ka1e27/dreams/Boat_PCB/report.txt

Info: Processing symbol 'A1:Module:RaspberryPi_Pico_Common_Unspecified'.
Info: Processing symbol 'J2:'.
Info: Processing symbol 'F1:'.
Info: Processing symbol 'J1:'.
Updated A1 symbol association from  to /41a332c8-d671-4dce-a781-75eb2ff0428e.
Updated A1 fields.
Updated A1 sheetname to '/'.
Updated A1 sheetfile to 'Boat_PCB.kicad_sch'.
Updated A1 footprint filters to 'RaspberryPi?Pico?Common* RaspberryPi?Pico?SMD*'.
Add net unconnected-(A1-GPIO22-Pad29).
Connected A1 pin 29 to unconnected-(A1-GPIO22-Pad29).
Add net unconnected-(A1-GPIO3-Pad5).
Connected A1 pin 5 to unconnected-(A1-GPIO3-Pad5).
Add net unconnected-(A1-GPIO19-Pad25).
Connected A1 pin 25 to unconnected-(A1-GPIO19-Pad25).
Add net unconnected-(A1-VBUS-Pad40).
Connected A1 pin 40 to unconnected-(A1-VBUS-Pad40).
Connected A1 pin 5 to unconnected-(A1-GPIO3-Pad5).
Add net unconnected-(A1-RUN-Pad30).
Connected A1 pin 30 to unconnected-(A1-RUN-Pad30).
Add net Net-(J2-Pin_11).
Connected A1 pin 8 to Net-(J2-Pin_11).
Connected A1 pin 3 to Net-(J2-Pin_11).
Connected A1 pin 13 to Net-(J2-Pin_11).
Connected A1 pin 18 to Net-(J2-Pin_11).
Add net unconnected-(A1-GPIO7-Pad10).
Connected A1 pin 10 to unconnected-(A1-GPIO7-Pad10).
Add net unconnected-(A1-GPIO27_ADC1-Pad32).
Connected A1 pin 32 to unconnected-(A1-GPIO27_ADC1-Pad32).
Add net unconnected-(A1-GPIO15-Pad20).
Connected A1 pin 20 to unconnected-(A1-GPIO15-Pad20).
Add net unconnected-(A1-GPIO5-Pad7).
Connected A1 pin 7 to unconnected-(A1-GPIO5-Pad7).
Add net unconnected-(A1-GPIO28_ADC2-Pad34).
Connected A1 pin 34 to unconnected-(A1-GPIO28_ADC2-Pad34).
Add net unconnected-(A1-GPIO13-Pad17).
Connected A1 pin 17 to unconnected-(A1-GPIO13-Pad17).
Add net unconnected-(A1-GPIO9-Pad12).
Connected A1 pin 12 to unconnected-(A1-GPIO9-Pad12).
Connected A1 pin 23 to Net-(J2-Pin_11).
Connected A1 pin 13 to Net-(J2-Pin_11).
Connected A1 pin 18 to Net-(J2-Pin_11).
Connected A1 pin 17 to unconnected-(A1-GPIO13-Pad17).
Add net unconnected-(A1-GPIO6-Pad9).
Connected A1 pin 9 to unconnected-(A1-GPIO6-Pad9).
Add net unconnected-(A1-3V3_EN-Pad37).
Connected A1 pin 37 to unconnected-(A1-3V3_EN-Pad37).
Connected A1 pin 9 to unconnected-(A1-GPIO6-Pad9).
Connected A1 pin 38 to Net-(J2-Pin_11).
Connected A1 pin 10 to unconnected-(A1-GPIO7-Pad10).
Add net unconnected-(A1-GPIO14-Pad19).
Connected A1 pin 19 to unconnected-(A1-GPIO14-Pad19).
Add net unconnected-(A1-GPIO2-Pad4).
Connected A1 pin 4 to unconnected-(A1-GPIO2-Pad4).
Add net unconnected-(A1-GPIO17-Pad22).
Connected A1 pin 22 to unconnected-(A1-GPIO17-Pad22).
Add net unconnected-(A1-3V3-Pad36).
Connected A1 pin 36 to unconnected-(A1-3V3-Pad36).
Add net unconnected-(A1-GPIO4-Pad6).
Connected A1 pin 6 to unconnected-(A1-GPIO4-Pad6).
Connected A1 pin 25 to unconnected-(A1-GPIO19-Pad25).
Add net unconnected-(A1-GPIO0-Pad1).
Connected A1 pin 1 to unconnected-(A1-GPIO0-Pad1).
Add net unconnected-(A1-GPIO8-Pad11).
Connected A1 pin 11 to unconnected-(A1-GPIO8-Pad11).
Add net Net-(A1-VSYS).
Connected A1 pin 39 to Net-(A1-VSYS).
Connected A1 pin 22 to unconnected-(A1-GPIO17-Pad22).
Connected A1 pin 3 to Net-(J2-Pin_11).
Add net unconnected-(A1-GPIO12-Pad16).
Connected A1 pin 16 to unconnected-(A1-GPIO12-Pad16).
Add net unconnected-(A1-AGND-Pad33).
Connected A1 pin 33 to unconnected-(A1-AGND-Pad33).
Add net unconnected-(A1-GPIO20-Pad26).
Connected A1 pin 26 to unconnected-(A1-GPIO20-Pad26).
Add net unconnected-(A1-GPIO21-Pad27).
Connected A1 pin 27 to unconnected-(A1-GPIO21-Pad27).
Add net unconnected-(A1-ADC_VREF-Pad35).
Connected A1 pin 35 to unconnected-(A1-ADC_VREF-Pad35).
Connected A1 pin 6 to unconnected-(A1-GPIO4-Pad6).
Add net unconnected-(A1-GPIO11-Pad15).
Connected A1 pin 15 to unconnected-(A1-GPIO11-Pad15).
Add net unconnected-(A1-GPIO1-Pad2).
Connected A1 pin 2 to unconnected-(A1-GPIO1-Pad2).
Add net unconnected-(A1-GPIO16-Pad21).
Connected A1 pin 21 to unconnected-(A1-GPIO16-Pad21).
Connected A1 pin 30 to unconnected-(A1-RUN-Pad30).
Connected A1 pin 33 to unconnected-(A1-AGND-Pad33).
Connected A1 pin 39 to Net-(A1-VSYS).
Connected A1 pin 4 to unconnected-(A1-GPIO2-Pad4).
Connected A1 pin 40 to unconnected-(A1-VBUS-Pad40).
Connected A1 pin 7 to unconnected-(A1-GPIO5-Pad7).
Connected A1 pin 12 to unconnected-(A1-GPIO9-Pad12).
Connected A1 pin 2 to unconnected-(A1-GPIO1-Pad2).
Add net unconnected-(A1-GPIO10-Pad14).
Connected A1 pin 14 to unconnected-(A1-GPIO10-Pad14).
Added A1 (footprint 'Module:RaspberryPi_Pico_Common_Unspecified').
Connected A1 pin 16 to unconnected-(A1-GPIO12-Pad16).
Connected A1 pin 29 to unconnected-(A1-GPIO22-Pad29).
Connected A1 pin 21 to unconnected-(A1-GPIO16-Pad21).
Connected A1 pin 15 to unconnected-(A1-GPIO11-Pad15).
Connected A1 pin 23 to Net-(J2-Pin_11).
Connected A1 pin 36 to unconnected-(A1-3V3-Pad36).
Connected A1 pin 11 to unconnected-(A1-GPIO8-Pad11).
Add net unconnected-(A1-GPIO18-Pad24).
Connected A1 pin 24 to unconnected-(A1-GPIO18-Pad24).
Connected A1 pin 20 to unconnected-(A1-GPIO15-Pad20).
Connected A1 pin 1 to unconnected-(A1-GPIO0-Pad1).
Connected A1 pin 38 to Net-(J2-Pin_11).
Connected A1 pin 27 to unconnected-(A1-GPIO21-Pad27).
Connected A1 pin 26 to unconnected-(A1-GPIO20-Pad26).
Connected A1 pin 34 to unconnected-(A1-GPIO28_ADC2-Pad34).
Connected A1 pin 24 to unconnected-(A1-GPIO18-Pad24).
Connected A1 pin 32 to unconnected-(A1-GPIO27_ADC1-Pad32).
Add net unconnected-(A1-GPIO26_ADC0-Pad31).
Connected A1 pin 31 to unconnected-(A1-GPIO26_ADC0-Pad31).
Connected A1 pin 8 to Net-(J2-Pin_11).
Connected A1 pin 28 to Net-(J2-Pin_11).
Connected A1 pin 35 to unconnected-(A1-ADC_VREF-Pad35).
Connected A1 pin 28 to Net-(J2-Pin_11).
Connected A1 pin 31 to unconnected-(A1-GPIO26_ADC0-Pad31).
Connected A1 pin 37 to unconnected-(A1-3V3_EN-Pad37).
Connected A1 pin 19 to unconnected-(A1-GPIO14-Pad19).
Updated A1 unit metadata.
Changed REF** reference designator to A1.
Changed A1 value from RaspberryPi_Pico_Common_Unspecified to RaspberryPi_Pico.
Connected A1 pin 14 to unconnected-(A1-GPIO10-Pad14).

Info: Total warnings: 0, errors: 0.
