ka1e27/dreams/docs/v3/v3_review_2026-08-05.md

# V3 schematic review — 2026-08-05

Full pass over `Boat_PCB_V3.kicad_sch` (49 components) against the V2 schematic (44 components),
`CLAUDE.md`'s as-built V2 facts, `V3_PCB_SESSION_CONTEXT.md` and `DREAMS_V3_parts_footprints.md`.

Method: V2's component list read straight out of `Boat_PCB.kicad_sch`; V3's connectivity read out of
the exported netlist, so every claim below is from the files rather than from memory.

Scope: **Boat Carrier PCB.** The Pod PCB is a separate board; `U12` (XIAO) sits on this sheet for
reference only.

---

## 1. V2 coverage — nothing lost

Every V2 function is accounted for. 44 → 49 components.

| V2 | V3 | Status |
|---|---|---|
| `A1` Pico | `U1` Teensy 4.1 | replaced by design |
| `A2` A4988 | `A1` | ✅ |
| `J1` 2×06 + Pololu step-down | `A2` D36V50F5 | ✅ |
| `J3` Pi 5 connector | `J12` | ✅ (column transposition fixed) |
| `J4` 12s Tap | `J11` | ✅ |
| `J5` IMU 1×10 | `U4` BNO085 on-board | ✅ |
| `J7` GPS + Compass | `J1` | ✅ |
| `J8` Winch ESC | `J10` | ✅ signal only — see §2.4 |
| `J11` Temp+Hum external | `J4` | ✅ |
| `J12` LED | `J6` | ✅ |
| `J13` Temp+Hum internal | `U8` SHT45 on-board | ✅ |
| `J15`/`J16` Hull leak | `J8`/`J9` | ✅ restored |
| `J18` Stepper motor | `J5` | ✅ |
| `J14`/`J17` 1×20 Pico sockets | Teensy footprint | ✅ |
| `J2` 1×03 unlabeled | `J7` SBUS | ✅ inferred |
| `R3`/`R7`/`R9` 1k ×3 | `R11`–`R14` 1k ×4 | ✅ |
| dividers | `R1`–`R8`, as-built values | ✅ |
| `C5`/`C7` electrolytic | `C1`/`C2` 470 µF | ✅ |
| `U1` MCP2515 + `Y1` crystal | dropped | ✅ Teensy has FlexCAN |
| `U2` TJA1051T-3 | `U3` | ✅ |
| `BT1`/`BT4` battery symbols | `J13`/`J14` XT60 | ✅ |

**Two V2 items deliberately not carried, worth a decision:**

- `J6` **"4s output"** (XT60) — a power *output*. Nothing in V3 feeds a downstream pack. If the VESCs
  or winch ESC were fed from the board, that path is gone.
- `J9` **"Winch ESC RC"** (pin header) — V2 had two winch connectors; V3 has one.

---

## 2. Gaps that matter — ranked

### 2.1 🔴 INA228 current sensing is non-functional as drawn

All three INA228s have **`Vin+`, `Vin-` and `Vbus` unconnected**, and there are **no shunt resistors
anywhere in the design**. An INA228 measures current as the differential voltage across an external
shunt; with no shunt and no connections it measures nothing.

Needed: **3 shunt resistors**, one per domain, sized to the domain's current — the drive pair is
~90 A per `CLAUDE.md`, so sub-milliohm with a real power rating; electronics and winch are far lower.
`Vbus` also needs to land on the rail being monitored.

**And all three share one I²C address.** `A0`/`A1` are unconnected on every one, so they must be
strapped to three distinct combinations or only one will ever answer.

### 2.2 🔴 No decoupling capacitors on any IC

The only capacitors on the board are `C1`–`C3` (bulk) and `C4`–`C7` (ADC filters). There is **no
100 nF decoupling** on `U2`, `U3`, `U4`, `U5`, `U7`, `U8`, `U9`–`U11`, `A1` or `A2`. Every one of those
datasheets asks for it.

Worst case in that list: **`U4` BNO085 pin 9 `CAP` is unconnected.** That is not decoupling — it is the
required external capacitor for the part's internal regulator. The BNO085 will not work without it.

### 2.3 🔴 BNO085 strap pins are floating — the exact V2 failure

`PS0/WAKE`, `PS1`, `SA0/H_MOSI` (address), `~H_CS`, `~RST` and `~H_INT` are all unconnected.

`CLAUDE.md` and the journal archive record V2 losing a long debugging arc to precisely this: reads
worked, the address ACKed, and every payload write was refused because the module's interface pins
were floating. PS1=0/PS0=0 selects I²C; ADDR to GND gives 0x4A. **Strap them deliberately.**

### 2.4 🟠 The winch has no power path

`J14` brings in the winch M18 pack and `J10` carries the ESC PWM signal — but nothing connects the
pack to the ESC. `CLAUDE.md` describes the V2 chain as
`1× M18 ─► WINCH ─[20A]─► MOSFET kill → winch ESC`. There is **no MOSFET, no gate drive and no power
output** for the winch ESC in V3.

### 2.5 🟠 Pod tether schottky diode is missing

`V3_PCB_SESSION_CONTEXT.md` is explicit: a schottky in series between the tether 5 V and the XIAO's
5V/VBUS pin, because that pin is shared with the module's USB/charge circuitry. The `D_SOD-123`
footprint is in the library but **no diode is placed**, and `U12`'s 5 V pin sits directly on `+5V` —
exactly the backfeed the diode exists to prevent.

### 2.6 🟠 A4988 is unusable as drawn

- `VMOT` unconnected, and the A4988 needs a **bulk electrolytic right at VMOT** (47–100 µF).
- `1A/1B/2A/2B` unconnected on both the driver *and* `J5` — `J5` is the only part on the sheet with
  **every pin unconnected**.
- `STEP`, `DIR`, `~ENABLE`, `~SLEEP`, `~RESET`, `MS1`–`MS3` unconnected. `~SLEEP` and `~RESET` are
  normally tied together.

### 2.7 🟡 Teensy power input needs confirming

`U1` has both a `VIN` and a `5V` pin in this symbol. `5V` is on the `+5V` net; **`VIN` is
unconnected.** Confirm which pad actually is the Teensy 4.1's supply input and that it is fed.

Related: powering a Teensy 4.1 from an external 5 V rail while USB may also be connected requires
**cutting the VUSB/VIN pad trace on the Teensy**. That is a physical mod, not a schematic item, but it
belongs in the build notes.

### 2.8 🟡 Sensor I²C is not wired to the mux

`U2`'s eight channel pairs (`SD0`–`SD7`, `SC0`–`SC7`) are all unconnected, as is every sensor's
SDA/SCL. This is the bulk of the remaining wiring.

⚠ **Each channel you use needs its own pull-up pair.** Only the upstream pair (`R9`/`R10`) exists — a
mux isolates the channels, so the upstream pull-ups do not serve them.

### 2.9 🟡 Sense chains have no ADC pin

`ELEC_ADC`, `WINCH_ADC`, `DRIVE_ADC`, `S12_ADC` each hold a 1 k and a 100 nF and stop there. Four
Teensy analog pins needed.

### 2.10 🟡 Drive domain has no input

`+VDRIVE` has one member (`R1.1`). Only elec and winch XT60s were requested. If the drive pack is
entirely off-board — plausible, since the VESCs are — then the drive divider on this board has nothing
to measure and should either get an input or be dropped.

---

## 3. Correctly omitted — no action

- **120 Ω CAN termination.** `DREAMS_V3_parts_footprints.md` lists it, but
  `V3_PCB_SESSION_CONTEXT.md` says termination stays at the two VESCs and the Teensy taps in as a short
  stub. The two docs disagree; the session context is right for a stub tap.
- **MCP2515 + crystal.** Teensy 4.1 has native FlexCAN.
- **ESC telemetry pins.** V2's test bench read ESC telemetry over serial; V3's VESCs report over CAN.
- **Pod sensors** (EC probe, NTC, photoresistor, bottom contact, pressure, leak) — Pod PCB.
- **Board fuses.** Per-pack overcurrent is the REDLINK BMS; `CLAUDE.md` records V2 fuses as off-board.

---

## 4. Verified good

- 49 components, every one with a footprint assigned.
- 17 named nets; **zero unnamed nets with more than one node**, so nothing is joined by accident.
- `GND` 58 pins, `+3V3` 23, `+5V` 10 (sourced from `A2` VOUT).
- Supply rails chosen per datasheet; SHT45 explicitly on 3V3 against its 3.6 V limit.
- `U3` corrected to `TJA1051T-3` so the logic side is 3.3 V — the Teensy is not 5 V tolerant.
- Pi header column transposition fixed, with a `PIN1` silkscreen marker.
- Mounting holes non-plated on both the Pi and Pololu footprints.
- Netlist and PDF export clean; 28 symbols and 25 footprints all load.

---

## 5. UPDATE — decoupling added and schematic fully wired

**85 components, 70 named nets, A0 sheet.** Five verification passes all clean.

### Added

- **15 × 100 nF decoupling**, one per supply pin (C8–C22), including **C13 on the BNO085 `CAP` pin**
  (§2.2 — the required internal-LDO capacitor).
- **Rail bulk**: C23 10 µF on +5V, C24 10 µF on +3V3, **C25 100 µF on VMOT** (§2.6).
- **17 × 4.7 k** — a pull-up pair on all eight mux channels (R15–R30) plus the INA228 alert (R31).
  §2.8: a mux isolates channels, so the upstream pair does not serve them.
- **D1 schottky** on the pod tether 5 V (§2.5), so the XIAO's shared USB/charge pin cannot be
  backfed.
- **5 × PWR_FLAG** on GND, +VELEC, +VWINCH, +VDRIVE and POD_5V — all fed from passive parts.

### Wired

`GND` 94 pins · `+3V3` 62 · `+5V` 12. CAN on FlexCAN1, all eight mux channels to their sensors,
GPS UART + compass, SBUS, hull leak ×2, winch PWM, status LED, stepper (STEP/DIR/EN/SLEEP + coils to
J5, half-step strapped MS1 high), pod tether as 2× UART + diode-protected 5 V, the four sense chains
landed on Teensy A0–A3, and **every BNO085 strap pin tied deliberately** (§2.3): PS0/PS1 → GND for
I²C, SA0 → GND for 0x4A, ~H_CS and ~BOOT → 3V3, CLKSEL0 → GND. The three INA228s get distinct
addresses (0x40/0x41/0x44) via A0/A1 straps and share channel 6.

### Three defects found by the verification passes

1. **252 × `endpoint_off_grid`.** Placement was off the 1.27 mm connection grid. Origins are now
   snapped; the count is **0**. Off-grid pins also make manual wiring in the GUI fight you.
2. **The Teensy's `5V` pad was tied to A2's regulator output.** On a Teensy 4.1 that pad is VUSB — an
   *output* when USB is attached, so this paralleled USB 5 V against the Pololu. The Teensy is now fed
   via `VIN` only. ⚠ **This still requires cutting the VUSB/VIN trace on the module.**
3. **The XenGi Teensy symbol had inconsistent pin types** — GND declared variously `power_in`,
   `output` and `input`; 3V3 as both `power_in` and `output`. Five corrected, so GND is a power input
   and the 3V3 pads are outputs that actually drive `+3V3`.

Also: the Pi's `3V3` pins (J12.1/J12.17) are its regulator **output** and are deliberately left
unconnected — `+3V3` is sourced from the Teensy, and paralleling two regulators back-drives one.

### Verification passes

| Pass | Check | Result |
|---|---|---|
| 1 | KiCad loads/exports netlist, PDF, 29 symbols, 26 footprints | clean |
| 2 | ERC: every violation in the expected set; zero off-grid | clean |
| 3 | 154 nets, 70 named, **0 accidental joins** | clean |
| 4 | 85 symbols: **0 overlaps, 0 off-sheet** | clean |
| 5 | All 85 have footprints; **0 unexplained floating supply pins** | clean |

### Remaining ERC violations — all expected

`pin_not_connected` 74 (spare Teensy IO, BNO085 `RESV_NC` ×9, XIN32/XOUT32, ENV_SCL/SDA, Pi GPIOs,
XIAO spare IO, A2 `EN`/`VRP`) · `pin_not_driven` 10 (the 6 shunt inputs, plus PROGRAM, ON_OFF, XIN32,
A2 EN which is internally pulled up) · `pin_to_pin` 8 (paralleled supply pins on one part — U1's three
3V3 outputs, A2's two VOUTs — and SnapEDA/XenGi symbols typing supply/strap pins `Bidirectional`) ·
`isolated_pin_label` 6 (the shunt nets) · `power_pin_not_driven` 1 (VBAT, no coin cell).

### Still open

- **The three shunt resistors are still not placed** (§2.1). Nets `SH_DRIVE_P/N`, `SH_ELEC_P/N`,
  `SH_WINCH_P/N` are named and land on the INA228 inputs, so dropping them in is a two-part edit — but
  the values need per-domain current figures and the drive shunt needs a real high-current footprint,
  not an axial.
- **Winch MOSFET kill path** (§2.4) and the **drive-domain input** (§2.10).
- `+VDRIVE` still has only R1.1 and U9's Vbus.

## 6. UPDATE 2 — software-selectable microstepping, 12S cap moved off-board

**84 components, 73 named nets.** Five passes re-run, all clean.

### Stepper MS1–MS3 now go to GPIO

Previously strapped (MS1 → 3V3, MS2/MS3 → GND) for fixed half-step. Now on Teensy pins so the
resolution is a firmware choice:

| Net | A4988 | Teensy |
|---|---|---|
| `STEP_MS1` | A1.10 | U1.17 — pin 25 |
| `STEP_MS2` | A1.11 | U1.18 — pin 26 |
| `STEP_MS3` | A1.12 | U1.19 — pin 27 |

A4988 truth table for the firmware:

| MS1 | MS2 | MS3 | Resolution |
|---|---|---|---|
| L | L | L | full step |
| H | L | L | half step |
| L | H | L | quarter |
| H | H | L | eighth |
| H | H | H | sixteenth |

The A4988 has internal pull-**downs** on MS1–MS3, so if firmware never drives them the driver comes up
in **full step**, not the half step V2 used. Set them explicitly at init.

### 12S tap capacitor removed

`C3` is gone — the cap is being fitted off-board on the wiring. `12S_RAW` is now just `J11.2 → R7.1`,
and the divider chain behind it is untouched: `S12_SENSE` = R7/R8/R14, `S12_ADC` = R14/C4/U1.

Note the capacitor numbering now skips **C3** (C1, C2, C4…C25). `CP_Radial_D12.5mm_P5.00mm` is left in
the footprint library but is no longer used by anything.

### Delta accounting — the net changes match exactly what was asked for

- `GND` 94 → **91**: C3.2 removed (−1), MS2/MS3 straps moved off GND (−2).
- `+3V3` 62 → **61**: MS1 strap moved off +3V3 (−1).
- named nets 70 → **73**: `STEP_MS1/2/3` added (+3).

Nothing else moved, which is the check that the edit did only what it was supposed to.

### Five passes, second run

| Pass | Result |
|---|---|
| 1 · KiCad loads/exports netlist, PDF, 29 symbols, 26 footprints | clean |
| 2 · ERC 96 violations, every one in the expected set, 0 off-grid | clean |
| 3 · 154 nets, 73 named, **0 accidental joins** | clean |
| 4 · 84 symbols, **0 overlaps, 0 off-sheet** | clean |
| 5 · all 84 have footprints, **0 unexplained floating supply pins** | clean |

## 7. UPDATE 3 — current sensing complete (2026-08-05)

Currents supplied: **each drive motor 100 A max / 45 A rated (two motors)**, electronics ~5 A,
winch ~20 A. **87 components, 71 named nets.** Five passes clean, and `isolated_pin_label` and
`named nets with 1 pin` are both now **zero** — the shunt nets are real connections.

### ⚠ The drive shunt cannot go on this board

The drive pack never reaches the carrier: only the elec and winch XT60s exist, and the VESCs are
off-board on CAN. Putting a 100 A shunt on this PCB would mean routing 100 A of pack current through
it for no reason.

So `U9` senses an **off-board** shunt through **`J15`**, a 4-pin JST-XH: `1 GND` (drive return / star
point) · `2 VDRIVE` · `3 SH+` · `4 SH-`. That connector also finally gives `+VDRIVE` a source, which
closes §2.10 — the drive divider R1/R2 now has something to measure.

### On-board shunts

Four-terminal Kelvin, `Device:R_Shunt` on `R_Shunt_Vishay_WSK2512_6332Metric_T1.19mm`. Pack current
passes through the shunt before it becomes the rail:

| Ref | Domain | Value | Chain | At max | % of FS | Power |
|---|---|---|---|---|---|---|
| R32 | electronics | **10 mΩ** | J13 → R32 → +VELEC | 50 mV @ 5 A | 30.5 % | 0.25 W |
| R33 | winch | **2 mΩ** | J14 → R33 → +VWINCH | 40 mV @ 20 A | 24.4 % | 0.80 W |
| — | drive (external) | **0.25 mΩ** suggested | off-board, sensed via J15 | 25 mV @ 100 A | 15.3 % | 2.50 W |

INA228 full scale is ±163.84 mV, so all three sit comfortably inside it. The 20-bit ADC means a low
shunt value costs almost nothing in resolution — at 0.25 mΩ the LSB is still ~1.25 mA — which is why
the drive shunt is sized for heat rather than sensitivity. Dropping the INA228 to its ±40.96 mV range
gains 4× resolution on all three if wanted.

⚠ **Pad roles on the WSK2512 are 1/4 current, 2/3 sense** — not 1/2 and 3/4. The current pads are
4.65 mm² and the sense pads 1.06 mm². The `R_Shunt` symbol agrees (pins 1/4 are 5.08 mm apart on the
through axis; 2/3 branch off). I had this backwards in the first draft of the symbol description and
corrected it.

⚠ **Kelvin routing is a layout obligation the netlist cannot express.** Pads 1 and 2 sit on the same
net, as do 3 and 4, so nothing stops the router taking the INA228 sense trace off the *current* pad.
At 2 mΩ a couple of milliohms of shared trace is a large error. Route sense to the sense pads.

### Sense-chain verification

| Net | Nodes |
|---|---|
| `SH_ELEC_P` | J13.1 · R32.1 · R32.2 · U10 Vin+ |
| `+VELEC` | R32.3 · R32.4 · U10 Vin- · U10 Vbus · A1 VMOT · A2 VIN ×2 · C1 · C25 · R3 |
| `SH_WINCH_P` | J14.1 · R33.1 · R33.2 · U11 Vin+ |
| `+VWINCH` | R33.3 · R33.4 · U11 Vin- · U11 Vbus · C2 · R5 |
| `SH_DRIVE_P` / `SH_DRIVE_N` | J15.3 / J15.4 + U9 Vin+ / Vin- |
| `+VDRIVE` | J15.2 · R1.1 · U9 Vbus |

Confirmed no shared nodes between each shunt's two sides, so no shunt is shorted out.

### Note on the drive measurement

The VESCs already report per-motor current over CAN. `U9` measures **total pack current**, which is the
number that matters against the ~90 A pack-pair limit `CLAUDE.md` records as the real constraint — the
two are complementary rather than redundant.

## 8. UPDATE 4 — winch kill path + ESC power output (2026-08-05)

**94 components, 76 named nets.** Five passes clean. This closes §2.4, the last structural gap.

### Topology — high-side P-FET, fail-safe OFF

```
+VWINCH ──┬────────[Q1 P-FET  S→D]──── WINCH_SW ──► J16 (XT60 to winch ESC)
          │              │ G
       [R34 10k]─────────┤
                         │
                    [R35 10k]
                         │
                    Q1 gate pulled toward GND by Q2 when killed
                    Q2: D=WINCH_GDRV, S=GND, G=WINCH_KILL
                    R36 10k gate pull-down · R37 1k from Teensy pin 29
```

**J16** is an XT60 power *output* to the winch ESC — the part V2 had as `J6 "4s output"` and V3 was
missing. High-side switching, so the ESC return is common ground.

### Why high-side, and why fail-safe falls out of it

Low-side N-channel would be easier to drive and far more efficient, but it puts the switch in the
return path — which breaks the isolated-domains-with-one-star-point arrangement and leaves the ESC
ground floating when off.

With the high-side P-FET, **R34 pulls the gate to source whenever Q2 isn't driven**, so:

- MCU in reset, high-Z, or unprogrammed → R36 holds Q2 off → R34 holds Q1 off → **winch dead**.
- There is no state where a hung MCU can energise the winch.

That is the whole point. The journal's 2026-07-31 entry records the drive ESCs holding their last PWM
through `SET_THR 0,0` *and* through `ESTOP` — a signal-path stop is not a stop. This is a power-path
cut that does not depend on the ESC behaving.

### Gate drive numbers (M18 winch pack, 21 V max)

| | |
|---|---|
| V<sub>GS</sub> with Q2 on | **−10.5 V** = −21 × R34/(R34+R35) — fully enhanced, inside the ±20 V limit |
| V<sub>GS</sub> with Q2 off | **0 V** → OFF |
| Divider current when on | 1.05 mA |
| Q1 dissipation at 20 A | **2.0 W** at 5 mΩ · **4.0 W** at 10 mΩ |

The R34/R35 divider is what keeps V<sub>GS</sub> in range, so **no Zener is needed**. Q1 needs
≥40 V V<sub>DS</sub> for a 21 V pack and Rds(on) chosen against the heatsink — TO-220 vertical, so a
tab heatsink is available.

### Verified topology

Every assertion checked against the netlist: Q1 source on the rail · drain feeds **only** the ESC
output (so the switch really is in series, not bypassing) · R34 pulls to **source not ground** · Q2
source grounded · R36 pulls Q2's gate to ground · the MCU reaches Q2 through R37 rather than directly ·
ESC return grounded.

### ⚠ The precedence question is still yours

Your README lists "leak detection with auto pod retraction". This kill cuts winch power, so it can
*prevent* that retraction. Nothing in hardware resolves that — the firmware must give retract logic
priority over the kill. Worth writing down before the winch is ever used in anger.

### Output capacitance — added

`C26` **470 µF 35 V** electrolytic and `C27` **100 nF** ceramic, both across `WINCH_SW` → GND, i.e.
downstream of Q1 on the ESC feed. `C2` sits upstream on `+VWINCH` and does nothing for the switched
side. `WINCH_SW` now carries Q1.2 · C26.1 · C27.1 · J16.1.

35 V on an 18 V nominal / 21 V max M18 pack is a comfortable ~1.7× margin. The electrolytic takes the
inductive kick from the ESC leads when Q1 opens under load; the ceramic handles what the electrolytic's
ESR and lead inductance cannot.

⚠ **Inrush is the trade.** Q1 now switches into 470 µF plus whatever the ESC's own input bank holds —
often several hundred µF more. The slow gate drive helps by accident: 10 kΩ into the P-FET's gate
charge gives a turn-on of tens of microseconds, so this is a soft start rather than a hard step. Still
worth checking the chosen FET's SOA against that surge, since it is the one place Q1 sees high current
and high V<sub>DS</sub> simultaneously. If it looks marginal, raise R35 to slow turn-on further.

## 9. UPDATE 5 — decisions closed (2026-08-05)

### 9.1 Leak auto-retract takes priority over the winch kill — DECIDED

The kill line (`WINCH_KILL`, Teensy pin 29) is software-controlled, so this is purely a firmware
precedence rule and needs no hardware change:

> **Leak detection must be able to override the winch kill.** On a pod-leak event the firmware
> asserts the kill only *after* retraction completes, never before. No code path may latch the kill
> in a way that blocks retract.

Two implementation notes for whoever writes the Teensy firmware:

- The kill is **fail-safe OFF**, so an MCU reset mid-retract drops the winch. Retract therefore has to
  be re-commanded on boot if a leak is still asserted, rather than assumed to have finished.
- This is the one place where "safest" is *not* "cut power". Killing the winch with the pod deployed
  and water coming in leaves the pod down. Document it next to the ESTOP semantics so the two
  failsafes are not confused.

### 9.2 Drive shunt part — Vishay WSBS8518, 250 µΩ

Specs below are from the WSBS8518…20 datasheet (Vishay doc 30341, rev 26-May-2026), text extracted
directly rather than recalled:

| | |
|---|---|
| Resistance | **250 µΩ** (ordering code `L2500` = 0.000250 Ω) |
| Power rating | **36 W** |
| Construction | Power Metal Strip, **two sense pins** — true 4-terminal Kelvin |
| Max current | √(P/R) = √(36 / 0.00025) ≈ **379 A** |
| TCR | ±110 ppm/°C at 250 µΩ |
| Tolerance | 5 % or 10 % |
| Thermal EMF | < 3 µV/°C |
| Operating range | −65 to +170 °C |
| Overload | 5× rated power for 5 s |

Against this design:

| Condition | Drop | Dissipation | % of 36 W |
|---|---|---|---|
| 90 A continuous (2 × 45 A rated) | 22.5 mV | 2.03 W | **5.6 %** |
| 100 A | 25.0 mV | 2.50 W | 6.9 % |
| 200 A (both motors at 100 A peak) | 50.0 mV | 10.0 W | 28 % |

So the thermal question is answered: at the real continuous operating point it runs at **under 6 % of
rating**, and even the theoretical 200 A both-motors-peak case is inside it — though the ~90 A pack
limit `CLAUDE.md` records means that case cannot actually occur.

⚠ **Tolerance is the accuracy limit, not the thermals.** 5 % on the shunt is 5 % on every current
reading. The INA228 has a `SHUNT_CAL` register — measure the installed shunt (or calibrate against a
known load) and program the real value rather than trusting the marking. The ±110 ppm/°C TCR is minor
next to that.

Vishay's own datasheet header points at the **WSBE** series as the superior-TCR upgrade if better
accuracy is wanted.

### 9.3 "Drive-domain input" was already closed — stale item in the commit message

This referred to §2.10: `+VDRIVE` having no source, so the R1/R2 divider had nothing to measure.
**`J15` pin 2 fixed it** when the drive-sense connector was added in Update 3, and `+VDRIVE` now
carries `J15.2 · R1.1 · U9 Vbus`. The commit message for `d79477a` repeated the item after it had
already been resolved — an error in the message, not in the schematic.

To be explicit about what is and is not on this board: **no drive pack power reaches the carrier at
all, by design.** The VESCs are off-board on CAN, the shunt is off-board, and `J15` brings in only the
rail voltage for sensing plus the Kelvin sense pair and the star-point return. That is intended, not a
gap.

## 10. UPDATE 6 — 🔴 drive divider was over-ranging the ADC (2026-08-05)

Asking where the drive ADC voltage comes in prompted a re-check of the divider maths, which turned up
a defect that would have destroyed a Teensy input.

### What was wrong

`R1/R2` were **56k/10k** — the as-built value `CLAUDE.md` records for V2. But V2's drive domain is
**2× M18 in parallel, 21 V max**, while V3's is **3× M18 in series, 63 V max** (the same 63 V figure
`V3_PCB_SESSION_CONTEXT.md` cites as the reason INA226 was rejected for INA228).

| | ratio | V at ADC | verdict |
|---|---|---|---|
| 56k/10k on a 21 V rail (V2) | 6.60 | 3.18 V | fits |
| 56k/10k on a **63 V** rail (V3, as drawn) | 6.60 | **9.55 V** | 🔴 **2.9× over a 3.3 V pin** |
| **220k/10k** (fixed) | 23.00 | **2.74 V** | ok, 17 % headroom |

`R1` is now **220k**, `R2` stays 10k. 220k was already in the BOM (R7), so no new value. Thévenin
9.6 kΩ, comfortable behind the 1 k + 100 nF filter. Over-range voltage is now 76 V, well above the
63 V rail.

This is precisely the V2→V3 assumption error `docs/v3/README.md` exists to warn about — a value copied
from the as-built board without re-checking the thing it depends on. It was introduced here, and the
fence document did not stop it.

### ⚠ Elec and winch dividers are tight — not changed, but specify 1 % parts

Both are 56k/10k on a 21 V rail → **3.18 V of a 3.3 V ceiling, 3.6 % headroom.** With 5 % resistors the
ratio can shift ~10 %, putting the worst case at **3.50 V — over the rail.**

Left at the as-built values because V2 has been running them, but **specify 1 % resistors on all four
dividers.** If you would rather have real margin, 68k/10k gives 2.69 V at 21 V (18 % headroom) for one
extra BOM value.

### Where the drive ADC voltage comes from

It already arrives on a JST-XH: **`J15` is `JST_XH_B4B-XH-A_1x04`**, and pin 2 (`VDRIVE`) feeds R1 →
R2 → R13 → `DRIVE_ADC` → Teensy A2. `+VDRIVE` carries `J15.2 · R1.1 · U9 Vbus`, so one connector
serves both the voltage divider and the INA228's bus-voltage input.

If the voltage tap and the shunt are at physically different points on the pack, that 4-pin can be
split into a 2-pin for GND+VDRIVE and a 3-pin for the Kelvin pair — say so and it is a small edit.

Five passes re-run after the change: all clean, 96 components.

## 11. UPDATE 7 — drive is 12S LiPo, not M18 (2026-08-05)

User: **the drive pack is 12S LiPo, two 6S packs in series.** That is 12 × 4.2 = **50.4 V max**,
44.4 V nominal.

### Corrections to the docs of record

| Doc | Says | Actually |
|---|---|---|
| `V3_PCB_SESSION_CONTEXT.md` | "the drive domain runs up to **63 V** max" | **50.4 V** — the 63 V figure assumes 3× M18 in series (15S) |
| `README.md` | "3× Milwaukee M18 (drive, series)" | drive is **LiPo**, not M18 |
| `CLAUDE.md` | bench drive is 2× M18 in parallel, 21 V | that is the V2 bench, not V3 |

The **INA228 choice still stands**: 50.4 V is well over INA226's 36 V common-mode limit, so the
"correctness fix, not a nice-to-have" reasoning holds even though the number was wrong. 50.4 V is also
comfortably inside the INA228's 85 V bus range.

Only **elec and winch are M18** on V3. The "three isolated M18 domains" framing no longer describes the
drive rail.

### Divider settled

`R1/R2` = **220k/13k** → 17.92× → **2.81 V at 50.4 V**, 15 % headroom, Thévenin 12.3 kΩ. That is
*identical* to the 12S divider R7/R8, because it is the same class of rail.

Sequence of values this landed on, for the record: 56k/10k (wrong — V2's 21 V value, 9.55 V at 63 V) →
220k/10k (safe for 63 V) → **220k/13k** (right for 50.4 V, and matches R7/R8).

### 🔴 Open question: are `+VDRIVE` and `12S_RAW` the same rail?

If the drive pack is 12S, then **`J11` "12S HV tap" and `J15` pin 2 "VDRIVE" may be measuring the same
voltage**, in which case the board carries two connectors, two dividers, two filter caps and two ADC
channels for one measurement:

| Chain | Connector | Divider | Filter | ADC |
|---|---|---|---|---|
| `+VDRIVE` → `DRIVE_SENSE` → `DRIVE_ADC` | J15.2 | R1/R2 220k/13k | R13 + C7 | Teensy A2 |
| `12S_RAW` → `S12_SENSE` → `S12_ADC` | J11.2 | R7/R8 220k/13k | R14 + C4 | Teensy A3 |

Not resolved here, because it depends on what the 12S tap is physically for. Two readings:

1. **Same rail** → drop one chain. That frees a connector, 2 resistors, a cap and an ADC pin.
2. **Different points** — e.g. J11 taps the pack terminals directly while J15 taps downstream of the
   shunt / a switch, so the two readings differ under load. Then both are wanted, and the pair actually
   lets you measure sag across the run.

Worth deciding before layout. Nothing is wrong as drawn either way — it is redundancy, not an error.

Five passes clean after the change: 96 components.

## 12. UPDATE 8 — drive shunt dropped, 12S is voltage-only (2026-08-05)

Decision: **no current sensing on the 12S drive rail.** Just the ADC voltage tap.

That removes the whole chain, because an INA228 with nothing across Vin+/Vin− measures nothing:

| Removed | Was |
|---|---|
| **U9** | INA228 "drive" |
| **C19** | U9's decoupling |
| **J15** | 4-pin drive shunt sense connector |
| **R1, R2** | 220k/13k drive divider |
| **R13** | 1k series into the drive ADC |
| **C7** | drive ADC filter cap |
| nets | `+VDRIVE`, `DRIVE_SENSE`, `DRIVE_ADC`, `SH_DRIVE_P`, `SH_DRIVE_N` |
| off-board | the 250 µΩ shunt and its 4-wire harness |

**7 components and a 4-wire harness gone**, and Teensy **A2 (pin 16)** is freed. 96 → **89 components**.

This also settles the J11/J15 redundancy raised in Update 7: with J15 gone, the 12S rail has exactly
one sense path, and it is the one that matches how the pack is actually described —

```
J11 "12S HV tap" ─► 12S_RAW ─[R7 220k]─► S12_SENSE ─[R14 1k]─► S12_ADC ─► Teensy A3
                                  │                                 │
                            [R8 13k]                            [C4 100nF]
                                  │                                 │
                                 GND                               GND
```

2.81 V at 50.4 V, 15 % headroom. Verified: `12S_RAW` = J11+R7, `S12_SENSE` = R7/R8/R14,
`S12_ADC` = R14/C4/U1, and zero stale `U9`/`J15`/`R1`/`R2`/`R13`/`C7`/`C19` strings anywhere.

**Drive current telemetry is not lost** — the VESCs report per-motor current over CAN, which is
arguably better than a pack total since it distinguishes the two motors. What goes away is the
independent board-level cross-check against the pack limit.

Remaining current sensing: `U10` electronics (0x41, 10 mΩ) and `U11` winch (0x44, 2 mΩ), both with
on-board Kelvin shunts, sharing mux channel 6 and the `INA_ALERT` line.

### Reference-designator gaps

Deliberately **not renumbered**: gaps now exist at C3, C7, C19, R1, R2, R13, U9, J15. Renumbering
would mean rewriting every reference in the wiring table, and a slip there is a silent mis-wire —
worse than a cosmetic gap. Gaps after deletion are normal. Happy to do a renumber pass as its own
change if you want the BOM contiguous.

### Note on the verification scripts

`final_verify.py` asserted hardcoded rail pin counts (`+3V3 >= 60`), which went stale the moment U9
and C19 were removed and reported a failure that was not one. Replaced with a structural check — each
rail must exist and still fan out across many parts — so the check stays valid across edits instead of
needing re-tuning. Third time a magic number in my own checks produced a false alarm this session.

Five passes clean: 89 components, 71 named nets, 0 accidental joins, 0 overlaps, 0 off-grid.

## 13. Suggested order

1. **Shunts + INA228 addressing** (§2.1) — the sensing subsystem does nothing without it.
2. **Decoupling, and the BNO085 `CAP` pin** (§2.2).
3. **BNO085 straps** (§2.3) — the known-expensive V2 mistake.
4. **Winch MOSFET path** (§2.4) and **pod schottky** (§2.5).
5. **A4988 + stepper wiring** (§2.6), including the VMOT bulk cap.
6. **Mux channel wiring + per-channel pull-ups** (§2.8), **ADC pins** (§2.9).
7. Decide on **drive-domain input** (§2.10) and the two dropped V2 connectors (§1).

## 14. UPDATE 9 — independent five-pass audit; four blockers found and fixed (2026-08-05)

Re-review driven off `kicad-cli sch erc --severity-all` and an exported netlist, with every strap and
power-on default checked against the actual datasheet rather than against this document. **89 → 99
components.** Four of the findings would each have stopped the board working; one was a safety
defect in the winch kill path.

### 14.1 🔴 BNO085 was strapped for a crystal that was never fitted

`CLKSEL0` → GND does **not** select the internal oscillator. Datasheet Figure 1-8:

| Source | CLKSEL0 | CLKSEL1 |
|---|---|---|
| Crystal | **0 or unconnected** | connected to crystal |
| External | 1 | 1 |
| Internal | **1** | 0 or unconnected |

So `CLKSEL0` = 0 selected **crystal** mode while `XIN32`/`XOUT32` were left floating — the 32 kHz
oscillator could never start and the IMU would not run. §5's "CLKSEL0 → GND" was the wrong strap for
a crystal-less design.

Resolved by fitting the crystal (the user's call over strapping `CLKSEL0` high), which makes the
existing GND strap correct. Per **Figure 1-7**, the reference circuit is the crystal across pins
26/27 **plus 22 pF from each pin to GND**:

- `Y1` 32.768 kHz, **CL = 12.5 pF**, 50 ppm — `Crystal_SMD_3215-2Pin_3.2x1.5mm` (Epson FC-135 /
  Abracon ABS07 land pattern, copied from KiCad's stock library rather than hand-authored)
- `C28`/`C29` **22 pF C0G** on `IMU_XIN`/`IMU_XOUT` to GND

The two 22 pF in series (11 pF) plus stray ≈ the 12.5 pF CL the crystal is specified for — which
reconciles the "22 pF" in older datasheet revisions with the "12.5 pF" in v1.17. They describe
different things; both numbers are needed.

⚠ Layout: `Y1` and its caps must sit hard against U4 pins 26/27 with a ground guard. This is a
high-impedance 32 kHz node and it is the one part of this schematic where placement is not optional.

### 14.2 🔴 The winch kill shared a UART with SBUS — and the shared pin defeats the fail-safe

`WINCH_KILL_MCU` was on Teensy **pin 29 = TX7**; SBUS is on **pin 28 = RX7**. Same `Serial7`.
`Serial7.begin()` claims both pins and **a UART TX idles high**, so initialising SBUS would drive
the kill line high → Q2 on → P-FET on → **the winch energises**. §8's whole "no state where a hung
MCU can energise the winch" argument fails at `Serial7.begin()`.

Moved to **pin 28 = D36**, which was unconnected and has no peripheral overlap.

Every other UART pairing in the design was already correct — D34/D35 (Serial8) for the pod tether,
D0/D1 (Serial1) for GPS. D29 was the single slip, and it landed on the one net where it mattered.

### 14.3 🔴 The pod schottky was fitted backwards

`D1` pin 1 (**K**) was on `+5V` and pin 2 (**A**) on `POD_5V` — the exact reverse of what the
symbol's own Description specifies ("Anode = carrier +5V, cathode = POD_5V"). As drawn it blocked
5 V reaching the pod and permitted the backfeed the diode exists to stop. Fixed by mirroring the
symbol, so the drawn cathode bar now points at `POD_5V` too.

### 14.4 🔴 The XIAO's 3V3 regulator output was tied to the carrier's +3V3

`U12.12` is the module's regulator **output**, so bonding it to `+3V3` back-drives it from the
Teensy's LDO — the same mistake §5 correctly avoided on the Pi's 3V3 pins. It is also physically
impossible: `J2` is a 4-wire tether (GND / 5V / TX / RX) with no 3V3 conductor. Removed, with a
`no_connect` in its place.

### 14.5 🟠 Seven pins had no defined state while the Teensy is high-Z

All undefined at power-on, in reset, and in the bootloader. Added **R38–R44, 10 k to +3V3**:

| Net | Why |
|---|---|
| `MUX_RST` | TCA9548A datasheet: *"The RESET input must be connected to VCC through a pull-up resistor."* |
| `IMU_RST` | BNO085 `NRST` has no internal pull |
| `STEP_EN` | Pololu confirm internal pulldowns on MS1–MS3 **only**; ENABLE has none, so the A4988's outputs came up undefined and the coils could energise before firmware ran. V2's own notes asked for this pull-up; it was not carried into V3 |
| `STEP_SLEEP` | same — no internal pull |
| `PWR_GOOD` | open-drain output with no pull-up; V2 had `R1` for this and V3 dropped it |
| `ENV_SCL`, `ENV_SDA` | BNO085 datasheet: *"This interface should be pulled up via resistors regardless of the presence of the external sensor as the SW polls for sensors at reset."* Not optional — the part polls this bus every reset |

### 14.6 Verification

`kicad-cli` netlist diffed node-by-node against the pre-edit export; **only the intended nets moved.**

| | before | after |
|---|---|---|
| components | 89 | 99 |
| named nets | 71 | 75 |
| `+3V3` nodes | 59 | 65 (−1 XIAO, +7 pull-ups) |
| ERC violations | 84 | 79 |
| ERC violation *classes* | 4 | same 4 — none new |

`pin_not_connected` 71 → 67 (XIN32, XOUT32, ENV_SCL, ENV_SDA, D36 now connected; D29 freed);
`pin_not_driven` 4 → 3. 0 accidental joins, 0 isolated labels, 0 off-grid, 0 overlaps, 0 duplicate
refdes, all 27 footprints and 32 symbols resolve. New refdes: `R38`–`R44`, `Y1`, `C28`, `C29`.

Note this schematic has **zero wires and zero junctions** — all 153 nets form from labels and power
symbols placed exactly on pin endpoints. Worth knowing before editing it by script.

### 14.7 Still open — not fixed, needs decisions

Ranked. None of these stop the board working, but the first three are the ones that would bite on
the water.

1. **+5V budget and protection.** One 5.5 A module feeds Pi 5 + pod tether + SBUS RX + WS2812 +
   Teensy + TJA1051 with only `C23` (10 µF electrolytic) and `C9` (100 nF), **no fuse, no
   soft-start**. Two USB cameras plus a SIM7600G-H (~2 A transmit bursts) can reach the limit. Add
   real bulk at the Pi header and budget it explicitly.
2. **The pod tether's 5 V is unfused and shares the Pi's rail.** A flooded pod — the failure the
   leak sensors exist to detect — shorts the rail that powers the Pi. Wants an eFuse or polyfuse.
3. **Pi USB-C backfeed.** The Pololu buck is not reverse-current tolerant and the Pi's header 5 V
   pins become outputs on USB-C. Same hazard V2 had. Pick one source or add ORing.
4. **`A2` pad map is self-flagged as uncertain** — the symbol says pads 11/12 (EN/PG) may be
   swapped. If they are, `PWR_GOOD` sits on **EN** and driving it low kills the board's own 5 V,
   Teensy included. Verify against the physical module; keep that pin input-only in firmware.
5. **Free reverse-polarity protection is unused.** Pololu: VRP *"provides access to the input
   voltage after reverse-voltage protection."* `+VELEC` taps raw VIN, so A4988 VMOT, C1, C25 and the
   divider are unprotected. Tap them from VRP (pins 9/10, currently unconnected) instead.
6. **No ESD/TVS on any of 10 external connectors** — worst are the hull-leak probes and the
   submerged tether, both straight to MCU pins.
7. **WS2812 driven at 3.3 V from a 5 V part.** V<sub>IH</sub> = 0.7 × V<sub>DD</sub> = 3.5 V, so
   out of spec. No series resistor, no local bulk at the LED.
8. **SBUS receiver powered at 5 V**, output level unspecified. The Teensy 4.1 is not 5 V tolerant.
9. **`J11`'s 2-pin JST-XH bonds the 12S pack negative to board GND.** If the VESCs' main negative
   opens, drive return tries to flow through that connector.
10. **BOM has no MPN, manufacturer or tolerance on any line** — including `Q1`, both shunts, and the
    dividers. §10's "specify 1 % on all four dividers" is still not captured anywhere, and elec/winch
    sit at 3.18 V of a 3.30 V ceiling.
11. **79 ERC errors with no NC flags.** A new real error will hide in that noise. Placing explicit
    no-connects on the genuinely-unused pins would make ERC a working check again.
12. Lower priority: `BOOTN` hard-tied where the datasheet asks for 10 k (blocks DFU); ADXL375 wants
    1 µF + 0.1 µF on Vs; 10 µF electrolytics are poor bulk for digital rails; the XIAO tether uses
    GPIO43/44 = ESP32-S3 UART0, so boot-log text lands on the Teensy; the 12S divider's 12.3 kΩ
    Thévenin is above the ADC's comfortable source impedance.

### 14.8 Firmware consequences of this pass

- **`WINCH_KILL` is now Teensy pin 28 (D36), not 29.** Nothing may configure `Serial7` TX.
- **`STEP_EN` and `STEP_SLEEP` now idle HIGH.** `~ENABLE` high = outputs disabled and `~SLEEP` high =
  awake, so the stepper comes up de-energised and the firmware must actively pull `STEP_EN` low to
  drive. That is the intended fail-safe, but it inverts the boot behaviour §6 assumed.
- **`PWR_GOOD` now reads a real logic high** instead of floating.

## 15. UPDATE 10 — pod off-board, 5 V rail protected (2026-08-05)

Two changes: the pod electronics leave this schematic, and the 5 V rail gets the branch protection
and bulk it was missing. **99 → 103 components.**

### 15.1 The pod is a separate board now

`U12` (XIAO ESP32-S3) is deleted along with its GND, its `no_connect` and its three labels. The pod
connects through **`J2` only** — the existing 4-pin JST-XH (GND / 5V / TX / RX). `TETHER_A` and
`TETHER_B` are now clean two-node nets, J2 ↔ Teensy Serial8.

This also retires §14.4 structurally: the XIAO's 3V3 regulator-output pad can't be mis-bonded to the
carrier's rail if the module isn't on the carrier.

**`D1` is kept**, but moved into series with the J2 feed rather than feeding a part that no longer
exists. Seeed's requirement is a series schottky somewhere in that 5 V line before the XIAO's
shared USB/charge pin — the carrier side satisfies it, and it additionally stops the pod
backfeeding the carrier's rail. Whoever builds the pod board therefore does **not** need a second
diode.

### 15.2 Every 5 V branch that leaves the board is now fused

The failure that mattered: the pod tether shares the rail that powers the Pi 5, so a flooded pod —
the exact event the leak sensors exist to detect — would brown out the whole boat. Fixed by
containment, one PTC per external branch:

```
                    ┌─[F1 0.75A]─── POD_5V_F ──[D1 ▷|]── POD_5V ──► J2  pod tether
+5V ────┬───────────┼─[F2 1.25A]─── LED_5V ─────────────────────► J6  status LED
        │           └─[F3 0.75A]─── SBUS_5V ────────────────────► J7  SBUS receiver
        ├── J12.2 / J12.4  Raspberry Pi 5
        ├── U1.48 Teensy VIN · U3.3 TJA1051 VCC
        └── C23 10µF · C9 100nF · C30 470µF · C31 100nF
```

Bel Fuse 0ZRE radial THT, matching the board's through-hole style. A short on any one harness now
trips its own fuse instead of collapsing the rail.

⚠ The pod sees roughly **4.5 V**, not 5 V — schottky V<sub>f</sub> ≈ 0.35 V plus the PTC's series
resistance, before any tether IR drop. Fine for the XIAO's onboard regulator, but size the tether
conductors with that budget in mind rather than assuming 5 V at the far end.

⚠ F3 is deliberately loose. An SBUS receiver draws well under 100 mA, so 0.75 A hold is ~8× margin —
chosen so the RC link, which is the manual override, can never nuisance-trip.

### 15.3 Bulk at the Pi

`C30` **470 µF 16 V low-ESR** + `C31` **100 nF**, both on +5V. The rail previously had only `C23`
(10 µF electrolytic) and `C9` (100 nF) for a load that includes a Pi 5.

⚠ **Layout obligation:** C30/C31 are drawn on the rail but must be placed physically at `J12`'s 5 V
pins. Bulk at the regulator does nothing for transients at the far end of the trace.

### 15.4 Still open on this rail — needs a decision, not an edit

- **USB-C backfeed is not fixed.** The Pololu buck is not reverse-current tolerant and the Pi's
  header 5 V pins become outputs whenever USB-C is attached. A series schottky is not viable here
  (≈0.45 V and >1 W at Pi currents, and the Pi 5 wants ≥4.75 V). The real fix is an ideal-diode /
  ORing controller. Until then this is a **build rule: power the Pi from the buck, or from USB-C,
  never both.** Same conclusion V2 reached.
- **Total budget still needs confirming against the 5.5 A module.** Pi 5 + two USB cameras +
  SIM7600G-H (~2 A transmit bursts) + Teensy + LED + pod can approach it. Fusing contains faults; it
  does not create headroom.
- **`A2` thermal**: ~3 W dissipation at 5 A out from 18 V in. Needs airflow or a heatsink in layout.

### 15.5 Verification

| | before | after |
|---|---|---|
| components | 99 | 103 |
| nets / named | 153 / 75 | 146 / 78 |
| ERC violations | 79 | 70 |
| ERC violation *classes* | 4 | same 4 — none new |

`pin_not_connected` 67 → 58 (the nine XIAO spare IO pins left with U12). 0 accidental joins,
0 isolated labels, 0 off-grid, 0 overlaps, 0 duplicate refdes; 29 footprints and 32 symbols all
resolve. New: `F1`–`F3`, `C30`, `C31`. New nets: `POD_5V_F`, `LED_5V`, `SBUS_5V`.

The `dreams_v3:XIAO_ESP32_S3` entry is still in the schematic's `lib_symbols` cache; it is orphaned
and KiCad prunes it on the next GUI save. The symbol stays in `dreams_v3.kicad_sym` for the pod
board.

## 16. UPDATE 11 — netlist imported to PCB, components placed (2026-08-05)

`Boat_PCB_V3.kicad_pcb` was an empty stub. It now carries the full design: **107 footprints
(103 components + 4 mounting holes), 146 nets, 190 x 163 mm, 2 layers.**

### 16.1 Pre-import connection audit — clean

103 components, all footprinted · **no dead-end named nets** · **no accidental `Net-()` joins** ·
every part with a `power_in` pin reaches GND. All 68 unconnected pins accounted for: 30 unused Pi
GPIO, 24 spare Teensy IO / VBAT / PROGRAM / ON_OFF / USB / Ethernet, 10 `RESV_NC`, A2's EN and two
VRP, and the BMP390 breakout's 3V0 output.

### 16.2 How it was imported

`kicad-cli` has no schematic-to-PCB update, and KiCad 10's SWIG bindings **do not expose
`NETLIST` or `BOARD_NETLIST_UPDATER`**, so pcbnew's F8 cannot be scripted directly. The board was
therefore built from the exported netlist: load each footprint, create each net, assign every pad.

Verified by cross-checking **every pad against the schematic netlist: 446 pads, zero mismatches**,
no part missing, no extra part. The only unnetted pads are 7 genuinely mechanical ones (A2's three
module holes, J12's four Pi mounting holes).

⚠ Because this bypassed the normal updater, **re-running "Update PCB from Schematic" in the GUI is
still the right move after any future schematic edit** — do not re-run the build script, it would
discard routing.

### 16.3 Three footprint-library defects found by doing this

1. 🔴 **`RaspberryPi_5_GPIO_Socket_2x20`: the `PIN1` marker was on a layer called `Rescue`**, which
   does not exist in a normal board. The board would not even load until it was fixed. Since
   `Rescue` appears on no fab output, the pin-1 marker §4 lists as a verified feature would have
   silently vanished from the silkscreen — on the one footprint whose column transposition already
   caused repeated wiring problems. Now on `F.SilkS`.
2. 🟠 **Same footprint: its pad field sits ~49 mm from the footprint origin**, and the 3D model was
   at the origin, so the socket body rendered 49 mm away from its own pads. Model offset corrected.
   ⚠ The anchor itself is still off-centre — in pcbnew the grab handle for J12 is nowhere near the
   part. Worth re-anchoring in the footprint editor.
3. 🔴 **U10/U11 had the wrong package.** They were assigned
   `HVSSOP-10-1EP_3x3mm_P0.5mm_EP1.83x1.89mm`, which has an exposed thermal pad. The INA228
   datasheet lists **pins 1-10 only** and gives the package as **"VSSOP (10) 3.00 mm x 3.00 mm"** —
   there is no thermal pad. The land pattern would have put a 1.83 x 1.89 mm copper pad and a paste
   aperture under a package that has only plastic there, risking the part sitting on a solder bump.
   Changed to `MSOP-10_3x3mm_P0.5mm` (JEDEC MO-187 variation BA, 10 pads), which is what DGS is.

### 16.4 Design-rule change

Default netclass clearance **0.2 mm -> 0.15 mm**. A 0.5 mm-pitch package has 0.15 mm between
adjacent pads by construction, so the IPC-correct MSOP land pattern cannot satisfy a 0.2 mm rule.
0.15 mm is still comfortably inside JLCPCB standard capability (0.127 mm). The alternative —
narrowing pads to suit the rule — would be the wrong way round.

### 16.5 Placement

Functional blocks, connectors on the board edges:

- **Top edge:** J13, J14 (pack XT60s), J16 (winch ESC out), J11 (12S tap)
- **Bottom edge:** J1-J10 signal harnesses, evenly spread
- **Between:** pack-in/current-sense · winch kill · 5 V buck + fusing · sense dividers · Teensy ·
  Pi socket · I2C mux + the 26 pull-ups · BNO085 + crystal · sensors · CAN · stepper

Each block is labelled on `Cmts.User`, and the **Pi 5's 85 x 56 mm body is outlined as a keep-clear**
so tall parts under it are visible rather than discovered at assembly. Each IC is packed adjacent to
its own decoupling.

⚠ **The decoupling-to-IC pairing is an assumption, not data.** The netlist has every 100 nF on
+3V3/GND, and the schematic draws C8-C22 as one bank row rather than beside their ICs, so nothing
records which cap serves which pin. There are exactly 12 generic +3V3 caps for 12 +3V3 supply pins,
so they were assigned in supply-pin order (the mapping is in the build script). Re-check it before
routing — this is the one placement decision that is guesswork.

190 x 163 mm is large, but per-component it matches V2 almost exactly (300 vs 312 mm2/part); V3
simply has 2.3x the parts. The 39 axial resistors and 28 THT caps dominate. Moving passives to
0805 would shrink it substantially, at the cost of the THT-for-reworkability decision.

### 16.6 DRC

| | after import | now |
|---|---|---|
| shorting_items / clearance | 4 / 4 | **0 / 0** |
| courtyards_overlap | 8 | **0** |
| hole_clearance / hole_to_hole | 10 / 6 | **0 / 0** |
| solder_mask_bridge | 14 | **0** |
| pth_inside_courtyard | 9 | **0** |
| silk / text (cosmetic) | 201 | 19 |
| unconnected_items | 299 | 300 |

The first pass collided the Teensy with the Pi socket because that footprint's anchor is not at its
pads; placement now corrects for anchor skew on all 51 off-centre footprints (every axial resistor
is anchored at pad 1, not centre).

The remaining 19 are cosmetic and all come from the footprint libraries: the BMP390 breakout prints
its own pin names over its pads, and two Teensy texts plus one BMP390 reference are under the
0.8 mm minimum height. **300 unconnected items is the complete unrouted ratsnest.**

### 16.7 Not done

**No routing and no ground pour.** KiCad ships no autorouter, and scripted routing of 146 nets would
be worse than useless. Placement is a sensible starting arrangement to refine interactively, not a
finished layout. Before routing, decide: 2-layer with a B.Cu ground pour as V2 used, or 4-layer with
a solid ground plane — with a 5 A switching buck, an A4988 chopper and a BNO085 on one board, the
4-layer case is strong.

## 17. UPDATE 12 — 4 layers + real floorplan (2026-08-05)

**162 x 123 mm** (was 190 x 163 — **36 % less board area**), 4 copper layers, DRC clean on placement.

### 17.1 Stackup

| | | |
|---|---|---|
| F.Cu | signal | components, short runs |
| In1.Cu | **GND** (plane) | solid ground pour, whole board, priority 0 |
| In2.Cu | **PWR** (plane) | left empty on purpose |
| B.Cu | signal | routing + one back-side part |

In2 is deliberately not poured: the board has four rails (+5V, +3V3, +VELEC, +VWINCH) and one plane
cannot carry four nets. Where the splits fall is a routing decision. ⚠ The GND zone is **added but
not filled** — run *Edit > Fill All Zones* in pcbnew.

⚠ Default clearance is 0.15 mm and min track 0.2 mm. Fine for 2-layer prices, but confirm the
4-layer tier at your fab; JLCPCB's 4-layer standard process wants ≥0.2 mm/0.2 mm on some tiers.

### 17.2 The correction that shaped this pass

**Flipping a through-hole part to the back frees height, not area.** Its holes still occupy the same
X/Y. The first attempt put the divider chain on the back *underneath* the front pull-up bank and
produced 101 shorting violations. Back-side placement is therefore used only where **height** is the
constraint, and front/back regions are given distinct X/Y.

That leaves exactly one part on the back: **C30**, the 470 µF Pi bulk cap, in the dead strip above
the header inside the Pi shadow. A 20 mm can cannot stand there on the front under a Pi; on the back
it has unlimited room and still sits ~10 mm from J12's 5 V pins.

The corollary: **board size is set by total THT pad area regardless of side.** 162 x 123 is near the
floor for 39 axial resistors and 28 THT caps. Moving passives to 0805 is the only large lever left,
and it trades against the THT-for-reworkability decision.

### 17.3 Floorplan

```
 +---------------------------------------------------------------+
 | J13   J14   J16   J11          <- XT60s + 12S tap, tight       |
 | R32   R33   Q1 Q2      U4 Y1   <- shunt+INA228 under each pack |
 | U10   U11   R34-37     C12-14  <- IMU: away from buck AND Pi   |
 | C1    C2    C26 C27            <- bulk AT each disturbance     |
 | C25                                                            |
 |                          U1    | J12 |  R9,R10,R15-R31,R38-R44 |
 | A2 buck  C23 C31         Teensy| Pi  |  (26 pull-ups, upright) |
 | F1 F2 F3 D1              rot90 | hdr |                         |
 | U6 BMP390  C17           || hdr|     |  R3-R14 + C4/C5/C6      |
 | U3 CAN  A1 stepper  C24        |     |  U5 U7 U8 + caps        |
 | J1 J2 J3 J4 J5 J6 J7 J8 J9 J10 <- harness bank, 1.6mm gaps     |
 +---------------------------------------------------------------+
        back side: C30 only, under the Pi above the header
```

- **Teensy rotated 90 deg**, running parallel to and immediately alongside the Pi header.
- **Pi shadow is used, not wasted.** 26 pull-ups + 9 divider resistors + the mux + the three SMD
  sensors sit under it on the front. The axials are **rotated upright** — lying flat they pack
  3 per row into a 49 mm-wide region, upright they pack 9 per row.
- **Bulk caps at the point of disturbance**, not on the rail generally: C1/C25 at J13, C2 at J14,
  C26/C27 at J16 (the switched ESC feed, where the inductive kick lands), C23/C31 at the buck
  output, C30 under J12's 5 V pins, C24 by the Teensy.
- **IMU deliberately outside the Pi shadow and away from the buck.** A Pi 5 is a hot, noisy
  neighbour and gyro bias drifts with temperature. Y1 and its 22 pF caps sit hard against U4.
- Connectors tightened: XT60s on a 19 mm pitch, the ten JSTs on 1.6 mm gaps along the bottom edge.

### 17.4 Verification

446 pads cross-checked against the schematic netlist, **zero mismatches**; 107 footprints; 146 nets.
DRC: **0 shorting, 0 clearance, 0 courtyard overlap, 0 hole clearance, 0 mask bridge.** Remaining
are 300 unconnected (the unrouted ratsnest) and 23 cosmetic silk/text items from the footprint
libraries.

### 17.5 Revision — 160 x 108 mm (173 cm2)

Second placement pass on builder feedback: Teensy USB pointing at the JST bank, too close to
the Pi, BMP390 to the underside, too much dead space.

| | |
|---|---|
| **Teensy rot 270** | USB now faces the **top edge** instead of the harness bank. Gap to the Pi shadow widened from ~1.5 mm to ~5.5 mm. |
| **BMP390 to the back** | U6 + C17 sit on the underside in the Pi shadow's bottom strip. |
| **Dead band removed** | JST bank pulled up, margins 5 -> 3.5, gaps 1.8 -> 1.3. |
| **Mounting holes** | no longer forced to the corners (they clashed with J13/J1) - now dropped into free pockets found by scanning the placement. |
| **Board** | 162 x 123 (199 cm2) -> **160 x 108 (173 cm2)**, utilisation 61 %. |

⚠ **U6 is a through-hole module (8 pads).** Moving it to the back frees the top *surface* and lets a
~10 mm module live under the Pi, but its holes still occupy the same X/Y on both sides — it does not
free routing area. Only SMD parts do that when flipped.

⚠ **C30 lost its spot at the Pi's 5 V pins.** The shadow cannot hold the 35 upright axials AND the
BMP390 AND a 470 µF can. The resistors are the biggest area win (~2900 mm2), so they kept the front;
U6 took the back strip; C30 moved to the buck output with C23/C31. That is a legitimate position for
5 V bulk, just not the ideal one for Pi transients — with a poured PWR plane on In2 it matters much
less. If you want C30 back at the header, the divider block has to leave the shadow.

Remaining dead space is mostly routing channel. The only large lever left is 0805 passives.

### 17.6 Board setup — stackup, netclasses, JLCPCB rules (2026-08-05)

THT resistors and discs kept as-is per the builder.

#### Stackup — JLC04161H-7628 (JLCPCB standard 4-layer, 1.6 mm)

| Layer | | Thickness |
|---|---|---|
| F.Cu | signal, **1 oz** | 0.035 |
| prepreg 7628 | | 0.2104 |
| In1.Cu | **GND plane**, 0.5 oz | 0.0152 |
| core | | 1.065 |
| In2.Cu | **PWR**, 0.5 oz | 0.0152 |
| prepreg 7628 | | 0.2104 |
| B.Cu | signal, **1 oz** | 0.035 |

Total 1.606 mm, ENIG. Note the L1→L2 prepreg is only 0.21 mm, so F.Cu sits tight against the
ground plane — which is why GND is In1 and not In2. ⚠ **Inner layers are 0.5 oz by default at
JLCPCB**, so the planes carry about half what an outer trace of the same width would.

#### Netclasses — widths from IPC-2221, not guessed

`A = (I / (k·ΔT^0.44))^(1/0.725)`, k = 0.048 external, W = A / (1.378 × oz).

| Class | Nets | I | Track | Via | ΔT at I |
|---|---|---|---|---|---|
| Default | logic, I2C, UART, GPIO | 0.1 A | 0.25 | 0.6/0.3 | ~0 °C |
| GND | GND | — | 1.0 | 0.8/0.4 | plane; width is for stubs only |
| 3V3 | +3V3 | 0.25 A | 0.6 | 0.6/0.3 | ~0 °C |
| 5V | +5V | 5.5 A | **2.5** | 0.8/0.4 | 15 °C |
| 5V_FUSED | POD_5V, POD_5V_F, LED_5V, SBUS_5V | 2.5 A trip | 1.0 | 0.8/0.4 | 11 °C |
| ELEC_PWR | +VELEC, SH_ELEC_P | 5 A | **2.0** | 0.8/0.4 | 17 °C |
| WINCH_PWR | +VWINCH, SH_WINCH_P, WINCH_SW | 20 A | 4.0 | 1.0/0.6 | **127 °C — pour it** |
| MOTOR | ST_1A/1B/2A/2B | 2 A | 1.0 | 0.8/0.4 | 7 °C |
| CAN | CANH, CANL | — | 0.3 | 0.6/0.3 | route as a tight pair |
| HV_12S | 12S_RAW, S12_SENSE | µA | 0.3 | 0.6/0.3 | clearance-driven, not current |

All 20 patterns verified against real net names on the board.

#### 🔴 The winch 20 A path cannot be a track

| | ΔT at 20 A |
|---|---|
| 4 mm track, 1 oz | 127 °C |
| 8 mm pour, 1 oz | 41 °C |
| **8 mm pour on F.Cu + B.Cu, via-stitched** | **13 °C** |
| 8 mm pour, 2 oz outer | 13 °C |

Pour `SH_WINCH_P` / `+VWINCH` / `WINCH_SW` on **both outer layers**, stitched with 1.0/0.6 vias
(~1 A each, so budget 20+). J14, Q1 and J16 are adjacent by design, so the run is short. The
alternative is ordering 2 oz outer copper. **Do not push the winch return through the 0.5 oz inner
plane** — take it J14 GND → J16 GND on the outer pours.

#### Clearances

Every netclass is **0.15 mm** because the 0.5 mm-pitch packages (INA228 MSOP-10, TCA9548A TSSOP-24,
BNO085 LGA-28) have 0.15 mm between their own pads by construction — a larger netclass clearance is
unsatisfiable *inside* those footprints and produced 4 false violations when tried.

The wider clearances the power nets actually want live in **`Boat_PCB_V3.kicad_dru`**, scoped to
tracks and zones so they never fight a package's pad pitch:

| Rule | Clearance |
|---|---|
| WINCH_PWR copper vs other | 0.4 mm |
| ELEC_PWR copper vs other | 0.3 mm |
| 5V copper vs other | 0.25 mm |
| HV_12S copper vs other | 0.6 mm (50.4 V, marine humidity margin) |
| WINCH_PWR minimum track width | 3.0 mm |

#### DRC rules vs JLCPCB capability

| Rule | Set to | JLCPCB 4-layer limit |
|---|---|---|
| min clearance | 0.127 | 0.09 |
| min track | 0.127 | 0.09 |
| min via diameter | 0.45 | 0.25 |
| min drill | 0.30 | 0.15 |
| min annular ring | 0.13 | 0.15 recommended / 0.13 abs |
| min hole-to-hole | 0.50 | 0.20 |
| min copper-to-edge | 0.30 | 0.20 |
| min silk text height | 1.00 | 1.00 |
| min silk line width | 0.15 | 0.15 |

Set to 5 mil rather than JLCPCB's 3.5 mil floor: nothing on this board needs finer, and staying at
5/5 keeps it in the cheap process tier.

Track menu: 0.25 / 0.3 / 0.6 / 1.0 / 1.5 / 2.0 / 2.5 / 4.0 mm. Vias: 0.6/0.3, 0.8/0.4, 1.0/0.6.

#### Two footprint fixes this surfaced

Raising min text height to JLCPCB's 1.0 mm exposed three sub-legible silkscreen items:
U6's **reference designator** was 0.787 mm (now 1.0 mm — you need to read that at assembly), and the
Teensy's decorative "MIMXRT1062" / "DVJ6A" chip markings were 0.7 mm (moved to F.Fab, so they stay
as documentation without printing illegibly).

DRC is now clean apart from the unrouted ratsnest and cosmetic silk overlap.

### 17.7 Passive review — applied (2026-08-05)

Four passes over the 76 passives/discretes only (sensors explicitly out of scope). Headline:
**the passive set was already lean — only three parts didn't earn their place.** The real
problems were one wrong value, four *missing* parts, and a fragmented BOM.

**Value defect — R3/R5 56k → 68k.** The elec and winch dividers were 56k/10k = 0.1515, giving
3.18 V at a 21 V pack against a 3.3 V ADC — 3.6 % headroom. At 5 % tolerance the worst case is
53.2k/10.5k → **3.46 V, over the rail**. Now 68k/10k → 2.69 V nominal, **2.74 V at 1 % worst
case, 17 % headroom**. Same part count, same BOM line count; costs 15 % of ADC range, which is
irrelevant for a value read to 0.05 V.

**Deleted (3):**

| | Why |
|---|---|
| C23 10 µF on +5V | The Pololu module has its own output ceramics and C30 gives 470 µF at the Pi. A 10 µF aluminium at ~2 Ω ESR adds nothing either already covers. |
| C27 100 nF on WINCH_SW | Parallel to C26's 470 µF feeding an ESC with its own several-hundred-µF bank. Noise against that. |
| R37 1k into Q2's gate | No DC function; R36's pull-down is the fail-safe. Teensy now drives Q2's gate directly. The one I'd least defend — it was cheap ESD insurance. |

**Added (4) — worth more than anything deleted.** Each was missing protection on a net that
leaves the board:

| | Net | Job |
|---|---|---|
| R45 330 Ω | `LED_DIN` ↔ `LED_DIN_EXT` | WS2812 data damping over a cable run |
| R46 1k | `LEAK_L` ↔ `LEAK_L_EXT` | hull-leak probe — bare wire in bilge water onto a GPIO |
| R47 1k | `LEAK_R` ↔ `LEAK_R_EXT` | same |
| R48 1k | `SBUS` ↔ `SBUS_EXT` | 5 V-logic receiver into a 3.3 V-only pin; limits ESD-clamp current to ~1.1 mA |

Convention: the Teensy keeps the original net name, the connector side gets `_EXT`, so the
exposed conductor is obvious in the netlist. **Series resistor, not a divider** — a divider
sized for a 5 V receiver would drop a 3.3 V receiver below the Teensy's V<sub>IH</sub>.

**Specification.** Every passive now carries its spec in Value: **100nF 50V X7R** (a generic
disc could be Y5V and lose 80 % of its capacitance over temperature and DC bias), **22pF 50V
C0G**, **1 %** on every resistor. Twenty parts gained a `Description` so the intent stripped
out of Value isn't lost.

**BOM de-fragmentation.** Descriptions in the Value field were splitting identical parts across
order lines — 10 k appeared as four separate lines (`10k`, `10k gate pull-up`, `10k gate drive`,
`10k Q2 pull-down`), 470 µF 35 V as three. **28 BOM lines → 20** with no circuit change.

Net effect: 103 → **104 components**, 76 → 77 passives, **28 → 20 BOM lines**.

**Verification.** ERC clean (same four expected classes). Board synced without disturbing
placement or routing — all 59 track/via items preserved, **448 pads cross-checked, zero net
mismatches**, no new DRC violations.

⚠ R47 and R48 landed 52 mm and 38 mm from J9/J7 — the free-space search had nowhere closer.
They limit fault current from anywhere in series, but for ESD they want to sit at the
connector. Drag them when convenient.

⚠ Not adopted from the review: F2/F3 (the LED and SBUS PTCs) were left in place, and the
BNO085 crystal was kept rather than switching to the internal oscillator.

### 17.8 Still not routed

Placement only. Before routing: fill the GND zone, decide the In2 rail splits, and check the height
budget under the Pi — the socket sets the Pi ~8-11 mm above the carrier, which the axials (~2.5 mm)
and ceramic discs (~5 mm) clear comfortably, but confirm against your standoffs.

---

## 18. UPDATE 13 — first review of the *layout*; power copper fixed (2026-08-30)

§17.8 above ends at "still not routed." The board is now routed — **998 tracks, 213 vias, 11 zones,
108 footprints on 132 x 108.4 mm** — which happened between 2026-08-06 and 08-09 and was never
logged. This is the first pass over the layout itself.

**Method.** `kicad-cli pcb drc` for ground truth, plus `pcbnew` imported into the Python that ships
in KiCad's `bin/` for everything DRC cannot see. The important one: **netclass track widths are
defaults for newly drawn tracks, not DRC constraints.** Only `winch track width floor` in the
`.kicad_dru` actually enforces a width, so `+5V`, `+VELEC` and `+3V3` could be routed at any width
and nothing would complain. Power nets were therefore judged by tracing the **widest path from
source to each real load**, not by eyeballing widths.

Currents used: winch **20 A** (20 A blade / 14 AWG, `docs/battery_architecture.md`; agrees with the
§17.6 netclass table), `+5V` **5.5 A** (the Pololu module's ceiling), and the PTC **hold** currents
from §15.2 — F1 0.75 A, F2 1.25 A, F3 0.75 A. Note those are *hold*, not trip; the 0.6 mm
`POD_5V` / `LED_5V` / `SBUS_5V` branches are comfortable either way. `+VELEC` was also checked and
is fine — the path from the shunt to the buck, the stepper and the bulk caps is a genuine 2.0 mm,
and its 0.3 mm segments are only the R3 divider and INA228 sense taps.

### 18.1 What the routing pass did not carry over from §17.6

§17.6 said the 20 A path "cannot be a track" and specified 8 mm pours on **both outer layers**,
via-stitched, with the winch return kept off the 0.5 oz inner plane. The routing did the opposite:

| | as routed | why it mattered |
|---|---|---|
| `SH_WINCH_P` | **no pour at all** — 2.5 mm F.Cu track | IPC-2221 ≈ **276 °C rise** at 20 A |
| `+VWINCH` | 234 mm² F.Cu pour only | no bottom-side path |
| `WINCH_SW` | **no tracks** — poured only on In2, 0.5 oz | the exact layer §17.6 fenced off |
| stitching | **1** via of 1.0/0.6 on the whole board | §17.6 budgeted 20+ |

The parallel 2.5 mm B.Cu run on `SH_WINCH_P` was joined to the F.Cu run by that single 0.6 mm-drill
via (~1–3 A), so it contributed essentially nothing.

### 18.2 🔴 Every zone thermal-relieved its pads, including the 20 A ones — fixed

All seven zones sat at KiCad's defaults: `THERMAL`, 0.5 mm spokes, 0.5 mm gap. Verified by geometry
that `Q1.2`, `Q1.3` and `J16.1` were **not** solidly in their pours — 20 A crossing 4 × 0.5 mm of
spoke, and for `Q1.2`/`J16.1` on 0.5 oz copper. The widest-path trace confirmed the thermal relief,
not the copper, was the binding constraint on `+VWINCH`, `WINCH_SW` **and** `+5V` (the Pi's 5 V pins).

Fixed: 19 winch pads (J14, J16, Q1, R33, C2, C26, including their GND returns) set to **solid**;
all zone spokes 0.5 → **1.0 mm**; `J12.25`/`J12.30` set solid, which cleared both `starved_thermal`
errors (one had a single spoke into an isolated island).

⚠ Only the genuinely high-current pads were made solid. The other ~100 THT pads keep thermal
relief — this board is hand-soldered and a solid bond to an 11,575 mm² plane is not solderable.

### 18.3 🔴 Winch pours — fixed

| net | before | after |
|---|---|---|
| `SH_WINCH_P` | none | **137.6 mm² F.Cu + 139.1 mm² B.Cu** |
| `+VWINCH` | 234.0 mm² F.Cu | **255.2 mm² F.Cu + 226.2 mm² B.Cu** |
| `WINCH_SW` | 682.1 mm² In2 | 709.8 mm² In2 + **47.5 mm² F.Cu** |
| stitching vias | 1 | **79** (30 + 47 + 2) |

`WINCH_SW` deliberately got **no B.Cu pour** — B.Cu in that band is the 20 A winch GND return
(J14.2 → J16.2), and taking it would have left a 3.5 mm bridge at ~159 °C.

### 18.4 🔴 Three connectivity defects — fixed

- **`J1.4` (+3V3)** — the GPS connector's supply pin had no copper to the plane. It sits inside the
  zone outline but its 2.5 mm-pitch neighbours left the fill nowhere to attach.
- **`U2.12` (GND)** — a TCA9548A ground pin floating relative to its other three.
- **🔴 The `+3V3` In2 plane was fragmented into three islands**, and the bottom-left island — the one
  feeding **J1 (GPS) and J4 (SHT45)** — was orphaned from the main plane. Cause: the `+5V` run
  routed *on the In2 plane* from (49.8, 107.5) diagonally down to (23.0, 85.0) slices the corner off.
  This is what chasing `J1.4` actually uncovered, and it is worse than the pin it started from.

All three fixed with short escape tracks + vias; the plane split bridged with 0.6 mm on B.Cu and
2 vias. **Unconnected items: 2 → 0.**

### 18.5 Cleanup

Removed the two inert stub vias (`+3V3` @ 61.5,15.65 and `+5V` @ 23.0,85.0 — the latter was the dead
end of that In2 `+5V` run). Added `D.R.E.A.M.S Boat_PCB V3` / `rev A 2026-08-30` to F.SilkS; the
board previously carried **no name, revision or date at all**. Placed at (35.5, 66.5) after a search
for space clear of both silk and pads. Scope note appended to `Boat_PCB_V3.kicad_dru` (see 18.7.7).

### 18.6 Attempted and reverted

- **Handing the Q1→J16 F.Cu corridor to `WINCH_SW`.** Trimming `+VWINCH`'s F.Cu arm back to x=43
  tripled the `WINCH_SW` pour (47.5 → 100.8 mm²) and took its vias 2 → 11 — but orphaned the B.Cu
  island feeding `Q1.3`, so Q1's source lost its supply. DRC caught it as a zone-to-zone break.
  Reverted.
- **Moving the eight signal chains off the In1 GND plane.** Grouped them into chains, verified their
  terminals sit on vias/PTH pads, and tested each whole chain against F.Cu and B.Cu with clearance.
  **All eight failed** — the outer layers are too dense. Board left unchanged.

### 18.7 Still open — needs a human

1. **🟠 `WINCH_SW` outer copper is a placement problem, not a pour problem.** Q1 is a TO-220 with pin
   order G-D-S, so `+VWINCH` arrives from the left and must cross the Q1→J16 corridor to reach the
   source on the right; B.Cu is unavailable because it is the winch GND return. **Rotate Q1 180°**
   (S-D-G, source facing the incoming pour) or move J16 right of `Q1.3`. As it stands `WINCH_SW`
   leans on the In2 plane — survivable through the PTH barrels, but not what §17.6 asked for.
2. **🟠 Eight signal nets still slot the In1 GND plane**, 234.8 mm total: `CH7_SCL` (109.5 mm),
   `STEP_MS3`, `CH5_SCL`, `STEP_DIR`, `GPS_TX`, `STEP`, `CH4_SDA`, `CH3_SCL`. In1 was made the
   ground plane precisely because F.Cu sits 0.21 mm above it. Needs interactive rerouting.
3. **🟠 The CAN pair is not a pair.** CANH 140 mm B.Cu + 32 mm F.Cu; CANL 90 mm F.Cu + 19.5 mm B.Cu
   + **27.6 mm on the In2 power plane**. Different layers for most of the run, 35 mm mismatch.
4. **🟠 Decoupling is placed too far to work.** Distance to the nearest same-net IC pin: C11→U3 6.3,
   C16→U7 8.4, C12→U4 8.4, C17→U1 8.8, C9→U3 8.8, C14→U6 9.5, C18→U8 9.6, C24→A1 10.6, C8 15.6,
   C31→A2 20.6 mm. Only C10/C20/C21/C22/C15 (2.8–5.2 mm) are useful. §5 added these caps to fix
   "no decoupling on any IC"; the placement gives most of it back.
5. **🟠 ADC anti-alias caps are at the wrong end.** C4/C5/C6 sit with their 1 k series resistors at
   the top edge, **44–53 mm** from the Teensy ADC pins. Noise coupled onto that run is unfiltered
   and the sampler has no local reservoir.
6. **🟠 §15.3's layout obligation was not met** — C30/C31 are 52 mm and 80 mm from `J12`'s 5 V pins.
   ⚠ C30 **cannot** simply be dragged there: it is a D10 radial (10.8 × 14.2 mm footprint, ~12–16 mm
   tall) and the Pi sits 8–11 mm above on its socket. This needs a part decision — a low-profile or
   SMD bulk cap — not a nudge.
7. **🟡 21 of the 29 `track_width` errors are false.** `WINCH_PWR` carries the 20 A path, the INA228
   Kelvin taps at R33 and the R5 divider tap as one node, and the rule cannot tell them apart. The
   permanent fix is in the **schematic**: give the taps their own nets (`WINCH_SH_SENSE_P/N`,
   `WINCH_DIV_TAP`) tied at the shunt's sense pads, so the rule can stay strict and stay actionable.
8. **🟡 BNO085 crystal loop** — C28/C29 are 6.4 and 7.9 mm from U4's XIN/XOUT.
9. **🟡 78 silkscreen violations** (60 overlap, 18 over copper); 23 are C1-vs-C25 alone, 13 on U6.

### 18.8 Verification

| | before | after |
|---|---|---|
| unconnected items | 2 | **0** |
| `starved_thermal` | 2 | **0** |
| `via_dangling` | 2 | **0** |
| `track_width` | 29 | 29 *(≈21 are sense taps, see 18.7.7)* |
| silk overlap / over copper | 60 / 18 | 60 / 18 |
| **total** | **113** | **107** |

No clearance, courtyard, annular-ring, hole-to-hole or edge-clearance violations at any point.
Schematic↔PCB parity clean throughout; **no schematic change was made**, so ERC is unchanged (70
violations, all in the four classes §14.6 accepted as expected).

⚠ An earlier stitching attempt placed vias inside the XT60 / TO-220 / cap through-holes — copper
clearance passed, `hole_to_hole` did not. If you script via placement, check drilled-hole spacing
separately; it is not implied by copper clearance.

Pre-fix board preserved as `Boat_PCB/Boat_PCB_V3/Boat_PCB_V3.kicad_pcb.prefix_20260830_205829`.
