ka1e27/dreams/mechanical/props/toroidal_3loop_p75_RH_shaft/toroidal_3loop_p75_RH_shaft_three.png

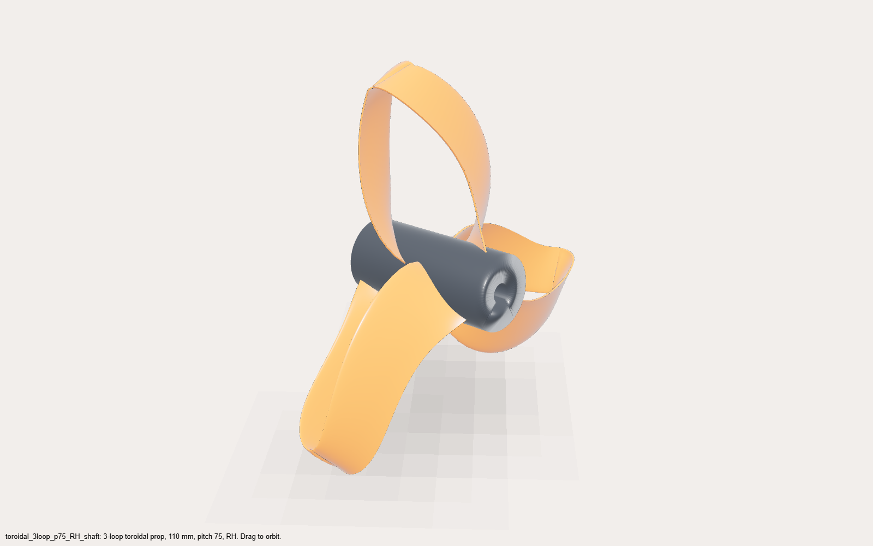
mechanical/props/toroidal_3loop_p75_RH_shaft/toroidal_3loop_p75_RH_shaft_three.png
