ka1e27/dreams/mechanical/render/DREAMS_V2_hero.png

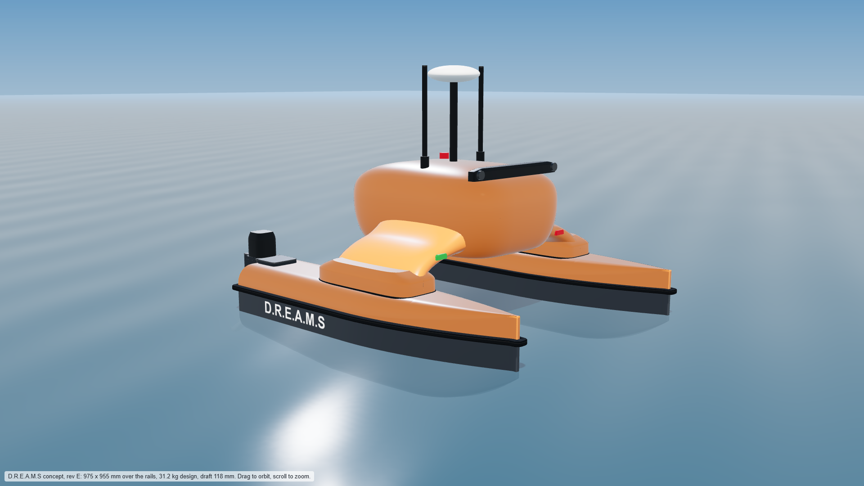
mechanical/render/DREAMS_V2_hero.png
