ka1e27/dreams/mechanical/render/DREAMS_V2_side.png

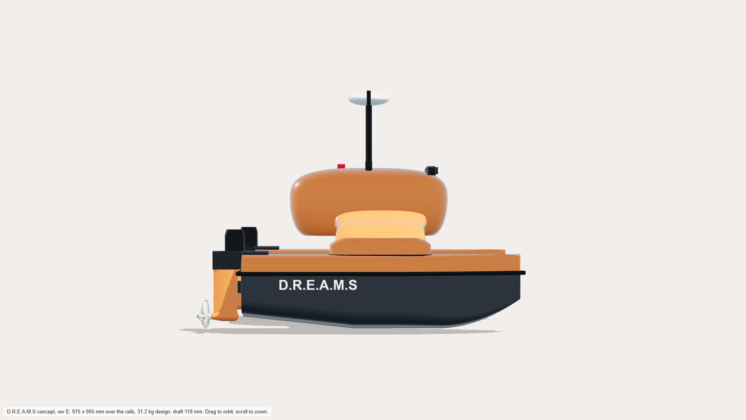
mechanical/render/DREAMS_V2_side.png
