ka1e27/dreams/mechanical/render/DREAMS_V2_top.png

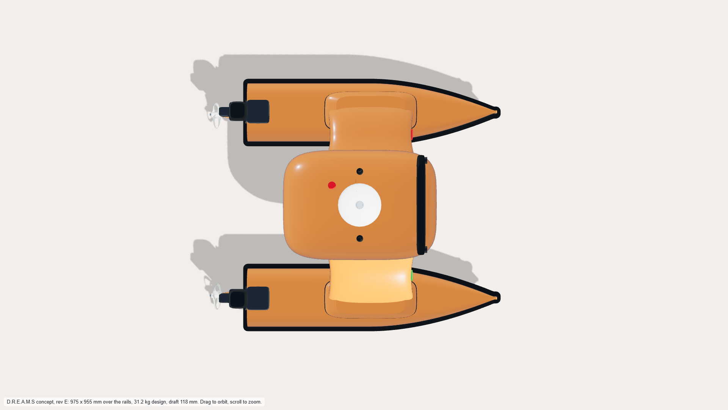
mechanical/render/DREAMS_V2_top.png
