ka1e27/dreams/website/img/arm-gearbox-700.webp

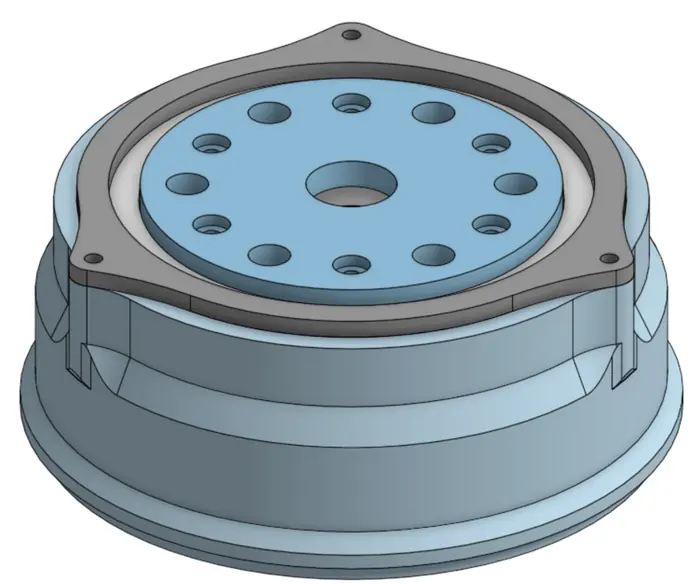
website/img/arm-gearbox-700.webp
