ka1e27/dreams/website/img/caleb-kong-320.jpg

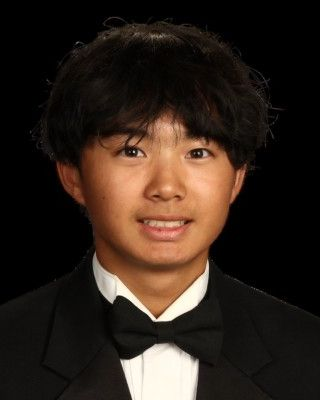
website/img/caleb-kong-320.jpg
