ka1e27/dreams/website/img/docks-portrait-800.webp

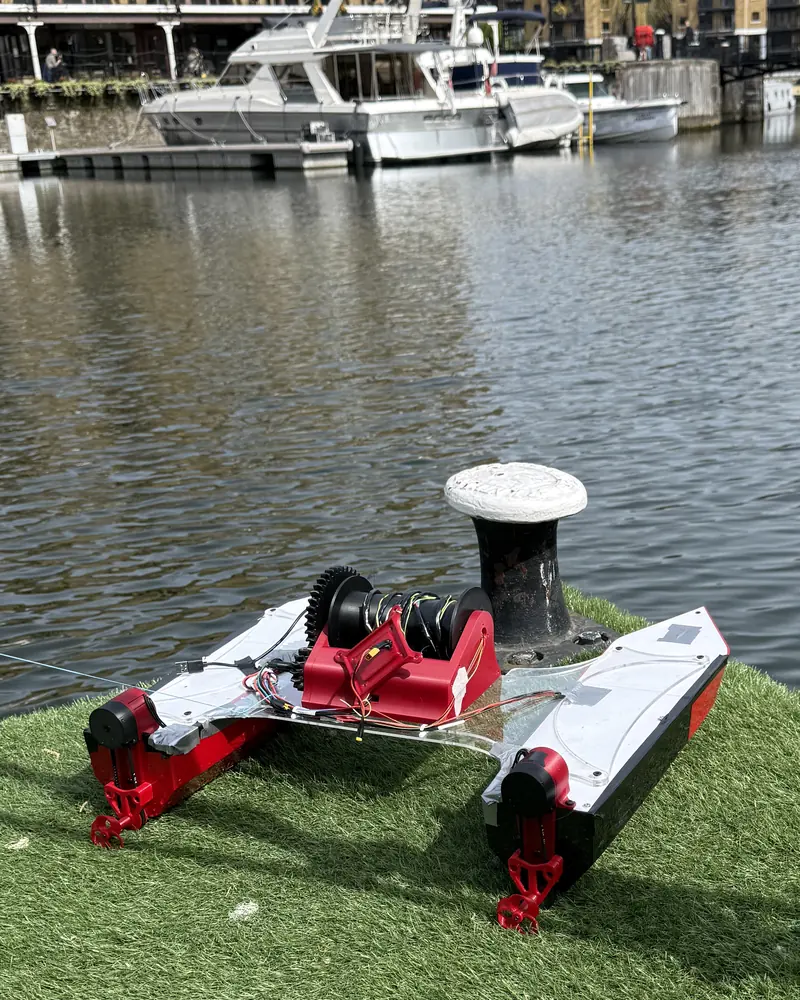
website/img/docks-portrait-800.webp
