ka1e27/dreams/website/img/hero-blob-800.webp

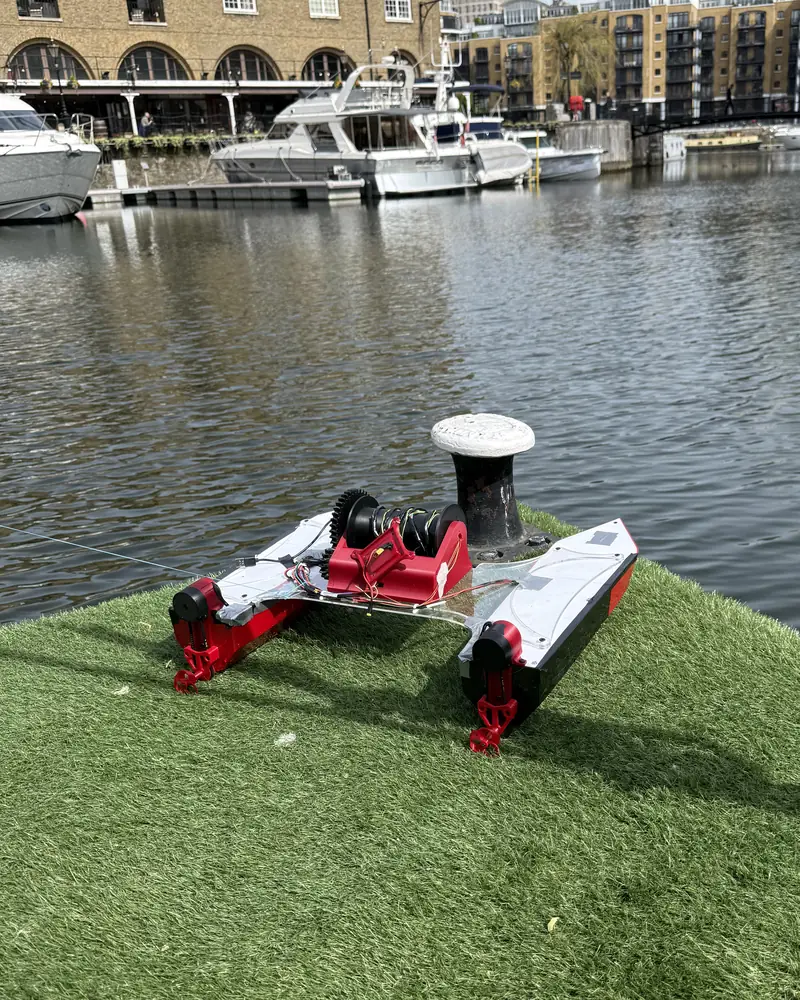
website/img/hero-blob-800.webp
