ka1e27/dreams/website/img/hero-docks-1000.jpg

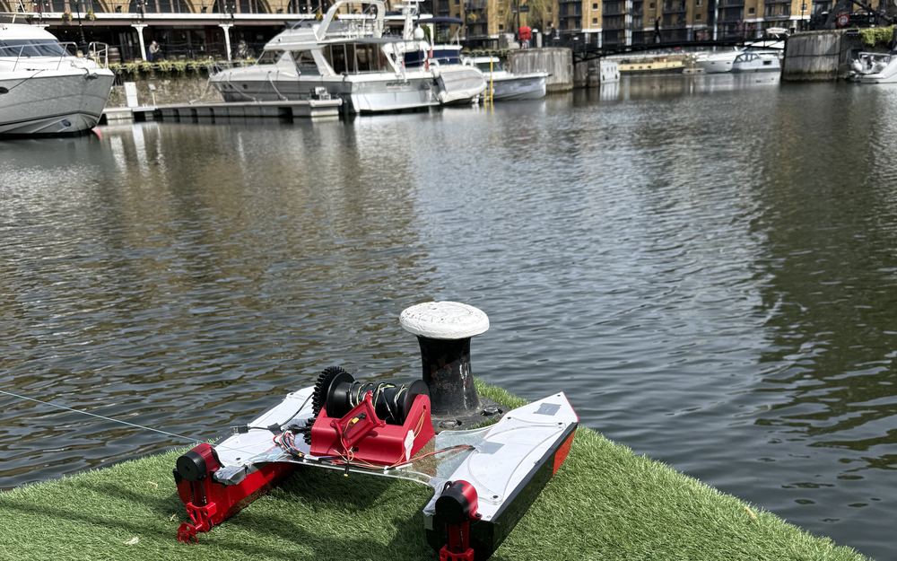
website/img/hero-docks-1000.jpg
