ka1e27/dreams/website/img/husky-boat-900.webp

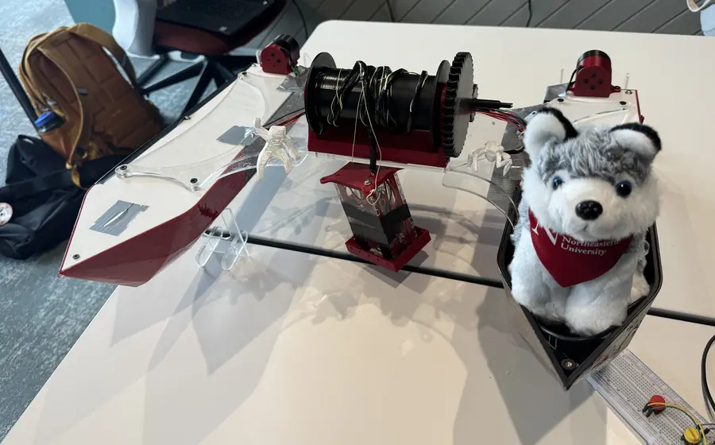
website/img/husky-boat-900.webp
