ka1e27/dreams/website/img/kyle-tran-600.jpg

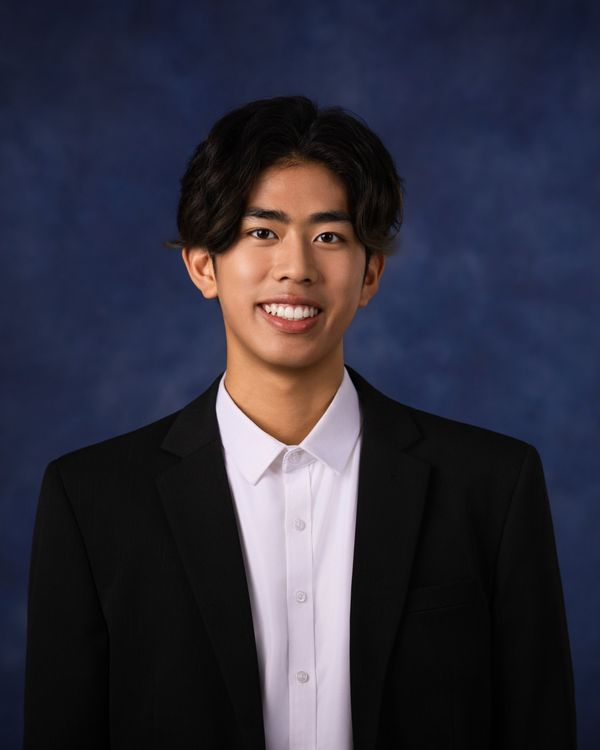
website/img/kyle-tran-600.jpg
