ka1e27/dreams/website/img/log-arm-480.jpg

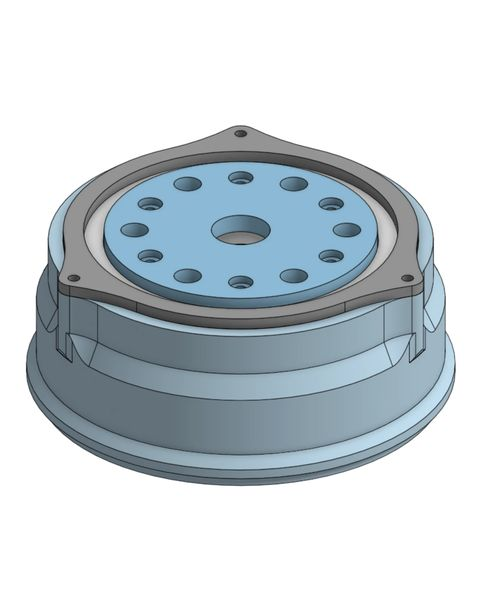
website/img/log-arm-480.jpg
