ka1e27/dreams/website/img/log-cad-bridge-720.jpg

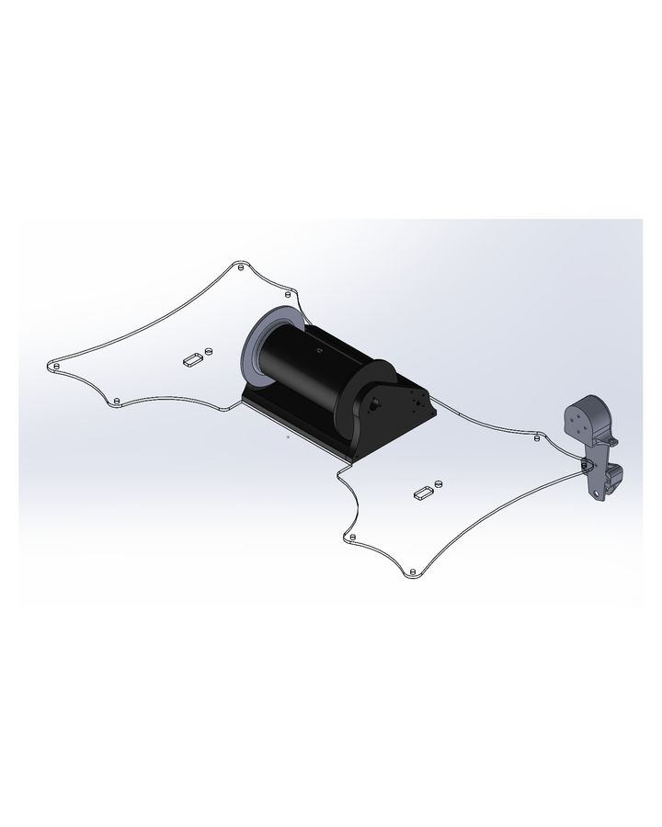
website/img/log-cad-bridge-720.jpg
