ka1e27/dreams/website/img/log-cad-pod-480.jpg

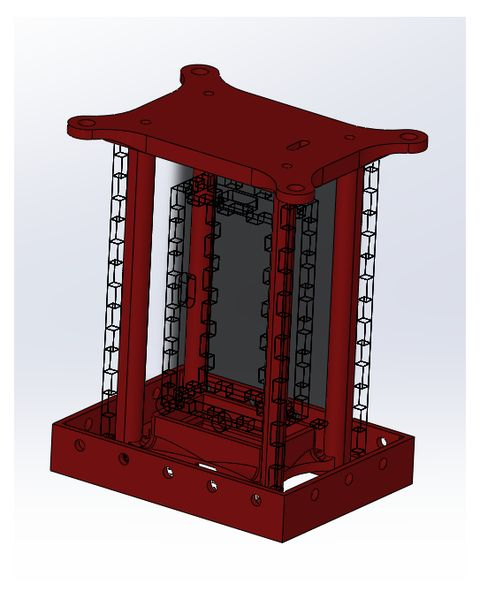
website/img/log-cad-pod-480.jpg
