ka1e27/dreams/website/img/log-dashboard-480.jpg

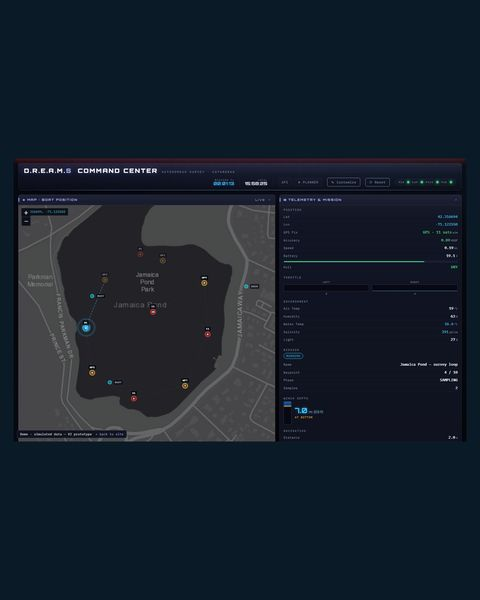
website/img/log-dashboard-480.jpg
