ka1e27/dreams/website/img/log-demo-480.jpg

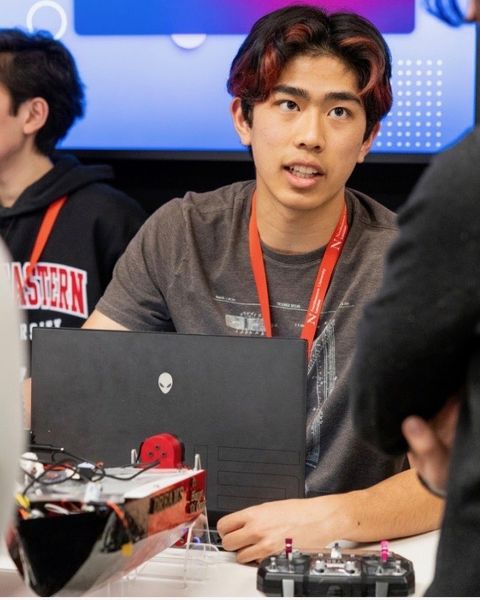
website/img/log-demo-480.jpg
