ka1e27/dreams/website/img/log-fiberglass-480.webp

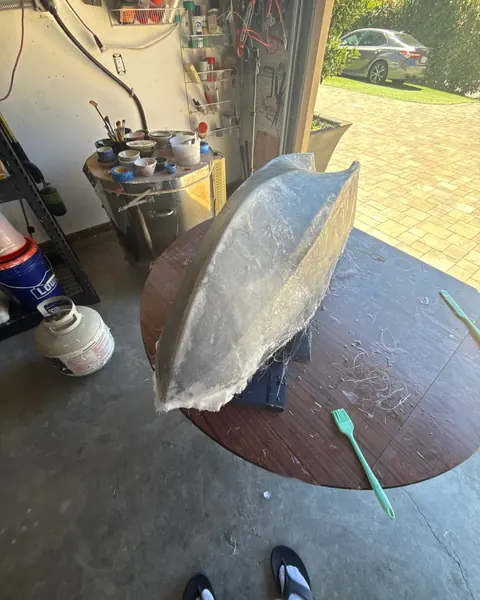
website/img/log-fiberglass-480.webp
