ka1e27/dreams/website/img/log-hull-coat-480.jpg

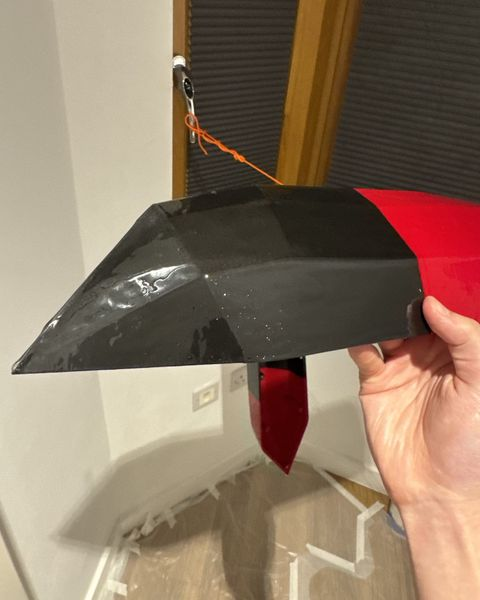
website/img/log-hull-coat-480.jpg
