ka1e27/dreams/website/img/log-pcb-r1-480.webp

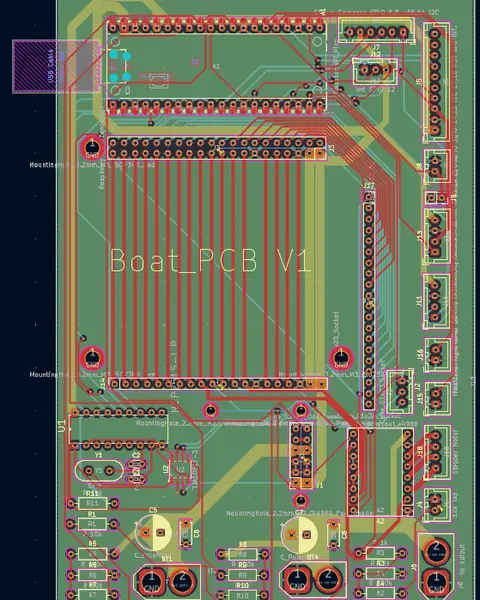
website/img/log-pcb-r1-480.webp
