ka1e27/dreams/website/img/log-pcb-r2-480.webp

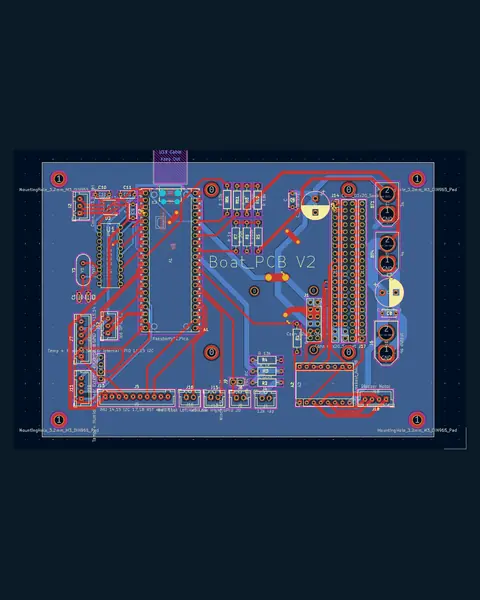
website/img/log-pcb-r2-480.webp
