ka1e27/dreams/website/img/log-showcase-682.jpg

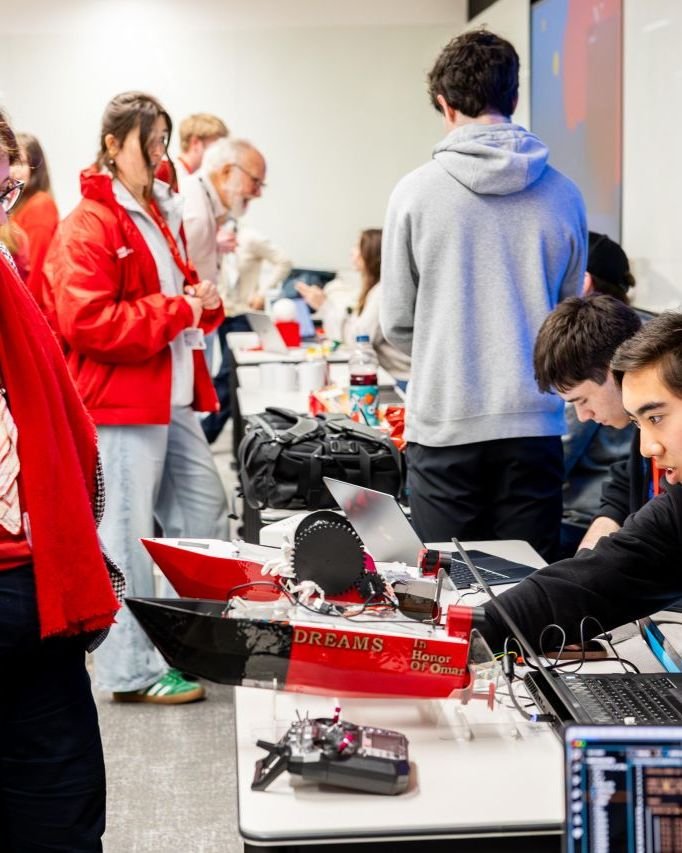
website/img/log-showcase-682.jpg
