ka1e27/dreams/website/img/log-sketch-720.webp

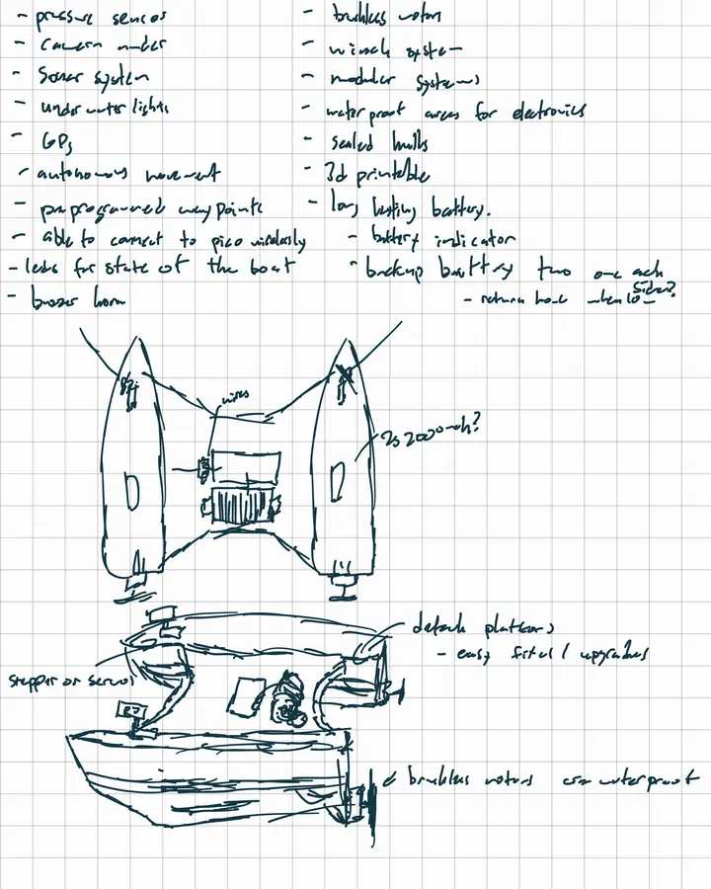
website/img/log-sketch-720.webp
