ka1e27/dreams/website/img/log-stereo-480.jpg

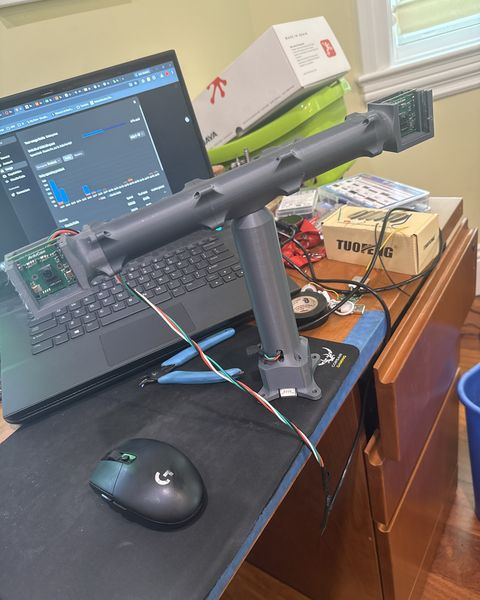
website/img/log-stereo-480.jpg
