ka1e27/dreams/website/img/log-v3-carrier-480.webp

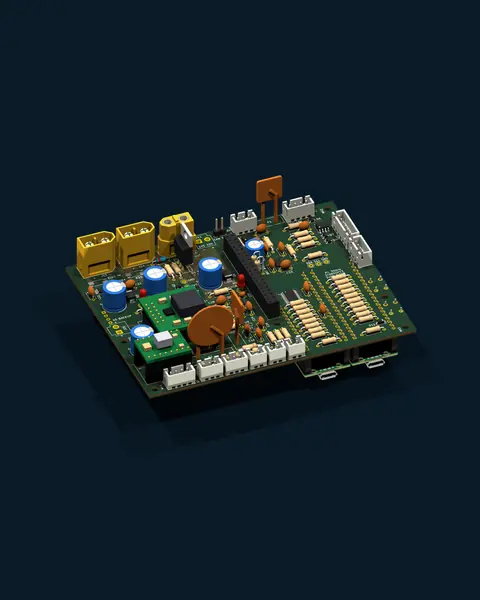
website/img/log-v3-carrier-480.webp
