ka1e27/dreams/website/img/matthew-hong-900.webp

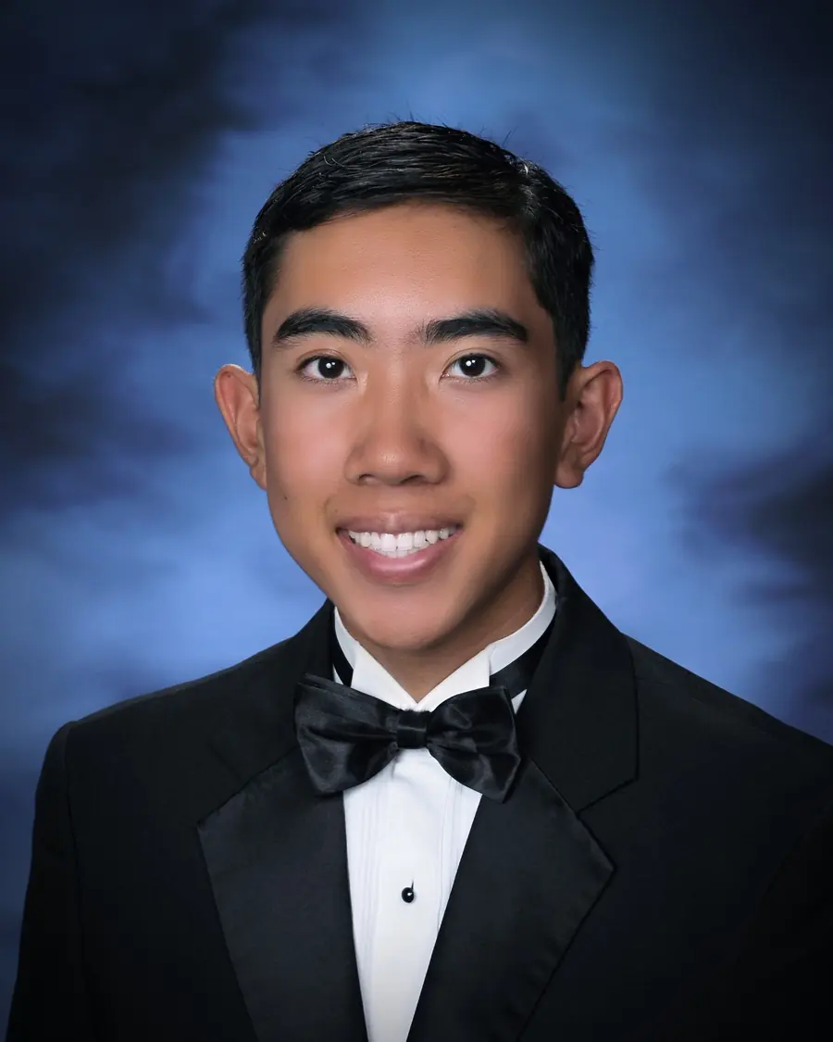
website/img/matthew-hong-900.webp
