ka1e27/dreams/website/img/omar-800.webp

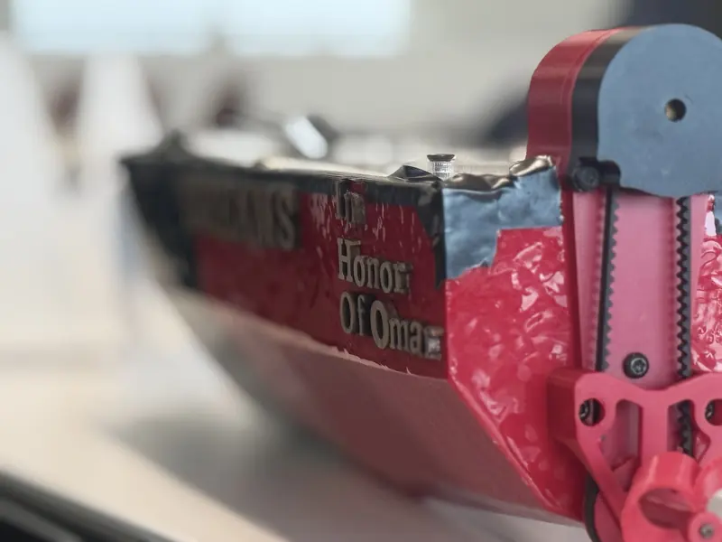
website/img/omar-800.webp
