ka1e27/dreams/website/img/omar-team-800.webp

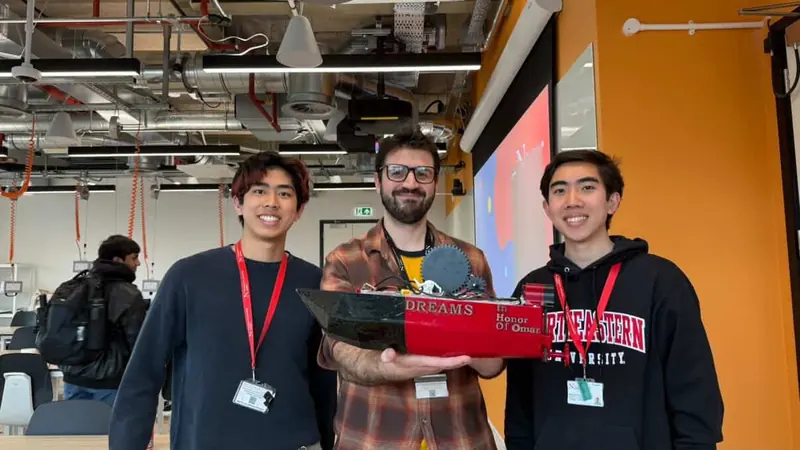
website/img/omar-team-800.webp
