ka1e27/dreams/website/img/partners/pcbway.png

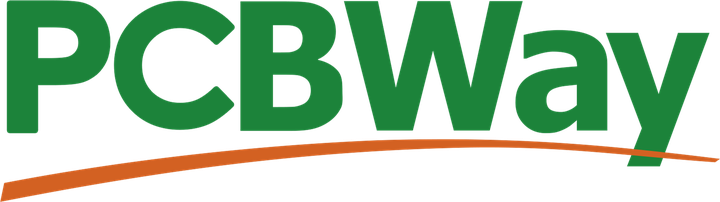
website/img/partners/pcbway.png
