ka1e27/dreams/website/img/room-workshop-1600.webp

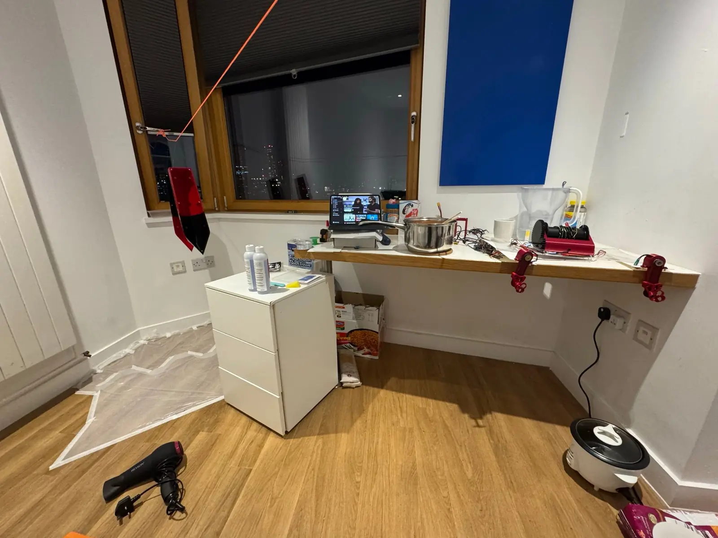
website/img/room-workshop-1600.webp
