ka1e27/dreams/website/img/showcase-1280.webp

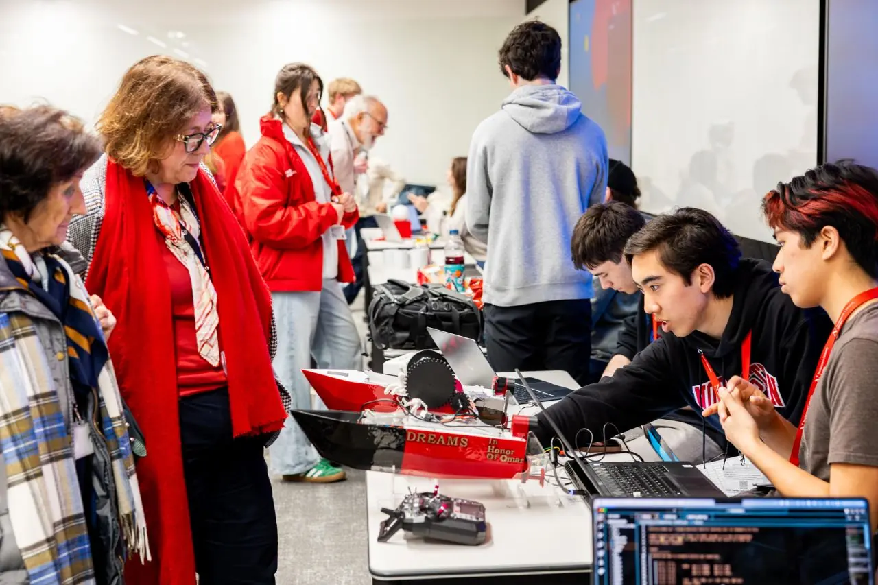
website/img/showcase-1280.webp
