ka1e27/dreams/website/img/upd-2026-10-05-site-900.jpg

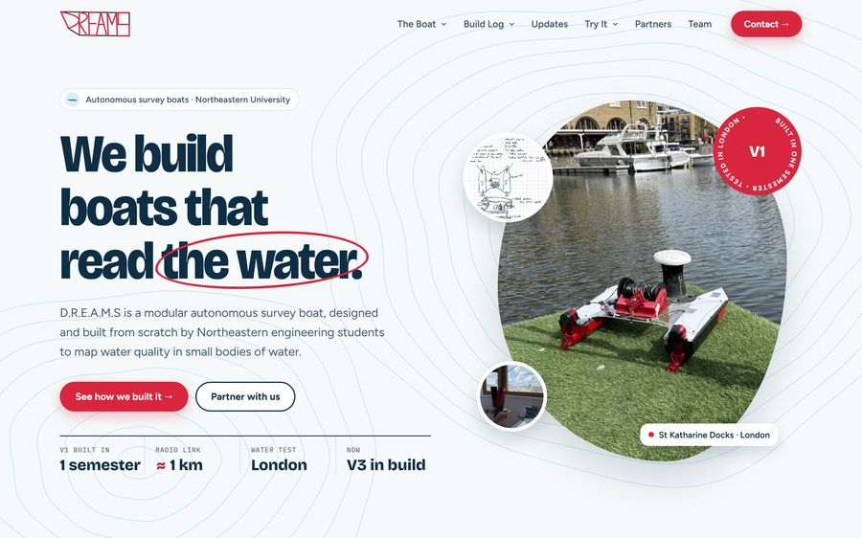
website/img/upd-2026-10-05-site-900.jpg
