ka1e27/dreams/website/img/upd-2026-10-12-bottom-900.webp

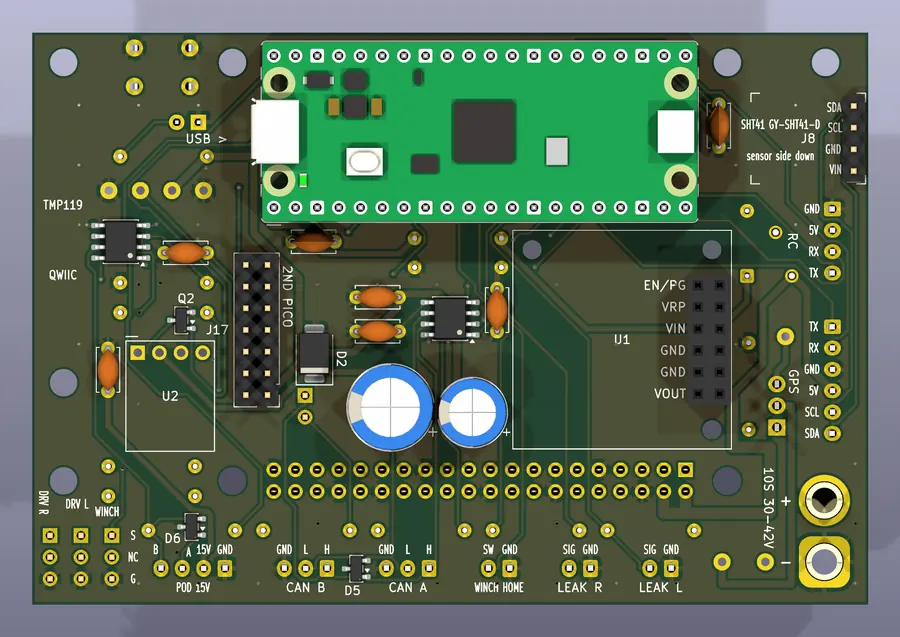
website/img/upd-2026-10-12-bottom-900.webp
