ka1e27/dreams/website/img/upd-2026-10-12-side-900.jpg

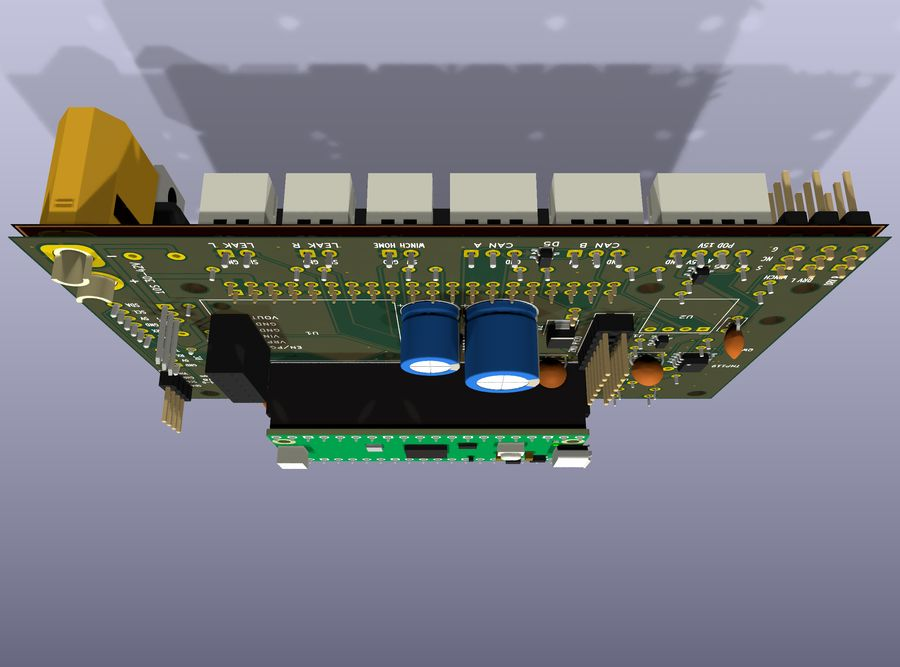
website/img/upd-2026-10-12-side-900.jpg
