ka1e27/dreams/website/img/v2-dashboard-1600.jpg

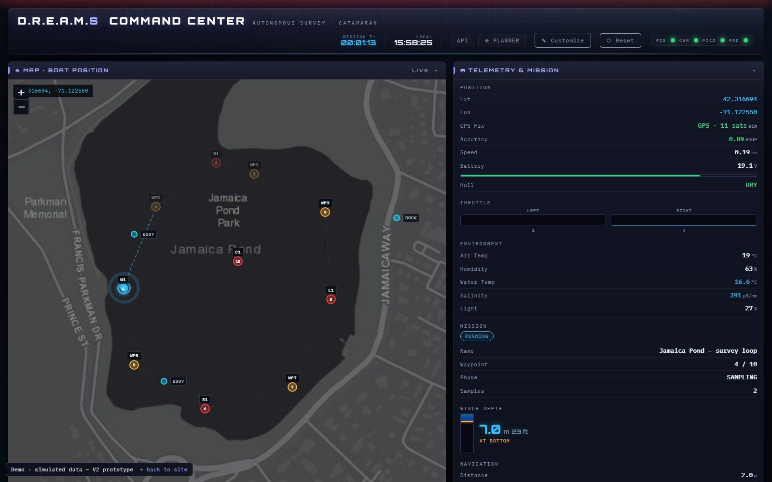
website/img/v2-dashboard-1600.jpg
