ka1e27/dreams/website/img/v3-pod-iso-600.png

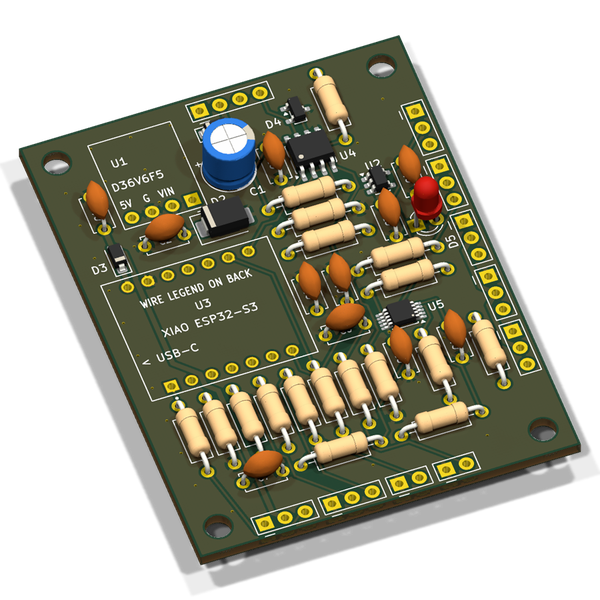
website/img/v3-pod-iso-600.png
