ka1e27/dreams/website/media/v3-carrier-3d-poster.webp

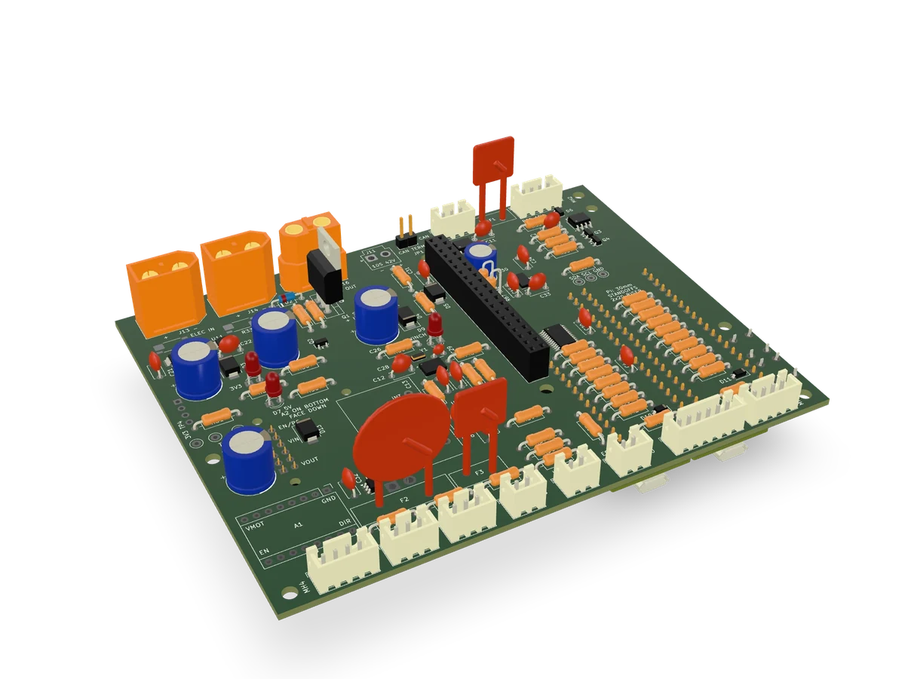
website/media/v3-carrier-3d-poster.webp
