ka1e27/dreams/website/media/v3-carrier-top.png

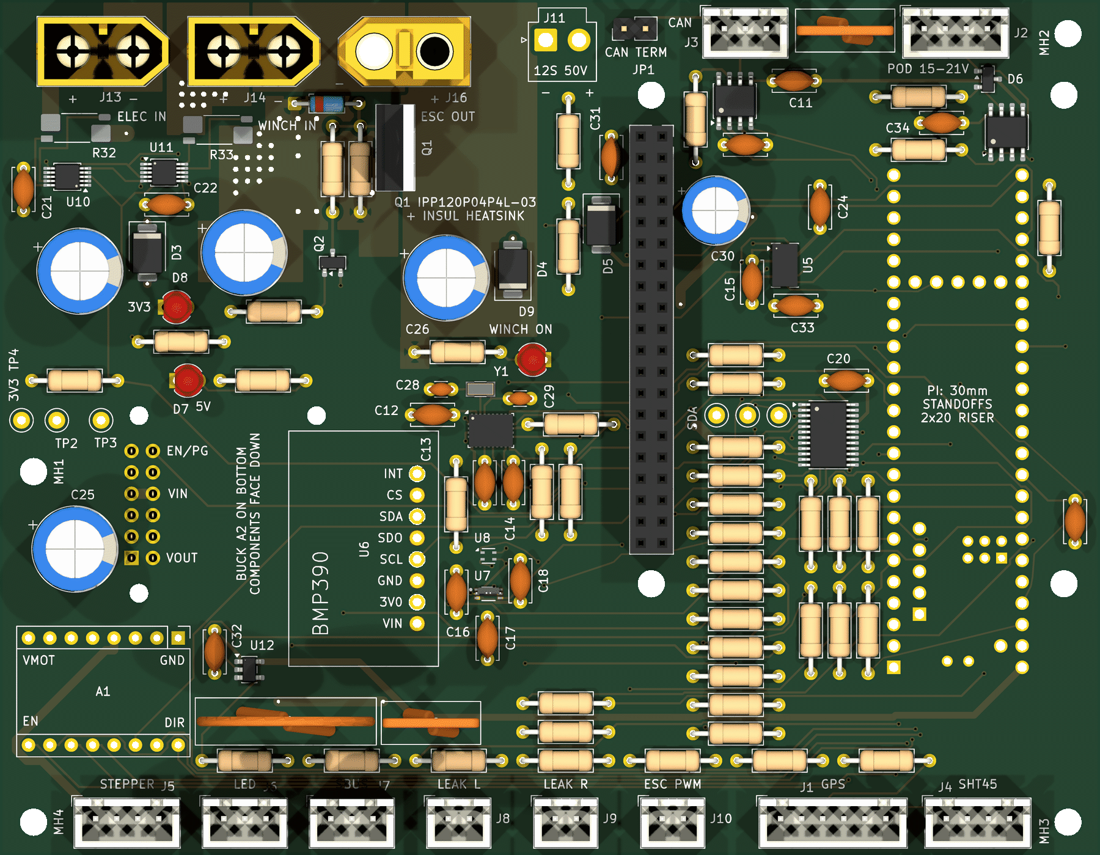
website/media/v3-carrier-top.png
