ka1e27/dreams/mechanical/cad/arch_frame_plate.dxf

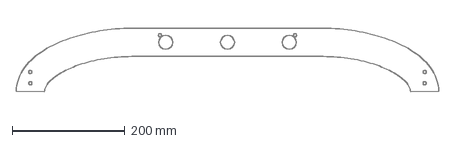
[picture p56: CAD file, 2026-10-14]
mechanical/cad/arch_frame_plate.dxf
750.0 x 112.5 mm
