ka1e27/dreams/mechanical/props/toroidal_3loop_p75_RH_shaft/toroidal_3loop_p75_RH_shaft.stl

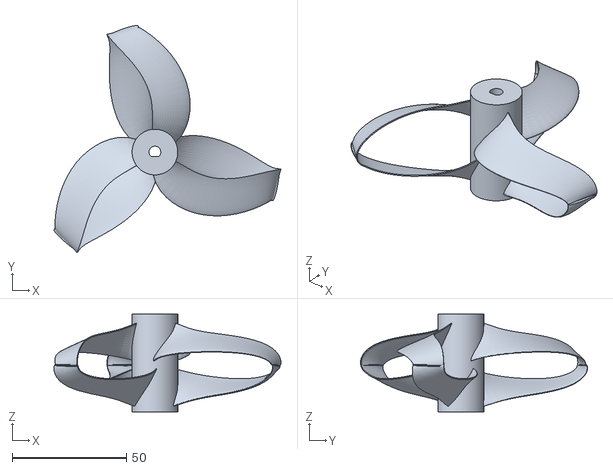
[picture p57: CAD file, 2026-10-14]
mechanical/props/toroidal_3loop_p75_RH_shaft/toroidal_3loop_p75_RH_shaft.stl
99.5 x 99.5 x 42.8
