ka1e27/dreams/docs/wiring_diagram.html

# D.R.E.A.M.S. Wiring

Autonomous Catamaran · Survey + Fishing Configuration

Sheet1 of 1
WIR · 100

Rev 2.2Manhattan re-route
2026-05-09

## Color Legend

12S LiPo · 50.4 V propulsion

6S midpoint tap · 25.2 V winch

3S Li-ion logic · 12.6 V → 5/3.3 V

Signal · UART · I²C · PWM · USB

Sealed bay outline · future component

Bay feedthrough · IP66 (FT-#)

Feedthroughs: FT-T1..T4 mast cables (USB · NMEA · SBUS), FT-L1 5 V in to Pi 5, FT-L2 3.3 V in to Pico, FT-L3 6S tap in to winch ESC, FT-B1 UART0 to VESC master, FT-B2 3-phase to winch motor, FT-B3 UART tether to slip ring. The dashed red trace is the 12S − return path, run separately from logic GND back to a single star point at the buck array.

## Revisions

Rev | Date | Change
1.0 | 2025-09-12 | Initial · single camera · 4S LiPo · QMC5883P · PWM ESCs
1.1 | 2025-12-04 | Pressure transducer added on Pod Pico GP22
2.0 | 2026-05-09 | VESC + 12S/3S split + BNO085 + M10Q + SBUS + stereo CV + WiFi mode
2.2 | 2026-05-09 | Re-routed entire schematic onto strict Manhattan grid · pin-labeled chip-style Pico · pod column moved to waterline

## Build Notes

- Run all logic-domain ground returns to a single star point at the buck array; do not bond logic GND to propulsion GND.
- VESC master/slave CAN bus terminated 120 Ω at each VESC; stub length on Pico's UART branch under 30 cm.
- BNO085 mounted to the hull keel, axes aligned to vehicle frame; magnetometer cal in clear of speakers and DC-DC.
- SBUS receiver runs on its own 5 V buck — sharing with servos couples brownouts straight into the failsafe input.
- Hull leak switches normally open; the pull-up is internal to the Pico (GP17/18). 1 kΩ in series limits fault current.
- The 6S midpoint tap pulls current — never use this rail for high-cycle loads; the winch is intermittent and acceptable.
- Pod-side power and UART share the same 4-conductor slip ring; the cable-side connector is JST-GH 4-pin with O-ring strain relief.

D.R.E.A.M.S · WIR-100 · sheet 1 / 1 · plotted 2026-05-09
