ka1e27/dreams/website/img/log-assembly-340.jpg

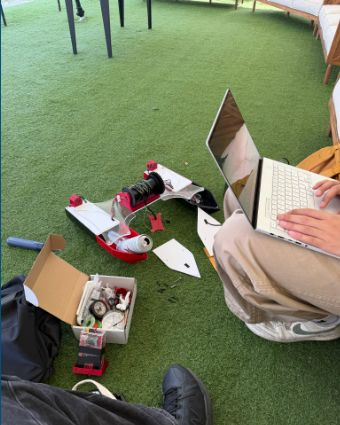
website/img/log-assembly-340.jpg
