ka1e27/dreams/website/img/log-hull-print-480.webp

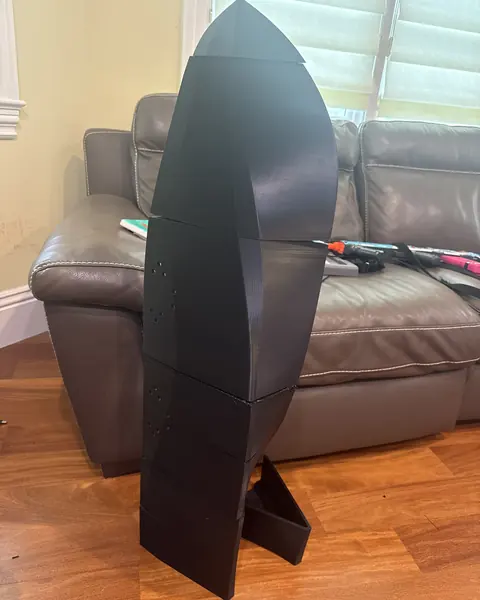
website/img/log-hull-print-480.webp
