ka1e27/dreams/website/img/v1-assembly-700.jpg

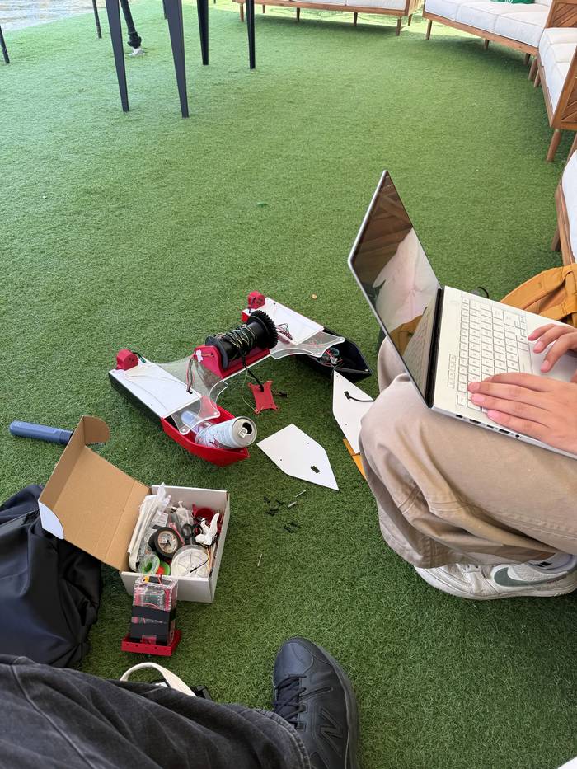
website/img/v1-assembly-700.jpg
