ka1e27/dreams/website/img/log-winch-test-480.webp

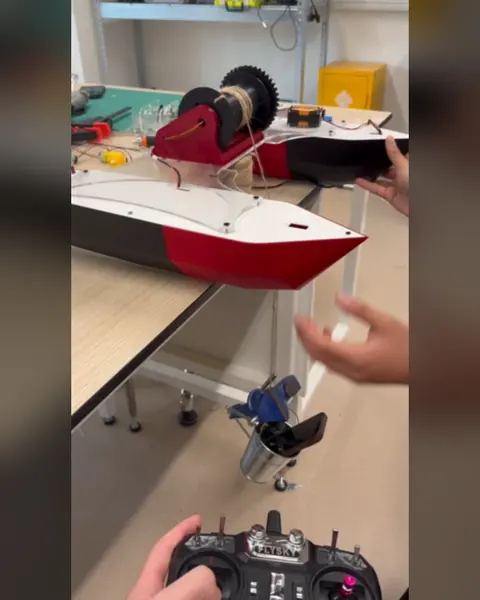
website/img/log-winch-test-480.webp
