ka1e27/dreams/website/tools/build-log.template.html

Skip to content



Build log

# Everything we built. Including what broke.

Every part of D.R.E.A.M.S, from the first sketch to the V3 boards, with an honest status on each entry.

01 · The full log

## entries, three generations.

Filter by version or by status. Every entry is something we designed, built, tested or tried and abandoned.

All versions V1 V2 V3 Later

Any status Designed Built Tested Failed Shown Next

Show all entries

02 · Three generations

## V1 · V2 · V3

Each version fixes what the last one taught us.

V1CompleteSpring 2026

### Proof of concept

Built in one semester in London: three RP2040 microcontrollers on the boat, shore station and pod, a 3D-printed PLA hull, and a 433 MHz radio link that reached about 1 km to shore.

In its water test at St Katharine Docks it navigated to GPS waypoints on its own, and its pod sampled temperature, conductivity and light at the bottom.

Open the V1 planner ↗ (https://dreamsv1.kylegtran2007.workers.dev/)

 V1 on the waterShort

Visitors at the Creators' Showcase looking at V1

 Winch weight testVideo

V2PrototypeSummer 2026

### The prototype that taught us

V2 moved the brain to a Raspberry Pi 5 and prototyped stereo depth with YOLOv8 obstacle detection, a live web dashboard and our first custom PCB.

It was never fully built. Bench testing exposed flaws in its motor control, power and safety design, and those lessons led us to redesign the whole system.

Try the V2 command center ↗

 V2 stereo trackingVideo

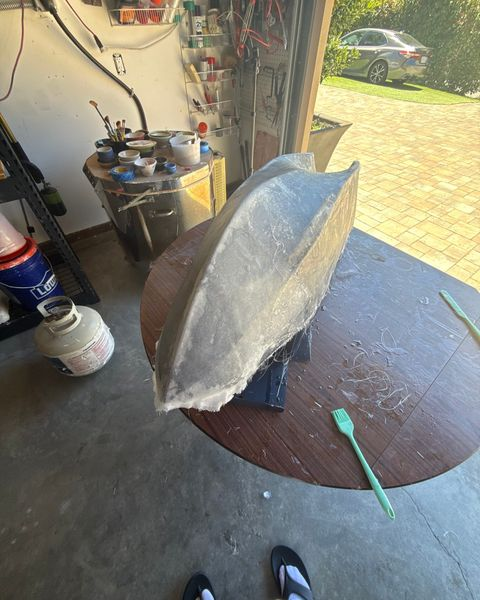
[picture p62: website/img/log-fiberglass-480.jpg]
Fiberglass over a printed V2 hull
 KiCad layout of the V2 PCB, REV 02

V3In buildFall 2026

### Built for the field

A ground-up redesign that fixes what V2 got wrong: two Raspberry Pi Pico 2 real-time controllers, CAN-bus motor control, a fused and monitored 10S power system and a new RS-485 sensor pod, with a fish-finder sonar for depth. The carrier and pod boards are laid out and checked.

The goal: autonomous surface surveys of small bodies of water. The Charles River Watershed Association (CRWA) is helping us develop the monitoring design and follow proper guidelines for data collection.

See the V3 system →

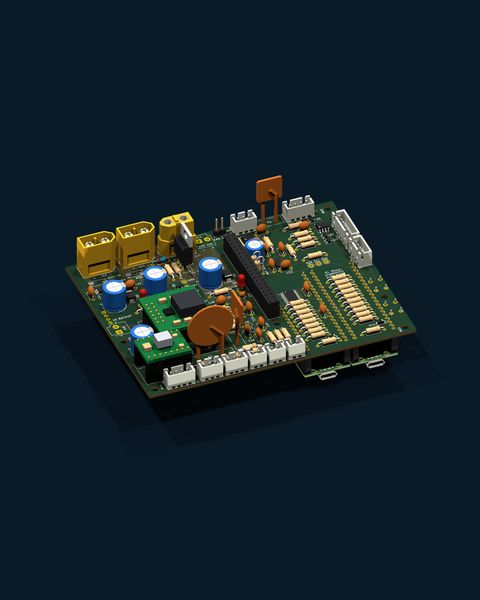
[picture p63: website/img/log-v3-carrier-480.jpg]
V3 carrier board render
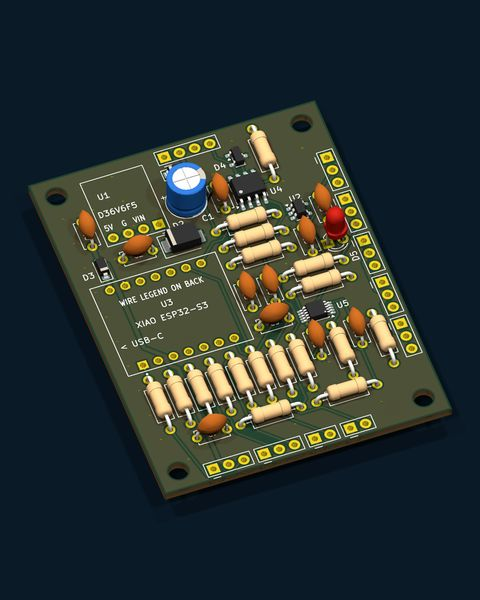
[picture p64: website/img/log-v3-pod-480.jpg]
V3 pod board render
 

V3 hull · in CAD

03 · What broke

## The dead ends that shaped V3.

We'd rather show you what didn't work than pretend everything did.

Failed · V1

### Jet drive

An early jet-propulsion experiment on V1 that didn't work out. A dead end, but a useful one: it taught us early what to keep simple.

Failed · V2 bench

### V2's control, power and safety design

Bench testing showed that V2's motor control, power and safety design weren't reliable enough to put on the water.

Fix in V3Real-time control moved to two Raspberry Pi Pico 2s, each VESC became its own CAN node, every power feed got its own fuse and current monitor, and the winch driver got a fail-safe hardware kill, ready for the later sample-collection stage.

04 · Roadmap

## Where it's going.

V3's goal is deliberately focused: drive itself around small bodies of water and collect data at the surface. Collecting physical samples comes later.

1. V1 · Spring 2026V1

### Proof of concept

  Autonomous waypoint navigation, a 1 km radio link and bottom sampling, on a 3D-printed hull.
  Complete
2. V2 · Summer 2026V2

### The prototype that taught us

  Pi 5, stereo vision and our first PCB. Never fully built; its flaws drove V3.
  Prototype
3. V3 · Fall 2026 · NowV3

### Autonomous surface surveys

  V3 will drive itself around small bodies of water, sample at the surface with the pod and measure depth with a fish-finder sonar.
  In build
4. LaterNext

### Sample collection

  A robotic arm on deck that works with the winch to collect water samples and sediment from the bottom.
  Arm in development

V3 milestones

1. Done

### Electronics designed

  Carrier board (rev F), V3.1 starter board and sensor-pod board (rev B) laid out and checked.
2. In progress

### New hull

  A modular hull in CAD, built around the V3 electronics.
3. Next

### Build

  Fabricate the boards and assemble the electronics, pod and fish finder into the hull.
4. Planned

### Firmware

  Autonomous waypoint navigation, surface sampling and depth logging, streamed to the dashboard.
5. Planned

### Field trials

  Surveys of small bodies of water, following the monitoring design we're developing with CRWA.

Why sediment

In our conversations with the Port of Oakland and the Charles River Watershed Association, we learned that their teams still collect sediment samples by sending divers down. An arm on an autonomous boat could do that job without anyone going in the water.
