ka1e27/dreams/Boat_PCB/Boat_PCB_V3_1/Boat_PCB_V3_1.kicad_pcb

## KiCad design Boat_PCB/Boat_PCB_V3_1/Boat_PCB_V3_1.kicad_pcb (2026-11-04)

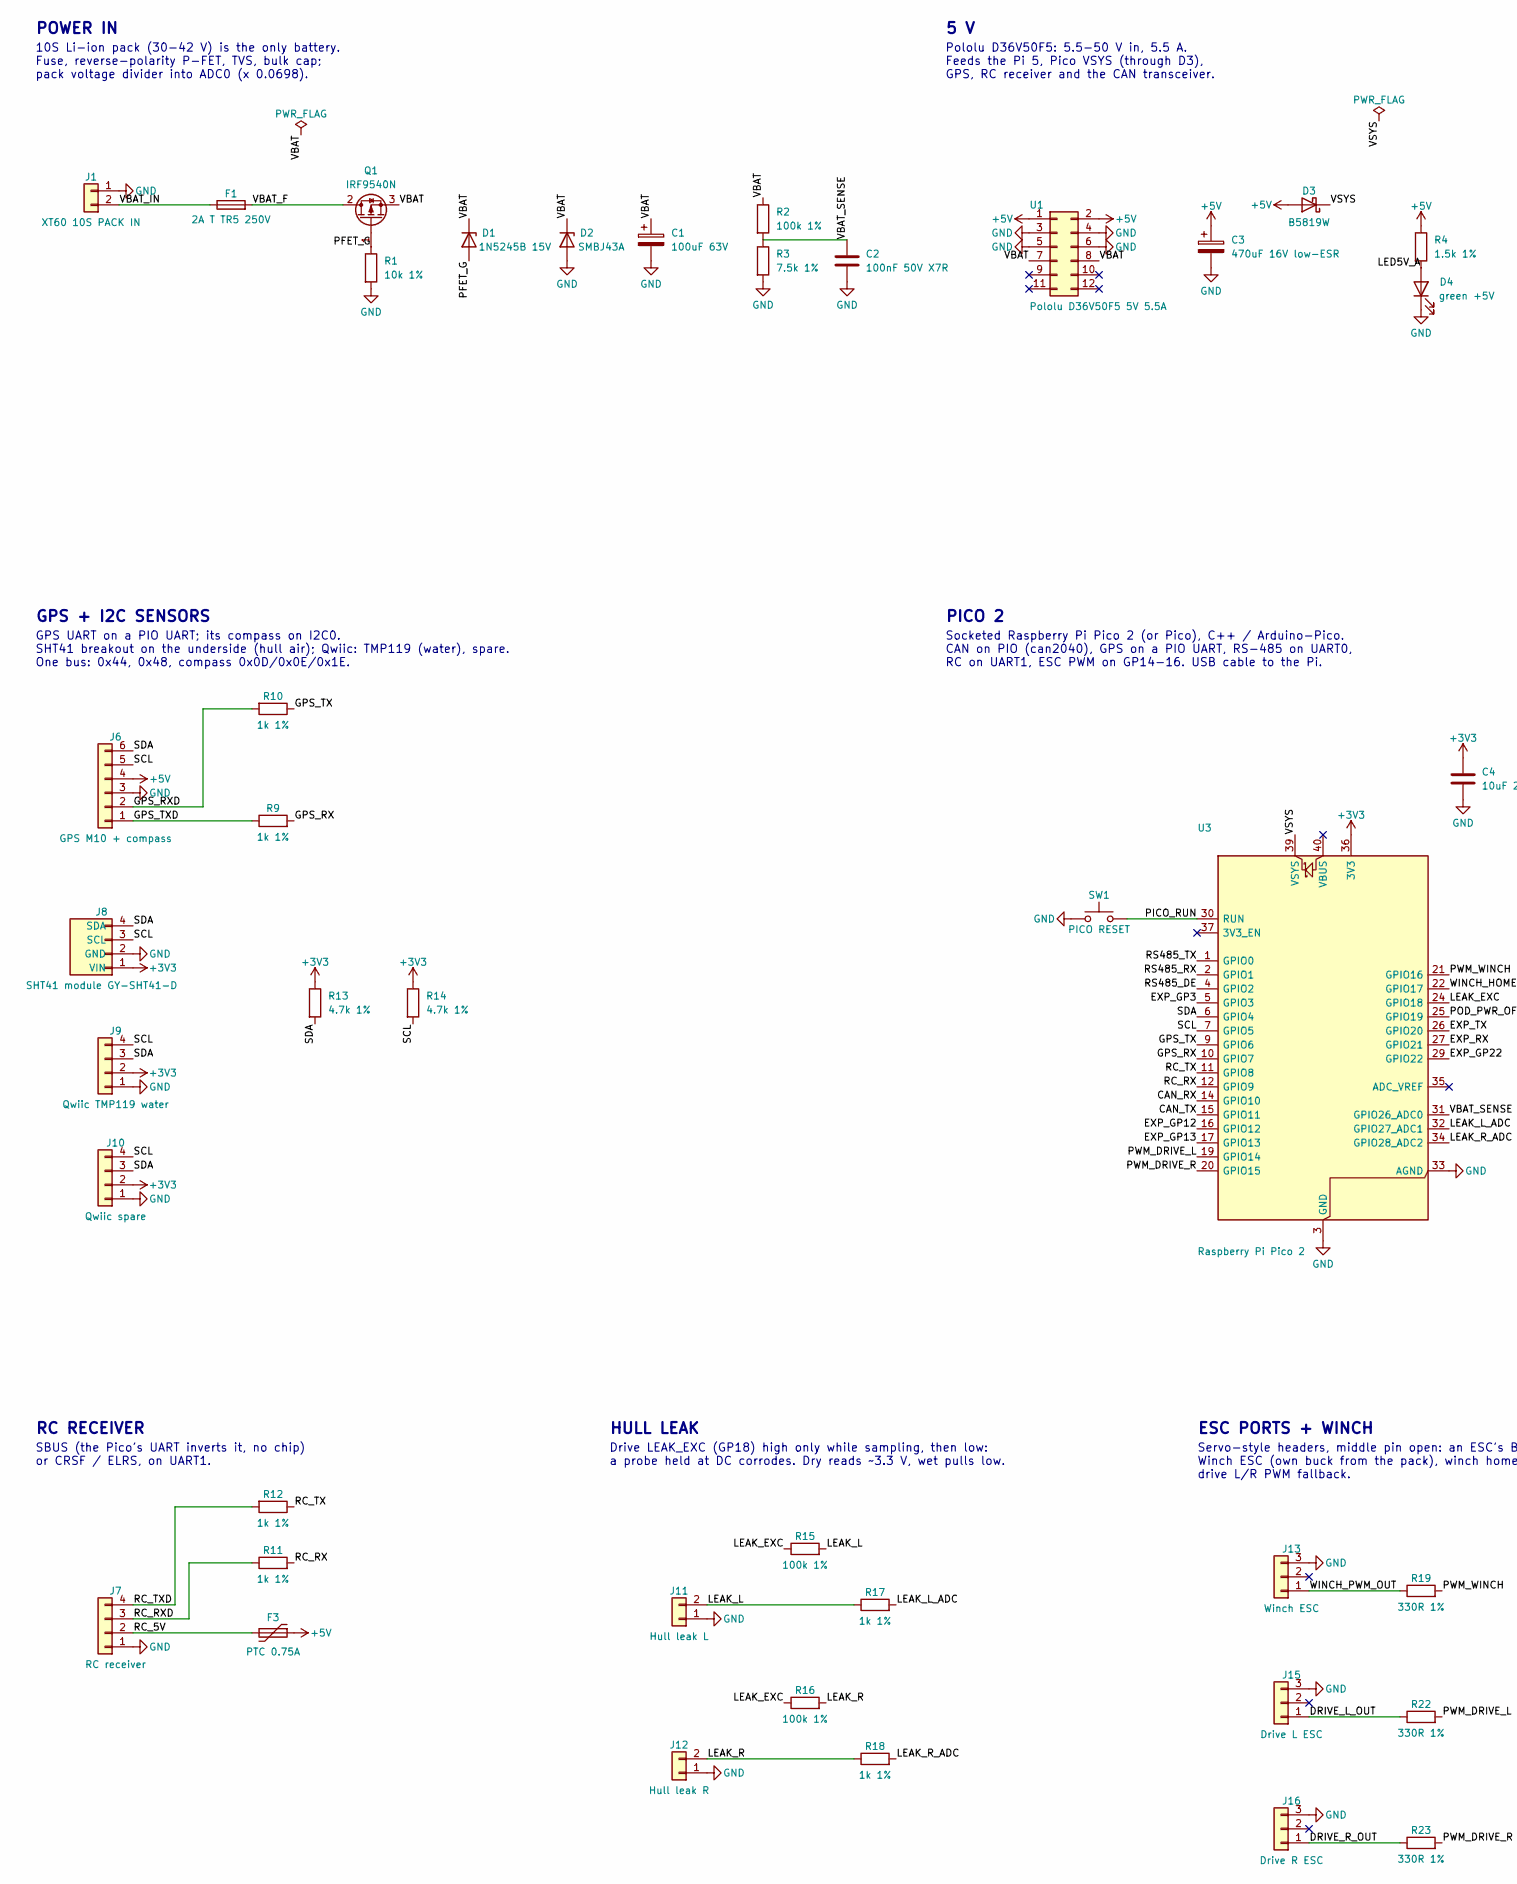
[picture p65: schematic Boat_PCB_V3_1.kicad_sch, D.R.E.A.M.S V3.1 starter carrier, part in row 1, column 1]

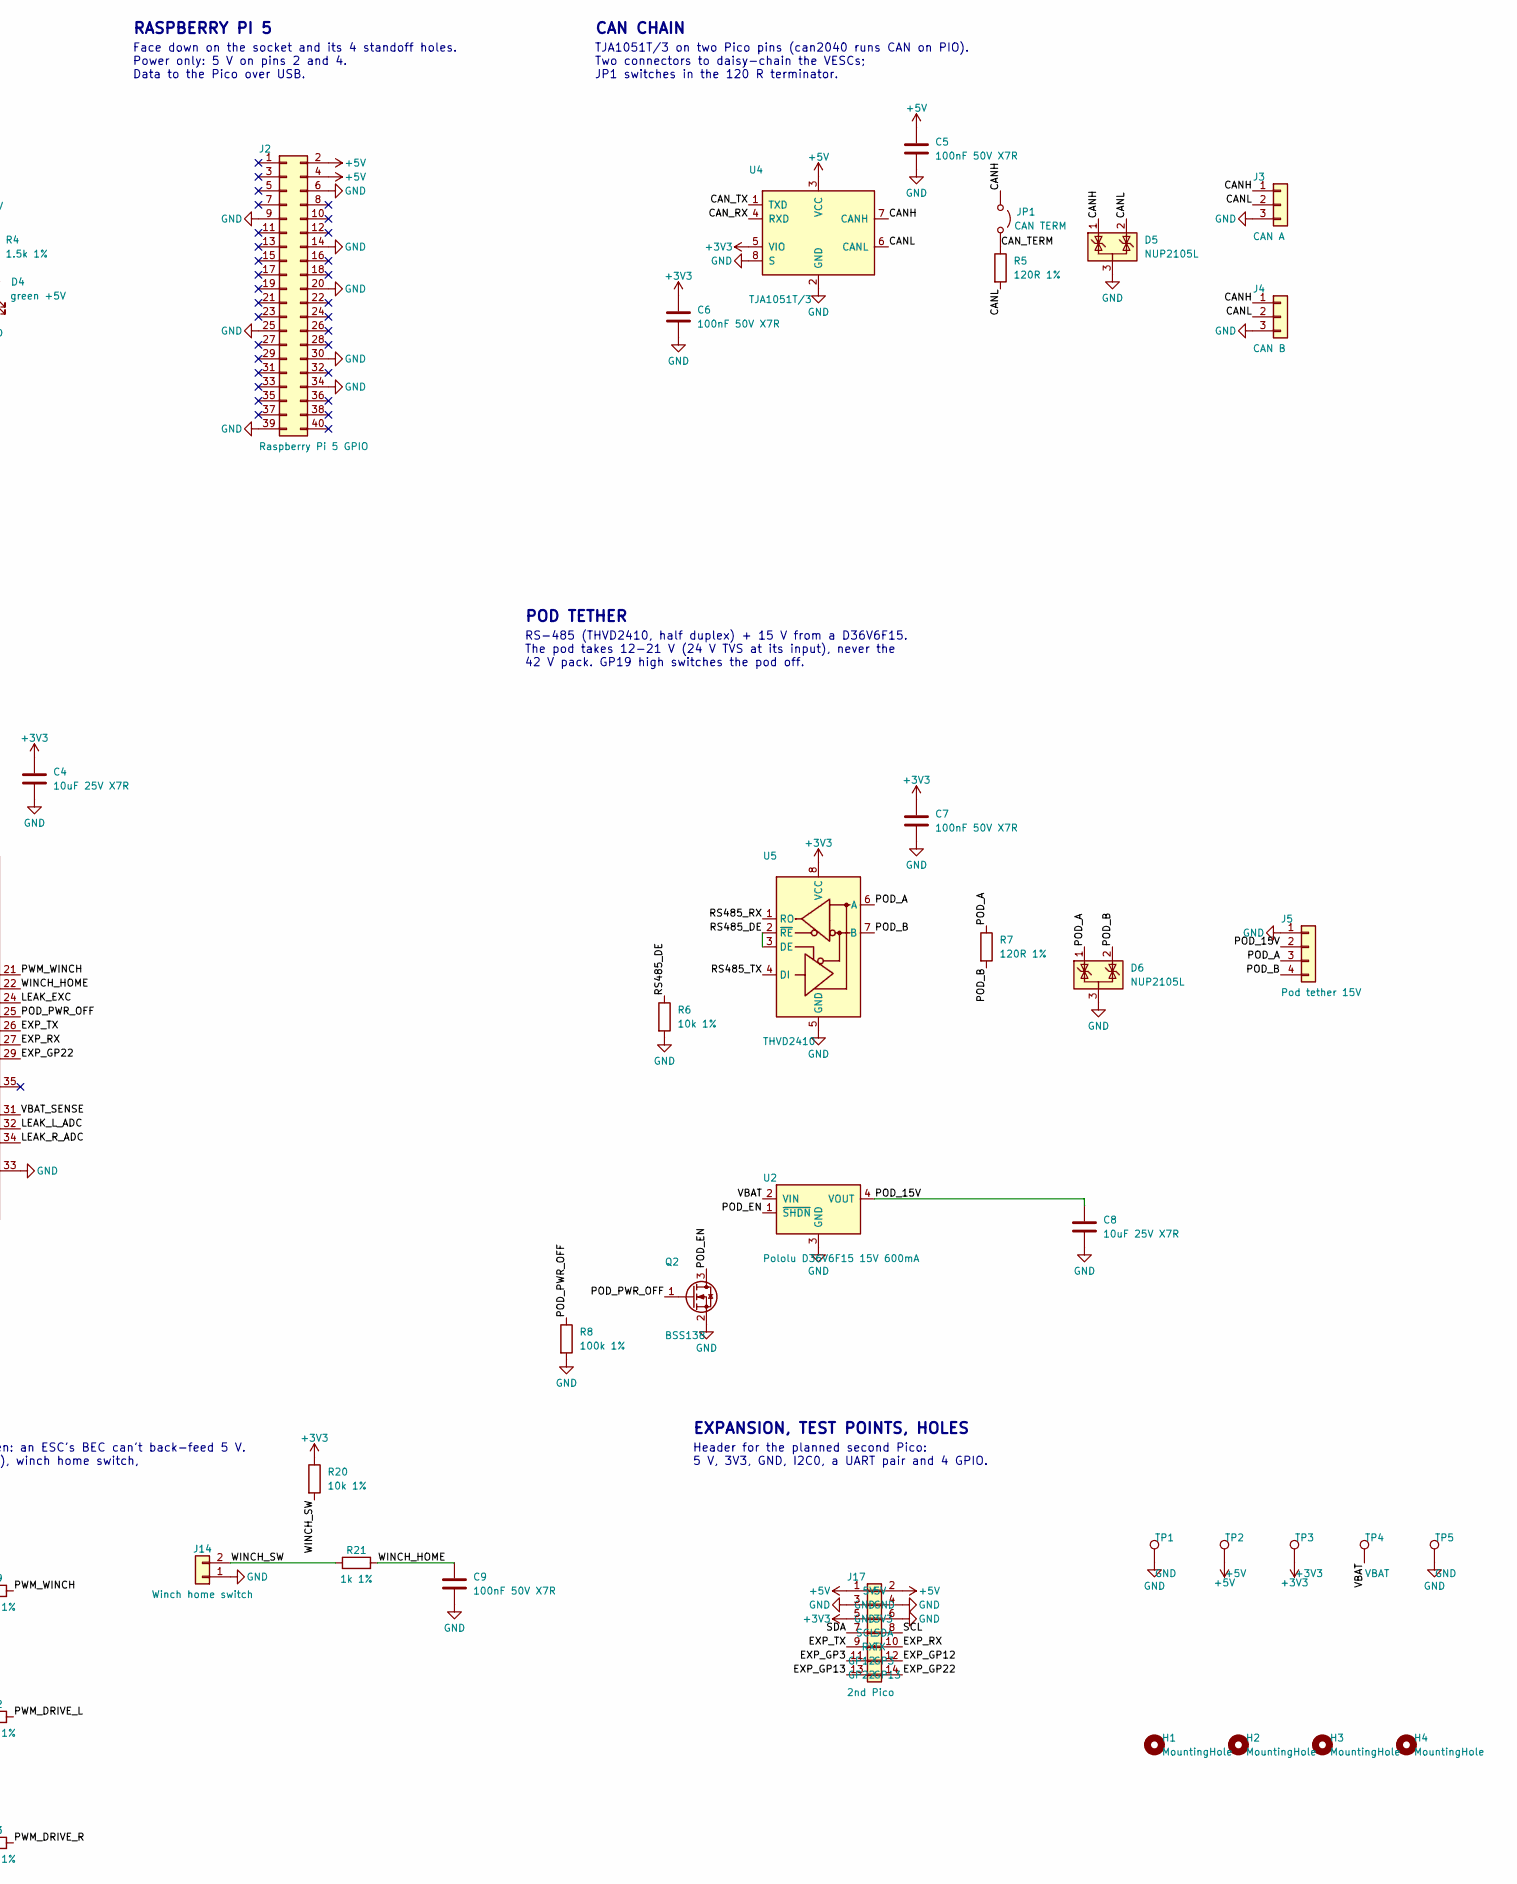
[picture p66: schematic Boat_PCB_V3_1.kicad_sch, D.R.E.A.M.S V3.1 starter carrier, part in row 1, column 2]

Parts:
C1: 100uF 63V; CP_Radial_D10.0mm_P5.00mm
C2, C5, C6, C7, C9: 100nF 50V X7R; C_Disc_D5.0mm_W2.5mm_P5.00mm
C3: 470uF 16V low-ESR; CP_Radial_D8.0mm_P3.50mm
C4, C8: 10uF 25V X7R; C_Disc_D5.0mm_W2.5mm_P5.00mm
D1: 1N5245B 15V; D_DO-35_SOD27_P7.62mm_Horizontal
D2: SMBJ43A; D_SMB
D3: B5819W; D_SOD-123
D4: green +5V; LED_D3.0mm
D5, D6: NUP2105L; SOT-23
F1: 2A T TR5 250V; Fuse_Littelfuse_372_D8.50mm
F3: PTC 0.75A; Fuse_BelFuse_0ZRE0075FF_L11.5mm_W4.8mm
H1, H2, H3, H4: MountingHole; MountingHole_3.2mm_M3
J1: XT60 10S PACK IN; AMASS_XT60-M_1x02_P7.20mm_Vertical
J2: Raspberry Pi 5 GPIO; RaspberryPi_5_GPIO_Socket_2x20
J3: CAN A; JST_XH_B3B-XH-A_1x03_P2.50mm_Vertical
J4: CAN B; JST_XH_B3B-XH-A_1x03_P2.50mm_Vertical
J5: Pod tether 15V; JST_XH_B4B-XH-A_1x04_P2.50mm_Vertical
J6: GPS M10 + compass; JST_XH_B6B-XH-A_1x06_P2.50mm_Vertical
J7: RC receiver; JST_XH_B4B-XH-A_1x04_P2.50mm_Vertical
J8: SHT41 module GY-SHT41-D; SHT41_Module_GY-SHT41-D_1x04_P2.54mm
J9: Qwiic TMP119 water; JST_SH_SM04B-SRSS-TB_1x04-1MP_P1.00mm_Horizontal
J10: Qwiic spare; JST_SH_SM04B-SRSS-TB_1x04-1MP_P1.00mm_Horizontal
J11: Hull leak L; JST_XH_B2B-XH-A_1x02_P2.50mm_Vertical
J12: Hull leak R; JST_XH_B2B-XH-A_1x02_P2.50mm_Vertical
J13: Winch ESC; PinHeader_1x03_P2.54mm_Vertical
J14: Winch home switch; JST_XH_B2B-XH-A_1x02_P2.50mm_Vertical
J15: Drive L ESC; PinHeader_1x03_P2.54mm_Vertical
J16: Drive R ESC; PinHeader_1x03_P2.54mm_Vertical
J17: 2nd Pico; PinHeader_2x07_P2.54mm_Vertical
JP1: CAN TERM; PinHeader_1x02_P2.54mm_Vertical
Q1: IRF9540N; TO-220-3_Vertical
Q2: BSS138; SOT-23
R1, R6, R20: 10k 1%; R_Axial_DIN0207_L6.3mm_D2.5mm_P10.16mm_Horizontal
R2, R8, R15, R16: 100k 1%; R_Axial_DIN0207_L6.3mm_D2.5mm_P10.16mm_Horizontal
R3: 7.5k 1%; R_Axial_DIN0207_L6.3mm_D2.5mm_P10.16mm_Horizontal
R4: 1.5k 1%; R_Axial_DIN0207_L6.3mm_D2.5mm_P10.16mm_Horizontal
R5, R7: 120R 1%; R_Axial_DIN0207_L6.3mm_D2.5mm_P10.16mm_Horizontal
R9, R10, R11, R12, R17, R18, R21: 1k 1%; R_Axial_DIN0207_L6.3mm_D2.5mm_P10.16mm_Horizontal
R13, R14: 4.7k 1%; R_Axial_DIN0207_L6.3mm_D2.5mm_P10.16mm_Horizontal
R19, R22, R23: 330R 1%; R_Axial_DIN0207_L6.3mm_D2.5mm_P10.16mm_Horizontal
SW1: PICO RESET; SW_PUSH_6mm
TP1, TP5: GND; TestPoint_Keystone_5000-5004_Miniature
TP2: +5V; TestPoint_Keystone_5000-5004_Miniature
TP3: +3V3; TestPoint_Keystone_5000-5004_Miniature
TP4: VBAT; TestPoint_Keystone_5000-5004_Miniature
U1: Pololu D36V50F5 5V 5.5A; Pololu_D36V50F5
U2: Pololu D36V6F15 15V 600mA; Pololu_D36V6F5
U3: Raspberry Pi Pico 2; RaspberryPi_Pico_Socketed_THT
U4: TJA1051T/3; SOIC-8_3.9x4.9mm_P1.27mm
U5: THVD2410; SOIC-8_3.9x4.9mm_P1.27mm

Connections:
+3V3: C4.1, C6.1, C7.1, J8.1 (VIN), J9.2 (3V3), J10.2 (3V3), J17.5 (3V3), R13.1, R14.1, R20.1, TP3.1, U3.36 (3V3), U4.5 (VIO), U5.8 (VCC)
+5V: C3.1, C5.1, D3.2 (A), F3.1, J2.2 (5V), J2.4 (5V), J6.4 (V), J17.1 (5V), J17.2 (5V), R4.1, TP2.1, U1.1 (VOUT), U1.2 (VOUT), U4.3 (VCC)
/CANH: D5.1 (K), J3.1 (CANH), J4.1 (CANH), JP1.1 (A), U4.7 (CANH)
/CANL: D5.2 (K), J3.2 (CANL), J4.2 (CANL), R5.2, U4.6 (CANL)
/CAN_RX: U3.14 (GPIO10), U4.4 (RXD)
/CAN_TERM: JP1.2 (B), R5.1
/CAN_TX: U3.15 (GPIO11), U4.1 (TXD)
/DRIVE_L_OUT: J15.1 (SIG), R22.1
/DRIVE_R_OUT: J16.1 (SIG), R23.1
/EXP_GP3: J17.11 (GP3), U3.5 (GPIO3)
/EXP_GP12: J17.12 (GP12), U3.16 (GPIO12)
/EXP_GP13: J17.13 (GP13), U3.17 (GPIO13)
/EXP_GP22: J17.14 (GP22), U3.29 (GPIO22)
/EXP_RX: J17.10 (RX), U3.27 (GPIO21)
/EXP_TX: J17.9 (TX), U3.26 (GPIO20)
/GPS_RX: R9.2, U3.10 (GPIO7)
/GPS_RXD: J6.2 (RX), R10.2
/GPS_TX: R10.1, U3.9 (GPIO6)
/GPS_TXD: J6.1 (TX), R9.1
/LEAK_EXC: R15.1, R16.1, U3.24 (GPIO18)
/LEAK_L: J11.2 (LEAK), R15.2, R17.1
/LEAK_L_ADC: R17.2, U3.32 (GPIO27_ADC1)
/LEAK_R: J12.2 (LEAK), R16.2, R18.1
/LEAK_R_ADC: R18.2, U3.34 (GPIO28_ADC2)
/LED5V_A: D4.2 (A), R4.2
/PFET_G: D1.2 (A), Q1.1 (G), R1.1
/PICO_RUN: SW1.2, U3.30 (RUN)
/POD_15V: C8.1, J5.2 (VPACK), U2.4 (VOUT)
/POD_A: D6.1 (K), J5.3 (A), R7.1, U5.6 (A)
/POD_B: D6.2 (K), J5.4 (B), R7.2, U5.7 (B)
/POD_EN: Q2.3 (D), U2.1 (~SHDN)
/POD_PWR_OFF: Q2.1 (G), R8.1, U3.25 (GPIO19)
/PWM_DRIVE_L: R22.2, U3.19 (GPIO14)
/PWM_DRIVE_R: R23.2, U3.20 (GPIO15)
/PWM_WINCH: R19.2, U3.21 (GPIO16)
/RC_5V: F3.2, J7.2 (5V)
/RC_RX: R11.2, U3.12 (GPIO9)
/RC_RXD: J7.3 (RX), R11.1
/RC_TX: R12.1, U3.11 (GPIO8)
/RC_TXD: J7.4 (TX), R12.2
/RS485_DE: R6.1, U3.4 (GPIO2), U5.2 (~RE), U5.3 (DE)
/RS485_RX: U3.2 (GPIO1), U5.1 (RO)
/RS485_TX: U3.1 (GPIO0), U5.4 (DI)
/SCL: J6.5 (SCL), J8.3 (SCL), J9.4 (SCL), J10.4 (SCL), J17.8 (SCL), R14.2, U3.7 (GPIO5)
/SDA: J6.6 (SDA), J8.4 (SDA), J9.3 (SDA), J10.3 (SDA), J17.7 (SDA), R13.2, U3.6 (GPIO4)
/VBAT: C1.1, D1.1 (K), D2.1 (K), Q1.3 (S), R2.1, TP4.1, U1.7 (VIN), U1.8 (VIN), U2.2 (VIN)
/VBAT_F: F1.2, Q1.2 (D)
/VBAT_IN: F1.1, J1.2 (+)
/VBAT_SENSE: C2.1, R2.2, R3.1, U3.31 (GPIO26_ADC0)
/VSYS: D3.1 (K), U3.39 (VSYS)
/WINCH_HOME: C9.1, R21.2, U3.22 (GPIO17)
/WINCH_PWM_OUT: J13.1 (SIG), R19.1
/WINCH_SW: J14.2 (SW), R20.2, R21.1
GND: C1.2, C2.2, C3.2, C4.2, C5.2, C6.2, C7.2, C8.2, C9.2, D2.2 (A), D4.1 (K), D5.3 (A), D6.3 (A), J1.1 (-), J2.6 (GND), J2.9 (GND), J2.14 (GND), J2.20 (GND), J2.25 (GND), J2.30 (GND), J2.34 (GND), J2.39 (GND), J3.3 (GND), J4.3 (GND), J5.1 (GND), J6.3 (GND), J7.1 (GND), J8.2 (GND), J9.1 (GND), J10.1 (GND), J11.1 (GND), J12.1 (GND), J13.3 (GND), J14.1 (GND), J15.3 (GND), J16.3 (GND), J17.3 (GND), J17.4 (GND), J17.6 (GND), Q2.2 (S), R1.2, R3.2, R6.2, R8.2, SW1.1, TP1.1, TP5.1, U1.3 (GND), U1.4 (GND), U1.5 (GND), U1.6 (GND), U2.3 (GND), U3.3 (GND), U3.8 (GND), U3.13 (GND), U3.18 (GND), U3.23 (GND), U3.28 (GND), U3.33 (AGND), U3.38 (GND), U4.2 (GND), U4.8 (S), U5.5 (GND)

Notes on the sheet:
POWER IN
10S Li-ion pack (30-42 V) is the only battery. Fuse, reverse-polarity P-FET, TVS, bulk cap; pack voltage divider into ADC0 (x 0.0698).
5 V
Pololu D36V50F5: 5.5-50 V in, 5.5 A. Feeds the Pi 5, Pico VSYS (through D3), GPS, RC receiver and the CAN transceiver.
RASPBERRY PI 5
Face down on the socket and its 4 standoff holes. Power only: 5 V on pins 2 and 4. Data to the Pico over USB.
CAN CHAIN
TJA1051T/3 on two Pico pins (can2040 runs CAN on PIO). Two connectors to daisy-chain the VESCs; JP1 switches in the 120 R terminator.
PICO 2
Socketed Raspberry Pi Pico 2 (or Pico), C++ / Arduino-Pico. CAN on PIO (can2040), GPS on a PIO UART, RS-485 on UART0, RC on UART1, ESC PWM on GP14-16. USB cable to the Pi.
GPS + I2C SENSORS
GPS UART on a PIO UART; its compass on I2C0. SHT41 breakout on the underside (hull air); Qwiic: TMP119 (water), spare. One bus: 0x44, 0x48, compass 0x0D/0x0E/0x1E.
POD TETHER
RS-485 (THVD2410, half duplex) + 15 V from a D36V6F15. The pod takes 12-21 V (24 V TVS at its input), never the 42 V pack. GP19 high switches the pod off.
RC RECEIVER
SBUS (the Pico's UART inverts it, no chip) or CRSF / ELRS, on UART1.
HULL LEAK
Drive LEAK_EXC (GP18) high only while sampling, then low: a probe held at DC corrodes. Dry reads ~3.3 V, wet pulls low.
ESC PORTS + WINCH
Servo-style headers, middle pin open: an ESC's BEC can't back-feed 5 V. Winch ESC (own buck from the pack), winch home switch, drive L/R PWM fallback.
EXPANSION, TEST POINTS, HOLES
Header for the planned second Pico: 5 V, 3V3, GND, I2C0, a UART pair and 4 GPIO.

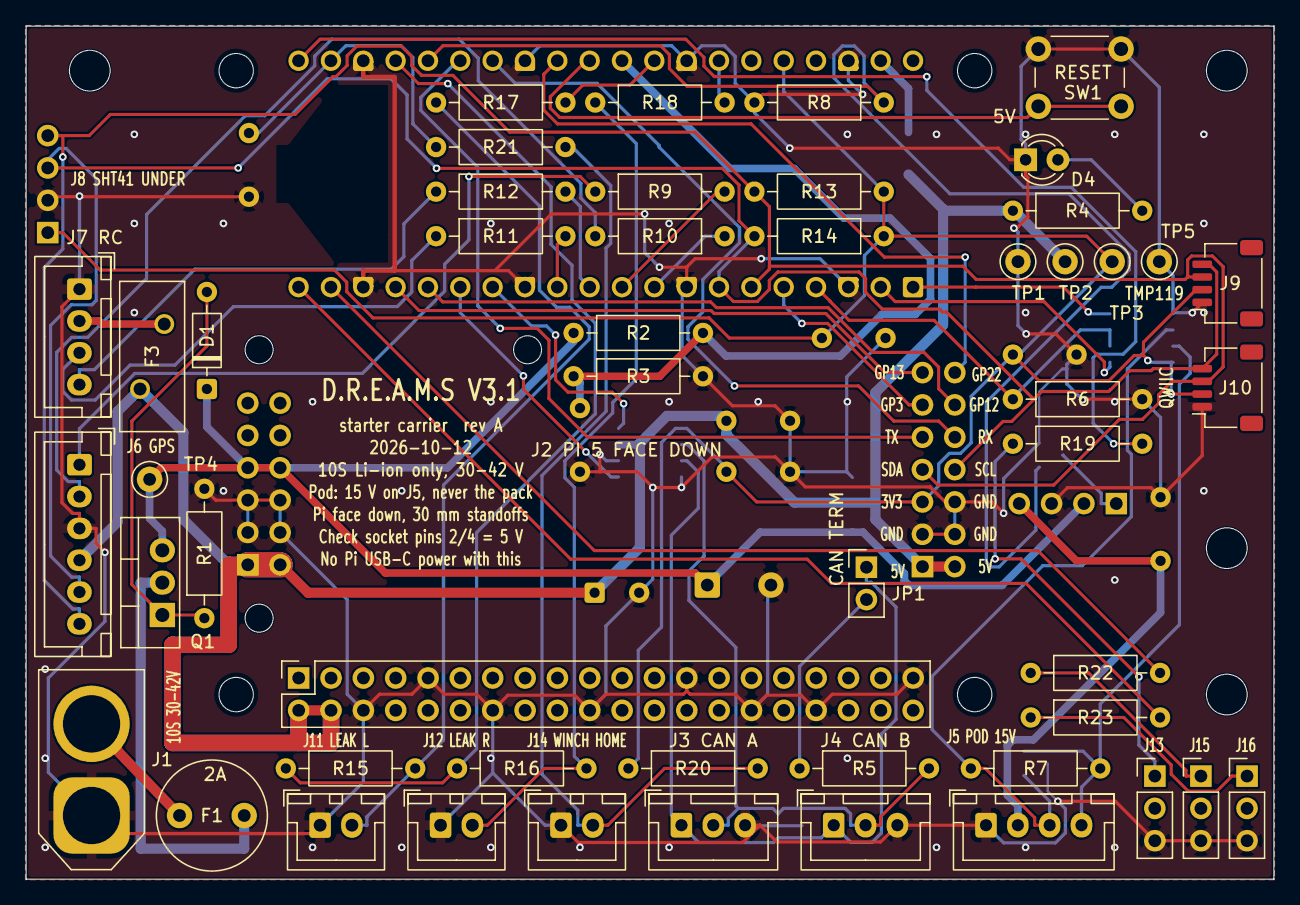
[picture p67: board Boat_PCB_V3_1.kicad_pcb from above]

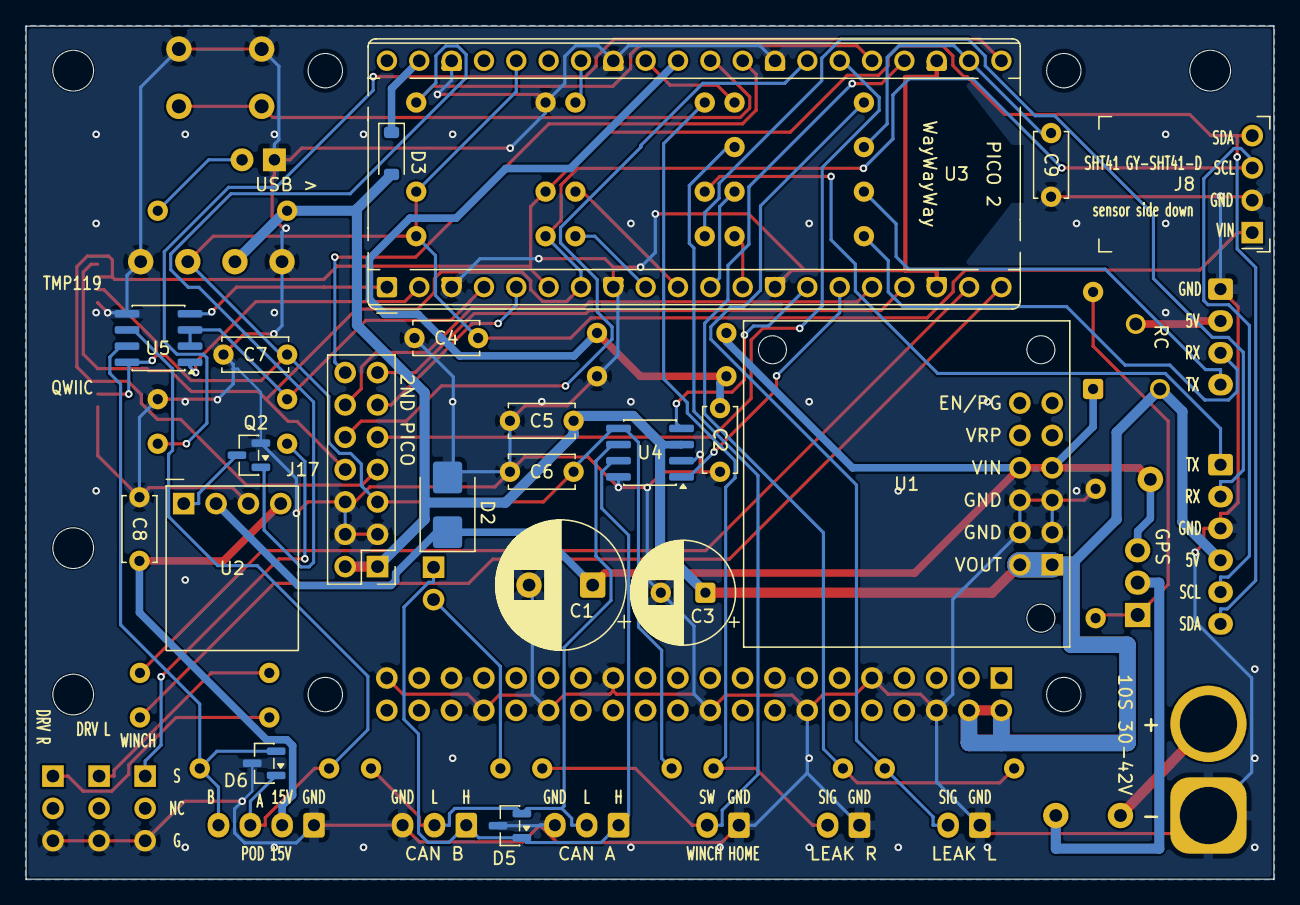
[picture p68: board Boat_PCB_V3_1.kicad_pcb from below]

Board: 2 copper layers, 98.0 x 67.0 mm, 75 parts (21 on the bottom side), 54 nets.
