ka1e27/dreams/Boat_PCB/Boat_PCB_V3/Boat_PCB_V3.kicad_pcb

## KiCad design Boat_PCB/Boat_PCB_V3/Boat_PCB_V3.kicad_pcb (2026-10-15, an earlier design)

Schematic: Boat_PCB_V3.kicad_sch

Parts:
A1: A4988 radar stepper; Pololu_Breakout-16_15.2x20.3mm
A2: Pololu D36V50F5 5V 5.5A; Pololu_D36V50F5
C1, C2, C25, C26: 470uF 35V; CP_Radial_D10.0mm_P5.00mm
C4, C9, C11, C12, C13, C14, C15, C16, C17, C18, C20, C21, C22, C31, C32, C34: 100nF 50V X7R; C_Disc_D5.0mm_W2.5mm_P5.00mm
C24: 10uF 25V X7R; C_Disc_D5.0mm_W2.5mm_P5.00mm
C28, C29: 22pF 50V C0G; C_Disc_D3.0mm_W1.6mm_P2.50mm
C30: 470uF 16V low-ESR 105C; CP_Radial_D8.0mm_P3.50mm
C33: 1uF 50V X7R; C_Disc_D5.0mm_W2.5mm_P5.00mm
D2: 1N5245B 15V; D_DO-35_SOD27_P7.62mm_Horizontal
D3, D4: SMBJ24A; D_SMB
D5: SMBJ5.0A; D_SMB
D6: NUP2105L; SOT-23
D7: green +5V; LED_D3.0mm
D8: green +3V3; LED_D3.0mm
D9: red WINCH ON; LED_D3.0mm
D10, D11: B5819W; D_SOD-123
F1: PTC 0.40A hold; Fuse_BelFuse_0ZRE0075FF_L11.5mm_W4.8mm
F2: PTC 1.25A hold; Fuse_BelFuse_0ZRE0125FF_L21.2mm_W5.3mm
F3: PTC 0.75A hold; Fuse_BelFuse_0ZRE0075FF_L11.5mm_W4.8mm
J1: GPS M10-25Q; JST_XH_B6B-XH-A_1x06_P2.50mm_Vertical
J2: Pod tether; JST_XH_B4B-XH-A_1x04_P2.50mm_Vertical
J3: CAN stub to VESCs; JST_XH_B3B-XH-A_1x03_P2.50mm_Vertical
J4: SHT45 external; JST_XH_B4B-XH-A_1x04_P2.50mm_Vertical
J5: Radar stepper motor; JST_XH_B4B-XH-A_1x04_P2.50mm_Vertical
J6: Status LED; JST_XH_B3B-XH-A_1x03_P2.50mm_Vertical
J7: SBUS RC receiver; JST_XH_B3B-XH-A_1x03_P2.50mm_Vertical
J8: Hull leak left; JST_XH_B2B-XH-A_1x02_P2.50mm_Vertical
J9: Hull leak right; JST_XH_B2B-XH-A_1x02_P2.50mm_Vertical
J10: Winch ESC; JST_XH_B2B-XH-A_1x02_P2.50mm_Vertical
J11: 12S HV tap (JST-VH); JST_VH_B2P-VH_1x02_P3.96mm_Vertical
J12: Raspberry Pi 5 GPIO; RaspberryPi_5_GPIO_Socket_2x20
J13: XT60 M18 ELECTRONICS; AMASS_XT60-M_1x02_P7.20mm_Vertical
J14: XT60 M18 WINCH; AMASS_XT60-M_1x02_P7.20mm_Vertical
J16: XT60-F WINCH ESC OUT (female); AMASS_XT60-F_1x02_P7.20mm_Vertical
JP1: CAN TERM; PinHeader_1x02_P2.54mm_Vertical
MH1, MH2, MH3, MH4: MountingHole; MountingHole_3.2mm_M3
Q1: IPP120P04P4L-03; TO-220-3_Vertical
Q2, Q3, Q4: BSS138; SOT-23
R7: 220k 1%; R_Axial_DIN0207_L6.3mm_D2.5mm_P10.16mm_Horizontal
R8: 13k 1%; R_Axial_DIN0207_L6.3mm_D2.5mm_P10.16mm_Horizontal
R9, R10, R15, R16, R17, R18, R21, R22, R23, R24, R25, R26, R27, R28, R29, R30, R31, R36, R62: 4.7k 1%; R_Axial_DIN0207_L6.3mm_D2.5mm_P10.16mm_Horizontal
R32: 10mR 1%; R_Shunt_Vishay_WSK2512_6332Metric_T1.19mm
R33: 2mR 1%; R_Shunt_Vishay_WSK2512_6332Metric_T1.19mm
R34, R35, R38, R39, R40, R42, R43, R44, R55, R60: 10k 1%; R_Axial_DIN0207_L6.3mm_D2.5mm_P10.16mm_Horizontal
R45: 330R 1%; R_Axial_DIN0207_L6.3mm_D2.5mm_P10.16mm_Horizontal
R46, R47, R48, R49, R50, R53: 1k 1%; R_Axial_DIN0207_L6.3mm_D2.5mm_P10.16mm_Horizontal
R54, R56, R57, R64, R65: 100k 1%; R_Axial_DIN0207_L6.3mm_D2.5mm_P10.16mm_Horizontal
R58: 1.5k 1%; R_Axial_DIN0207_L6.3mm_D2.5mm_P10.16mm_Horizontal
R59: 680R 1%; R_Axial_DIN0207_L6.3mm_D2.5mm_P10.16mm_Horizontal
R61, R63: 120R 1%; R_Axial_DIN0207_L6.3mm_D2.5mm_P10.16mm_Horizontal
R66, R67: 1k 1%; R_Axial_DIN0207_L6.3mm_D2.5mm_P2.54mm_Vertical
SW1: PICO A RESET; SW_PUSH_6mm
SW2: PICO B RESET; SW_PUSH_6mm
TP1, TP2: GND; TestPoint_Keystone_5000-5004_Miniature
TP3: +5V; TestPoint_Keystone_5000-5004_Miniature
TP4: +3V3; TestPoint_Keystone_5000-5004_Miniature
TP5: SDA; TestPoint_Keystone_5000-5004_Miniature
TP6: SCL; TestPoint_Keystone_5000-5004_Miniature
U1, U14: Raspberry Pi Pico 2; RaspberryPi_Pico_Socketed_THT
U2: TCA9548A I2C mux; TSSOP-24_4.4x7.8mm_P0.65mm
U3: TJA1051T/3 CAN xcvr; SOIC-8_3.9x4.9mm_P1.27mm
U4: BNO085; LGA-28_5.2x3.8mm_P0.5mm
U5: ADXL375; LGA-14_3x5mm_P0.8mm_LayoutBorder1x6y
U6: BMP390 breakout; BMP390
U7: BH1750FVI-TR; XDCR_BH1750FVI-TR
U8: SHT45 internal; Sensirion_DFN-4_1.5x1.5mm_P0.8mm_SHT4x_NoCentralPad
U10: INA228 electronics; MSOP-10_3x3mm_P0.5mm
U11: INA228 winch; MSOP-10_3x3mm_P0.5mm
U12: 74AHCT1G125; SOT-23-5
U13: THVD2410; SOIC-8_3.9x4.9mm_P1.27mm
Y1: 32.768kHz CL=12.5pF 50ppm; Crystal_SMD_3215-2Pin_3.2x1.5mm

Connections:
+3V3: A1.2 (VDD), A1.13 (~RESET), C11.1, C12.1, C14.1, C15.1, C16.1, C17.1, C18.1, C20.1, C21.1, C22.1, C24.1, C33.1, C34.1, J1.4 (V), J4.2 (3V3), R9.1, R10.1, R15.1, R16.1, R17.1, R18.1, R21.1, R22.1, R23.1, R24.1, R25.1, R26.1, R27.1, R28.1, R29.1, R30.1, R31.1, R38.1, R39.1, R40.1, R42.1, R43.1, R44.1, R55.1, R59.1, TP4.1, U1.36 (3V3), U2.24 (VCC), U3.5 (VIO), U4.3 (VDD), U4.18 (~H_CS), U4.28 (VDDIO), U5.1 (Vdd_I/O), U5.3 (RES), U5.6 (Vs), U5.7 (~CS), U6.CS, U6.VIN, U7.1 (VCC), U7.5 (DVI), U8.3 (VDD), U10.2 (A0), U10.6 (VS), U11.1 (A1), U11.6 (VS), U13.8 (VCC)
+5V: A2.1 (VOUT), A2.2 (VOUT), C9.1, C30.1, C31.1, C32.1, D5.1 (K), D10.2 (A), D11.2 (A), F2.1, F3.1, J12.2 (5V), J12.4 (5V), R58.1, TP3.1, U3.3 (VCC), U12.5 (VCC)
/+VWINCH: C2.1, D2.1 (K), Q1.3 (S), R33.4, R34.1
/ADXL_INT1: U5.8 (INT1), U14.25 (GPIO19)
/ADXL_INT2: U5.9 (INT2), U14.26 (GPIO20)
/BH_ADDR: R54.1, U7.2 (ADDR)
/CANH: J3.1 (CANH), R61.1, U3.7 (CANH)
/CANL: J3.2 (CANL), JP1.2 (B), U3.6 (CANL)
/CAN_RX: U1.19 (GPIO14), U3.4 (RXD)
/CAN_TERM: JP1.1 (A), R61.2
/CAN_TX: U1.20 (GPIO15), U3.1 (TXD)
/CH0_SCL: R16.2, U2.5 (SC0), U4.19 (H_SCL/SCK/RX)
/CH0_SDA: R15.2, U2.4 (SD0), U4.20 (H_SDA/H_MISO/TX)
/CH1_SCL: R18.2, U2.7 (SC1), U5.14 (SCL/SCLK)
/CH1_SDA: R17.2, U2.6 (SD1), U5.13 (SDA/SDI/SDIO)
/CH3_SCL: R22.2, U2.11 (SC3), U7.6 (SCL)
/CH3_SDA: R21.2, U2.10 (SD3), U7.4 (SDA)
/CH4_SCL: R24.2, U2.14 (SC4), U8.2 (SCL)
/CH4_SDA: R23.2, U2.13 (SD4), U8.1 (SDA)
/CH5_SCL: J4.4 (SCL), R26.2, U2.16 (SC5)
/CH5_SDA: J4.3 (SDA), R25.2, U2.15 (SD5)
/CH6_SCL: R28.2, U2.18 (SC6), U10.5 (SCL), U11.5 (SCL)
/CH6_SDA: R27.2, U2.17 (SD6), U10.4 (SDA), U11.4 (SDA)
/CH7_SCL: J1.5 (SCL), R30.2, U2.20 (SC7)
/CH7_SDA: J1.6 (SDA), R29.2, U2.19 (SD7)
/ELEC_SHUNT_N: R32.3, U10.8 (Vbus), U10.9 (Vin-)
/ELEC_SHUNT_P: R32.2, U10.10 (Vin+)
/ENV_SCL: R43.2, U4.15 (ENV_SCL)
/ENV_SDA: R44.2, U4.16 (ENV_SDA)
/GPS_RX: R50.1, U14.6 (GPIO4)
/GPS_RX_EXT: J1.2 (RX), R50.2
/GPS_TX: R49.2, U14.7 (GPIO5)
/GPS_TX_EXT: J1.1 (TX), R49.1
/I2C_SCL: R10.2, TP6.1, U2.22 (SCL), U14.17 (GPIO13)
/I2C_SDA: R9.2, TP5.1, U2.23 (SDA), U14.16 (GPIO12)
/IMU_BOOTN: R55.2, U4.4 (~BOOT)
/IMU_CAP: C13.1, U4.9 (CAP)
/IMU_INT: U4.14 (~H_INT), U14.11 (GPIO8)
/IMU_RST: R39.2, U4.11 (~RST), U14.12 (GPIO9)
/IMU_XIN: C28.1, U4.27 (XIN32), Y1.1
/IMU_XOUT: C29.1, U4.26 (XOUT32/CLKSEL1), Y1.2
/INA_ALERT: R31.2, U10.3 (~Alert), U11.3 (~Alert), U14.10 (GPIO7)
/LEAK_EXC: R56.1, R57.1, U1.29 (GPIO22)
/LEAK_L: R46.1, R56.2, U1.32 (GPIO27_ADC1)
/LEAK_L_EXT: J8.2 (LEAK), R46.2
/LEAK_R: R47.1, R57.2, U1.34 (GPIO28_ADC2)
/LEAK_R_EXT: J9.2 (LEAK), R47.2
/LED_5V: F2.2, J6.2 (5V)
/LED_DIN: U1.14 (GPIO10), U12.2
/LED_DIN_5V: R45.1, U12.4
/LED_DIN_EXT: J6.3 (DIN), R45.2
/LED_P3V3: D8.2 (A), R59.2
/LED_P5V: D7.2 (A), R58.2
/LED_WINCH: D9.2 (A), R60.2
/LINK_A2B: U1.26 (GPIO20), U14.15 (GPIO11)
/LINK_B2A: U1.27 (GPIO21), U14.14 (GPIO10)
/MUX_RST: R38.2, U2.3 (~RESET), U14.19 (GPIO14)
/PACK_ADC: C4.1, R7.2, R8.1, U1.31 (GPIO26_ADC0)
/PACK_RAW: J11.2 (VIN), R7.1
/PICO_A_RUN: Q3.3 (D), SW1.2, U1.30 (RUN)
/PICO_A_RX: R66.2, U1.22 (GPIO17)
/PICO_A_TX: R67.2, U1.21 (GPIO16)
/PICO_A_VSYS: D10.1 (K), U1.39 (VSYS)
/PICO_B_RUN: Q4.3 (D), SW2.2, U14.30 (RUN)
/PICO_B_VSYS: D11.1 (K), U14.39 (VSYS)
/PI_RST_A: J12.16 (GPIO23), Q3.1 (G), R64.1
/PI_RST_B: J12.18 (GPIO24), Q4.1 (G), R65.1
/PI_RX: J12.10 (GPIO15_RXD), R67.1
/PI_TX: J12.8 (GPIO14_TXD), R66.1
/POD_15V: F1.2, J2.2 (VPACK)
/PWR_GOOD: A2.12 (PG), R42.2, U1.15 (GPIO11)
/SBUS: R48.1, U1.2 (GPIO1)
/SBUS_5V: F3.2, J7.2 (5V)
/SBUS_EXT: J7.3 (SBUS), R48.2
/SH_ELEC_P: J13.2 (+), R32.1
/SH_WINCH_P: J14.2 (+), R33.1
/STEP: A1.15 (STEP), U1.5 (GPIO3)
/STEP_DIR: A1.16 (DIR), U1.4 (GPIO2)
/STEP_EN: A1.9 (~ENABLE), R40.2, U1.11 (GPIO8)
/STEP_MS1: A1.10 (MS1), U1.10 (GPIO7)
/STEP_MS2: A1.11 (MS2), U1.9 (GPIO6)
/STEP_MS3: A1.12 (MS3), U1.7 (GPIO5)
/STEP_SLEEP: A1.14 (~SLEEP), U1.6 (GPIO4)
/ST_1A: A1.4 (1A), J5.1 (1A)
/ST_1B: A1.3 (1B), J5.2 (1B)
/ST_2A: A1.5 (2A), J5.3 (2A)
/ST_2B: A1.6 (2B), J5.4 (2B)
/TETHER_A: D6.1 (K), J2.3 (A), R63.1, U13.6 (A)
/TETHER_B: D6.2 (K), J2.4 (B), R63.2, U13.7 (B)
/TETHER_DE: R62.1, U13.2 (~RE), U13.3 (DE), U14.24 (GPIO18)
/TETHER_RX: U13.1 (RO), U14.22 (GPIO17)
/TETHER_TX: U13.4 (DI), U14.21 (GPIO16)
/WINCH_GATE: D2.2 (A), Q1.1 (G), R34.2, R35.1
/WINCH_GDRV: Q2.3 (D), R35.2
/WINCH_KILL: Q2.1 (G), R36.1, U1.12 (GPIO9)
/WINCH_PWM: R53.1, U1.1 (GPIO0)
/WINCH_PWM_EXT: J10.2 (PWM), R53.2
/WINCH_SHUNT_N: R33.3, U11.8 (Vbus), U11.9 (Vin-)
/WINCH_SHUNT_P: R33.2, U11.10 (Vin+)
/WINCH_SW: C26.1, D4.1 (K), J16.2 (+), Q1.2 (D), R60.1
GND: A1.1 (GND), A1.7 (GND), A2.3 (GND), A2.4 (GND), A2.5 (GND), A2.6 (GND), C1.2, C2.2, C4.2, C9.2, C11.2, C12.2, C13.2, C14.2, C15.2, C16.2, C17.2, C18.2, C20.2, C21.2, C22.2, C24.2, C25.2, C26.2, C28.2, C29.2, C30.2, C31.2, C32.2, C33.2, C34.2, D3.2 (A), D4.2 (A), D5.2 (A), D6.3 (A), D7.1 (K), D8.1 (K), D9.1 (K), J1.3 (GND), J2.1 (GND), J3.3 (GND), J4.1 (GND), J6.1 (GND), J7.1 (GND), J8.1 (GND), J9.1 (GND), J10.1 (GND), J11.1 (GND), J12.6 (GND), J12.9 (GND), J12.14 (GND), J12.20 (GND), J12.25 (GND), J12.30 (GND), J12.34 (GND), J12.39 (GND), J13.1 (-), J14.1 (-), J16.1 (-), Q2.2 (S), Q3.2 (S), Q4.2 (S), R8.2, R36.2, R54.2, R62.2, R64.2, R65.2, SW1.1, SW2.1, TP1.1, TP2.1, U1.3 (GND), U1.8 (GND), U1.13 (GND), U1.18 (GND), U1.23 (GND), U1.28 (GND), U1.33 (AGND), U1.38 (GND), U2.1 (A0), U2.2 (A1), U2.12 (GND), U2.21 (A2), U3.2 (GND), U3.8 (S), U4.2 (GND), U4.5 (PS1), U4.6 (PS0/WAKE), U4.10 (CLKSEL0), U4.17 (SA0/H_MOSI), U4.25 (GNDIO), U5.2 (GND), U5.4 (GND), U5.5 (GND), U5.11 (RES), U5.12 (SDO/ADDR), U6.GND, U6.SDO, U7.3 (GND), U8.4 (VSS), U10.1 (A1), U10.7 (GND), U11.2 (A0), U11.7 (GND), U12.1, U12.3 (GND), U13.5 (GND), U14.3 (GND), U14.8 (GND), U14.13 (GND), U14.18 (GND), U14.23 (GND), U14.28 (GND), U14.33 (AGND), U14.38 (GND); also elsewhere on the board
unnamed: U6.INT, U14.9 (GPIO6)
unnamed: U2.9 (SC2), U6.SCL
unnamed: U2.8 (SD2), U6.SDA

Notes on the sheet:
CARRIER - COMPUTE & BUS
CARRIER - ON-BOARD SENSORS
CARRIER - CURRENT SENSE (M18 domains only; the 12S drive rail is voltage-only, and the VESCs already report per-motor current over CAN)
BATTERY SENSE - 12S LiPo tap 220k/13k = 17.9x (50.4V), elec + winch 68k/10k = 7.8x (2.69 V at 21 V), plus a 1k series into each ADC pin. R1/R2/R13 removed with the drive shunt: the 12S rail is voltage-only now, on J11.
CAPACITORS - 470uF bulk per M18 pack; 100nF ADC filters (V2 had none). The 12S tap filter cap is C4 at Pico A's ADC0 pin; J11 is JST-VH so no signal plug can mate with it.
CONNECTORS - JST-XH for signals, JST-VH for the 12S tap, XT60 for packs; J16 is female (switched output)
M18 PACK INPUTS - XT60 (pin 1 = notched end = negative, per the XT60 convention) + in-line Kelvin shunts; the sense pins have their own nets (ELEC/WINCH_SHUNT_P/N). Drive is sensed off-board: its pack never reaches this carrier.
WINCH KILL PATH - high-side P-FET, fail-safe OFF, feeding the ESC on J16
DECOUPLING - 100nF per supply pin; C13 is the BNO085 internal-LDO cap (required)
RAIL BULK + STEPPER MOTOR BULK
I2C PULL-UPS - 4.7k pair on every used TCA9548A channel except CH2, where the BMP390 breakout (U6) has its own (a mux isolates the channels, so the upstream pair does not serve them)
POD PCB - separate board, here for reference only. Tether pin 2 carries the electronics pack voltage (M18, 15-21 V) through F1; the pod makes its own 5 V.
REV C ADDITIONS (2026-09-24 review) - every part here connects through net labels
PROTECTION - TVS on both pack rails (also a reverse-polarity crowbar that blows the pack fuse), +5V over-voltage clamp, Q1 gate clamp, tether TVS (24 V NUP2105L, D6)
SERIES RESISTORS ON EVERY OFF-BOARD SIGNAL (brief rule) - GPS UART and winch ESC PWM. The pod tether is RS-485 now (U13, see TETHER RS-485), which needs none
WS2812 LEVEL SHIFT (3.3 V Pico A -> 5 V LED data) + SENSOR STRAPS
HULL LEAK - probes on Pico A's ADC1/ADC2 (GP27/GP28), excited from GP22 only while sampling (reads fresh water, limits probe electrolysis)
BRING-UP - test points, power LEDs, WINCH ON LED, optional CAN termination (fit JP1 only if this node ends the bus)
TETHER RS-485 (2026-09-25, Pico B since 2026-10-13) - half duplex on Pico B's UART0 (TX GP16, RX GP17); GP18 drives DE and ~RE together (high = transmit); R62 holds receive mode through reset; 120R termination at this end of the tether.
TWO PICO 2s (replaced the Teensy 4.1, 2026-10-13)
Pico A (U1, next to the Pi header): control. CAN on the PIO (can2040), SBUS, winch PWM + kill, stepper, WS2812, leak probes, 12S ADC. Pico B (U14, here): sensors. TCA9548A I2C mux, GPS, pod RS-485. A UART link joins them: LINK_A2B / LINK_B2A. Both sit socketed under the carrier, each with a USB cab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
PI LINK (rev E, 2026-10-13)
Pi UART0 (GPIO14 TX / GPIO15 RX, header pins 8 / 10) to Pico A GP17 / GP16 (its UART0 RX / TX). R66 / R67 (1k) in those lines stop either end back-powering the other through its pin. Pico A's UART0 can't also take SBUS on GP1: run SBUS or this link on the PIO. Pi GPIO23 / GPIO24 (header pins 16 / 1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
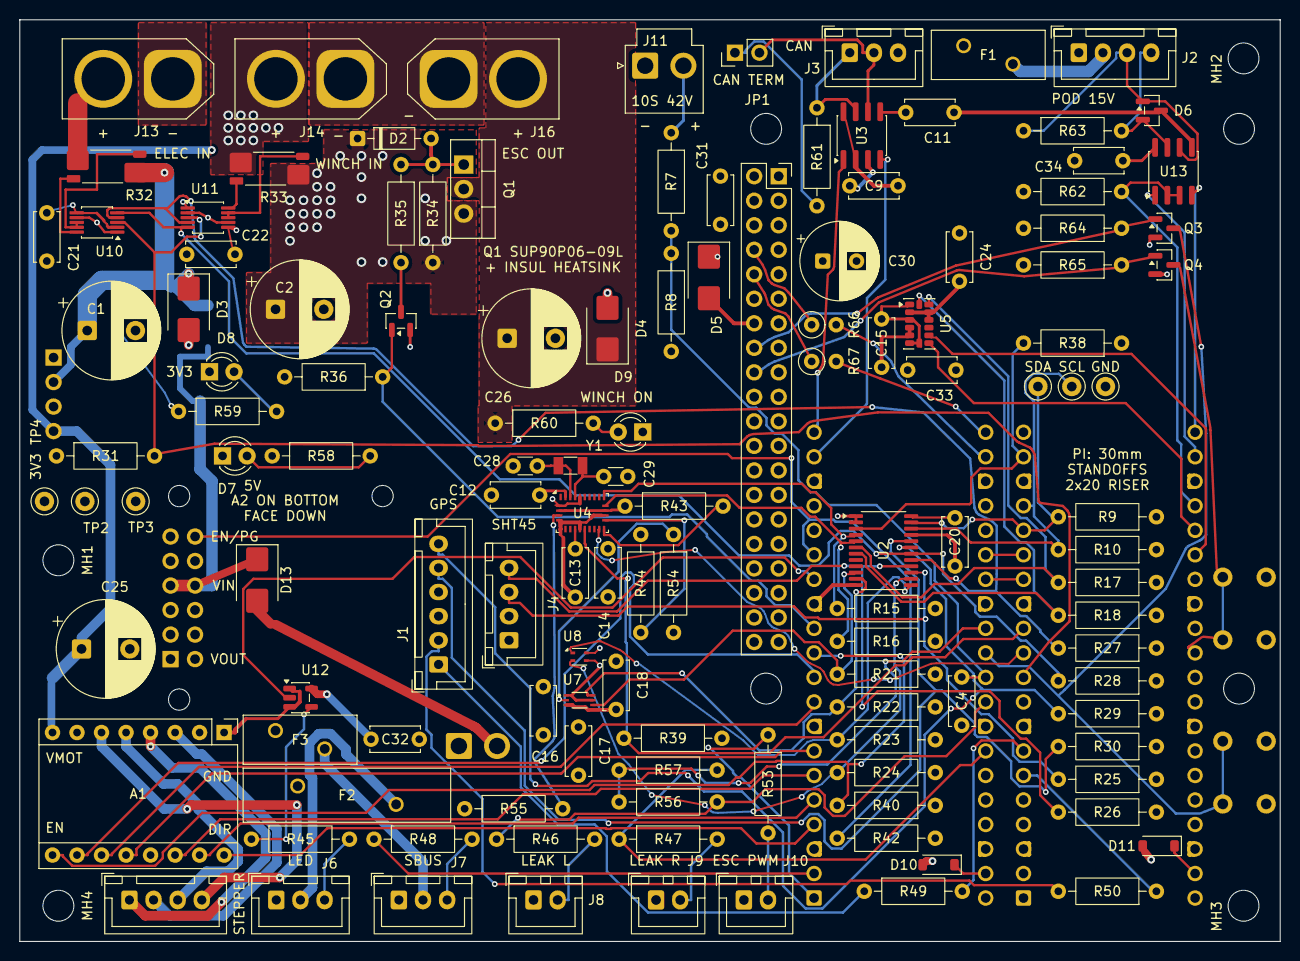
[picture p69: board Boat_PCB_V3.kicad_pcb from above]

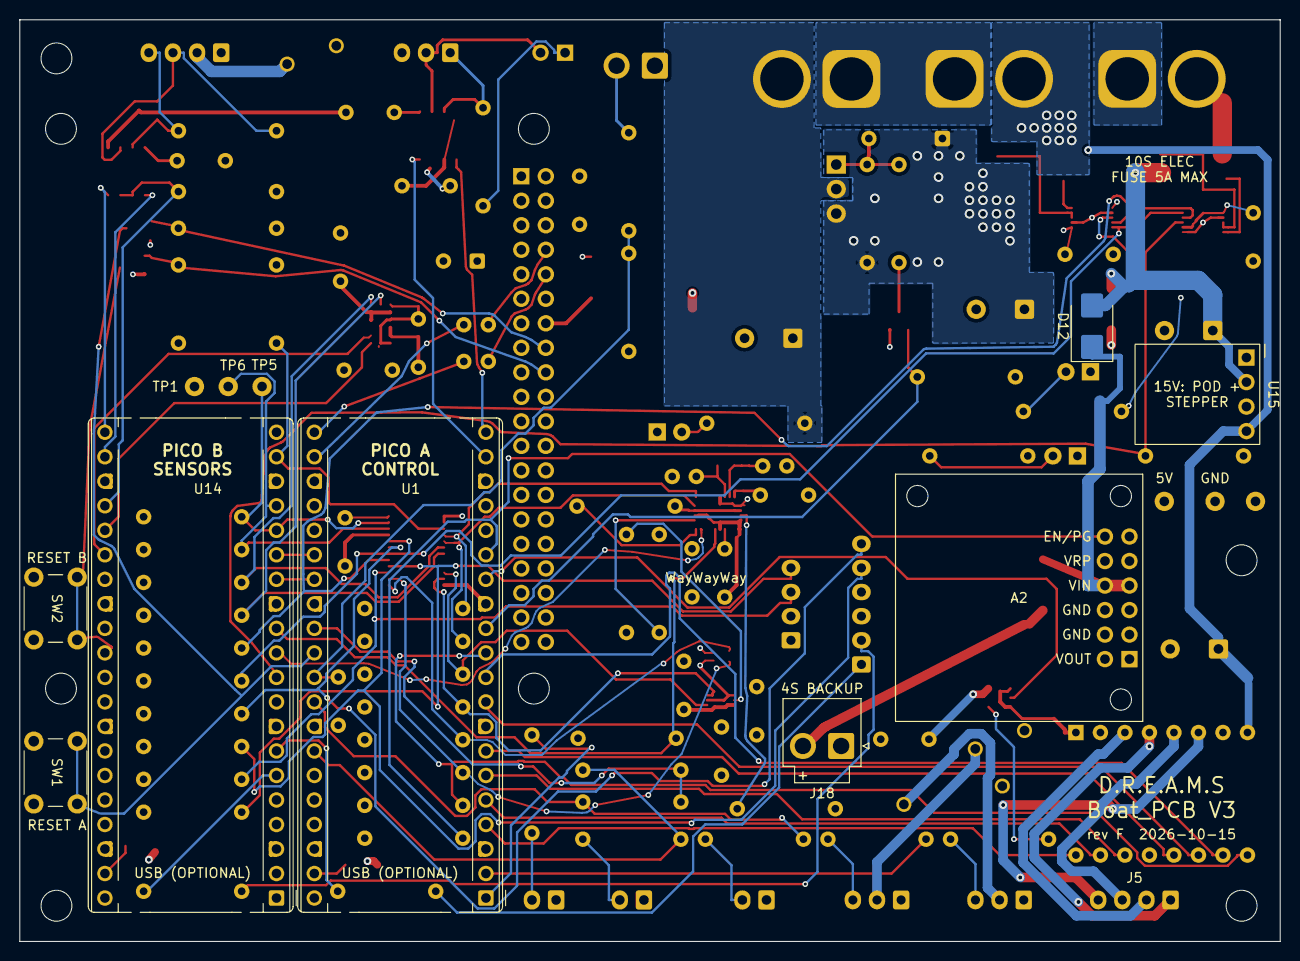
[picture p70: board Boat_PCB_V3.kicad_pcb from below]

Board: 4 copper layers, 130.6 x 95.5 mm, 140 parts (8 on the bottom side), 105 nets.

Other parts of the board:
D12, D13: B360B; D_SMB
J18: 4S backup (JST-VH); JST_VH_B2P-VH_1x02_P3.96mm_Vertical
U15: Pololu D36V6F15 15V 600mA; Pololu_D36V6F5

Their connections:
/+VBACKUP: D13.2, J18.2
GND: J18.1, U15.3; also elsewhere on the board
