ka1e27/dreams/Boat_PCB/Pod_PCB_V3/Pod_PCB_V3.kicad_pcb

## KiCad design Boat_PCB/Pod_PCB_V3/Pod_PCB_V3.kicad_pcb (2026-10-14)

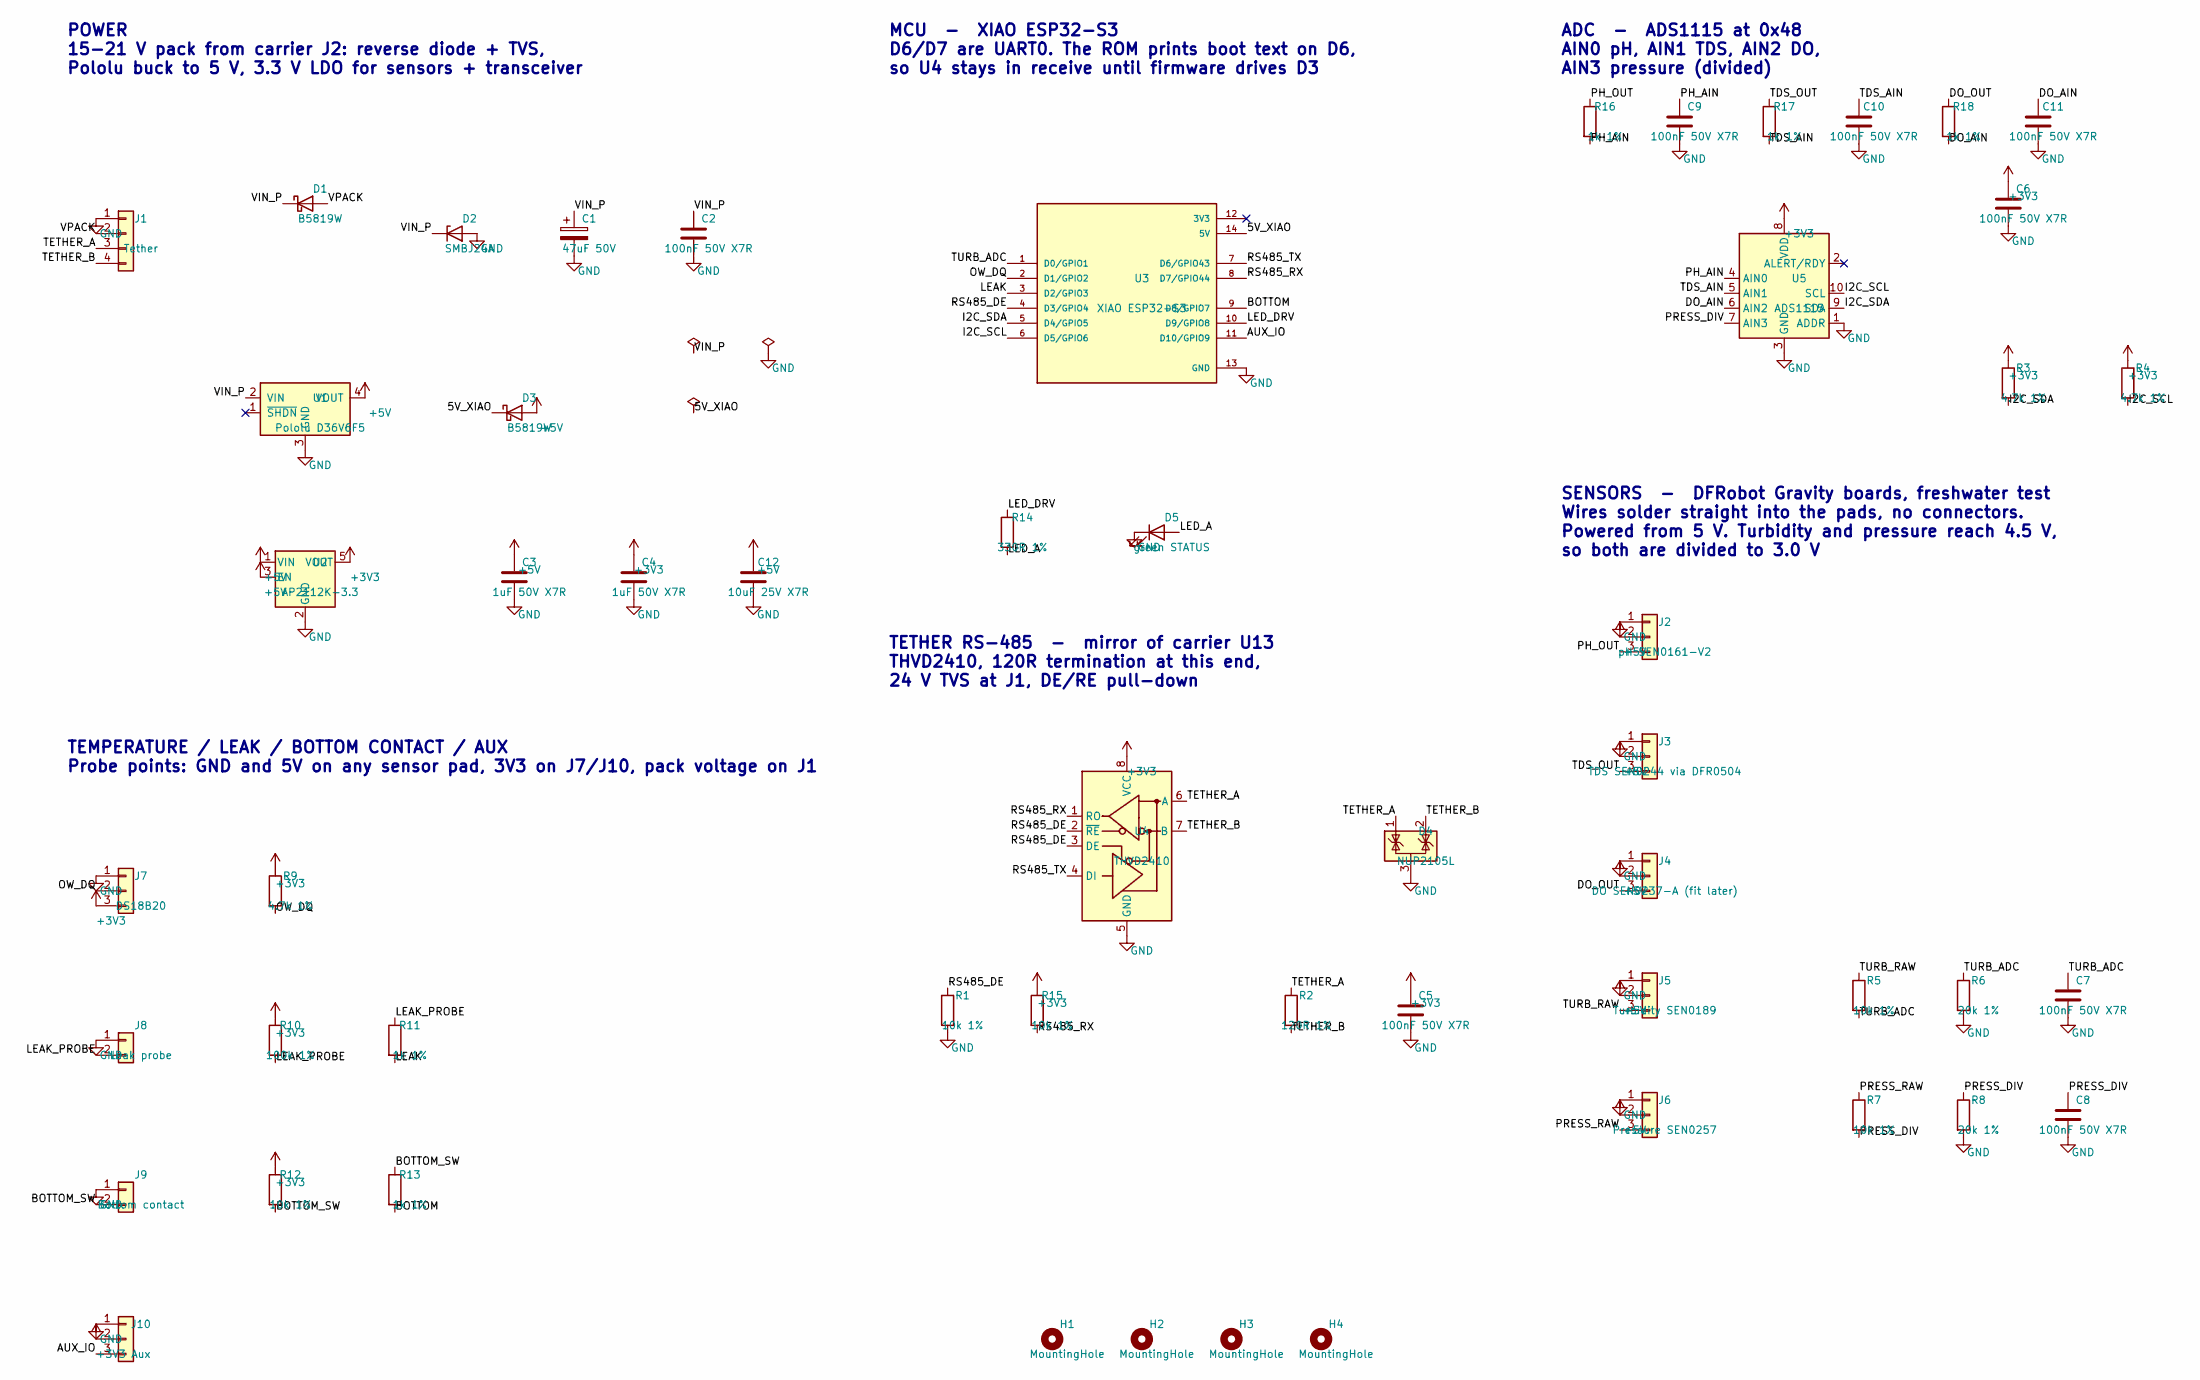
[picture p71: schematic Pod_PCB_V3.kicad_sch, D.R.E.A.M.S V3 pod]

Parts:
C1: 47uF 50V; CP_Radial_D6.3mm_P2.50mm
C2, C5, C6, C7, C8, C9, C10, C11: 100nF 50V X7R; C_Disc_D5.0mm_W2.5mm_P5.00mm
C3, C4: 1uF 50V X7R; C_Disc_D5.0mm_W2.5mm_P5.00mm
C12: 10uF 25V X7R; C_Disc_D5.0mm_W2.5mm_P5.00mm
D1, D3: B5819W; D_SOD-123
D2: SMBJ24A; D_SMB
D4: NUP2105L; SOT-23
D5: green STATUS; LED_D3.0mm
H1, H2, H3, H4: MountingHole; MountingHole_3.2mm_M3
J1: Tether; SolderWire_1x04_P2.54mm_D1.0mm
J2: pH SEN0161-V2; SolderWire_1x03_P2.54mm_D1.0mm
J3: TDS SEN0244 via DFR0504; SolderWire_1x03_P2.54mm_D1.0mm
J4: DO SEN0237-A (fit later); SolderWire_1x03_P2.54mm_D1.0mm
J5: Turbidity SEN0189; SolderWire_1x03_P2.54mm_D1.0mm
J6: Pressure SEN0257; SolderWire_1x03_P2.54mm_D1.0mm
J7: DS18B20; SolderWire_1x03_P2.54mm_D1.0mm
J8: Leak probe; SolderWire_1x02_P2.54mm_D1.0mm
J9: Bottom contact; SolderWire_1x02_P2.54mm_D1.0mm
J10: Aux; SolderWire_1x03_P2.54mm_D1.0mm
R1, R5, R7, R12, R15: 10k 1%; R_Axial_DIN0207_L6.3mm_D2.5mm_P10.16mm_Horizontal
R2: 120R 1%; R_Axial_DIN0207_L6.3mm_D2.5mm_P10.16mm_Horizontal
R3, R4, R9: 4.7k 1%; R_Axial_DIN0207_L6.3mm_D2.5mm_P10.16mm_Horizontal
R6, R8: 20k 1%; R_Axial_DIN0207_L6.3mm_D2.5mm_P10.16mm_Horizontal
R10: 100k 1%; R_Axial_DIN0207_L6.3mm_D2.5mm_P10.16mm_Horizontal
R11, R13, R16, R17, R18: 1k 1%; R_Axial_DIN0207_L6.3mm_D2.5mm_P10.16mm_Horizontal
R14: 330R 1%; R_Axial_DIN0207_L6.3mm_D2.5mm_P10.16mm_Horizontal
U1: Pololu D36V6F5; Pololu_D36V6F5
U2: AP2112K-3.3; SOT-23-5
U3: XIAO ESP32-S3; MODULE_XIAO_ESP32_S3
U4: THVD2410; SOIC-8_3.9x4.9mm_P1.27mm
U5: ADS1115; MSOP-10_3x3mm_P0.5mm

Connections:
+3V3: C4.1, C5.1, C6.1, J7.3 (VDD), J10.2 (3V3), R3.1, R4.1, R9.1, R10.1, R12.1, R15.1, U2.5 (VOUT), U4.8 (VCC), U5.8 (VDD)
+5V: C3.1, C12.1, D3.2 (A), J2.2 (VCC), J3.2 (VCC), J4.2 (VCC), J5.2 (VCC), J6.2 (VCC), U1.4 (VOUT), U2.1 (VIN), U2.3 (EN)
/5V_XIAO: D3.1 (K), U3.14 (5V)
/AUX_IO: J10.3 (IO), U3.11 (D10/GPIO9)
/BOTTOM: R13.2, U3.9 (D8/GPIO7)
/BOTTOM_SW: J9.2 (SW), R12.2, R13.1
/DO_AIN: C11.1, R18.2, U5.6 (AIN2)
/DO_OUT: J4.3 (SIG), R18.1
/I2C_SCL: R4.2, U3.6 (D5/GPIO6), U5.10 (SCL)
/I2C_SDA: R3.2, U3.5 (D4/GPIO5), U5.9 (SDA)
/LEAK: R11.2, U3.3 (D2/GPIO3)
/LEAK_PROBE: J8.2 (LEAK), R10.2, R11.1
/LED_A: D5.2 (A), R14.2
/LED_DRV: R14.1, U3.10 (D9/GPIO8)
/OW_DQ: J7.2 (DQ), R9.2, U3.2 (D1/GPIO2)
/PH_AIN: C9.1, R16.2, U5.4 (AIN0)
/PH_OUT: J2.3 (SIG), R16.1
/PRESS_DIV: C8.1, R7.2, R8.1, U5.7 (AIN3)
/PRESS_RAW: J6.3 (SIG), R7.1
/RS485_DE: R1.1, U3.4 (D3/GPIO4), U4.2 (~RE), U4.3 (DE)
/RS485_RX: R15.2, U3.8 (D7/GPIO44), U4.1 (RO)
/RS485_TX: U3.7 (D6/GPIO43), U4.4 (DI)
/TDS_AIN: C10.1, R17.2, U5.5 (AIN1)
/TDS_OUT: J3.3 (SIG), R17.1
/TETHER_A: D4.1 (K), J1.3 (A), R2.1, U4.6 (A)
/TETHER_B: D4.2 (K), J1.4 (B), R2.2, U4.7 (B)
/TURB_ADC: C7.1, R5.2, R6.1, U3.1 (D0/GPIO1)
/TURB_RAW: J5.3 (SIG), R5.1
/VIN_P: C1.1, C2.1, D1.1 (K), D2.1 (K), U1.2 (VIN)
/VPACK: D1.2 (A), J1.2 (VPACK)
GND: C1.2, C2.2, C3.2, C4.2, C5.2, C6.2, C7.2, C8.2, C9.2, C10.2, C11.2, C12.2, D2.2 (A), D4.3 (A), D5.1 (K), J1.1 (GND), J2.1 (GND), J3.1 (GND), J4.1 (GND), J5.1 (GND), J6.1 (GND), J7.1 (GND), J8.1 (GND), J9.1 (GND), J10.1 (GND), R1.2, R6.2, R8.2, U1.3 (GND), U2.2 (GND), U3.13 (GND), U4.5 (GND), U5.1 (ADDR), U5.3 (GND)

Notes on the sheet:
POWER 15-21 V pack from carrier J2: reverse diode + TVS, Pololu buck to 5 V, 3.3 V LDO for sensors + transceiver
MCU - XIAO ESP32-S3 D6/D7 are UART0. The ROM prints boot text on D6, so U4 stays in receive until firmware drives D3
TETHER RS-485 - mirror of carrier U13 THVD2410, 120R termination at this end, 24 V TVS at J1, DE/RE pull-down
ADC - ADS1115 at 0x48 AIN0 pH, AIN1 TDS, AIN2 DO, AIN3 pressure (divided)
SENSORS - DFRobot Gravity boards, freshwater test Wires solder straight into the pads, no connectors. Powered from 5 V. Turbidity and pressure reach 4.5 V, so both are divided to 3.0 V
TEMPERATURE / LEAK / BOTTOM CONTACT / AUX Probe points: GND and 5V on any sensor pad, 3V3 on J7/J10, pack voltage on J1

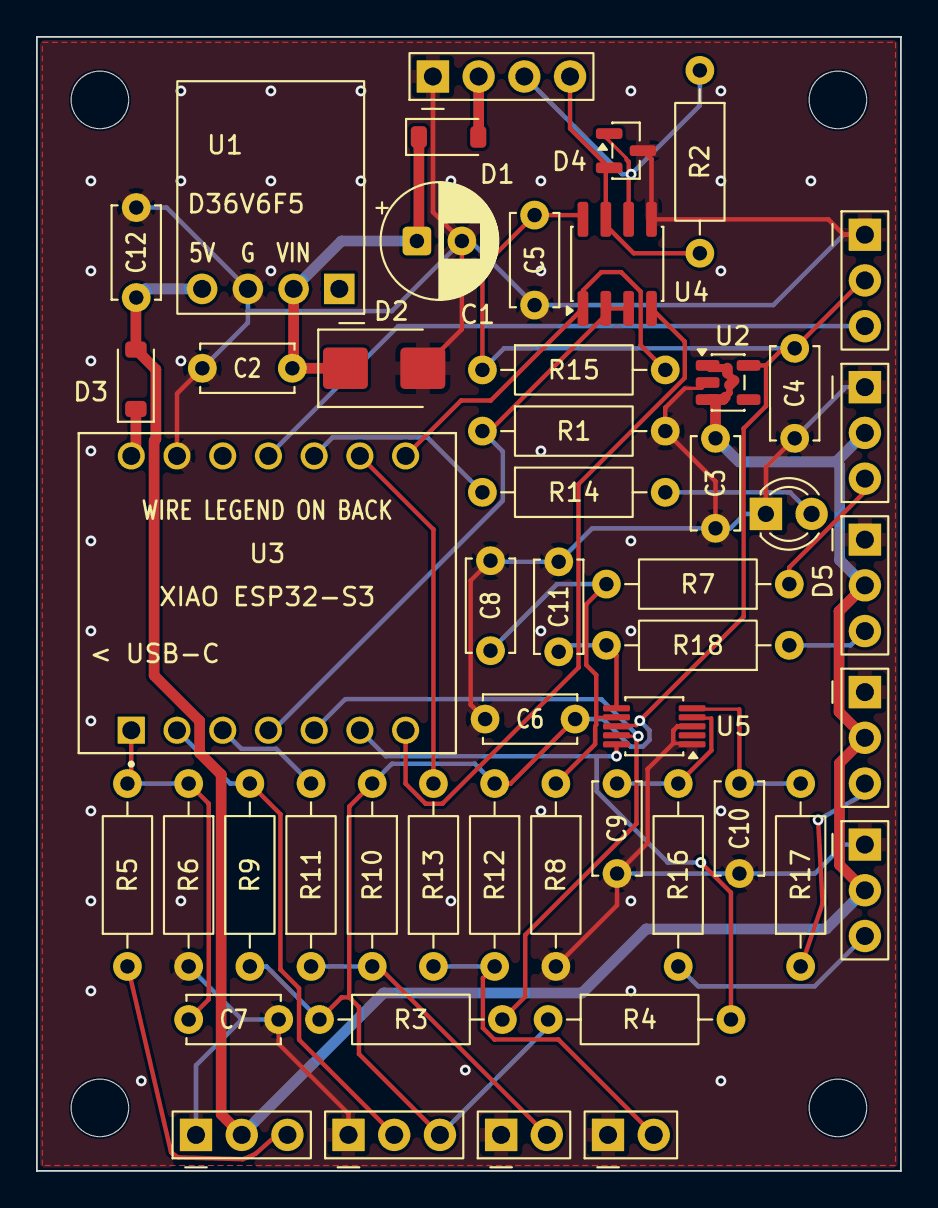
[picture p72: board Pod_PCB_V3.kicad_pcb from above]

Board: 2 copper layers, 48.0 x 63.0 mm, 54 parts (0 on the bottom side), 31 nets.
