ka1e27/dreams/Boat_PCB/Boat_PCB.kicad_pcb

## KiCad design Boat_PCB/Boat_PCB.kicad_pcb (2026-07-22)

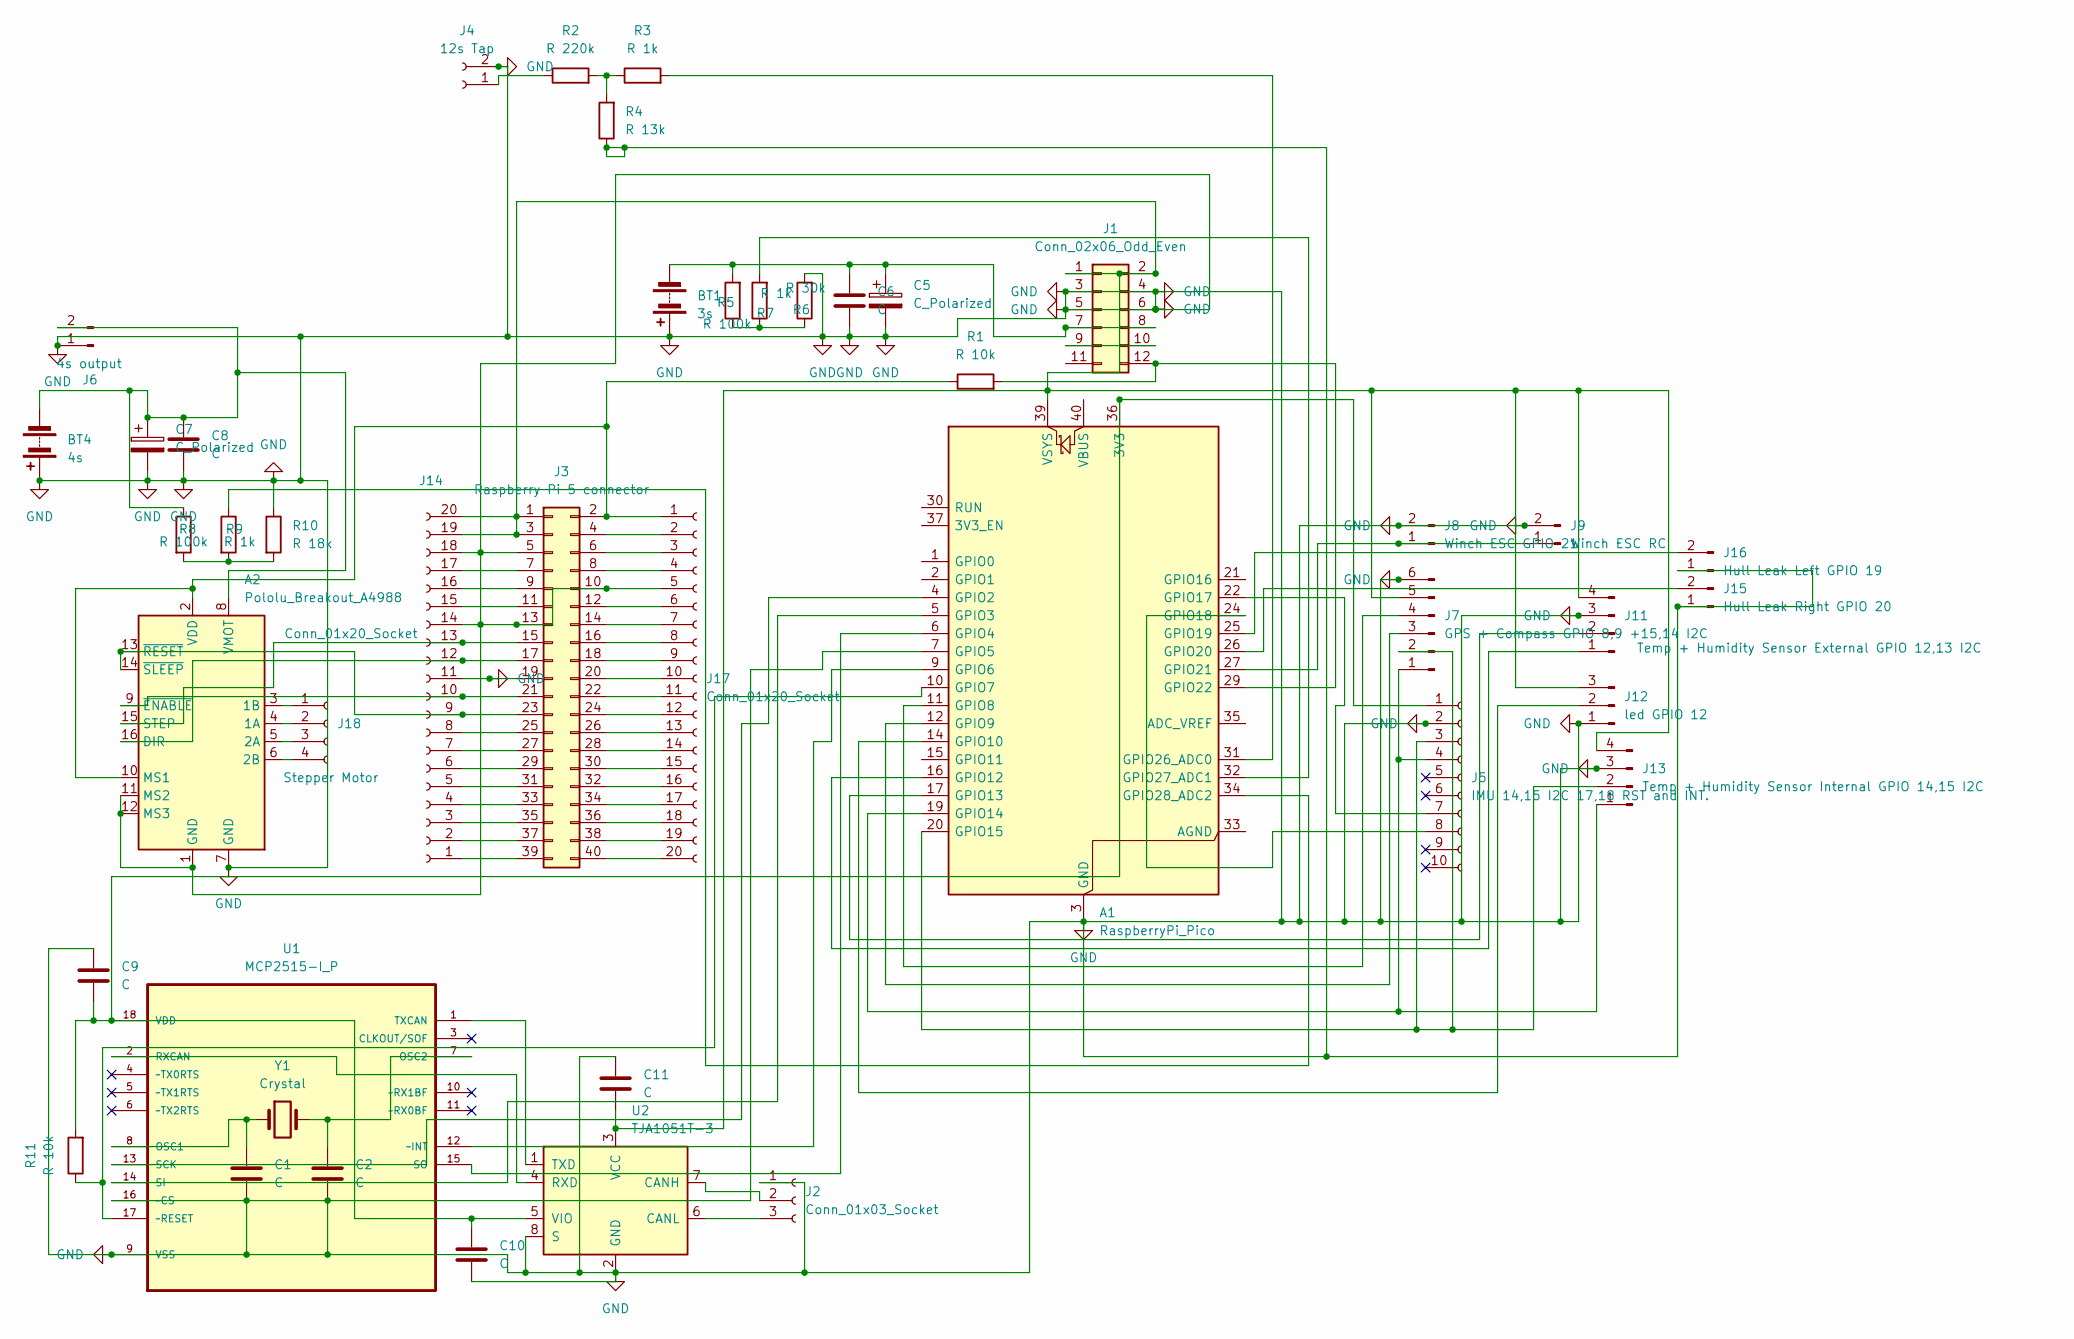
[picture p73: schematic Boat_PCB.kicad_sch]

Parts:
A1: RaspberryPi_Pico; Raspberry pico no antenna
A2: Pololu_Breakout_A4988; Pololu_Breakout-16_15.2x20.3mm
BT1: 3s; AMASS_XT60-M_1x02_P7.20mm_Vertical
BT4: 4s; AMASS_XT60-M_1x02_P7.20mm_Vertical
C1, C2: C; C_Disc_D3.0mm_W1.6mm_P2.50mm
C5, C7: C_Polarized; CP_Radial_D10.0mm_P5.00mm
C6, C8, C9, C10, C11: C; C_Disc_D5.0mm_W2.5mm_P5.00mm
J1: Conn_02x06_Odd_Even; Pololu 36v5vstepdown
J2: Conn_01x03_Socket; JST_XH_B3B-XH-A_1x03_P2.50mm_Vertical
J3: Raspberry Pi 5 connector; Raspberry Pi Mounting
J4: 12s Tap; JST_XH_B2B-XH-A_1x02_P2.50mm_Vertical
J5: IMU 14,15 I2C 17,18 RST and INT.; JST_XH_B10B-XH-A_1x10_P2.50mm_Vertical
J6: 4s output; AMASS_XT60-M_1x02_P7.20mm_Vertical
J7: GPS + Compass GPIO 8,9 +15,14 I2C; JST_XH_B6B-XH-A_1x06_P2.50mm_Vertical
J8: Winch ESC GPIO 21; JST_XH_B2B-XH-A_1x02_P2.50mm_Vertical
J9: Winch ESC RC; PinSocket_1x02_P2.54mm_Vertical
J11: Temp + Humidity Sensor External GPIO 12,13 I2C; JST_XH_B4B-XH-A_1x04_P2.50mm_Vertical
J12: led GPIO 12; JST_XH_B3B-XH-A_1x03_P2.50mm_Vertical
J13: Temp + Humidity Sensor Internal GPIO 14,15 I2C; PinHeader_1x04_P2.54mm_Vertical
J14, J17: Conn_01x20_Socket; PinSocket_1x20_P2.54mm_Vertical
J15: Hull Leak Right GPIO 20; JST_XH_B2B-XH-A_1x02_P2.50mm_Vertical
J16: Hull Leak Left GPIO 19; JST_XH_B2B-XH-A_1x02_P2.50mm_Vertical
J18: Stepper Motor; JST_XH_B4B-XH-A_1x04_P2.50mm_Vertical
R1, R11: R 10k; R_Axial_DIN0207_L6.3mm_D2.5mm_P10.16mm_Horizontal
R2: R 220k; R_Axial_DIN0207_L6.3mm_D2.5mm_P10.16mm_Horizontal
R3, R7, R9: R 1k; R_Axial_DIN0207_L6.3mm_D2.5mm_P10.16mm_Horizontal
R4: R 13k; R_Axial_DIN0207_L6.3mm_D2.5mm_P10.16mm_Horizontal
R5, R8: R 100k; R_Axial_DIN0207_L6.3mm_D2.5mm_P10.16mm_Horizontal
R6: R 30k; R_Axial_DIN0207_L6.3mm_D2.5mm_P10.16mm_Horizontal
R10: R 18k; R_Axial_DIN0207_L6.3mm_D2.5mm_P10.16mm_Horizontal
U1: MCP2515-I_P; DIP254P762X432-18; MPN MCP2515-I/P
U2: TJA1051T-3; SOIC-8_3.9x4.9mm_P1.27mm
Y1: Crystal; Crystal_HC49-4H_Vertical

Connections:
GND: A1.3 (GND), A1.7 (GPIO5), A1.8 (GND), A1.13 (GND), A1.18 (GND), A1.23 (GND), A1.28 (GND), A1.38 (GND), A2.1 (GND), A2.7 (GND), A2.11 (MS2), A2.12 (MS3), BT1.1 (+), BT4.1 (+), C1.1, C2.1, C5.2, C6.2, C7.2, C8.2, C9.1, C10.2, C11.1, J1.3, J1.4, J1.5, J1.6, J2.1, J3.5, J3.10, J3.13, J3.19, J4.2, J5.2, J6.1, J7.6, J8.2, J9.2, J11.3, J12.1, J13.3, J14.11, J14.14, J14.18, J15.1, J16.1, J17.5, R4.1, R6.2, R10.1, U1.9 (VSS), U1.16 (~CS), U2.2 (GND), U2.8 (S)
unnamed: A1.36 (3V3), C9.2, C10.1, J5.1, R11.2, U1.18 (VDD), U2.5 (VIO)
unnamed: A1.4 (GPIO2), U1.13 (SCK)
unnamed: A1.5 (GPIO3), U1.14 (SI)
unnamed: A1.6 (GPIO4), U1.15 (SO)
unnamed: A1.9 (GPIO6), U1.12 (~INT)
unnamed: A1.10 (GPIO7), R11.1, U1.17 (~RESET)
unnamed: A1.11 (GPIO8), J7.4
unnamed: A1.12 (GPIO9), J7.3
unnamed: A1.14 (GPIO10), J12.2
unnamed: A1.16 (GPIO12), J11.1
unnamed: A1.17 (GPIO13), J11.2
unnamed: A1.19 (GPIO14), J5.4, J7.1, J13.1
unnamed: A1.20 (GPIO15), J5.3, J7.2, J13.2
unnamed: A1.22 (GPIO17), J5.7
unnamed: A1.24 (GPIO18), J5.8
unnamed: A1.25 (GPIO19), J16.2
unnamed: A1.26 (GPIO20), J15.2
unnamed: A1.27 (GPIO21), J8.1, J9.1
unnamed: A1.29 (GPIO22), J1.12, R1.2
unnamed: A1.31 (GPIO26_ADC0), R3.2
unnamed: A1.32 (GPIO27_ADC1), R7.2
unnamed: A1.34 (GPIO28_ADC2), R9.1
unnamed: A1.39 (VSYS), C11.2, J1.1, J1.2, J3.1, J3.3, J7.5, J11.4, J12.3, J13.4, J14.19, J14.20, U2.3 (VCC)
unnamed: A2.4 (1A), J18.2
unnamed: A2.3 (1B), J18.1
unnamed: A2.5 (2A), J18.3
unnamed: A2.6 (2B), J18.4
unnamed: A2.16 (DIR), J3.17, J14.12
unnamed: A2.2 (VDD), A2.10 (MS1), J3.2, J17.1, R1.1
unnamed: A2.15 (STEP), J3.15, J14.13
unnamed: A2.8 (VMOT), BT4.2 (-), C7.1, C8.1, J6.2, R8.1
unnamed: A2.9 (~ENABLE), J3.21, J14.10
unnamed: A2.13 (~RESET), A2.14 (~SLEEP), J3.23, J14.9
unnamed: BT1.2 (-), C5.1, C6.1, J1.7, J1.8, R5.2
unnamed: J1.9, J1.10
unnamed: J2.2, U2.7 (CANH)
unnamed: J2.3, U2.6 (CANL)
unnamed: J4.1, R2.1
unnamed: J3.39, J14.1
unnamed: J3.37, J14.2
unnamed: J3.35, J14.3
unnamed: J3.33, J14.4
unnamed: J3.31, J14.5
unnamed: J3.29, J14.6
unnamed: J3.27, J14.7
unnamed: J3.25, J14.8
unnamed: J3.11, J14.15
unnamed: J3.9, J14.16
unnamed: J3.7, J14.17
unnamed: J3.4, J17.2
unnamed: J3.6, J17.3
unnamed: J3.8, J17.4
unnamed: J3.12, J17.6
unnamed: J3.14, J17.7
unnamed: J3.16, J17.8
unnamed: J3.18, J17.9
unnamed: J3.20, J17.10
unnamed: J3.22, J17.11
unnamed: J3.24, J17.12
unnamed: J3.26, J17.13
unnamed: J3.28, J17.14
unnamed: J3.30, J17.15
unnamed: J3.32, J17.16
unnamed: J3.34, J17.17
unnamed: J3.36, J17.18
unnamed: J3.38, J17.19
unnamed: J3.40, J17.20
unnamed: R2.2, R3.1, R4.2
unnamed: R5.1, R6.1, R7.1
unnamed: R8.2, R9.2, R10.2
unnamed: C1.2, U1.8 (OSC1), Y1.1
unnamed: C2.2, U1.7 (OSC2), Y1.2
unnamed: U1.2 (RXCAN), U2.4 (RXD)
unnamed: U1.1 (TXCAN), U2.1 (TXD)

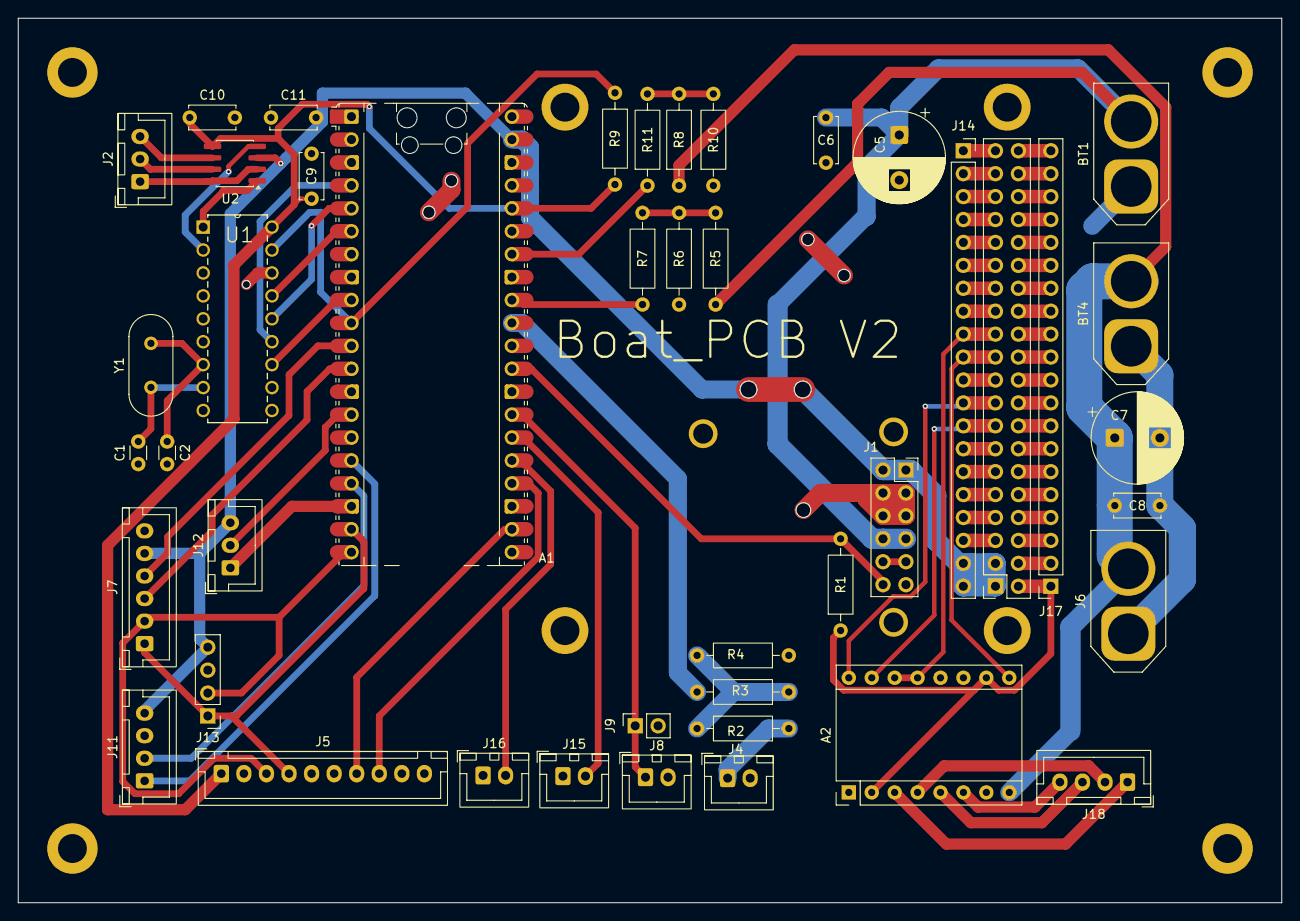
[picture p74: board Boat_PCB.kicad_pcb from above]

Board: 2 copper layers, 140.0 x 98.0 mm, 44 parts (0 on the bottom side), 75 nets.
