ka1e27/dreams/pi5/config.yaml

# Pi 5 Autonomous Boat Configuration
# ------------------------------------

serial:
  # USB serial port to Boat Pico
  port: "/dev/ttyACM0"
  baud: 115200
  # Timeout for waiting for ACK/NAK after sending a command (ms)
  command_timeout_ms: 2000
  # Number of retries before declaring command failure
  max_retries: 3
  # On run_hardware.py startup, upload firmware/boat-pico/*.py to the Pico via
  # mpremote and reset it before connecting. Set false to skip (e.g. during
  # firmware dev when you flash manually).
  deploy_on_start: true

# Pi-side GPS — a u-blox M10 on the Pi 5 header UART (module TX → GPIO15 /
# header pin 10). The Pico can't host it: its GP9 (J7.3, UART1 RX) is
# hard-shorted to GND on the as-built board. See pi5/comms/gps_nmea.py.
#
# ⚠ REQUIRES the uart0 overlay, or /dev/ttyAMA0 won't exist:
#       dtoverlay=uart0        in /boot/firmware/config.txt
# ⚠ These are the same pins pi5/scripts/am32_config.py uses to flash AM32 ESCs —
#   unplug the GPS before configuring an ESC.
gps:
  enabled: true
  port: "/dev/ttyAMA0"
  # 38400 is the u-blox M10 factory default (M8 was 9600 — don't "fix" this).
  baud: 38400
  # How old a fix may get before fix_quality is forced to 0 and gps_source
  # becomes "pi-stale". Position keeps being served either way — the Pico has no
  # receiver to fall back to, so a few-seconds-old fix beats (0, 0).
  stale_after_s: 5.0

heartbeat:
  # Interval between HB messages sent to Boat Pico (seconds)
  interval_s: 1.0
  # Pico-side timeout is 3s — keep interval well under that

navigation:
  # Distance (metres) at which the boat is considered "arrived" at a waypoint
  arrive_radius_m: 5.0
  # Distance before re-acquiring a hold position (metres)
  hold_drift_m: 8.0
  # Default throttle during waypoint transit (0–100)
  cruise_throttle: 40
  # Heading tolerance — below this error, go straight (degrees)
  heading_tolerance_deg: 10.0
  # Max heading error for proportional steering (degrees)
  max_heading_error_deg: 90.0
  # Minimum turn throttle (prevents stalling during sharp turns)
  turn_min_throttle: 15
  # Navigation update rate (Hz)
  update_rate_hz: 5
  # ---- Line-of-sight (LOS) path following ----
  # Steer to a lookahead point on the track line between waypoints instead of
  # pointing straight at the next waypoint, so wind/current can't build up
  # cross-track drift. See pi5/navigation/geo.py:los_course.
  los_enabled: true
  # Lookahead distance Δ (m): smaller = snap back to the track harder; larger =
  # gentler. ~3–8 boat lengths is typical. At cross-track error = Δ the boat
  # aims 45° back toward the line.
  los_lookahead_m: 12.0
  # Integral LOS (ILOS) gain — > 0 cancels steady cross-track bias from a
  # constant current/wind (Lekkas & Fossen). 0 = pure lookahead LOS (no windup
  # risk); enable a small value (e.g. 0.02) after field tuning on a flowing river.
  los_integral_gain: 0.0
  # Anti-windup clamp for the ILOS integrator (metre·seconds).
  los_integral_clamp: 60.0
  # ---- Per-motor thrust trim (mismatched motors) ----
  # The twin 2814 drive motors may have different Kv, so equal command gives
  # unequal thrust and the boat crabs. These gains scale each motor's command
  # before it's sent. 1.0 = no trim. Bench-calibrate: run both at equal command,
  # and lower the gain of whichever motor is faster until it tracks straight.
  motor_gain_left: 1.0
  motor_gain_right: 1.0
  # ---- Manual (WASD) override ----
  # Startup speed cap for the dashboard's manual drive, in percent. The operator
  # moves it live with the speed bar; this is only the value the panel opens at.
  # Kept well below 100 so an armed override can't launch at full throttle on the
  # first keypress.
  manual_speed: 40
  # ---- Water-current estimation + station-keeping (stay mode) ----
  # The boat has no water-speed sensor, so it estimates the current as
  # (GPS ground velocity − modelled through-water velocity). The model is
  # v = thrust_a*|thr| + thrust_b*thr²  (thr = mean forward command, −1..1);
  # calibrate per boat (drive known throttles in still water, fit the curve).
  current_enabled: true
  current_thrust_a: 0.35
  current_thrust_b: 0.15
  # Active station-keeping: in stay/hold mode the boat noses INTO the estimated
  # current and holds position (required through-water velocity = desired ground
  # velocity toward the hold point − current), instead of drifting to the edge of
  # hold_drift_m and lunging back. Tune on the water.
  sk_pos_gain: 0.25          # desired ground speed per metre of position error (1/s)
  sk_max_speed: 0.8          # cap on the station-keeping ground speed (m/s)
  sk_deadband_m: 1.2         # inside this radius + negligible current → idle motors
  sk_min_water_speed: 0.04   # required through-water speed below which → idle
  sk_speed_gain: 90.0        # throttle (0-100) per m/s of required through-water speed

mission:
  # Default max time at a data waypoint if not specified (seconds)
  default_sample_timeout_s: 300
  # Winch descent speed sent to Pico (-100 to 100, positive = down)
  winch_down_speed: 50
  # Winch ascent speed
  winch_up_speed: -50
  # Estimated descent rate (metres/second) for depth estimation
  descent_rate_m_per_s: 0.10
  # Margin multiplier for winch-up time (1.5 = 50% longer than descent)
  winch_up_margin: 1.5
  # Bottom contact confirmations needed before sampling
  bottom_confirm_count: 3
  # Seconds between bottom samples
  sample_interval_s: 5.0
  # Consecutive no-contact reads to confirm lift-off
  bottom_lost_confirm: 3
  # Minimum samples before allowing lift-off exit
  min_bottom_samples: 2
  # Pod poll interval during sampling (seconds)
  pod_poll_interval_s: 2.0

pod:
  # Pod poll interval during transit (seconds)
  poll_interval_s: 5.0
  # Timeout before declaring pod lost (ms)
  timeout_ms: 10000

battery:
  # Three fully isolated Milwaukee M18 domains — see docs/battery_architecture.md.
  # Drive battery — TEST BENCH: 2× M18 in PARALLEL (18 V nom / 21 V full / 15 V
  # cutoff) for the twin 2814 motors. Parallel = one pack's voltage, double the
  # current/runtime — NOT more voltage (so it's ~18 V, below 6S LiPo's 22 V).
  # These thresholds are a SINGLE M18's (same as elec/winch). Firmware mirror:
  # firmware/boat-pico/sensors.py P_* constants (the authoritative copy).
  drive:
    full_v: 21.0
    empty_v: 15.0
    warn_v: 17.0
    critical_v: 16.0
  # Electronics battery — 1× M18 standalone (18 V nominal / 21 V full)
  elec:
    full_v: 21.0
    empty_v: 15.0
    warn_v: 17.0
    critical_v: 16.0
  # Winch battery — 1× M18 standalone (18 V nominal / 21 V full)
  winch:
    full_v: 21.0
    empty_v: 15.0
    warn_v: 17.0
    critical_v: 16.0

network:
  # Connection mode for cloud uploads + remote access:
  #   "wifi"     — use the Pi's built-in WiFi only (best for shore / dev work)
  #   "cellular" — use the SIM7600 4G modem (default for autonomous missions)
  #   "auto"     — prefer WiFi if associated, fall back to cellular
  mode: "auto"

  # WiFi credentials. If both ssid and password are set, the network helper
  # configures NetworkManager (nmcli) on first run; otherwise it assumes the
  # OS already has WiFi configured.
  wifi:
    ssid: ""
    password: ""

  cellular:
    # SIM7600 modem configuration. The OS is expected to bring this up
    # (NetworkManager / mmcli / wvdial) — we just record the parameters.
    device: "/dev/ttyUSB2"
    baud: 115200
    apn: "internet"

  # API endpoint for cloud data upload — used regardless of which transport
  # is currently active.
  cloud_api_url: "https://your-cloud-api.example.com/api/v1"
  cloud_api_key: ""  # Set via environment variable BOAT_CLOUD_API_KEY
  # Upload interval (seconds) — buffer locally if offline
  upload_interval_s: 30
  # Probe URL used to confirm the link is actually usable (HEAD request).
  # Default is the cloud API root.
  online_probe_url: ""

camera:
  # Stereo USB cameras for distance-aware obstacle avoidance.
  # NOTE: each UVC camera exposes TWO /dev/video* nodes — an even one for image
  # capture and the next ODD one for metadata only (opens fine but yields no
  # frames). Use only the EVEN capture nodes. `v4l2-ctl --list-devices` here
  # shows cam A = video2/3 and cam B = video0/1, so the capture indices are 0
  # and 2 (NOT 1 — video1 is cam B's metadata node and never delivers frames).
  # These are the DEFAULTS — the command center's camera DEV L/R controls can
  # reassign left/right live (POST /api/camera/devices); that choice persists
  # to pi5/server/camera_devices.json and overrides these on the next start.
  left_device: 0
  right_device: 2
  baseline_m: 0.32
  calibration_path: "pi5/cv/calibration.npz"
  # StereoSGBM cost scales with resolution × disparity range, so at 1080p it
  # dominates the whole inference budget on a Pi 5 (hundreds of ms/frame) and
  # collapses detection FPS whenever an object is in view. Run the matcher at
  # this fraction of full res — depth stays metrically correct (the reprojection
  # matrix is rescaled, see pi5/cv/stereo.py) and mid-range (3-30 m) accuracy is
  # essentially unchanged. 0.5 ≈ 4× faster; set 1.0 to force full resolution.
  stereo_downscale: 0.5
  # WLS disparity post-filter (needs opencv-contrib-python for cv2.ximgproc).
  # Water is the worst case for block matching — textureless, specular — so raw
  # SGBM leaves big invalid holes on the surface. WLS fills/smooths them via a
  # left↔right consistency check, at the cost of a second matcher pass (~2×
  # matching time). Off by default; enable on a rig that can spare the cycles
  # (or drop stereo_downscale / stereo FPS to compensate). See pi5/cv/stereo.py.
  stereo_wls: false
  # Capture settings (CameraProducer). Changing these needs a restart.
  # ---- Arducam 8MP IMX219 (fixed focus) notes ----
  # The IMX219 is a raw sensor (no onboard JPEG). Its native 8MP mode is
  # 3280x2464, which over USB runs at only ~5 fps. If the feed is stuck at ~5
  # fps the camera ignored the format set below and is reading full 8MP — on
  # Linux we now force the V4L2 backend (pi5/cv/camera.py) so the resolution +
  # format switch actually applies and it drops to the fast binned mode here.
  # IMX219 binned modes that hit a high frame rate: 640x480, 1280x720 @ 30+,
  # 1640x1232 @ 30. Run `v4l2-ctl -d /dev/video0 --list-formats-ext` to see the
  # exact modes/formats your module advertises, and set width/height/fps to one.
  width: 1280
  height: 720
  fps: 30            # capture rate; the camera must support it at this res+format
  # NOTE: uncompressed YUY2 at 1080p30 needs ~1 Gbit/s per camera — USB 3.0
  # port/hub required for both cameras simultaneously. If frames stall or fps
  # drops, switch fourcc to "MJPG" below (compressed, far lighter over USB).
  # Pixel format (FourCC) requested from the camera:
  #   "YUY2"  — uncompressed 4:2:2 (V4L2 calls it YUYV; the code maps YUY2→YUYV
  #             on Linux). No JPEG decode cost and it dodges the camera's MJPG
  #             framerate caps — but ~16 bits/pixel, so it's bandwidth-heavy:
  #             1080p30 ≈ 1 Gbit/s (USB 3.0 only); fine at 720p / 640x480.
  #   "MJPG"  — compressed; light over USB but the module may cap its MJPG modes
  #             (e.g. 1080p only at 15 fps).
  #   ""      — leave the camera in its default format.
  fourcc: "MJPG"
  # If the camera stops delivering frames (USB unplugged, driver hiccup), the
  # producer releases it and retries reopening the same /dev/video* index this
  # often (seconds) until it returns. The feed shows NO-SIGNAL meanwhile and
  # recovers on its own — no restart needed.
  reconnect_interval_s: 2.0
  # ---- Command-center video feed (runtime-adjustable from /command) ----
  # Stream publish-rate cap (JPEG encode/send). Lower = lighter CPU. Capped to
  # the capture rate above; raise/lower live with the STREAM FPS slider.
  stream_fps: 30
  # MJPEG encode quality 0-100.
  jpeg_quality: 60
  # Live YOLO detection overlay drawn on the /video feed.
  detection:
    enabled: true
    # Model weights. Default COCO yolov8n (has 'boat','person',…). Two ways to
    # specialise for the water:
    #   1. The ml/ pipeline trains a maritime model and exports it to
    #      pi5/cv/models/maritime_yolov8n.onnx — if that file exists it is used
    #      automatically (onnxruntime backend, no torch), no config edit needed.
    #   2. Otherwise drop a maritime .pt here, or an NCNN export dir
    #      (yolov8n_ncnn_model, ~2x faster on ARM). Ultralytics infers the format.
    # Active: generic COCO yolov8n exported to NCNN (Tencent's ARM-optimised
    # engine) — measured ~2x faster than ONNX on the Pi 5 CPU (34 vs 18 fps @
    # imgsz 320), detecting person/boat/… with no torch at runtime. The same
    # model as pi5/cv/models/yolov8n.onnx is kept alongside as a fallback: if the
    # `ncnn` package is unavailable, point this at "pi5/cv/models/yolov8n.onnx".
    # A trained maritime model (pi5/cv/models/maritime_*.onnx or _ncnn_model/)
    # can be dropped in and pointed to here. NB the on-Pi maritime fine-tune
    # (docs) underperformed COCO on people, so COCO is the shipped detector.
    model: "pi5/cv/models/yolov8n_ncnn_model"
    # Inference size (mult of 32). 320 is the sweet spot for the Pi 5 CPU: it's
    # what keeps YOLO in the "lower but high" FPS band alongside the 15 fps Tier-1
    # water screen. 416/640 see smaller/farther targets but cost proportionally
    # more per frame (the real lever on detection FPS — detect_max_fps only caps).
    imgsz: 320
    # Baseline min confidence to keep a detection. The CONF slider in the command
    # center overrides this live, and the per-class floors below SHIFT with it
    # (see class_conf), so it is a real master control rather than a setting that
    # only bites the untuned classes.
    conf: 0.40
    # Per-class confidence floors, RELATIVE to `conf`. The model is run at the
    # LOWEST floor in play and each box is then filtered by its own class's
    # threshold — so a swimmer can be kept at 0.25 without flooding every other
    # class with junk boxes.
    # ⚠ These are offsets from the `conf` baseline above, not absolutes: person
    # sits 0.15 BELOW whatever CONF says, so dragging CONF to 0.60 puts person at
    # 0.45 and keeps the ordering intact. Until 2026-07-29 they were absolute,
    # which meant the CONF slider did nothing whatsoever for person / swimmer /
    # surfer / kayak — the classes the boat most cares about — and the operator
    # saw the same 0.40-era boxes no matter where they dragged it. Classes listed
    # in class_conf_absolute below opt out and keep a fixed floor.
    # A person in the water is the hardest and most important target on the
    # water: at any range you only see a head and shoulders, low-contrast
    # against glare, often part-submerged, so COCO scores them far below a
    # standing person. 0.40 silently drops most of them. Case-insensitive.
    class_conf:
      person: 0.25
      swimmer: 0.25
      surfer: 0.30
      kayak: 0.30
      # 'buoy' comes from the classical screen below, not the model. Its score is
      # a saturation/solidity quality proxy in the 0.35-0.80 band, NOT a learned
      # probability, so judging it against the YOLO threshold is a category
      # error: at conf 0.40 the weakest real buoys were dropped, and dragging the
      # CONF slider up would have silently switched buoy detection off entirely.
      # Its own geometric gates (min_sat / min_solidity / area / aspect) are the
      # real filter, so give it a floor 0.10 below the baseline.
      buoy: 0.30
    # Classes whose class_conf floor is ABSOLUTE — it ignores the CONF slider.
    # ⚠ EMPTY ON PURPOSE (2026-07-29). 'buoy' was listed here to stop CONF
    # dragging its floor up and silently switching buoy detection off. On the
    # bench that backfired: the classical screen was firing constantly indoors
    # (a room with no buoys in it) at ~0.40, and the pin made those the ONE thing
    # the operator could not filter out — the exact "the slider does nothing"
    # complaint, reintroduced by the guard against it. A relative floor already
    # keeps buoy 0.10 more sensitive than everything else, which is all the
    # protection it needed. Use `buoy.enabled` below to switch the screen off
    # outright; use this list only for a score that genuinely can't be compared
    # to a probability AND that isn't drowning the operator.
    class_conf_absolute: []
    # Run the detector on the RIGHT frame too, so the radar tracker can median
    # the two cameras' box centres into a less noisy bearing. ⚠ It is a second
    # full forward pass (~30 ms on this Pi 5), so it roughly HALVES detection
    # FPS — leave it off unless the bearing is visibly jittery. Off, the tracker
    # uses the left camera's centre alone, which is what it has always done.
    # Stereo *distance* does not need this (that's a disparity pass).
    detect_right: false
    # ---- Classical buoy screen (pi5/cv/buoy_detector.py) ----
    # The shipped COCO model has NO 'buoy' class, so without this nothing ever
    # emits the label that threat_assessor grades WARNING and object_memory
    # charts as a PERMANENT map marker — the whole "confirm a buoy → drop a GPS
    # marker" feature is dead on real hardware (only the sim's ground-truth
    # mapper exercised it). This finds buoys by colour+shape instead: one HSV
    # threshold pass plus a contour filter, measured 0.6-1.0 ms/frame on this
    # Pi 5 against ~30 ms for the YOLO pass. It runs at the inference rate, not the camera
    # rate. AUTO-DISABLES if the loaded model already emits 'buoy' (i.e. a real
    # maritime model was dropped in), so the two never double-report.
    buoy:
      enabled: true
      proc_width: 320       # downscale width for the mask pass (cost ∝ pixels)
      min_sat: 90           # HSV saturation floor — open water sits well below
      min_val: 60           # HSV value floor — rejects dark reflections
      # Green buoys exist, but so does sunlit foliage on the bank — which is the
      # dominant false positive on a river. Red/orange/yellow is both the
      # standard buoy colouring and the least foliage-like. Turn on only if you
      # actually need green cans and can accept bank false positives.
      include_green: false
      roi_top_frac: 0.35    # ignore the top of the frame (sky + treeline)
      max_area_frac: 0.06   # reject big blobs (own hull, dock, glare band)
      min_solidity: 0.55    # contour area / bbox area — buoys are convex-ish
      max_candidates: 6
      # A candidate is dropped when this fraction of it already lies inside a
      # YOLO box, so a person in an orange life jacket stays a CRITICAL 'person'
      # and no phantom PERMANENT buoy marker is charted on a swimmer. This is
      # containment, NOT IoU, precisely because the life jacket is a small blob
      # inside a much larger person box — IoU would be tiny there and let it
      # through. Do not raise this casually.
      overlap_suppress: 0.50
      dedupe_iou: 0.25      # merge candidates overlapping each other this much
    # Upper cap on inference rate (decoupled from Tier-1 seg and the video stream).
    # Actual FPS = min(this, 1 / inference_time). With the NCNN backend yolov8n@320
    # runs ~34 fps on the Pi 5, so we lift the cap to 15 (matching the Tier-1 water
    # screen / camera rate) for more detection frames while stereo/nav keep headroom.
    detect_max_fps: 15
    # ---- Cores the inference session may use (0 = auto) ----
    # Measured on this Pi 5 (yolov8n @ 320, NCNN, median of 15): 1 thread 27.9 ms
    # / 2 threads 18.4 ms / 3 threads 19.2 ms / 4 threads 17.7 ms. Thread 2 gets
    # essentially all the speed-up; threads 3-4 add ~4% between them. Meanwhile
    # detect_max_fps above is 15 Hz = a 66.7 ms budget, so even ONE thread clears
    # the cap with 2.4x headroom — the extra threads buy latency nobody consumes.
    # They are not free: during that sweep the Pi's sticky throttle flags went
    # 0x0 -> 0x50000 (under-voltage occurred + throttling occurred) on the 4-thread
    # pass, which is the documented cause of this project's power-off incidents
    # (2026-07-27 journal entry), and they starve the concurrent 15 fps water
    # screen / stereo / encode / nav / server. Auto = cores - 2 (so 2 on a Pi 5).
    # Raise only if you know the power budget (real 27 W PSU, stack otherwise idle).
    num_threads: 0
    target_classes: []    # keep only these class names; [] = keep all
    # Highlighted (amber) classes — covers both the COCO fallback ('boat','person')
    # and the maritime model ('vessel','kayak'). Others are drawn muted.
    # Highlighted (amber) classes — attention targets. Superset covering the COCO
    # fallback ('boat','person') and the maritime model ('boats','sail-boat',
    # 'surfer','vessel','kayak'). Matching is case-insensitive (vision_overlay),
    # so lowercase entries match 'Sail-Boat'/'Person' from either backend.
    highlight_classes: ["vessel", "boat", "boats", "sail-boat", "sailboat", "kayak", "surfer", "person"]
    # Default class for the lock reticle / radar bar to follow. "" = AUTO (the
    # highest-confidence highlighted target). Changeable live from the command
    # center's TRACK picker (which also retargets the radar bar).
    track_class: ""

vision:
  # Three-tier survey vision pipeline (pi5/cv/pipeline.py). This LAYERS on the
  # existing detection overlay + radar tracker — it does NOT run a second YOLO.
  #   Tier 1  water segmentation  — cheap, always-on anomaly screen
  #   Tier 2  the existing YOLO overlay — gated ON only when Tier 1 sees an anomaly
  #   Tier 3  threat assessment    — distance + approach vector → drives the radar
  # --- Tier-1 water screen (PRIMARY, always-on, 15 fps target) ---
  # Leave EMPTY for the classical OpenCV HSV/edge screen — the only backend that
  # sustains 15 fps on a Pi 5 CPU, and the recommended primary. Set a path ONLY
  # to replace the fast screen entirely (backend from the extension: .onnx →
  # onnxruntime, .tflite → tflite_runtime/tensorflow).
  seg_model_path: ""
  # --- Tier-1b HYBRID confirmation (optional, slow, higher-accuracy) ---
  # A DNN water model (eWaSR — see docs/water_vision.md) run on a SEPARATE slow
  # loop so it never stalls the 15 fps screen. It becomes the authoritative
  # water_state and can wake YOLO on obstacles the HSV screen misses (fail-safe:
  # it only ever ADDS triggers, never suppresses them). Absent/empty file → hybrid
  # off (pure classical). On a Pi 5 CPU keep the rate low (1-2 Hz); a Hailo
  # accelerator (ONNX-native) would let it run much faster. Drop the eWaSR export
  # at this path (gitignored) to activate — nothing else to change.
  seg_confirm_model_path: "pi5/cv/models/water_seg.onnx"
  seg_confirm_max_fps: 2      # spot-check cadence (Hz) — keep low on a CPU
  seg_confirm_ttl_s: 3        # trust a verdict this long before it goes stale
  # --- Segmentation model knobs (apply to whichever seg model loads; ignored by
  #     the classical screen) ---
  # Which output class index is "water"; non-water pixels drive the anomaly score.
  # Default 1 matches WaSR/eWaSR (0=obstacle, 1=water, 2=sky).
  seg_water_class: 1
  # Class indices excluded from the anomaly ratio (e.g. sky) so they don't inflate
  # it. For 3-class WaSR/eWaSR, [2] drops sky.
  seg_ignore_classes: [2]
  # Input normalisation: "imagenet" (WaSR/torchvision convention) or "01" (/255).
  seg_normalize: "imagenet"
  # Cores the DNN water model may use (0 = auto, same policy as the detector —
  # see pi5/cv/cpu_budget.py). Only affects the ONNX seg backend; the default
  # classical screen is single-threaded OpenCV. Stated explicitly so the Tier-1
  # loop's CPU budget is a visible choice, not inherited by accident.
  seg_num_threads: 0
  # Optional [w, h] input override when the model exports dynamic axes.
  # seg_input_size: [512, 384]
  # Fraction of the frame that must read as non-water to wake Tier 2 (YOLO).
  anomaly_trigger_threshold: 0.15
  # Once triggered, keep YOLO active this many frames before it can idle again
  # (hysteresis so it doesn't flicker on/off as the anomaly crosses threshold).
  yolo_cooldown_frames: 5
  # Gate YOLO on the Tier-1 anomaly trigger (true = real tiering, saves CPU when
  # the water is clear). Set false to keep the detection overlay always-on
  # (classic behaviour) and use the YOLO toggle as a simple on/off.
  gate_yolo_on_anomaly: true
  # Tier-1 water-analysis rate cap (Hz) — the "water detection at 15 fps" target.
  # The classical screen is cheap (downscaled HSV) and easily sustains this; it's
  # fully decoupled from the video stream and the YOLO detect rate, so holding it
  # at 15 (rather than higher) leaves more CPU for YOLO without starving the
  # always-on water screen.
  tier1_max_fps: 15
  # Camera horizontal FOV — for mapping a bbox to a bearing (bbox → radar angle).
  fov_degrees: 75

  # --- Persistent GPS-anchored object memory (pi5/cv/object_memory.py) ---
  # Geolocates confirmed detections (boat fix + heading + bbox bearing + stereo
  # range) and remembers them as markers on the map. A marker only drops once an
  # object has been seen enough times to CONFIRM it; further sightings just refine
  # the stored coordinate (inverse-distance weighted — closer looks count more).
  # Buoys/docks/rocks are PERMANENT (kept); people/boats/debris are TRANSIENT
  # (forgotten transient_ttl_s after they're last seen). Class→category lives in
  # object_memory.py. Needs stereo range, so it's a no-op on a mono rig.
  object_memory:
    enabled: true
    confirm_sightings: 3        # agreeing looks before a marker drops (anti-false-positive)
    match_radius_m: 6.0         # base spatial gate for "same object" (metres)
    match_radius_frac: 0.08     # + this × range (far fixes are noisier → wider gate)
    match_radius_max_m: 25.0    # cap on the gate
    transient_ttl_s: 45.0       # forget a confirmed person/boat this long after last seen
    candidate_ttl_s: 12.0       # drop an unconfirmed candidate this fast (noise)
    permanent_ttl_s: 0.0        # 0 = keep buoys/docks for the whole session
    max_range_m: 60.0           # ignore detections ranged beyond this (stereo unreliable)
    min_confidence: 0.30        # ignore detections below this confidence
    max_objects: 200            # memory cap (drops least-valuable first)
    # Once a landmark is charted, don't lock the radar bar re-observing it — keep
    # scanning for the unknown even with known things nearby (CRITICAL threats
    # like vessels/people are always tracked regardless).
    release_radar_on_known: true

  threat_tracking:
    enabled: true
    # Class → threat level lives in pi5/cv/threat_assessor.py (THREAT_LEVELS).
    # CRITICAL (vessel/boat/person/kayak) always tracks; WARNING (debris/buoy)
    # tracks only if approaching; INFO/SURVEY never track.
    approach_detection_frames: 5
    approach_size_threshold: 1.10   # 10% apparent-size growth = APPROACHING
    track_warning_if_approaching: true
    mission_alert_distance_m: 30.0  # raise a mission alert when a CRITICAL threat is this close
    # After a threat clears, hold then return the radar to SCAN after this long.
    clear_timeout_s: 5.0

  survey_logging:
    # INFO/SURVEY detections are counted and (if a CloudUploader is wired)
    # uploaded; CRITICAL/WARNING go to the threat system instead.
    min_confidence: 0.6
    min_anomaly_score: 0.20
    min_interval_s: 5.0             # per-class rate limit so a static dock doesn't spam

  reactive_avoidance:
    # When the primary threat (CRITICAL/WARNING) enters the envelope, the
    # pipeline pushes a steer-away override into the navigator that overrides
    # waypoint steering until the threat clears (pi5/cv/avoidance.py). This is
    # what actually keeps the boat off obstacles — it reuses the threats the
    # pipeline already tracks (no second YOLO). Range prefers stereo depth and
    # falls back to a coarse monocular bbox-size proxy on a single-camera rig.
    enabled: true
    trigger_distance_m: 8.0    # start bearing away at this range (m)
    critical_distance_m: 3.0   # full-authority hard turn at this range (m)
    # cruise_throttle: defaults to navigation.cruise_throttle if unset.
    max_steer: 65              # peak differential steer at full severity
    head_on_deg: 8.0           # |bearing| under this = head-on → pass to starboard (COLREGS)
    # Forward-throttle floor at full severity. A small floor makes the boat ARC
    # around a hazard instead of stopping (stopping lets path-following pull it
    # straight back at the obstacle — a reactive local minimum). 0 = may stop.
    min_forward_frac: 0.2
    # Bug-style escape (AvoidanceController): commit to a side and PASS the hazard
    # rather than orbiting one sitting on the goal line.
    pass_bearing_deg: 110.0    # |bearing| behind the beam → tracked hazard is passed → release
    pass_hold_s: 6.0           # when sight is lost, hold the maneuver this long to finish the pass

  # --- Incoming-wave / swell detection (capsize avoidance) ---
  # A cheap horizon-tracking + optical-flow-looming watch (pi5/cv/wave_detector.py)
  # on the Tier-1 loop (~3 ms/frame). Raises an early WAVE alert with a bearing +
  # severity; when a big set is imminent the boat bows into it (turn to face,
  # ease throttle) — the seamanship response to avoid a beam-on capsize. Tune the
  # trigger on the water (whitecaps/glare/wake can false-trigger; the persistence
  # state machine and smoothing absorb short transients).
  wave_detection:
    enabled: true
    max_fps: 10                # analysis-rate cap (Hz)
    trigger_severity: 0.55     # fused severity (0-1) above which a wave is "incoming"
    response_enabled: true     # auto bow-into-wave (yields to obstacle avoidance)
    turn_severity: 0.6         # severity above which the boat actively turns to face
    turn_gain: 50              # peak differential steer for the bow-in pivot
    turn_min: 20               # minimum pivot authority once triggered

stepper:
  # Radar-bar pan stepper (A4988 + NEMA-17) driven from the Pi 5 GPIO header
  # directly via gpiozero/lgpio. This is the ONLY Pi 5 GPIO use in the project
  # (everything else is USB) — see docs/pin_map.md. Pins are BCM numbers.
  step_pin: 23
  dir_pin: 24
  enable_pin: 25         # active-LOW
  sleep_pin: 8           # active-LOW
  # RESET (active-LOW) MUST be HIGH or the A4988 ignores every STEP pulse — the
  # most common "driver looks alive but the motor never moves" cause. Leave this
  # null on Boat_PCB V2: the board already ties ~RESET (A2.13) to ~SLEEP (A2.14),
  # so GPIO8 releases both. Set a BCM pin number only on a board that doesn't tie
  # them (the driver then holds it HIGH while energised). See docs/pin_map.md.
  reset_pin: null
  # 200 × 2 — HALF step, which is what the board wires: MS1 high off the Pi's 3V3
  # (J3 pad 2) with MS2/MS3 hard-grounded. 0.9°/step. Was 3200 (1/16), an 8× error
  # that overshot every move and overspun the motor 8×. Verified from the V2
  # netlist 2026-07-28 — don't raise this without cutting the MS2/MS3 traces.
  steps_per_rev: 400
  max_rpm: 10
  auto_sleep_seconds: 5
  # has_slip_ring gates *wrapping* (taking the short way across 0°/360°), which
  # only a slip ring can survive. It does NOT cap manual travel — that's
  # manual_*_degrees below. With no slip ring the bar is a linear axis with hard
  # stops at each end, so it never winds the cable more than one turn.
  has_slip_ring: false
  # ---- Angle convention: 0° = DEAD AHEAD, +starboard, -port ----
  # Changed 2026-07-30 from a 0…360 axis, because the old one had no way to
  # express "a bit to port". The stepper boots at 0° (`_position_steps = 0`) and
  # CENTER returns to 0°, so 0 is already the bar's home — it just wasn't the
  # bow. With bow_degrees at 90 on a 0-180 sweep, the FIRST tracking command was
  # rotate_to(90 ± offset) from a standing start of 0: a ~90° lurch to starboard
  # whichever side the target was on, which is what "it immediately turns away
  # from me" was. Now home, the bow, CENTER and the top of the compass rose all
  # mean the same thing, and a target to port is simply a negative angle instead
  # of clamping at the 0 end stop.
  #
  # Auto-scan sweep range (SCAN mode hunts back and forth between these).
  # ±90 = a forward-looking half-circle, centred on the bow.
  sweep_min_degrees: -90
  sweep_max_degrees: 90
  # Travel range for BOTH manual pan and tracking — ±180 = a **full 360° and no
  # further**, which is what the bar needs now the cameras ride on it: a target
  # can be anywhere around the boat, not just within one camera FOV of the bow.
  # The hard stops are what keep it to one turn of cable; with has_slip_ring
  # false there is no wrapping, so the bar can never wind past a single rotation.
  manual_min_degrees: -180
  manual_max_degrees: 180
  scan_speed_rpm: 3      # sweep speed while hunting for targets
  fov_degrees: 75        # camera horizontal FOV, for bbox→bearing mapping
  # Do the cameras pan WITH the bar? Confirmed true on this build 2026-07-30.
  # It decides two separate things:
  #  1. tracking is a closed loop (nudge → cameras turn → offset shrinks) rather
  #     than an absolute aim;
  #  2. every bbox bearing is relative to the BAR, not the bow, so the pipeline
  #     adds the bar angle back in before geolocating a map marker or steering
  #     around an obstacle. Without that a target held at bar +90° is reported
  #     dead ahead, and avoidance dodges the wrong way.
  # Set false for hull-mounted cameras (then the boresight IS the bow).
  cameras_on_bar: true
  # ---- Tracking loop (cameras ride ON the bar, so this is a closed loop) ----
  # Each tick: take the target's box centre (median of both cameras when the
  # right eye is also running the detector — camera.detection.detect_right —
  # else the one that is), convert its offset from frame centre to degrees, and
  # nudge the bar that way. Turning the bar turns the cameras, so the offset
  # shrinks and the target walks to frame centre.
  track_speed_rpm: 8            # slew speed with the target out at the frame edge
  track_speed_min_rpm: 1.5      # …and near centre, so fine corrections creep
                                # instead of being flung past. Speed ramps
                                # linearly between the two with |offset|.
  center_deadband_degrees: 3    # "centred enough" — inside this the bar stops.
                                # Below ~2° it would buzz chasing corrections
                                # finer than one 0.9° half-step.
  track_gain: 0.9               # fraction of the measured offset to move per
                                # tick. 1.0 aims straight at the target and would
                                # be exact if fov_degrees were; slightly under
                                # damps overshoot from FOV error.
  max_step_degrees: 30          # cap on one correction, so a single bad frame
                                # can't fling the bar across its range.
  # ---- Velocity feedforward: aim where the target is GOING ----
  # A position-only loop can only react to an error that has already opened, so
  # the faster the target moves the further behind the bar trails — until the
  # target walks out of frame and the lock drops. The tracker measures the
  # target's angular rate (deg/s) and adds `rate × lead_seconds` to each
  # correction, and lets the rate raise the slew speed too.
  # ⚠ The rate is measured on the BOW-RELATIVE BEARING (bar angle + offset), not
  # on the pixel offset — with the cameras on the bar the offset shrinks purely
  # because the bar turned, which is not the target moving.
  lead_seconds: 0.35            # how far ahead to aim. Covers the 10 Hz loop
                                # period + detection latency + the bar's ramp.
                                # 0 disables the feedforward entirely. Raise it
                                # if fast targets still trail behind centre;
                                # lower it if the bar overshoots and hunts.
  velocity_window_seconds: 0.8  # rate is a least-squares fit over this window —
                                # long enough to average out box jitter, short
                                # enough to notice a change of pace.
  velocity_speed_margin: 1.4    # slew headroom above the bare rate needed to
                                # keep pace. At exactly 1.0 the bar matches the
                                # target's speed and never closes the gap.
                                # ⚠ Top speed is still capped by max_rpm above
                                # (10 rpm = 60°/s); past that the bar physically
                                # cannot keep up and the panel says so.
  # ---- Which way is "right"? Two independent knobs, don't guess between them ----
  # invert_direction flips the A4988 DIR pin, so it mirrors EVERYTHING: manual
  # jog, GOTO, CENTER, the auto-scan sweep and tracking. Set it when the bar
  # physically turns the wrong way for a "pan RIGHT" press — i.e. the coil pairs
  # landed reversed in J18, or the bar is geared through an odd number of stages.
  # Position accounting is untouched, so 90° still means the same physical place.
  invert_direction: true
  # invert_tracking flips ONLY the bbox→bearing sign (target-drifts-right →
  # bar-goes-left). Set it when manual jog is correct but TRACK chases the wrong
  # way — the bar's + direction and the camera's + x disagree.
  # Rule of thumb: jog wrong too → invert_direction. Jog fine, track wrong →
  # invert_tracking. Both wrong in the same direction → invert_direction alone.
  #
  # ✅ MEASURED 2026-07-29: pressing "RIGHT ►" (JOG +15°) turned the bar LEFT, so
  # invert_direction is now true. That one flag also explains tracking "turning
  # away" — a target to starboard commands a HIGHER bar angle, which the wrong
  # DIR polarity was executing as a turn to port. So invert_tracking stays false:
  # only flip it if TRACK is *still* mirrored now that manual jog is correct.
  invert_tracking: false
  # The bar angle that points dead ahead — the origin tracking measures bearings
  # about. Blank/absent → midpoint of the sweep range, which with the ±90 sweep
  # above is 0 anyway; it is spelled out here because it MUST match the bar's
  # physical orientation at power-on (the stepper has no home switch, so it just
  # assumes it boots at 0°). Point the bar dead ahead before starting the stack.
  # Tracking is ABSOLUTE about this: a target dead centre in frame parks the bar
  # here, and the frame edges reach ± fov/2 (±37.5°). It is NOT relative to where
  # the bar already is — the cameras are fixed forward, so adding the offset to
  # the current angle each tick just walked the bar off to an end stop (the
  # "rotates the wrong way when tracking" bug fixed 2026-07-29).
  bow_degrees: 0
  # Minimum detection confidence before the bar will LOCK onto a target. This is
  # the tracker's own gate, separate from camera.detection.conf: the overlay
  # decides what's worth drawing and mapping, this decides what's worth swinging
  # a motor at. 0 = lock onto anything the overlay kept. Live-adjustable from the
  # command center (TRK CONF, beside the TRACK picker) — this is only the boot
  # value, it is not written back.
  min_track_confidence: 0.0
  # Detected classes that trigger TRACK mode (must match the YOLO model labels).
  # Covers the COCO fallback ('boat','person') + the maritime model ('vessel','kayak').
  priority_classes: ["vessel", "person", "kayak", "boat"]
  # Mode at startup: SLEEP (default, motor off) | HOLD | SCAN.
  initial_mode: "SLEEP"

winch:
  # Survey | Fishing — affects only dashboard labelling. Spool is a manual
  # mechanical swap; firmware behavior is identical in either mode.
  mode: "survey"

recording:
  # Camera clip recorder + Tesla-style sentry (writes .webm clips to the Pi).
  # Manual REC and armed SENTRY are toggled live from the dashboard.
  dir: ""             # blank → pi5/server/recordings/
  fps: 10             # record/pre-roll frame rate
  width: 640          # frames are down-scaled to this width (keeps size/CPU bounded)
  preroll_s: 6        # seconds kept before a sentry trigger fires
  clip_s: 12          # minimum sentry clip length after a trigger
  # A sentry clip records until the threat CLEARS (retrigger_extend_s with no new
  # sighting), not a fixed length. max_clip_s only bounds one segment file — a
  # threat still in view rolls over into a new segment, never cut off mid-event.
  max_clip_s: 300     # max length of a single clip segment before rollover
  retrigger_extend_s: 8  # keep recording this long after the threat is last seen
  max_clips: 60       # oldest clips pruned beyond this count
  max_age_days: 14    # clips older than this are auto-deleted (0 = keep forever)
  sentry_default: false  # arm sentry automatically on boot

server:
  # FastAPI web server (dashboard + API)
  host: "0.0.0.0"
  port: 8000
  # API key for authenticating shore commands
  api_key: ""  # Set via environment variable BOAT_API_KEY
  # CORS allowed origins (dashboard URL)
  cors_origins:
    - "http://localhost:5173"
    - "http://localhost:3000"

logging:
  # Local CSV log file for sensor data
  data_log: "/home/pi/boat/data/survey.csv"
  # Log level: DEBUG, INFO, WARNING, ERROR
  level: "INFO"
