ka1e27/dreams/firmware/boat-pico/motor_control.py

"""Motor control — two hobby ESCs on PWM for propulsion, PWM ESC for the winch.

Single-hull test-bench variant. Propulsion is two standard hobby ESCs driven as
50 Hz servo PWM (see `escs.py`) instead of the dual-hull boat's VESC / CAN chain.

Propulsion:
  - Left + right stern motors driven by two ESCs on GP19 / GP20 (the ex-hull-leak
    connectors J16 / J15 — moved off GP2/GP3 on 2026-07-30, see escs.py).
  - Throttle range -100..+100 percent maps to duty -1.0..+1.0 after applying the
    compensation, trim, and the thermal throttle multiplier, then handed to
    `escs.set_duty()`.
  - ⚠ The two motors are NOT identical any more, so COMP_L != COMP_R. See the
    COMP_L/COMP_R comment below.

Winch:
  - Standard hobby ESC on GP21, 50 Hz PWM. GP21 is where Boat_PCB V2 actually
    routes the winch signal (J8.1 and J9.1 are wired in parallel to it), so the
    pin was moved GP14 -> GP6 -> GP21: GP14 belongs to the SHT41 #B temp sensor
    on this variant, and GP6 is the MCP2515's ~INT on V2. GP21 is otherwise
    unused, so this is the one board-vs-firmware clash that a pin move resolves.
  - Spool can be swapped mechanically to repurpose the winch as a fishing
    reel; firmware behavior is identical regardless.

RC override:
  - rc_override_on()/off() flips a software flag. While active, main.py's
    motor task feeds SBUS channel values directly into set_throttle() and
    set_winch() instead of using navigator commands. The path is Pico-mediated
    (the Pico owns the ESC PWM pins), same as the dual-hull firmware.

Note: GP0/GP1 are dead — do not use.
"""
from machine import Pin, PWM
import escs

# ---- Winch PWM (unchanged) ----
STOP_PWM = 4915
MIN_PWM = 3277
MAX_PWM = 6553
FWD_RANGE = MAX_PWM - STOP_PWM  # 1638
REV_RANGE = STOP_PWM - MIN_PWM  # 1638

# Boat_PCB V2 winch signal (J8.1 + J9.1, parallel). PWM slice 2B.
# ⚠ Shares slice 2 with the RIGHT drive ESC on GP20 (slice 2A). Same-slice channels
# share one frequency — both want 50 Hz so this is fine, but if either is ever
# retuned the other follows it. Keep them equal.
MW_PIN = 21

# Compensation (propulsion only). No pulleys on this bench — these now correct a
# genuine MOTOR MISMATCH:
#   LEFT   AM32 NeutronRC 70A → Badass 2814-1560kv   (slower — the reference)
#   RIGHT  BLHeli-32 FH-70A   → Badass 2320-1630kv   (faster by ~4.5 %)
# Trim the faster motor down to the slower one: 1560 / 1630 = 0.9571.
#
# ⚠ Kv only equalises no-load rpm. The two motors are different frames (2814 vs
# 2320) with different torque constants and prop loading, so this is a starting
# point, not a calibration — expect to tune COMP_R on the bench by running both
# at a fixed throttle and matching thrust/rpm (ESC telemetry erpm is the easiest
# readout). Do NOT also set navigation.motor_gain_* in pi5/config.yaml for the
# same mismatch; that would compensate twice. Leave those at 1.0.
PULLEY_L = 1.0
PULLEY_R = 1.0
COMP_L = 1.0
COMP_R = 0.957

# Runtime state
_mw = None
_trim = 0.0
_throttle_mult = 1.0
_rc_active = False
_estop_active = False

# Current commanded speeds (-100..100)
_ml_spd = 0
_mr_spd = 0
_mw_spd = 0


def init():
    """Initialise winch PWM and the two drive ESCs. Call once at startup.

    Returns True if both drive ESCs came up (so the ESTOP / watchdog kill path
    can actually neutralise them); False if either PWM channel failed.
    """
    global _mw
    try:
        _mw = PWM(Pin(MW_PIN))
        _mw.freq(50)
        _set_winch_pwm(0)
    except Exception as e:
        print("motor_control init error (winch): %s" % e)
    escs_ok = False
    try:
        # escs.init() creates both ESC PWM channels and arms them at neutral.
        escs_ok = escs.init()
    except Exception as e:
        print("motor_control init error (escs): %s" % e)
    return escs_ok


def _set_winch_pwm(spd):
    """Convert -100..100 to ESC duty_u16 and apply to the winch."""
    if _mw is None:
        return
    if spd > 100:
        spd = 100
    elif spd < -100:
        spd = -100
    if spd >= 0:
        duty = STOP_PWM + FWD_RANGE * spd // 100
    else:
        duty = STOP_PWM + REV_RANGE * spd // 100
    try:
        _mw.duty_u16(duty)
    except:
        pass


def set_throttle(left, right):
    """Set propulsion motor speeds (-100..100). Returns (success, reason).

    Pi 5's commanded throttle path. Rejected during RC override or ESTOP.
    The SBUS forwarder uses set_throttle_rc() to bypass the RC gate.
    """
    global _ml_spd, _mr_spd
    if _rc_active:
        return False, "RC_ACTIVE"
    if _estop_active:
        return False, "ESTOP"
    if not escs.bidir_ok():
        # A non-bi-directional ESC treats our 1.5 ms "neutral" as ~50% throttle,
        # so there is no throttle value here — including 0 — that it would read
        # as stop. Refuse the whole command path. See escs.BIDIR_CONFIRMED.
        return False, "ESC_UNSAFE"
    if not (-100 <= left <= 100 and -100 <= right <= 100):
        return False, "RANGE"
    _ml_spd = left
    _mr_spd = right
    return True, None


def set_winch(speed):
    """Set winch speed (-100..100). Positive = down/deploy, negative = up.

    Pi 5's commanded path. Rejected during RC override or ESTOP. The SBUS
    forwarder uses set_winch_rc() to bypass the RC gate.
    """
    global _mw_spd
    if _rc_active:
        return False, "RC_ACTIVE"
    if _estop_active:
        return False, "ESTOP"
    if not (-100 <= speed <= 100):
        return False, "RANGE"
    _mw_spd = speed
    return True, None


def set_throttle_rc(left, right):
    """SBUS forwarder entry point — bypasses the RC gate. ESTOP still wins.

    The bi-directional gate wins too: it is a property of the ESCs, not of who
    is driving, so a hand controller must not be able to reach past it either.
    """
    global _ml_spd, _mr_spd
    if _estop_active:
        return
    if not escs.bidir_ok():
        return
    _ml_spd = max(-100, min(100, int(left)))
    _mr_spd = max(-100, min(100, int(right)))


def set_winch_rc(speed):
    """SBUS forwarder entry for winch — bypasses the RC gate."""
    global _mw_spd
    if _estop_active:
        return
    _mw_spd = max(-100, min(100, int(speed)))


def update():
    """Apply commanded speeds to the drive ESCs + winch PWM. Call ~10 Hz.

    Unlike a VESC, a dumb ESC has no command-timeout — it holds the last PWM
    pulse if commands stop. The safety net is the heartbeat watchdog (main.py →
    watchdog.py, 3 s) calling estop(), which drives both ESCs to neutral.
    """
    if _estop_active:
        return
    eff_l = _ml_spd * _throttle_mult * (COMP_L + _trim)
    eff_r = _mr_spd * _throttle_mult * (COMP_R - _trim)
    # Convert percent to duty -1.0..+1.0
    duty_l = max(-1.0, min(1.0, eff_l / 100.0))
    duty_r = max(-1.0, min(1.0, eff_r / 100.0))
    try:
        escs.set_duty(escs.LEFT, duty_l)
        escs.set_duty(escs.RIGHT, duty_r)
    except:
        pass
    _set_winch_pwm(_mw_spd)


def estop():
    """Emergency stop — kill all motors immediately."""
    global _estop_active, _ml_spd, _mr_spd, _mw_spd
    _estop_active = True
    _ml_spd = 0
    _mr_spd = 0
    _mw_spd = 0
    try:
        escs.stop()
    except:
        pass
    _set_winch_pwm(0)


def resume():
    """Re-enable motor commands after an ESTOP."""
    global _estop_active
    _estop_active = False


def is_estopped():
    return _estop_active


def rc_override_on():
    """Enter RC passthrough mode. main.py's motor task will read SBUS and
    forward channel values into set_throttle/set_winch."""
    global _rc_active, _ml_spd, _mr_spd, _mw_spd
    _ml_spd = 0
    _mr_spd = 0
    _mw_spd = 0
    _rc_active = True


def rc_override_off():
    """Exit RC passthrough mode."""
    global _rc_active, _ml_spd, _mr_spd, _mw_spd
    _ml_spd = 0
    _mr_spd = 0
    _mw_spd = 0
    _rc_active = False


def is_rc_override():
    return _rc_active


def set_trim(value):
    """Set motor trim (-0.5..0.5). Returns (success, comp_l, comp_r)."""
    global _trim
    if not (-0.5 <= value <= 0.5):
        return False, 0, 0
    _trim = value
    return True, COMP_L + _trim, COMP_R - _trim


def get_trim():
    return _trim, COMP_L + _trim, COMP_R - _trim


def set_throttle_mult(mult):
    """Set throttle multiplier (0.0–1.0) for thermal throttling."""
    global _throttle_mult
    _throttle_mult = max(0.0, min(1.0, mult))


def get_speeds():
    return _ml_spd, _mr_spd, _mw_spd


def get_state():
    return _rc_active, _estop_active
