ka1e27/dreams/pi5/server/app.py

"""FastAPI application — REST API + WebSocket for the boat dashboard.

Endpoints:
  GET  /api/status          Full system status
  GET  /api/telemetry       Latest telemetry
  GET  /api/environment     Latest environment data
  GET  /api/pod/history     Pod reading history
  GET  /api/mission         Current mission state
  GET  /api/missions        List loaded missions
  POST /api/mission         Upload and optionally start a mission
  GET  /api/paths           List saved waypoint-planner paths
  POST /api/paths           Save (create/overwrite) a path
  DELETE /api/paths/{name}  Delete a saved path
  POST /api/heading         Hold a compass heading (SET_HDG)
  POST /api/mission/start   Start loaded mission
  POST /api/mission/pause   Pause mission
  POST /api/mission/resume  Resume mission
  POST /api/mission/abort   Abort mission
  POST /api/goto            Navigate to coordinates
  POST /api/estop           Emergency stop
  POST /api/resume          Resume after ESTOP
  POST /api/rth             Return to home
  GET  /api/camera/devices  Scan attached cameras + left/right assignment
  POST /api/camera/devices  Assign which camera is left / right (live swap)
  WS   /ws/telemetry        Live telemetry stream
  WS   /ws/camera           Camera MJPEG stream
"""
from __future__ import annotations

import asyncio
import base64
import logging
import os
import shutil
import tempfile
import time
from pathlib import Path

from fastapi import Depends, FastAPI, Request, WebSocket, WebSocketDisconnect
from fastapi.middleware.cors import CORSMiddleware
from fastapi.responses import FileResponse, RedirectResponse, Response, StreamingResponse

from ..scripts import am32_config
from . import auth
from .models import (
    EnvironmentOut,
    GotoIn,
    MissionStateOut,
    MissionUploadIn,
    NavStateOut,
    PodReadingOut,
    StatusOut,
    TelemetryOut,
)
from .rate_limit import RateLimitMiddleware

logger = logging.getLogger(__name__)

# These get injected by the main startup script
_pico = None      # PicoSerial
_navigator = None  # Navigator
_mission = None    # MissionManager
_pod = None        # PodBridge
_sim = None        # BoatSimulator (only in sim mode)
_camera = None     # cv.camera.CameraProducer (optional)
_overlay = None    # cv.vision_overlay.DetectionOverlay (optional)
_network = None    # comms.network.NetworkManager (optional)
_stepper = None    # cv.stepper.StepperMotor (optional, radar-bar pan)
_radar = None      # cv.radar_tracker.RadarTracker (optional)
_pipeline = None   # cv.pipeline.SurveyVisionPipeline (optional, three-tier vision)
_obstacles = None  # navigation.sim_obstacles.ObstacleField (simulator only)
_object_memory = None  # cv.object_memory.ObjectMemory (simulator only; hardware
#                        reads the pipeline's own memory via _pipeline.map_objects)
_esc_mock = None   # bytearray — persistent mock ESC EEPROM for the editor in sim mode
_recorder = None   # cv.recorder.Recorder (optional; camera clip + sentry recording)
_recorder_task = None
_winch_mode = "survey"
_home_lat = None
_home_lon = None


def configure(pico, navigator, mission_mgr, pod_bridge,
              home_lat=None, home_lon=None, api_key=None,
              cors_origins=None, simulator=None, camera=None,
              network=None, winch_mode="survey", overlay=None,
              jpeg_quality=60, stream_fps=15, stepper=None, radar=None,
              pipeline=None, obstacle_field=None, object_memory=None,
              recorder=None):
    """Inject dependencies. Called before app startup."""
    global _pico, _navigator, _mission, _pod, _home_lat, _home_lon, _sim
    global _camera, _network, _winch_mode, _overlay, _jpeg_quality, _stream_fps_cap
    global _stepper, _radar, _pipeline, _obstacles, _object_memory, _recorder
    _obstacles = obstacle_field
    _object_memory = object_memory
    _pico = pico
    _navigator = navigator
    _mission = mission_mgr
    _pod = pod_bridge
    _home_lat = home_lat
    _home_lon = home_lon
    _sim = simulator
    _camera = camera
    _network = network
    _winch_mode = winch_mode
    _overlay = overlay
    _jpeg_quality = int(jpeg_quality)
    _stream_fps_cap = float(stream_fps)
    _stepper = stepper
    _radar = radar
    _pipeline = pipeline
    _recorder = recorder
    auth.configure(api_key)

    if cors_origins:
        app.add_middleware(
            CORSMiddleware,
            allow_origins=cors_origins,
            allow_credentials=True,
            allow_methods=["*"],
            allow_headers=["*"],
        )


app = FastAPI(title="Autonomous Boat API", version="1.0.0")

_TEMPLATES_DIR = Path(__file__).parent / "templates"


@app.get("/", include_in_schema=False)
async def root():
    """Serve the command center — the single UI (map, telemetry, camera, health, controls)."""
    return FileResponse(_TEMPLATES_DIR / "command_center.html")


@app.get("/command", include_in_schema=False)
async def command_center():
    """Legacy path — the command center is now served at /."""
    return RedirectResponse(url="/")


@app.get("/planner", include_in_schema=False)
async def waypoint_planner():
    """Serve the waypoint planner — create, edit, save and upload paths."""
    return FileResponse(_TEMPLATES_DIR / "waypoint_planner.html")

# Rate limiting — per (IP, path class): 300 req/min default, 10/min for sensitive
# endpoints, 900/min for the 10 Hz manual-drive tick. 60/min was below the
# dashboard's own idle polling (~70/min: map objects 2 s, obstacles 3 s,
# recordings 3 s), so the panel 429'd itself. See rate_limit.py.
app.add_middleware(RateLimitMiddleware, default_rpm=300, burst_rpm=120)

# WebSocket connection managers
_tel_clients: list[WebSocket] = []
_cam_clients: list[WebSocket] = []


# ---- Helper to build response models from live state ----

def _tel_out() -> TelemetryOut:
    t = _pico.telemetry
    return TelemetryOut(
        lat=t.lat, lon=t.lon, heading=t.heading,
        speed_knots=t.speed_knots, batt_v=t.batt_v, batt_pct=t.batt_pct,
        hull=t.hull, mt_left=t.mt_left, mt_right=t.mt_right, health=t.health,
        curr_left=t.curr_left, curr_right=t.curr_right,
        fix_quality=t.fix_quality, sats=t.sats, hdop=t.hdop,
        gps_source=t.gps_source,
        gps_sats_visible=t.gps_sats_visible,
        gps_sats_tracked=t.gps_sats_tracked,
        gps_best_snr=t.gps_best_snr,
    )


def _env_out() -> EnvironmentOut:
    e = _pico.environment
    return EnvironmentOut(
        air_temp=e.air_temp, air_humidity=e.air_humidity,
        water_temp=e.water_temp, water_ec=e.water_ec,
        water_light=e.water_light, bottom_contact=e.bottom_contact,
    )


def _nav_out() -> NavStateOut:
    n = _navigator.state
    return NavStateOut(
        target_lat=n.target_lat, target_lon=n.target_lon,
        distance_m=n.distance_m, bearing_deg=n.bearing_deg,
        heading_error=n.heading_error,
        throttle_left=n.throttle_left, throttle_right=n.throttle_right,
        arrived=n.arrived, active=n.active,
        cross_track_m=n.cross_track_m, course_deg=n.course_deg,
        avoiding=n.avoiding,
        current_set_deg=n.current_set_deg, current_drift_ms=n.current_drift_ms,
        station_keeping=n.station_keeping,
        manual=n.manual, manual_speed=n.manual_speed, manual_stale=n.manual_stale,
        pico_estopped=bool(getattr(_pico, "estopped", False)),
    )


def _mission_out() -> MissionStateOut:
    m = _mission.state
    return MissionStateOut(
        name=m.name, running=m.running, paused=m.paused,
        current_wp=m.current_wp, total_wps=m.total_wps,
        phase=m.phase.name, est_depth_m=m.est_depth_m,
        sample_count=m.sample_count, elapsed_s=m.elapsed_s,
    )


# ---- REST Endpoints ----

@app.get("/api/status", response_model=StatusOut)
async def get_status(_: str = Depends(auth.require_api_key)):
    """Full system status snapshot."""
    return StatusOut(
        telemetry=_tel_out(),
        environment=_env_out(),
        navigation=_nav_out(),
        mission=_mission_out(),
        connected=_pico.connected,
    )


@app.get("/api/telemetry", response_model=TelemetryOut)
async def get_telemetry(_: str = Depends(auth.require_api_key)):
    """Latest telemetry."""
    return _tel_out()


@app.get("/api/network")
async def get_network_status(_: str = Depends(auth.require_api_key)):
    """Active network transport (wifi / cellular / offline) and online state."""
    if _network is None:
        return {"mode": "unknown", "active_kind": "unknown",
                "active_interface": None, "online": False}
    return _network.status()


@app.get("/api/environment", response_model=EnvironmentOut)
async def get_environment(_: str = Depends(auth.require_api_key)):
    """Latest environment sensor data."""
    return _env_out()


@app.get("/api/pod/history", response_model=list[PodReadingOut])
async def get_pod_history(
    limit: int = 100,
    _: str = Depends(auth.require_api_key),
):
    """Pod reading history (most recent first)."""
    # Clamp the client-supplied limit: an unbounded value could slice/copy a
    # huge list and spike memory on the Pi.
    n = max(1, min(int(limit), 5000))
    readings = _pod.history[-n:]
    readings.reverse()
    return [
        PodReadingOut(
            timestamp=r.timestamp, water_temp=r.water_temp,
            salinity_ec=r.salinity_ec, light_pct=r.light_pct,
            bottom_contact=r.bottom_contact, leak_detected=r.leak_detected,
            pressure_depth_m=r.pressure_depth_m,
        )
        for r in readings
    ]


@app.get("/api/mission", response_model=MissionStateOut)
async def get_mission(_: str = Depends(auth.require_api_key)):
    """Current mission state."""
    return _mission_out()


@app.post("/api/mission", response_model=MissionStateOut)
async def upload_mission(
    payload: MissionUploadIn,
    start: bool = False,
    _: str = Depends(auth.require_api_key),
):
    """Upload a mission. Optionally start it immediately with ?start=true."""
    data = {
        "name": payload.name,
        "waypoints": [wp.model_dump() for wp in payload.waypoints],
    }
    if not _mission.load_from_dict(data):
        from fastapi import HTTPException
        raise HTTPException(status_code=400, detail="Invalid mission data")
    if start:
        await _mission.start()
    return _mission_out()


@app.post("/api/mission/start")
async def start_mission(_: str = Depends(auth.require_api_key)):
    """Start the loaded mission."""
    if not _mission.waypoints:
        from fastapi import HTTPException
        raise HTTPException(status_code=400, detail="No mission loaded")
    await _mission.start()
    return {"status": "started"}


@app.post("/api/mission/pause")
async def pause_mission(_: str = Depends(auth.require_api_key)):
    """Pause the running mission."""
    _mission.pause()
    return {"status": "paused"}


@app.post("/api/mission/resume")
async def resume_mission(_: str = Depends(auth.require_api_key)):
    """Resume the paused mission."""
    _mission.resume_mission()
    return {"status": "resumed"}


@app.post("/api/mission/abort")
async def abort_mission(_: str = Depends(auth.require_api_key)):
    """Abort the running mission."""
    _mission.abort("API_ABORT")
    return {"status": "aborted"}


@app.post("/api/mission/skip")
async def skip_site(_: str = Depends(auth.require_api_key)):
    """Skip the current data waypoint — winch up and continue mission."""
    _mission.skip_site()
    return {"status": "skipping"}


@app.post("/api/goto")
async def goto(
    payload: GotoIn,
    _: str = Depends(auth.require_api_key),
):
    """Navigate to a specific coordinate."""
    if _mission.state.running:
        _mission.abort("GOTO_OVERRIDE")
    _navigator.goto(payload.lat, payload.lon)
    return {"status": "navigating", "lat": payload.lat, "lon": payload.lon}


@app.post("/api/estop")
async def estop(_: str = Depends(auth.require_api_key)):
    """Emergency stop — kill all motors."""
    if _mission.state.running:
        _mission.abort("ESTOP")
    # Drop manual override too, or the next keypress would re-drive the motors
    # straight through the ESTOP the operator just hit.
    _navigator.enable_manual(False)
    _navigator.stop_nav()
    await _pico.emergency_stop()
    return {"status": "emergency_stop"}


@app.post("/api/resume")
async def resume_estop(_: str = Depends(auth.require_api_key)):
    """Resume after emergency stop."""
    await _pico.resume()
    return {"status": "resumed"}


@app.get("/api/mission/waypoints")
async def get_mission_waypoints(_: str = Depends(auth.require_api_key)):
    """Return the loaded mission waypoints."""
    return [
        {"lat": wp.lat, "lon": wp.lon, "type": wp.wp_type.name.lower(), "label": wp.label}
        for wp in _mission.waypoints
    ]


# ---- Saved paths (waypoint planner library) ----
# Paths created in /planner are persisted to a JSON file so they survive
# restarts and can be picked from the command center's LOAD PATH dialog.

_PATHS_FILE = Path(__file__).parent / "saved_paths.json"
_paths_lock = asyncio.Lock()


def _read_paths() -> dict:
    """Load the saved-paths file → {name: {name, waypoints, updated}}."""
    try:
        import json
        with open(_PATHS_FILE, encoding="utf-8") as f:
            data = json.load(f)
        return data if isinstance(data, dict) else {}
    except (OSError, ValueError):
        return {}


def _write_paths(paths: dict) -> None:
    import json
    tmp = _PATHS_FILE.with_suffix(".json.tmp")
    tmp.write_text(json.dumps(paths, indent=1), encoding="utf-8")
    tmp.replace(_PATHS_FILE)


@app.get("/api/paths")
async def list_paths(_: str = Depends(auth.require_api_key)):
    """List saved waypoint-planner paths (newest first)."""
    paths = list((await asyncio.to_thread(_read_paths)).values())
    paths.sort(key=lambda p: p.get("updated", 0), reverse=True)
    return paths


@app.post("/api/paths")
async def save_path(
    payload: MissionUploadIn,
    _: str = Depends(auth.require_api_key),
):
    """Save (create or overwrite by name) a waypoint-planner path."""
    async with _paths_lock:
        paths = await asyncio.to_thread(_read_paths)
        paths[payload.name] = {
            "name": payload.name,
            "waypoints": [wp.model_dump() for wp in payload.waypoints],
            "updated": time.time(),
        }
        await asyncio.to_thread(_write_paths, paths)
    return {"status": "saved", "name": payload.name,
            "count": len(payload.waypoints)}


@app.delete("/api/paths/{name}")
async def delete_path(name: str, _: str = Depends(auth.require_api_key)):
    """Delete a saved path by name."""
    async with _paths_lock:
        paths = await asyncio.to_thread(_read_paths)
        if name not in paths:
            from fastapi import HTTPException
            raise HTTPException(status_code=404, detail="No such path")
        del paths[name]
        await asyncio.to_thread(_write_paths, paths)
    return {"status": "deleted", "name": name}


@app.post("/api/heading")
async def set_heading(
    payload: dict,
    _: str = Depends(auth.require_api_key),
):
    """Hold a compass heading (SET_HDG). Overrides mission/nav like /api/goto."""
    hdg = payload.get("heading")
    if hdg is None or not (0 <= float(hdg) <= 360):
        from fastapi import HTTPException
        raise HTTPException(status_code=400, detail="heading must be 0–360")
    if _mission.state.running:
        _mission.abort("SET_HDG_OVERRIDE")
    _navigator.stop_nav()
    await _pico.set_heading(float(hdg) % 360)
    return {"status": "heading_set", "heading": float(hdg) % 360}


@app.post("/api/sim/speed")
async def set_sim_speed(
    payload: dict,
    _: str = Depends(auth.require_api_key),
):
    """Set simulator speed (max_speed_mps). Only works in simulator mode."""
    if _sim is None:
        from fastapi import HTTPException
        raise HTTPException(status_code=400, detail="Not in simulator mode")
    speed = payload.get("max_speed_mps")
    if speed is None or not (0.1 <= speed <= 50.0):
        from fastapi import HTTPException
        raise HTTPException(status_code=400, detail="max_speed_mps must be 0.1–50.0")
    _sim._config.max_speed_mps = float(speed)
    return {"status": "ok", "max_speed_mps": _sim._config.max_speed_mps}


@app.get("/api/sim/speed")
async def get_sim_speed(_: str = Depends(auth.require_api_key)):
    """Get current simulator speed."""
    if _sim is None:
        return {"max_speed_mps": None}
    return {"max_speed_mps": _sim._config.max_speed_mps}


@app.post("/api/sim/current")
async def set_sim_current(payload: dict, _: str = Depends(auth.require_api_key)):
    """Set the simulated water current (east/north m/s). Simulator mode only —
    push a current, then HOLD and watch station-keeping nose into it."""
    if _sim is None:
        from fastapi import HTTPException
        raise HTTPException(status_code=400, detail="Not in simulator mode")
    try:
        e = max(-3.0, min(3.0, float(payload.get("east_mps", 0.0))))
        n = max(-3.0, min(3.0, float(payload.get("north_mps", 0.0))))
    except (TypeError, ValueError):
        from fastapi import HTTPException
        raise HTTPException(status_code=400, detail="east_mps/north_mps must be numbers")
    _sim.set_current(e, n)
    return {"status": "ok", "east_mps": e, "north_mps": n}


@app.get("/api/sim/current")
async def get_sim_current(_: str = Depends(auth.require_api_key)):
    """Get the simulated water current (east/north m/s), or None off-sim."""
    if _sim is None:
        return {"east_mps": None, "north_mps": None}
    return {"east_mps": _sim._cur_e, "north_mps": _sim._cur_n}


# ---- Simulated obstacles (simulator only) ----
# Ground-truth obstacles the SimAvoider ranges to exercise reactive avoidance
# end-to-end without a camera. Rendered on the command-center map; the boat
# steers around them using the same override the vision pipeline uses on hardware.

@app.get("/api/sim/obstacles")
async def get_sim_obstacles(_: str = Depends(auth.require_api_key)):
    """List simulated obstacles (empty when not in simulator mode)."""
    if _obstacles is None:
        return {"available": False, "obstacles": []}
    return {"available": True, "obstacles": _obstacles.as_dicts()}


@app.post("/api/sim/obstacles")
async def add_sim_obstacle(payload: dict, _: str = Depends(auth.require_api_key)):
    """Add a simulated obstacle.

    Body: ``{lat, lon, radius_m?, label?}`` to place at a point, OR
    ``{ahead_m, radius_m?}`` to drop one that many metres ahead of the boat's
    current heading (what the command center's DROP OBSTACLE button uses).
    """
    if _obstacles is None:
        from fastapi import HTTPException
        raise HTTPException(status_code=400, detail="Not in simulator mode")
    radius = float(payload.get("radius_m", 4.0))
    label = str(payload.get("label", "obstacle"))
    lat, lon = payload.get("lat"), payload.get("lon")
    if lat is None or lon is None:
        # Project a point ahead of the boat along its heading.
        import math
        ahead = float(payload.get("ahead_m", 15.0))
        t = _pico.telemetry
        hr = t.heading * (math.pi / 180.0)
        dlat = ahead * math.cos(hr) / 6_371_000.0 * (180.0 / math.pi)
        dlon = (ahead * math.sin(hr) / (6_371_000.0 * math.cos(t.lat * math.pi / 180.0))
                * (180.0 / math.pi))
        lat, lon = t.lat + dlat, t.lon + dlon
    if not (-90 <= lat <= 90 and -180 <= lon <= 180):
        from fastapi import HTTPException
        raise HTTPException(status_code=400, detail="invalid coordinates")
    o = _obstacles.add(float(lat), float(lon), radius, label)
    return {"status": "added", "obstacle": o.to_dict(),
            "count": len(_obstacles.obstacles)}


@app.delete("/api/sim/obstacles")
async def clear_sim_obstacles(_: str = Depends(auth.require_api_key)):
    """Remove all simulated obstacles."""
    if _obstacles is None:
        from fastapi import HTTPException
        raise HTTPException(status_code=400, detail="Not in simulator mode")
    _obstacles.clear()
    return {"status": "cleared"}


# ---- Remembered map objects (geolocated buoys / landmarks) ----
# The vision pipeline geolocates confirmed detections (buoys, docks, people, …)
# and remembers them as map markers (pi5/cv/object_memory.py). On hardware the
# pipeline owns the memory; in the simulator a SimObjectMapper feeds a standalone
# ObjectMemory from ground truth. Either way the command-center map polls this.

def _object_memory_source():
    """The live object memory: the pipeline's on hardware, else the sim's."""
    if _pipeline is not None:
        return _pipeline
    return _object_memory


@app.get("/api/map/objects")
async def get_map_objects(_: str = Depends(auth.require_api_key)):
    """Confirmed geolocated objects for the GPS map (buoys/landmarks/etc.).

    Returns ``{available, objects}``. ``objects`` are the *confirmed* markers only
    (an unconfirmed candidate isn't dropped on the map until it's been seen
    enough times). Empty + available=false when no vision memory is wired.
    """
    src = _object_memory_source()
    if src is None:
        return {"available": False, "objects": []}
    if hasattr(src, "map_objects"):          # SurveyVisionPipeline
        objects = src.map_objects()
    else:                                     # bare ObjectMemory (sim)
        objects = src.markers()
    return {"available": True, "objects": objects}


@app.post("/api/map/objects/clear")
async def clear_map_objects(_: str = Depends(auth.require_api_key)):
    """Forget all remembered map objects (operator reset)."""
    src = _object_memory_source()
    if src is None:
        from fastapi import HTTPException
        raise HTTPException(status_code=400, detail="No object memory available")
    mem = getattr(src, "object_memory", src)  # pipeline.object_memory, or the memory
    mem.clear()
    return {"status": "cleared"}


@app.post("/api/nav/throttle")
async def set_cruise_throttle(
    payload: dict,
    _: str = Depends(auth.require_api_key),
):
    """Set cruise throttle (0–100)."""
    val = payload.get("cruise_throttle")
    if val is None or not (1 <= val <= 100):
        from fastapi import HTTPException
        raise HTTPException(status_code=400, detail="cruise_throttle must be 1–100")
    _navigator._config.cruise_throttle = int(val)
    return {"status": "ok", "cruise_throttle": _navigator._config.cruise_throttle}


@app.get("/api/nav/throttle")
async def get_cruise_throttle(_: str = Depends(auth.require_api_key)):
    """Get current cruise throttle."""
    return {"cruise_throttle": _navigator._config.cruise_throttle}


@app.get("/api/nav/motor-trim")
async def get_motor_trim(_: str = Depends(auth.require_api_key)):
    """Get per-motor trim gains (for mismatched-Kv motors)."""
    cfg = _navigator._config
    return {"left": cfg.motor_gain_left, "right": cfg.motor_gain_right}


@app.post("/api/nav/motor-trim")
async def set_motor_trim(payload: dict, _: str = Depends(auth.require_api_key)):
    """Set per-motor trim gains. Each command is scaled by its gain before send,
    so equal command → equal thrust on two different-Kv motors. Range 0.5–1.5."""
    from fastapi import HTTPException
    cfg = _navigator._config
    for side, attr in (("left", "motor_gain_left"), ("right", "motor_gain_right")):
        if payload.get(side) is not None:
            try:
                v = float(payload[side])
            except (TypeError, ValueError):
                raise HTTPException(status_code=400, detail=f"{side} must be a number")
            if not (0.5 <= v <= 1.5):
                raise HTTPException(status_code=400, detail=f"{side} must be 0.5–1.5")
            setattr(cfg, attr, v)
    return {"left": cfg.motor_gain_left, "right": cfg.motor_gain_right}


# ---- Manual (WASD) override ------------------------------------------------
# Direct operator drive from the dashboard. The nav loop treats manual as the
# highest-priority source and applies a dead-man timeout, so these endpoints are
# deliberately thin: they only feed the navigator, they never touch the Pico
# directly. That keeps one owner of the throttle and one place for the timeout.


def _manual_state() -> dict:
    n = _navigator
    return {
        "enabled": n.state.manual,
        "speed": n.manual_speed,
        "stale": n.state.manual_stale,
        "throttle_left": n.state.throttle_left,
        "throttle_right": n.state.throttle_right,
        "timeout_s": n.MANUAL_TIMEOUT_S,
        # A latched Pico ESTOP NAKs every SET_THR, so the panel can look armed
        # and responsive while the motors are dead. Surface it here so the
        # dashboard can say so instead of leaving it in the server log.
        "pico_estopped": bool(getattr(_pico, "estopped", False)),
    }


@app.get("/api/manual")
async def get_manual(_: str = Depends(auth.require_api_key)):
    """Current manual-override state."""
    return _manual_state()


@app.post("/api/manual")
async def set_manual(payload: dict, _: str = Depends(auth.require_api_key)):
    """Arm or disarm manual override.

    Arming cancels any active goto/stay so the two cannot fight over the
    throttle, and starts stopped — the boat will not move until a key is pressed.
    Disarming zeroes the motors on the next nav tick.
    """
    from fastapi import HTTPException
    val = payload.get("enabled")
    if not isinstance(val, bool):
        raise HTTPException(status_code=400, detail="enabled must be a boolean")
    if val and _mission is not None and _mission.state.running:
        # Refuse rather than silently abort someone's survey — /api/mission/pause
        # or /abort is an explicit decision the operator should make.
        raise HTTPException(
            status_code=409,
            detail="Pause or abort the mission before taking manual control")
    _navigator.enable_manual(val)
    logger.warning("Manual override %s via dashboard", "ARMED" if val else "disarmed")
    return _manual_state()


@app.post("/api/manual/drive")
async def manual_drive(payload: dict, _: str = Depends(auth.require_api_key)):
    """Feed one operator input sample: surge (-1..1 ahead) + yaw (-1..1 starboard).

    The dashboard repeats this at ~10 Hz while keys are held. Mixing to
    left/right happens in the navigator so the same logic is testable in Python
    and cannot drift from the trim/clamp the autonomous path uses.
    """
    from fastapi import HTTPException
    if not _navigator.state.manual:
        raise HTTPException(status_code=409, detail="Manual override is not armed")
    try:
        surge = float(payload.get("surge", 0.0))
        yaw = float(payload.get("yaw", 0.0))
    except (TypeError, ValueError):
        raise HTTPException(status_code=400, detail="surge/yaw must be numbers")
    if surge != surge or yaw != yaw:          # NaN would sail straight past clamps
        raise HTTPException(status_code=400, detail="surge/yaw must be finite")
    _navigator.manual_input(surge, yaw)
    left, right = _navigator.manual_mix()
    # `pico_estopped` is why the panel can read ARMED with live numbers and the
    # boat still not move: the nav loop is sending SET_THR and the Pico is NAK'ing
    # every one until it gets a RESUME.
    return {"ok": True, "throttle_left": left, "throttle_right": right,
            "pico_estopped": bool(getattr(_pico, "estopped", False))}


@app.post("/api/manual/speed")
async def manual_speed(payload: dict, _: str = Depends(auth.require_api_key)):
    """Set the manual speed cap (0–100 %). Scales every manual command."""
    from fastapi import HTTPException
    val = payload.get("speed")
    try:
        pct = int(val)
    except (TypeError, ValueError):
        raise HTTPException(status_code=400, detail="speed must be an integer 0–100")
    if not (0 <= pct <= 100):
        raise HTTPException(status_code=400, detail="speed must be 0–100")
    return {"speed": _navigator.set_manual_speed(pct)}


@app.post("/api/esc/passthrough")
async def esc_passthrough(payload: dict, _: str = Depends(auth.require_api_key)):
    """Arm AM32 ESC passthrough on the Boat Pico (EXPERIMENTAL — see
    docs/esc_passthrough.md). Sends ESC_PASS, then releases the serial link so
    am32.ca / the passthrough tool can take /dev/ttyACM0. Hardware only; refuses
    during a mission."""
    from fastapi import HTTPException
    if _sim is not None:
        raise HTTPException(status_code=400,
                            detail="ESC passthrough is hardware-only (not in simulator)")
    if _pico is None or not getattr(_pico, "connected", False):
        raise HTTPException(status_code=503, detail="No Boat Pico link")
    if _mission is not None and _mission.state.running:
        raise HTTPException(status_code=409, detail="Stop the mission first")
    esc = 1 if str(payload.get("esc", "left")).lower() in ("1", "right", "r") else 0
    try:
        baud = int(payload.get("baud", 19200))
    except (TypeError, ValueError):
        raise HTTPException(status_code=400, detail="baud must be an integer")
    # Stop motors, arm the bridge, then drop the link so the port frees.
    _navigator.stop_nav()
    try:
        await _pico.emergency_stop()
        await _pico.esc_passthrough(esc, baud)
    except Exception as e:  # noqa: BLE001
        raise HTTPException(status_code=502, detail=f"Pico did not accept ESC_PASS: {e}")
    try:
        await _pico.disconnect()
    except Exception:  # noqa: BLE001
        pass
    return {
        "status": "armed", "esc": "right" if esc else "left", "baud": baud,
        "message": ("Pico is now bridging the %s ESC. Open am32.ca (Chromium) and "
                    "connect to the Pico serial port to configure it, then restart "
                    "the boat stack. See docs/esc_setup.md / esc_passthrough.md."
                    % ("right" if esc else "left")),
    }


# --------------------------------------------------------------------------- #
# ESC settings editor — read/write AM32 EEPROM directly over the Pi GPIO UART
# (am32_config talks the one-wire bootloader). The dashboard renders the field
# registry (am32_config.FIELDS) as a live editor. In simulator mode we serve a
# persistent in-memory mock EEPROM so the whole editor is demoable without hardware.
# --------------------------------------------------------------------------- #
def _esc_mock_buf():
    """Lazily-seeded persistent mock EEPROM so sim writes stick within the session."""
    global _esc_mock
    if _esc_mock is None:
        _esc_mock = am32_config.default_mock_eeprom()
    return _esc_mock


def _esc_meta() -> dict:
    """Static editor metadata (groups, wiring, one-time setup) — no serial IO."""
    return {
        "sim": _sim is not None,
        "port": am32_config.DEFAULT_PORT,
        "groups": [{"key": k, "label": lbl} for k, lbl in am32_config.GROUPS],
        "wiring": [{"from": a, "to": b, "note": c} for a, b, c in am32_config.WIRING],
        "wiring_note": am32_config.WIRING_NOTE,
        "setup_cmds": list(am32_config.SETUP_CMDS),
    }


@app.get("/api/esc/meta")
async def esc_meta(_: str = Depends(auth.require_api_key)):
    """Static ESC-editor metadata (field groups, wiring, one-time setup). No serial IO,
    so the modal can show the wiring guide before anything is connected."""
    return _esc_meta()


@app.post("/api/esc/read")
async def esc_read(_: str = Depends(auth.require_api_key)):
    """Read the drive ESC's AM32 settings for the editor. Simulator mode returns the
    persistent mock EEPROM; hardware reads /dev/ttyAMA0 (needs the ESC signal wired to
    the Pi UART — see the modal's Wiring tab and docs/am32_config.md)."""
    from fastapi import HTTPException

    meta = _esc_meta()
    if _sim is not None:
        e = _esc_mock_buf()
        return {**meta, "connected": True, "flash": "SIM",
                "boot_configured": e[0] == 1, "fields": am32_config.decode_eeprom(e)}
    if _mission is not None and _mission.state.running:
        raise HTTPException(status_code=409, detail="Stop the mission first — ESC config is a bench operation")
    try:
        r = await asyncio.to_thread(am32_config.read_settings, am32_config.DEFAULT_PORT)
    except am32_config.Am32Error as e:
        raise HTTPException(status_code=502, detail=str(e))
    return {**meta, "connected": True, **r}


@app.post("/api/esc/write")
async def esc_write(payload: dict, _: str = Depends(auth.require_api_key)):
    """Write only the changed AM32 settings (read-modify-write + read-back verify).
    Body: {"changes": {key: value, ...}}. Simulator mode mutates the mock EEPROM."""
    from fastapi import HTTPException

    changes = payload.get("changes") if isinstance(payload, dict) else None
    if not isinstance(changes, dict) or not changes:
        raise HTTPException(status_code=400, detail="no changes given")
    if _sim is not None:
        buf = _esc_mock_buf()
        try:
            changed = am32_config.apply_changes(buf, changes)  # validates + mutates
        except am32_config.Am32Error as e:
            raise HTTPException(status_code=400, detail=str(e))
        return {"sim": True, "flash": "SIM", "changed": changed,
                "fields": am32_config.decode_eeprom(buf)}
    if _mission is not None and _mission.state.running:
        raise HTTPException(status_code=409, detail="Stop the mission first — ESC config is a bench operation")
    try:
        r = await asyncio.to_thread(am32_config.write_settings, am32_config.DEFAULT_PORT, changes)
    except am32_config.Am32Error as e:
        # 400 for a bad key/value (client error), 502 for a link/verify failure
        msg = str(e)
        bad = ("unknown setting" in msg or "read-only" in msg or "must be" in msg)
        raise HTTPException(status_code=400 if bad else 502, detail=msg)
    return {"sim": False, **r}


@app.post("/api/winch/speed")
async def set_winch_speed(
    payload: dict,
    _: str = Depends(auth.require_api_key),
):
    """Set winch down/up speeds."""
    down = payload.get("down_speed")
    up = payload.get("up_speed")
    cfg = _mission._config
    if down is not None:
        if not (1 <= down <= 100):
            from fastapi import HTTPException
            raise HTTPException(status_code=400, detail="down_speed must be 1–100")
        cfg.winch_down_speed = int(down)
    if up is not None:
        if not (-100 <= up <= -1):
            from fastapi import HTTPException
            raise HTTPException(status_code=400, detail="up_speed must be -100 to -1")
        cfg.winch_up_speed = int(up)
    return {"status": "ok", "down_speed": cfg.winch_down_speed, "up_speed": cfg.winch_up_speed}


@app.get("/api/winch/speed")
async def get_winch_speed(_: str = Depends(auth.require_api_key)):
    """Get current winch speeds."""
    cfg = _mission._config
    return {"down_speed": cfg.winch_down_speed, "up_speed": cfg.winch_up_speed}


@app.post("/api/rth")
async def return_to_home(_: str = Depends(auth.require_api_key)):
    """Return to home position."""
    if _home_lat is None or _home_lon is None:
        from fastapi import HTTPException
        raise HTTPException(status_code=400, detail="No home position configured")
    await _mission.return_to_home(_home_lat, _home_lon)
    return {"status": "returning_home", "lat": _home_lat, "lon": _home_lon}


# ---- WebSocket: Live Telemetry ----

@app.websocket("/ws/telemetry")
async def ws_telemetry(ws: WebSocket):
    """Stream live telemetry as JSON at ~1Hz.

    Authenticate via query param: /ws/telemetry?key=<api_key>
    """
    if not await auth.validate_ws(ws):
        return
    await ws.accept()
    _tel_clients.append(ws)
    try:
        while True:
            data = {
                "telemetry": _tel_out().model_dump(),
                "environment": _env_out().model_dump(),
                "navigation": _nav_out().model_dump(),
                "mission": _mission_out().model_dump(),
                "timestamp": time.time(),
            }
            await ws.send_json(data)
            await asyncio.sleep(1)
    except WebSocketDisconnect:
        pass
    except Exception as e:
        logger.debug("WS telemetry error: %s", e)
    finally:
        if ws in _tel_clients:
            _tel_clients.remove(ws)


# ---- WebSocket: Camera Stream ----

@app.websocket("/ws/camera")
async def ws_camera(ws: WebSocket):
    """Stream MJPEG frames from the shared camera producer.

    Authenticate via query param: /ws/camera?key=<api_key>
    Optional ?cam=left|right|disparity selects the view. Defaults to left.
    The producer is owned by the app lifespan; this handler just subscribes.
    """
    if not await auth.validate_ws(ws):
        return
    await ws.accept()
    _cam_clients.append(ws)

    try:
        import cv2
        import numpy as np
    except ImportError:
        await ws.send_json({"error": "opencv not installed"})
        await ws.close()
        if ws in _cam_clients:
            _cam_clients.remove(ws)
        return

    if _camera is None:
        await ws.send_json({"error": "camera producer not running"})
        await ws.close()
        if ws in _cam_clients:
            _cam_clients.remove(ws)
        return

    view = ws.query_params.get("cam", "left")
    queue = _camera.subscribe()

    # Disparity view uses StereoSGBM if calibration is loaded; lazy import.
    stereo = None
    if view == "disparity":
        try:
            from ..cv.stereo import StereoDepth, load_calibration
            calib = load_calibration("pi5/cv/calibration.npz")
            if calib is not None:
                stereo = StereoDepth(calib)
        except Exception as e:
            logger.warning("disparity view fell back to left: %s", e)
            view = "left"

    loop = asyncio.get_event_loop()

    def _disparity(left, right):
        # StereoSGBM + colormap — heavy CPU; runs in a worker thread (cv2
        # releases the GIL), keeping the asyncio loop free for telemetry/control.
        disp, _ = stereo.compute(left, right)
        disp_norm = cv2.normalize(disp, None, 0, 255,
                                  cv2.NORM_MINMAX).astype(np.uint8)
        return cv2.applyColorMap(disp_norm, cv2.COLORMAP_TURBO)

    try:
        while True:
            try:
                frame = await asyncio.wait_for(queue.get(), timeout=2.0)
            except asyncio.TimeoutError:
                continue
            if view == "right" and frame.right is not None:
                img = frame.right
            elif view == "disparity" and stereo is not None and frame.right is not None:
                img = await loop.run_in_executor(None, _disparity, frame.left, frame.right)
            else:
                img = frame.left
            # JPEG encode is CPU-bound at 720p+; offload so a slow encode can't
            # stall the event loop (mirrors the /video MJPEG endpoint).
            _, jpeg = await loop.run_in_executor(
                None,
                lambda i=img: cv2.imencode(".jpg", i, [cv2.IMWRITE_JPEG_QUALITY, 60]),
            )
            await ws.send_bytes(jpeg.tobytes())
    except WebSocketDisconnect:
        pass
    except Exception as e:
        logger.debug("WS camera error: %s", e)
    finally:
        _camera.unsubscribe(queue)
        if ws in _cam_clients:
            _cam_clients.remove(ws)


# ============================================================================
# Command Center — camera MJPEG, Pi 5 health, and Pico terminal
# ----------------------------------------------------------------------------
# These endpoints power /command (templates/command_center.html). They extend
# the existing app without disturbing the navigation API above:
#   * /video reuses the shared CameraProducer (_camera) — it never opens a
#     second VideoCapture, so it can't contend with the CV pipeline.
#   * /ws/pico streams *parsed* frames from the existing PicoSerial (_pico) and
#     can dispatch protocol commands — it does not open a second serial reader.
#   * /pico/push reflashes the Pico via mpremote, releasing and re-acquiring the
#     port around the operation. Hardware-only; refuses while a mission runs.
# Everything degrades cleanly in simulator mode and on non-Pi hosts.
# ============================================================================

# 640x360 near-black JPEG shown when no camera producer is running.
_NO_CAM_JPEG = base64.b64decode(
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
    "KKACiiigAooooAKKKKACiiigAooooA//9k="
)

_latest_health: dict | None = None
_health_task: asyncio.Task[None] | None = None
_cam_fps: float = 0.0  # rolling estimate updated by the /video streamer
_net_prev: tuple[int, int, float] | None = None  # (bytes_sent, bytes_recv, monotonic)
_jpeg_quality: int = 60      # /video MJPEG quality (runtime-adjustable via /api/camera)
_stream_fps_cap: float = 15.0  # /video publish-rate cap (runtime-adjustable)


def _http_key_ok(request: Request) -> bool:
    """Validate an API key passed via ?key= or X-API-Key for plain-HTTP routes.

    Used by /video, whose <img> tag can't attach an auth header. Mirrors the
    dev-mode behaviour of auth.require_api_key (open when no key configured).
    """
    key = request.query_params.get("key") or request.headers.get("x-api-key")
    return auth.key_valid(key)


# ---- Pi 5 health ----

async def _vcgencmd(*args: str) -> str | None:
    """Run `vcgencmd <args>` and return stripped stdout, or None off-Pi."""
    try:
        proc = await asyncio.create_subprocess_exec(
            "vcgencmd", *args,
            stdout=asyncio.subprocess.PIPE,
            stderr=asyncio.subprocess.DEVNULL,
        )
        out, _ = await asyncio.wait_for(proc.communicate(), timeout=2.0)
        return out.decode(errors="ignore").strip()
    except (FileNotFoundError, asyncio.TimeoutError, OSError):
        return None


# ---- Fork-free health sources ----------------------------------------------
# _gather_health runs once a second for the whole uptime of the boat, and every
# vcgencmd is a fork+exec. Measured on this Pi 5, the original 7 probes per tick
# cost ~19 ms wall / ~1.3 ms parent-CPU *per second* and 604,800 process spawns a
# day. Temperature and ARM clock are both readable straight from sysfs for ~37 us
# total, so those two forks are simply unnecessary.
_SYSFS_TEMP = "/sys/class/thermal/thermal_zone0/temp"          # millidegrees C
_SYSFS_ARM_CLOCK = "/sys/devices/system/cpu/cpu0/cpufreq/scaling_cur_freq"  # kHz

# The four measure_volts rails are slow-moving diagnostics, not safety signals,
# so they are sampled on a longer cadence instead of every tick. get_throttled
# stays at 1 Hz — it is the under-voltage/throttle alarm and the one probe that
# genuinely needs to be live (it is how this project diagnosed its brown-outs).
_VOLTS_INTERVAL_S = 10.0
_volts_cache: dict[str, float | None] | None = None
_volts_cache_at: float = 0.0
# Separate "have we sampled yet" flag: off a Pi the sample legitimately IS None,
# so a `_volts_cache is not None` guard would never hit the cache and would
# re-fork all four probes every tick — worse than before the cache existed.
_volts_sampled: bool = False


def _read_sysfs_float(path: str, scale: float) -> float | None:
    """Read a single-number sysfs file, scaled. None if absent/unreadable."""
    try:
        with open(path, encoding="ascii") as f:
            return float(f.read().strip()) * scale
    except (OSError, ValueError):
        return None


async def _sampled_volts() -> dict[str, float | None] | None:
    """The measure_volts rails, refreshed at most every _VOLTS_INTERVAL_S.

    A None result (not a Pi) is cached just like a real reading — otherwise the
    dev-laptop path would fork four probes a second forever.
    """
    global _volts_cache, _volts_cache_at, _volts_sampled
    now = time.monotonic()
    if _volts_sampled and (now - _volts_cache_at) < _VOLTS_INTERVAL_S:
        return _volts_cache
    srcs = ("core", "sdram_c", "sdram_i", "sdram_p")
    raws = await asyncio.gather(*(_vcgencmd("measure_volts", s) for s in srcs))
    volts: dict[str, float | None] | None = {
        s: _parse_eq_float(v) for s, v in zip(srcs, raws)
    }
    if not any(v is not None for v in volts.values()):
        volts = None            # off-Pi: report N/A, but still cache the miss
    _volts_cache, _volts_cache_at, _volts_sampled = volts, now, True
    return volts


_THROTTLE_BITS = {
    0: "under-voltage", 1: "arm freq capped", 2: "currently throttled",
    3: "soft temp limit", 16: "under-voltage occurred", 17: "arm freq cap occurred",
    18: "throttling occurred", 19: "soft temp limit occurred",
}


def _decode_throttled(raw: str | None) -> tuple[str | None, str | None]:
    """Decode `vcgencmd get_throttled` output → (raw_hex, human string)."""
    if not raw or "=" not in raw:
        return None, None
    hexval = raw.split("=", 1)[1].strip()
    try:
        bits = int(hexval, 16)
    except ValueError:
        return None, None
    if bits == 0:
        return hexval, "OK"
    active = [name for bit, name in _THROTTLE_BITS.items() if bits & (1 << bit)]
    return hexval, ", ".join(active) if active else "OK"


def _throttled_now(raw_hex: str | None) -> bool:
    """True if a throttle/under-voltage condition is active *right now*.

    Only bits 0-3 count. Bits 16-19 are the sticky "has occurred since boot"
    flags — they never clear until reboot, so treating them as live would make
    any conditional probe run forever after the first dip.
    """
    if not raw_hex:
        return False
    try:
        return bool(int(raw_hex, 16) & 0xF)
    except ValueError:
        return False


def _parse_eq_float(text: str | None) -> float | None:
    """Pull the number out of vcgencmd 'key=12.3unit' style output."""
    if not text or "=" not in text:
        return None
    num = "".join(c for c in text.split("=", 1)[1] if c.isdigit() or c in ".-")
    try:
        return float(num) if num else None
    except ValueError:
        return None


# Order of the 6-char health-flags string in TEL / GET_STATUS. This must match
# what the Boat Pico firmware actually emits in _health_flags()
# (firmware/boat-pico/main.py): GPS, IMU, drive battery, electronics battery,
# motor, pod. The older serial-protocol.md label "DHT" for byte 4 was stale —
# byte 4 is the electronics-battery health bit, not a temp sensor.
_HEALTH_FLAG_NAMES = ("GPS", "IMU", "P_BAT", "E_BAT", "MOT", "POD")


def _boat_health() -> dict:
    """Snapshot the Boat Pico's key health from the live PicoSerial state.

    Surfaces the operationally important boat status on the command center:
    link, battery, hull leak, motor temps, GPS/heading/speed, the decoded
    per-sensor health flags, the slow ENV sensors, and the latest alert.
    """
    t = _pico.telemetry
    e = _pico.environment
    flags = (t.health or "").ljust(6, "0")
    health_flags = {
        name: (flags[i] == "1") for i, name in enumerate(_HEALTH_FLAG_NAMES)
    }
    alert = getattr(_pico, "last_alert", None)
    alert_d = None
    if alert is not None:
        alert_d = {"severity": alert.severity, "code": alert.code, "detail": alert.detail}
    return {
        "connected": bool(getattr(_pico, "connected", False)),
        "lat": t.lat, "lon": t.lon,
        "heading": t.heading, "speed_knots": t.speed_knots,
        # Three M18 battery rails: drive (from TEL), electronics + winch
        # (from ENV v1.1). hull_left/right decoded from the TEL hull code.
        "batt_v": t.batt_v, "batt_pct": t.batt_pct,            # 3× M18 drive
        "elec_v": getattr(e, "elec_batt_v", 0.0), "elec_pct": getattr(e, "elec_batt_pct", 0),
        "winch_v": getattr(e, "winch_batt_v", 0.0), "winch_pct": getattr(e, "winch_batt_pct", 0),
        "hull": t.hull,
        "hull_left": "L!" in (t.hull or ""),
        "hull_right": "R!" in (t.hull or ""),
        "mt_left": t.mt_left, "mt_right": t.mt_right,
        "curr_left": t.curr_left, "curr_right": t.curr_right,
        "health": t.health,
        "health_flags": health_flags,
        # Two SHT41s: open air (#A) and electronics enclosure (#B).
        "air_temp": e.air_temp, "air_humidity": e.air_humidity,
        "enc_temp": getattr(e, "enc_temp", -999.0),
        "enc_humidity": getattr(e, "enc_humidity", -1.0),
        "water_temp": e.water_temp, "water_ec": e.water_ec,
        "water_light": e.water_light, "bottom_contact": e.bottom_contact,
        "alert": alert_d,
    }


def _gather_psutil_stats() -> dict:
    """Blocking psutil probes (/proc reads + a statvfs syscall).

    Run off the event loop via ``asyncio.to_thread`` — this fires every second
    from the background health loop, and disk_usage/net/mem syscalls can stall
    tens to hundreds of ms on a loaded or slow-storage Pi, which would add
    that jitter to every concurrent request. Missing/unavailable psutil
    degrades to an empty dict (all values None) rather than raising.
    """
    global _net_prev
    stats: dict = {}
    try:
        import psutil
        stats["cpu_percent"] = psutil.cpu_percent(percpu=True)
        vm = psutil.virtual_memory()
        du = psutil.disk_usage(os.path.abspath(os.sep))
        sw = psutil.swap_memory()
        stats["ram_used"] = round((vm.total - vm.available) / 1e9, 2)
        stats["ram_total"] = round(vm.total / 1e9, 2)
        stats["disk_used"] = round(du.used / 1e9, 2)
        stats["disk_total"] = round(du.total / 1e9, 2)
        stats["swap_used"] = round(sw.used / 1e9, 2)
        stats["swap_total"] = round(sw.total / 1e9, 2)
        stats["uptime_s"] = max(0.0, time.time() - psutil.boot_time())
        stats["proc_count"] = len(psutil.pids())
        try:
            stats["load_avg"] = [round(x, 2) for x in psutil.getloadavg()]
        except (OSError, AttributeError):
            stats["load_avg"] = None  # not available on this platform
        net = psutil.net_io_counters()
        nowm = time.monotonic()
        if _net_prev is not None and nowm > _net_prev[2]:
            dt = nowm - _net_prev[2]
            stats["net_tx_kbps"] = max(0.0, (net.bytes_sent - _net_prev[0]) / dt / 1024)
            stats["net_rx_kbps"] = max(0.0, (net.bytes_recv - _net_prev[1]) / dt / 1024)
        _net_prev = (net.bytes_sent, net.bytes_recv, nowm)
    except Exception as e:  # noqa: BLE001 — psutil missing/unavailable is non-fatal
        logger.debug("psutil unavailable: %s", e)
    return stats


async def _gather_health() -> dict:
    """Collect Pi/host health.

    Optional sources degrade to None (shown as N/A in the UI) instead of
    raising: psutil if it isn't installed, vcgencmd off a Pi. A missing source
    must never tear down /ws/health — that would make the dashboard
    reconnect-loop (open → error → close → retry).
    """
    ps = await asyncio.to_thread(_gather_psutil_stats)
    cpu_percent = ps.get("cpu_percent")
    ram_used = ps.get("ram_used")
    ram_total = ps.get("ram_total")
    disk_used = ps.get("disk_used")
    disk_total = ps.get("disk_total")
    swap_used = ps.get("swap_used")
    swap_total = ps.get("swap_total")
    uptime_s = ps.get("uptime_s")
    proc_count = ps.get("proc_count")
    load_avg = ps.get("load_avg")
    net_rx_kbps = ps.get("net_rx_kbps")
    net_tx_kbps = ps.get("net_tx_kbps")

    # Temperature and ARM clock come from sysfs (~37 us for both) instead of two
    # vcgencmd forks; the voltage rails are sampled on a slow cadence. Only
    # get_throttled still forks every tick — see the notes by _sampled_volts.
    # This took the always-on health loop from 7 spawns/s to ~1.4.
    temp_c = _read_sysfs_float(_SYSFS_TEMP, 1e-3)          # milli°C → °C
    clock_hz = _read_sysfs_float(_SYSFS_ARM_CLOCK, 1e3)    # kHz → Hz
    throttled_raw_out, volts = await asyncio.gather(
        _vcgencmd("get_throttled"),
        _sampled_volts(),
    )
    throttled_raw, throttled = _decode_throttled(throttled_raw_out)
    if temp_c is None:      # not a Pi (or sysfs moved) — fall back to the fork
        temp_c = _parse_eq_float(await _vcgencmd("measure_temp"))
    # `scaling_cur_freq` is the cpufreq driver's view. On a Pi that driver asks
    # the firmware, so it tracks the real clock (verified here: exact agreement
    # with `measure_clock arm` at both 1500 and 2400 MHz). But the authoritative
    # value is `cpuinfo_cur_freq`, which is root-only, so during an ACTIVE
    # throttle — precisely when the operator is diagnosing a brown-out and a
    # masked clock drop would mislead them — spend the fork and ask the firmware
    # directly. Sticky "occurred" bits are ignored on purpose: they latch until
    # reboot and would make this fork forever.
    if clock_hz is None or _throttled_now(throttled_raw):
        clock_hz = _parse_eq_float(
            await _vcgencmd("measure_clock", "arm")) or clock_hz

    # Pod Pico status (reached via the Boat Pico; tracked by PodBridge).
    pod_ok = pod_leak = pod_age_s = None
    if _pod is not None:
        pod_ok = bool(getattr(_pod, "pod_ok", False))
        latest = getattr(_pod, "latest", None)
        if latest is not None:
            pod_leak = bool(latest.leak_detected)
            pod_age_s = round(max(0.0, time.time() - latest.timestamp), 1)

    # Radar-bar stepper (Pi 5 GPIO; tracked by RadarTracker). None off-Pi/sim.
    stepper_angle = stepper_state = stepper_locked = stepper_target = None
    stepper_no_lock = stepper_auto_rescan = stepper_warning = None
    stepper_centered = stepper_offset = stepper_rate = stepper_lead = None
    _st = _radar or _stepper
    if _st is not None:
        try:
            ss = _st.status()
            stepper_angle = ss.get("angle")
            stepper_state = ss.get("state")
            stepper_locked = ss.get("target_locked", False)
            stepper_target = ss.get("target")   # {label, conf} of the locked target
            stepper_no_lock = ss.get("no_lock_reason")     # why it isn't locked
            stepper_auto_rescan = ss.get("auto_rescan")    # False = TRACK-only pin
            stepper_warning = ss.get("track_warning")      # locked but not converging
            stepper_centered = ss.get("centered")
            stepper_offset = ss.get("offset_deg")          # target off frame centre
            stepper_rate = ss.get("target_rate_dps")       # target angular rate
            stepper_lead = ss.get("lead_deg")              # feedforward being applied
        except Exception as e:  # noqa: BLE001 — never let a status read break health
            logger.debug("stepper status unavailable: %s", e)

    # Object being tracked by the detection overlay (highest-conf priority box).
    track = None
    if _overlay is not None:
        try:
            track = _overlay.primary_target()
        except Exception as e:  # noqa: BLE001
            logger.debug("overlay primary_target unavailable: %s", e)

    # Three-tier vision pipeline (Tier-1 water state, anomaly score, threat +
    # tracking status). None when the pipeline isn't wired (sim / no camera).
    vision = None
    if _pipeline is not None:
        try:
            vision = _pipeline.vision_state()
        except Exception as e:  # noqa: BLE001 — a vision hiccup must not break health
            logger.debug("vision_state unavailable: %s", e)

    # Boat / Pico health — battery, hull, motors, GPS, decoded sensor flags, and
    # the latest alert. Pulled from the live PicoSerial state (works with the
    # simulator's MockPicoSerial too). Degrades to None if no Pico is wired.
    boat = None
    if _pico is not None:
        try:
            boat = _boat_health()
        except Exception as e:  # noqa: BLE001 — telemetry read must not break health
            logger.debug("boat health unavailable: %s", e)

    return {
        "temp_c": temp_c,
        "throttled": throttled,
        "throttled_raw": throttled_raw,
        "cpu_percent": cpu_percent,
        "ram_used_gb": ram_used,
        "ram_total_gb": ram_total,
        "disk_used_gb": disk_used,
        "disk_total_gb": disk_total,
        "swap_used_gb": swap_used,
        "swap_total_gb": swap_total,
        "uptime_s": uptime_s,
        "proc_count": proc_count,
        "load_avg": load_avg,
        "net_rx_kbps": round(net_rx_kbps, 1) if net_rx_kbps is not None else None,
        "net_tx_kbps": round(net_tx_kbps, 1) if net_tx_kbps is not None else None,
        "clock_mhz": round(clock_hz / 1e6, 1) if clock_hz else None,
        "volts": volts,
        "camera_fps": round(_cam_fps, 1) if _camera is not None else None,
        "detect_fps": _overlay.detect_fps if _overlay is not None else None,
        "detections": _overlay.detections() if _overlay is not None else None,
        "pod_ok": pod_ok,
        "pod_leak": pod_leak,
        "pod_age_s": pod_age_s,
        "stepper_angle": stepper_angle,
        "stepper_state": stepper_state,
        "stepper_target_locked": stepper_locked,
        "stepper_target": stepper_target,
        "stepper_no_lock_reason": stepper_no_lock,
        "stepper_auto_rescan": stepper_auto_rescan,
        "stepper_track_warning": stepper_warning,
        "stepper_centered": stepper_centered,
        "stepper_offset_deg": stepper_offset,
        "stepper_target_rate_dps": stepper_rate,
        "stepper_lead_deg": stepper_lead,
        "track": track,
        "vision": vision,
        "boat": boat,
        "timestamp": time.time(),
    }


@app.get("/health")
async def get_health():
    """Latest Pi 5 health snapshot. Open (no API key) like a liveness probe."""
    return _latest_health if _latest_health is not None else await _gather_health()


@app.websocket("/ws/health")
async def ws_health(ws: WebSocket):
    """Stream Pi 5 health JSON every second. Auth via ?key=<api_key>.

    A gather failure surfaces as an {"error": ...} payload and the socket stays
    open — closing it would make the dashboard reconnect-loop.
    """
    if not await auth.validate_ws(ws):
        return
    await ws.accept()
    try:
        while True:
            try:
                data = _latest_health if _latest_health is not None else await _gather_health()
            except Exception as e:  # noqa: BLE001
                data = {"error": str(e), "timestamp": time.time()}
            await ws.send_json(data)
            await asyncio.sleep(1.0)
    except WebSocketDisconnect:
        pass
    except Exception as e:
        logger.debug("WS health error: %s", e)


# ---- Camera MJPEG (reuses the shared CameraProducer) ----

def _mjpeg_part(jpeg: bytes) -> bytes:
    return (b"--frame\r\nContent-Type: image/jpeg\r\nContent-Length: "
            + str(len(jpeg)).encode() + b"\r\n\r\n" + jpeg + b"\r\n")


_stereo_depth = None        # cv.stereo.StereoDepth, lazy-loaded on first disparity request
_stereo_load_failed = False  # sticky — don't retry loading calibration every frame


def _get_stereo_depth():
    """Lazily load pi5/cv/calibration.npz and build a StereoDepth once, shared
    by every /video?cam=disparity viewer. Returns None if no calibration file
    is present (disparity view then falls back to left in the caller)."""
    global _stereo_depth, _stereo_load_failed
    if _stereo_depth is not None or _stereo_load_failed:
        return _stereo_depth
    try:
        from ..cv.stereo import StereoDepth, load_calibration
        calib = load_calibration("pi5/cv/calibration.npz")
        if calib is None:
            _stereo_load_failed = True
            return None
        _stereo_depth = StereoDepth(calib)
    except Exception as e:  # noqa: BLE001 — disparity view just isn't available
        logger.warning("Disparity view unavailable: %s", e)
        _stereo_load_failed = True
    return _stereo_depth


async def _mjpeg_stream(view: str = "left"):
    """Yield an MJPEG stream for the selected camera ("left", "right", or
    "disparity").

    Placeholder frames when no producer is running. Publishes at most
    _stream_fps_cap frames/s. Detection overlay boxes (computed from the LEFT
    frame only — no second inference, the Pi is inference-bound) are drawn on
    the left view ONLY: on the right view the same box coordinates would sit
    offset by the stereo disparity (parallax from the ~320mm baseline), which
    reads as "misaligned" rather than useful, so the right view is shown clean.
    "disparity" renders a live depth colormap via StereoDepth (falls back to
    left if no calibration is loaded or no right camera is present). If
    "right"/"disparity" is requested but no right camera is present we fall
    back to the left frame. Stream FPS and detect FPS stay independent.
    """
    global _cam_fps
    if _camera is None:
        while True:
            yield _mjpeg_part(_NO_CAM_JPEG)
            await asyncio.sleep(1.0)

    import cv2  # producer is running, so opencv is installed
    import numpy as np
    loop = asyncio.get_running_loop()
    queue = _camera.subscribe()
    last_pub = 0.0
    try:
        while True:
            try:
                frame = await asyncio.wait_for(queue.get(), timeout=2.0)
            except asyncio.TimeoutError:
                yield _mjpeg_part(_NO_CAM_JPEG)
                continue
            # Publish-rate cap (0.9 tolerance so equal rates still publish every frame).
            now = time.monotonic()
            cap = _stream_fps_cap
            if cap and last_pub and (now - last_pub) < (1.0 / cap) * 0.9:
                continue

            if view == "disparity" and frame.right is not None:
                stereo = await loop.run_in_executor(None, _get_stereo_depth)
            else:
                stereo = None

            if stereo is not None:
                disp, _ = await loop.run_in_executor(
                    None, stereo.compute, frame.left, frame.right)
                disp_norm = cv2.normalize(disp, None, 0, 255, cv2.NORM_MINMAX,
                                          dtype=cv2.CV_8U)
                disp_norm = np.nan_to_num(disp_norm).astype(np.uint8)
                img = cv2.applyColorMap(disp_norm, cv2.COLORMAP_TURBO)
            else:
                # Pick the requested view; right/disparity fall back to left if absent.
                show_right = view in ("right", "disparity") and frame.right is not None
                img = frame.right if show_right else frame.left
                # Detection boxes only make sense on the left view they were
                # computed from — drawing them on the right view puts them at
                # the wrong pixel position (parallax offset), so skip there.
                # The vision-pipeline HUD (water state, anomaly bar, threat
                # highlight) is drawn on the left view regardless of whether the
                # YOLO overlay is currently gated on.
                if not show_right and (_overlay is not None or _pipeline is not None):
                    img = img.copy()
                    if _overlay is not None and _overlay.enabled:
                        _overlay.draw(img)
                    if _pipeline is not None:
                        try:
                            _pipeline.annotate(img)
                        except Exception as e:  # noqa: BLE001
                            logger.debug("pipeline annotate failed: %s", e)
            # JPEG encode is blocking and CPU-heavy at 1080p; run it off the
            # event loop so it overlaps the next capture instead of serializing
            # with it. cv2 releases the GIL during imencode, so this parallelizes.
            quality = _jpeg_quality
            ok, jpeg = await loop.run_in_executor(
                None,
                lambda i=img, q=quality: cv2.imencode(
                    ".jpg", i, [cv2.IMWRITE_JPEG_QUALITY, q]),
            )
            if not ok:
                continue
            if last_pub:
                dt = now - last_pub
                if dt > 0:
                    inst = 1.0 / dt
                    _cam_fps = inst if _cam_fps == 0 else 0.8 * _cam_fps + 0.2 * inst
            last_pub = now
            yield _mjpeg_part(jpeg.tobytes())
    finally:
        _camera.unsubscribe(queue)


@app.get("/video")
async def video(request: Request):
    """MJPEG camera stream. Auth via ?key=<api_key>.

    Select the view with ?cam=left|right|disparity (default left). Detection
    overlay boxes are drawn on the left view only (they're computed from the
    left frame, so on the right view they'd sit at the wrong pixel position).
    "disparity" renders a live depth colormap (needs pi5/cv/calibration.npz and
    a right camera; falls back to left otherwise).
    """
    if not _http_key_ok(request):
        return Response(status_code=403, content="Invalid or missing API key")
    view = request.query_params.get("cam", "left")
    if view not in ("left", "right", "disparity"):
        view = "left"
    return StreamingResponse(
        _mjpeg_stream(view),
        media_type="multipart/x-mixed-replace; boundary=frame",
    )


def _camera_state() -> dict:
    """Current camera/detection control state for /api/camera and the UI."""
    devmap = _camera.device_map if _camera is not None else {}
    state = {
        "camera_present": _camera is not None,
        "right_present": bool(getattr(_camera, "has_right", False)) if _camera is not None else False,
        "left_device": devmap.get("left"),
        "right_device": devmap.get("right"),
        "jpeg_quality": _jpeg_quality,
        "stream_fps": _stream_fps_cap,
        "stream_fps_actual": round(_cam_fps, 1) if _camera is not None else None,
    }
    if _overlay is not None:
        state.update(_overlay.controls())
        state["detections"] = _overlay.detections()
    else:
        state.update({"detection_enabled": False, "model_loaded": False,
                      "detect_fps": None, "detections": None})
    # The radar bar's own lock threshold lives on the tracker, not the overlay,
    # but the UI presents it alongside the TRACK class picker (one "what do we
    # follow" group), so serve it from the same endpoint.
    if _radar is not None:
        try:
            state["track_conf"] = _radar.status().get("track_conf")
        except Exception:  # noqa: BLE001 — a status read must not break the panel
            pass
    return state


@app.get("/api/camera")
async def get_camera(_: str = Depends(auth.require_api_key)):
    """Camera + detection control state (FPS caps, JPEG quality, detection)."""
    return _camera_state()


@app.post("/api/camera")
async def set_camera(payload: dict, _: str = Depends(auth.require_api_key)):
    """Adjust the camera feed / detection at runtime.

    Accepts any subset of: jpeg_quality (20-95), stream_fps (1-60),
    detection_enabled (bool), detect_max_fps (0.5-30), conf (0.05-0.95),
    imgsz (160-640), track_class (class label to lock onto, "" = auto),
    track_conf (0-1, min confidence for the radar bar to lock a target),
    buoy_enabled (bool — the classical colour/shape buoy screen).
    Capture resolution / camera FPS are set in config.yaml (restart);
    which device is left/right is set live via POST /api/camera/devices.
    """
    global _jpeg_quality, _stream_fps_cap
    if "jpeg_quality" in payload:
        try:
            _jpeg_quality = max(20, min(95, int(payload["jpeg_quality"])))
        except (TypeError, ValueError):
            pass
    if "stream_fps" in payload:
        try:
            _stream_fps_cap = max(1.0, min(60.0, float(payload["stream_fps"])))
        except (TypeError, ValueError):
            pass
    if _overlay is not None:
        _overlay.apply_controls(payload)
    # When the vision pipeline is wired it OWNS overlay.enabled (it gates YOLO on
    # the Tier-1 anomaly trigger), so route the operator's detection toggle to
    # the pipeline — otherwise the pipeline would just overwrite it next frame.
    if "detection_enabled" in payload and _pipeline is not None:
        try:
            _pipeline.set_yolo_enabled(bool(payload["detection_enabled"]))
        except Exception:  # noqa: BLE001
            pass
    # Keep the radar bar tracking the same class the operator picked for vision.
    if "track_class" in payload and _radar is not None:
        try:
            _radar.set_track_class(payload["track_class"])
        except Exception:  # noqa: BLE001 — never let the UI control 500
            pass
    # How confident a detection must be before the bar swings at it. Separate
    # from `conf` on purpose: the overlay draws and maps weak contacts, the bar
    # should only chase ones worth the motion.
    if "track_conf" in payload and _radar is not None:
        try:
            _radar.set_min_track_conf(float(payload["track_conf"]))
        except (TypeError, ValueError):
            pass
        except Exception:  # noqa: BLE001 — never let the UI control 500
            pass
    return _camera_state()


# ---- Camera recordings (manual capture + Tesla-style sentry clips) ----
# The recorder saves clips to disk on the Pi. A background feed keeps a rolling
# pre-roll buffer while sentry mode is armed, so an auto-clip captures the
# seconds before a critical event (CRITICAL vision threat, hull leak, pod leak).
# All heavy OpenCV work runs off the event loop via asyncio.to_thread.

def _sentry_reasons() -> list[str]:
    """Critical conditions, right now, that sentry mode should record."""
    reasons: list[str] = []
    if _pipeline is not None:
        try:
            pt = _pipeline.vision_state().get("primary_threat")
            if pt and pt.get("threat_level") == "CRITICAL":
                reasons.append("critical-threat:" + str(pt.get("class_name", "obj")))
        except Exception:  # noqa: BLE001 — never let a status read break the feed
            pass
    tel = getattr(_pico, "telemetry", None)
    # "--" = the Pico has no hull leak switches at all (GP19/GP20 became the drive
    # ESC outputs on 2026-07-30). Absence of a sensor is not a leak — treat it like
    # DRY here, but note it is NOT a claim the hull is dry; the pod leak sensor
    # below is the only real leak alarm now.
    if tel is not None and getattr(tel, "hull", "DRY") not in ("DRY", "--", None, ""):
        reasons.append("hull-leak")
    if _pod is not None:
        latest = getattr(_pod, "latest", None)
        if latest is not None and getattr(latest, "leak_detected", False):
            reasons.append("pod-leak")
    return reasons


def _sim_sentry_frame():
    """Synthetic frame for simulator mode (no camera) so the recorder still
    produces meaningful, playable clips: a dark HUD with live sim telemetry."""
    import cv2
    import numpy as np
    w, h = 640, 360
    img = np.full((h, w, 3), 16, np.uint8)
    for x in range(0, w, 40):
        cv2.line(img, (x, 0), (x, h), (30, 28, 24), 1)
    for y in range(0, h, 40):
        cv2.line(img, (0, y), (w, y), (30, 28, 24), 1)
    tel = getattr(_pico, "telemetry", None)

    def _num(v, fmt):
        return fmt.format(v) if isinstance(v, (int, float)) else "--"
    cv2.putText(img, "D.R.E.A.M.S  SENTRY (SIM)", (16, 36),
                cv2.FONT_HERSHEY_SIMPLEX, 0.7, (60, 170, 255), 2, cv2.LINE_AA)
    cv2.putText(img, time.strftime("%Y-%m-%d %H:%M:%S"), (16, h - 18),
                cv2.FONT_HERSHEY_SIMPLEX, 0.55, (210, 225, 240), 1, cv2.LINE_AA)
    lines = [
        "LAT " + _num(getattr(tel, "lat", None), "{:.5f}"),
        "LON " + _num(getattr(tel, "lon", None), "{:.5f}"),
        "HDG " + _num(getattr(tel, "heading", None), "{:.0f} deg"),
        "SPD " + _num(getattr(tel, "speed_knots", None), "{:.1f} kn"),
        "HULL " + str(getattr(tel, "hull", "--")),
    ]
    for i, ln in enumerate(lines):
        cv2.putText(img, ln, (16, 82 + i * 30),
                    cv2.FONT_HERSHEY_SIMPLEX, 0.6, (250, 230, 120), 1, cv2.LINE_AA)
    return img


@app.get("/api/recordings")
async def list_recordings(_: str = Depends(auth.require_api_key)):
    """Sentry/record status + all saved clips (newest first)."""
    if _recorder is None:
        return {"available": False, "sentry_enabled": False,
                "recording": False, "clips": []}
    st = await asyncio.to_thread(_recorder.status)
    clips = await asyncio.to_thread(_recorder.list_clips)
    return {"available": True, **st, "clips": clips}


@app.post("/api/recordings/start")
async def start_recording(_: str = Depends(auth.require_api_key)):
    """Begin a manual clip (runs until /stop)."""
    if _recorder is None:
        return Response(status_code=503, content="recorder unavailable")
    meta = await asyncio.to_thread(_recorder.start_manual)
    return {"status": "recording", "clip": meta}


@app.post("/api/recordings/stop")
async def stop_recording(_: str = Depends(auth.require_api_key)):
    """Finalise the current clip."""
    if _recorder is None:
        return Response(status_code=503, content="recorder unavailable")
    meta = await asyncio.to_thread(_recorder.stop)
    return {"status": "stopped", "clip": meta}


@app.post("/api/recordings/sentry")
async def set_sentry_mode(payload: dict, _: str = Depends(auth.require_api_key)):
    """Arm/disarm sentry mode: {"enabled": bool}."""
    if _recorder is None:
        return Response(status_code=503, content="recorder unavailable")
    if "enabled" in payload:
        _recorder.set_sentry(bool(payload["enabled"]))
    return await asyncio.to_thread(_recorder.status)


@app.delete("/api/recordings/{name}")
async def delete_recording(name: str, _: str = Depends(auth.require_api_key)):
    """Delete a saved clip + its metadata."""
    if _recorder is None:
        return Response(status_code=503, content="recorder unavailable")
    ok = await asyncio.to_thread(_recorder.delete_clip, name)
    if not ok:
        return Response(status_code=404, content="clip not found")
    return {"status": "deleted", "file": name}


@app.post("/api/recordings/{name}/favorite")
async def favorite_recording(name: str, payload: dict,
                             _: str = Depends(auth.require_api_key)):
    """Pin/unpin a clip: {"favorite": bool}. Favorites are never auto-deleted."""
    if _recorder is None:
        return Response(status_code=503, content="recorder unavailable")
    fav = bool(payload.get("favorite", True))
    m = await asyncio.to_thread(_recorder.set_favorite, name, fav)
    if m is None:
        return Response(status_code=404, content="clip not found")
    return {"status": "ok", "file": name, "favorite": m.get("favorite", False)}


@app.get("/api/recordings/{name}")
async def get_recording(name: str, request: Request):
    """Serve a clip for the <video> tag. Auth via ?key= like /video."""
    if not _http_key_ok(request):
        return Response(status_code=403, content="Invalid or missing API key")
    if _recorder is None:
        return Response(status_code=503, content="recorder unavailable")
    path = _recorder.clip_path(name)
    if path is None:
        return Response(status_code=404, content="clip not found")
    mime = "video/webm" if path.suffix == ".webm" else "video/mp4"
    # No `filename=` → inline (no attachment disposition) so the <video> tag
    # plays it; the dashboard's download button uses an <a download> instead.
    return FileResponse(str(path), media_type=mime)


# ---- Three-tier vision pipeline (Tier-1 segmentation + threat tracking) ----
# These drive pi5/cv/pipeline.py's SurveyVisionPipeline. All degrade to 503 when
# no pipeline is wired (simulator mode / no camera).

@app.get("/vision/status")
async def vision_status(_: str = Depends(auth.require_api_key)):
    """Current pipeline state: toggles, water state, anomaly score, threat."""
    if _pipeline is None:
        return {"available": False, "yolo_enabled": False,
                "segmentation_enabled": False}
    st = _pipeline.vision_state()
    st["available"] = True
    return st


@app.get("/vision/threats")
async def vision_threats(_: str = Depends(auth.require_api_key)):
    """List current CRITICAL/WARNING threats with class, distance, and bearing."""
    if _pipeline is None:
        return {"available": False, "threats": []}
    return {"available": True, "threats": _pipeline.threats()}


@app.post("/vision/yolo/toggle")
async def toggle_yolo(_: str = Depends(auth.require_api_key)):
    """Toggle Tier-2 YOLO classification on/off."""
    if _pipeline is None:
        return Response(status_code=503, content="vision pipeline not available")
    state = _pipeline.set_yolo_enabled(not _pipeline.yolo_enabled)
    return {"yolo_enabled": state,
            "message": "YOLO %s" % ("enabled" if state else "disabled")}


@app.post("/vision/segmentation/toggle")
async def toggle_segmentation(_: str = Depends(auth.require_api_key)):
    """Toggle Tier-1 water segmentation on/off."""
    if _pipeline is None:
        return Response(status_code=503, content="vision pipeline not available")
    state = _pipeline.set_segmentation_enabled(not _pipeline.segmentation_enabled)
    return {"segmentation_enabled": state,
            "message": "Segmentation %s" % ("enabled" if state else "disabled")}


@app.post("/vision/avoidance/toggle")
async def toggle_avoidance(_: str = Depends(auth.require_api_key)):
    """Toggle reactive obstacle avoidance (steer-away override) on/off."""
    if _pipeline is None:
        return Response(status_code=503, content="vision pipeline not available")
    state = _pipeline.set_avoidance_enabled(not _pipeline.avoidance_enabled)
    return {"avoidance_enabled": state,
            "message": "Avoidance %s" % ("enabled" if state else "disabled")}


# ---- Camera device assignment (which /dev/video* is LEFT / RIGHT) ----
# The command center's SOURCES controls hit these. Assignments are persisted
# to a JSON file next to this module so run_hardware.py restores them on
# restart (they override config.yaml's left_device/right_device).

_CAM_DEVICES_FILE = Path(__file__).parent / "camera_devices.json"


@app.get("/api/camera/devices")
async def list_camera_devices(_: str = Depends(auth.require_api_key)):
    """Scan for attached capture devices + current left/right assignment.

    Each GET rescans, so this doubles as the "refresh" for newly plugged-in
    cameras. Devices the producer currently holds open are reported in_use
    (they aren't re-probed). In simulator mode there is no camera producer
    and available=false is returned.
    """
    if _camera is None:
        return {"available": False, "devices": [], "left": None, "right": None,
                "detail": "no camera producer (simulator mode)"}
    from pi5.cv.camera import scan_devices
    loop = asyncio.get_running_loop()
    devices = await loop.run_in_executor(None, scan_devices, _camera.active_devices())
    devmap = _camera.device_map
    # An assigned-but-dead device (e.g. unplugged left camera) won't probe —
    # still list it so the UI can show what's currently assigned.
    known = {d["index"] for d in devices}
    for role in ("left", "right"):
        idx = devmap[role]
        if idx is not None and idx not in known:
            devices.append({"index": idx, "name": "(assigned, not responding)",
                            "in_use": False})
    devices.sort(key=lambda d: d["index"])
    return {"available": True, "devices": devices,
            "left": devmap["left"], "right": devmap["right"],
            "left_open": devmap["left_open"], "right_open": devmap["right_open"]}


@app.post("/api/camera/devices")
async def set_camera_devices(payload: dict, _: str = Depends(auth.require_api_key)):
    """Assign capture devices: {"left": <index>, "right": <index>|null}.

    right=null runs single-camera (stereo off). The producer swaps live —
    no restart — and the choice is persisted so it survives restarts.
    """
    from fastapi import HTTPException
    if _camera is None:
        raise HTTPException(status_code=503,
                            detail="No camera producer running (simulator mode)")
    try:
        left = int(payload["left"])
    except (KeyError, TypeError, ValueError):
        raise HTTPException(status_code=400,
                            detail="'left' (int device index) is required")
    right_raw = payload.get("right")
    right = None
    if right_raw is not None and right_raw != "":
        try:
            right = int(right_raw)
        except (TypeError, ValueError):
            raise HTTPException(status_code=400, detail="'right' must be an int or null")
    if right == left:
        raise HTTPException(status_code=400,
                            detail="left and right must be different devices")
    result = await _camera.set_devices(left, right)
    try:
        import json
        payload = json.dumps({"left_device": left, "right_device": right})

        def _persist() -> None:
            tmp = _CAM_DEVICES_FILE.with_suffix(".json.tmp")
            tmp.write_text(payload, encoding="utf-8")
            tmp.replace(_CAM_DEVICES_FILE)

        await asyncio.to_thread(_persist)  # keep the write off the event loop
    except OSError as e:  # noqa: BLE001 — persistence is best-effort
        logger.warning("Could not persist camera assignment: %s", e)
    return {"status": "ok", **result}


# ---- Radar-bar stepper (Pi 5 GPIO, via RadarTracker) ----
# Commands only flip flags on the tracker; the tracker's own daemon thread does
# the (blocking) stepping, so these handlers never stall the event loop. The
# stepper lives on the Pi 5 40-pin header — the one place this project uses Pi 5
# GPIO directly (everything else is USB). Absent off-Pi / in sim → available:false.

_STEPPER_COMMANDS = ("SCAN", "STOP", "GOTO", "JOG", "CENTER", "SLEEP", "WAKE", "TRACK", "HOLD",
                     "TRACK_ONLY")


def _stepper_iface():
    """The active stepper interface: prefer the tracker, fall back to raw."""
    return _radar or _stepper


@app.get("/stepper/status")
async def stepper_status(_: str = Depends(auth.require_api_key)):
    """Current radar-bar angle / mode / lock state."""
    iface = _stepper_iface()
    if iface is None:
        return {"available": False, "angle": None, "state": None,
                "target_locked": False}
    try:
        return iface.status()
    except Exception as e:  # noqa: BLE001
        return {"available": False, "error": str(e)}


@app.post("/stepper/command")
async def stepper_command(payload: dict, _: str = Depends(auth.require_api_key)):
    """Drive the radar bar. Body: {"command": <cmd>, "value": <degrees>}.

    Commands: SCAN | STOP | GOTO | JOG | CENTER | SLEEP | WAKE | TRACK | HOLD |
    TRACK_ONLY. GOTO takes an absolute angle; JOG a signed relative pan
    (+ = right/CW, - = left/CCW). Both are clamped to the bar's travel limits.

    TRACK_ONLY pins the bar to TRACK: it holds through a dropout instead of
    falling back to a sweep, and the vision pipeline's automatic SCAN requests
    are ignored. `{"command": "TRACK_ONLY", "value": false}` releases the pin,
    as does an operator SCAN.
    """
    cmd = str(payload.get("command", "")).upper()
    if cmd not in _STEPPER_COMMANDS:
        from fastapi import HTTPException
        raise HTTPException(status_code=400,
                            detail="command must be one of %s" % (_STEPPER_COMMANDS,))
    if _radar is None:
        return {"ok": False, "error": "stepper/radar tracker not running (hardware-only)"}
    try:
        if cmd == "GOTO":
            val = payload.get("value")
            if val is None:
                from fastapi import HTTPException
                raise HTTPException(status_code=400, detail="GOTO needs 'value' (degrees)")
            _radar.goto(float(val))
        elif cmd == "JOG":
            val = payload.get("value")
            if val is None:
                from fastapi import HTTPException
                raise HTTPException(status_code=400, detail="JOG needs 'value' (signed degrees)")
            _radar.jog(float(val))
        elif cmd == "TRACK_ONLY":
            # value omitted → engage the pin (the button's normal use)
            val = payload.get("value")
            _radar.set_auto_rescan(not (True if val is None else bool(val)))
        elif cmd == "CENTER":
            _radar.center()
        elif cmd == "WAKE":
            _radar.wake()
        elif cmd == "STOP":
            _radar.set_mode("HOLD")
        else:  # SCAN | TRACK | HOLD | SLEEP
            _radar.set_mode(cmd)
    except ValueError as e:
        from fastapi import HTTPException
        raise HTTPException(status_code=400, detail=str(e)) from e
    return {"ok": True, "command": cmd, "status": _radar.status()}


# ---- Pico terminal (parsed-frame monitor + command sender + reflash) ----

def _pico_status_lines(state: dict) -> list[str]:
    """Build human-readable lines from the latest parsed Pico state.

    `state` is a dict the caller persists between calls so a line is emitted
    only when something changes or a throttle interval elapses.
    """
    lines: list[str] = []
    now = time.monotonic()

    if _pico is None:
        if not state.get("warned"):
            state["warned"] = True
            lines.append("ERROR: no Pico interface configured")
        return lines

    connected = bool(getattr(_pico, "connected", False))
    if connected != state.get("connected"):
        state["connected"] = connected
        lines.append("PICO: link UP" if connected
                     else "ERROR: PICO NOT CONNECTED — retrying")
    if not connected:
        return lines

    if now - state.get("tel_t", 0.0) >= 1.0:
        state["tel_t"] = now
        t = _pico.telemetry
        lines.append(
            "PICO:TEL lat=%.6f lon=%.6f hdg=%.1f spd=%.1fkn batt=%.1fV(%d%%) "
            "hull=%s L=%.0f R=%.0f health=%s" % (
                t.lat, t.lon, t.heading, t.speed_knots, t.batt_v, t.batt_pct,
                t.hull, t.mt_left, t.mt_right, t.health))

    if now - state.get("env_t", 0.0) >= 5.0:
        state["env_t"] = now
        e = _pico.environment
        lines.append(
            "PICO:ENV air=%d°C/%d%% water=%.1f°C ec=%.0f light=%d bottom=%s" % (
                e.air_temp, e.air_humidity, e.water_temp, e.water_ec,
                e.water_light, "YES" if e.bottom_contact else "no"))

    alert = getattr(_pico, "last_alert", None)
    if alert is not None:
        sig = (alert.severity, alert.code, alert.detail)
        if sig != state.get("alert_sig"):
            state["alert_sig"] = sig
            high = alert.severity.upper() in ("CRIT", "CRITICAL", "ERROR")
            prefix = "ERROR:" if high else "PICO:ALERT"
            lines.append("%s [%s] %s %s" % (prefix, alert.severity, alert.code, alert.detail))

    return lines


# Terminal command name → PicoSerial coroutine. Args are positional strings.
_PICO_COMMANDS = {
    "SET_THR": lambda p, a: p.set_throttle(int(a[0]), int(a[1])),
    "SET_WINCH": lambda p, a: p.set_winch(int(a[0])),
    "SET_HDG": lambda p, a: p.set_heading(float(a[0])),
    "ESTOP": lambda p, a: p.emergency_stop(),
    "RESUME": lambda p, a: p.resume(),
    "HB": lambda p, a: p.send_heartbeat(),
    "GET_STATUS": lambda p, a: p.get_status(),
    "REQ_TEL": lambda p, a: p.request_telemetry(),
    "POLL_POD": lambda p, a: p.poll_pod(),
}


async def _run_pico_command(text: str) -> str:
    """Parse a terminal line and dispatch it to the Pico over the live link."""
    parts = text.strip().split()
    if not parts:
        return "ERROR: empty command"
    cmd = parts[0].upper()
    fn = _PICO_COMMANDS.get(cmd)
    if fn is None:
        return "ERROR: unknown command '%s' (try: %s)" % (
            cmd, ", ".join(sorted(_PICO_COMMANDS)))
    if _pico is None:
        return "ERROR: no Pico interface"
    try:
        result = await fn(_pico, parts[1:])
    except (IndexError, ValueError):
        return "ERROR: bad arguments for %s" % cmd
    except AttributeError:
        return "ERROR: %s not supported in this mode" % cmd
    except Exception as e:  # noqa: BLE001 — surface any link error to the operator
        return "ERROR: %s failed: %s" % (cmd, e)
    return "PICO: %s → %s" % (cmd, getattr(result, "msg_type", "OK"))


@app.websocket("/ws/pico")
async def ws_pico(ws: WebSocket):
    """Bidirectional Pico terminal.

    Down: human-readable lines built from *parsed* frames (TEL/ENV/ALERT) on the
    existing PicoSerial — no second serial reader is opened. Up: text commands
    dispatched to the Pico. Auth via ?key=<api_key>.
    """
    if not await auth.validate_ws(ws):
        return
    await ws.accept()

    out_q: asyncio.Queue[dict] = asyncio.Queue()

    async def pump():
        # Single writer task — avoids concurrent sends on one socket. Guarded
        # so a broken/closing socket stops this task cleanly (the outer
        # receive loop notices the disconnect and cleans up in `finally`)
        # instead of dying with an unretrieved exception.
        state: dict = {}
        while True:
            try:
                while not out_q.empty():
                    await ws.send_json(out_q.get_nowait())
                for line in _pico_status_lines(state):
                    await ws.send_json({"line": line, "ts": time.time()})
                await asyncio.sleep(0.4)
            except Exception as e:  # noqa: BLE001
                logger.debug("Pico terminal writer stopped: %s", e)
                break

    writer = asyncio.create_task(pump())
    try:
        while True:
            text = await ws.receive_text()
            out_q.put_nowait({"line": "> " + text, "ts": time.time(), "echo": True})
            out_q.put_nowait({"line": await _run_pico_command(text), "ts": time.time()})
    except WebSocketDisconnect:
        pass
    except Exception as e:
        logger.debug("WS pico error: %s", e)
    finally:
        writer.cancel()


# Serializes hardware-reflash operations (/pico/files, /pico/file, /pico/push)
# so two concurrent admin requests can't both release+reacquire the physical
# serial port at once and race mpremote against each other.
_pico_port_lock = asyncio.Lock()


def _pico_reflash_available() -> tuple[bool, str]:
    if _sim is not None:
        return False, "Firmware push is hardware-only (simulator is running)"
    if shutil.which("mpremote") is None:
        return False, "mpremote is not installed on this host"
    if _pico is None:
        return False, "No Pico interface configured"
    return True, ""


@app.get("/pico/files")
async def pico_files(_: str = Depends(auth.require_api_key)):
    """List files on the Pico via mpremote. Hardware-only."""
    ok, reason = _pico_reflash_available()
    if not ok:
        return {"available": False, "files": [], "reason": reason}
    port = getattr(_pico, "_port", "/dev/ttyACM0")
    async with _pico_port_lock:
        was_connected = bool(getattr(_pico, "connected", False))
        if was_connected:
            await _pico.disconnect()
        try:
            rc, out = await _mpremote(port, "fs", "ls")
        finally:
            if was_connected:
                await _reconnect_pico()
    if not rc:
        return {"available": True, "files": [], "reason": out}
    files = []
    for line in out.splitlines():
        name = line.strip().split(" ")[-1]
        if name and name not in (".", ".."):
            files.append(name.lstrip(":"))
    return {"available": True, "files": files}


@app.get("/pico/file")
async def pico_file(name: str = "main.py", _: str = Depends(auth.require_api_key)):
    """Read a file off the Pico (mpremote cat) so the operator can see what's
    actually running on it. Hardware-only; briefly releases the serial link
    (same handoff as /pico/files)."""
    if "/" in name or "\\" in name or ".." in name:
        return Response(status_code=400, content="invalid filename")
    ok, reason = _pico_reflash_available()
    if not ok:
        return {"available": False, "name": name, "content": "", "reason": reason}
    port = getattr(_pico, "_port", "/dev/ttyACM0")
    async with _pico_port_lock:
        was_connected = bool(getattr(_pico, "connected", False))
        if was_connected:
            await _pico.disconnect()
        try:
            rc, out = await _mpremote(port, "fs", "cat", ":" + name)
        finally:
            if was_connected:
                await _reconnect_pico()
    if not rc:
        return {"available": True, "name": name, "content": "", "reason": out}
    return {"available": True, "name": name, "content": out}


@app.post("/pico/push")
async def pico_push(payload: dict, force: bool = False,
                    _: str = Depends(auth.require_api_key)):
    """Copy a Python file to the Pico and reset it. Hardware-only.

    Releases the serial port (stopping heartbeats — the Pico's watchdog ESTOPs,
    which is the safe state), runs mpremote, then re-acquires the port. Refuses
    while a mission is running unless force=true.
    """
    content = payload.get("content")
    filename = payload.get("filename", "main.py")
    if content is None:
        return Response(status_code=400, content="missing 'content'")
    if "/" in filename or "\\" in filename or ".." in filename:
        return Response(status_code=400, content="invalid filename")

    ok, reason = _pico_reflash_available()
    if not ok:
        return {"ok": False, "error": reason}
    if (_mission is not None and getattr(_mission.state, "running", False)
            and not force):
        return {"ok": False,
                "error": "Mission running — refusing to reflash (pass force=true)"}

    port = getattr(_pico, "_port", "/dev/ttyACM0")
    tmp = tempfile.NamedTemporaryFile("w", suffix=".py", delete=False, encoding="utf-8")
    try:
        tmp.write(content)
        tmp.close()
        async with _pico_port_lock:
            await _pico.disconnect()
            try:
                cp_ok, cp_msg = await _mpremote(port, "fs", "cp", tmp.name, ":" + filename)
                if not cp_ok:
                    return {"ok": False, "error": "copy failed: " + cp_msg}
                rst_ok, rst_msg = await _mpremote(port, "reset")
            finally:
                await _reconnect_pico()
        if not rst_ok:
            return {"ok": False, "error": "reset failed: " + rst_msg}
        return {"ok": True, "message": "pushed %s and reset Pico" % filename}
    finally:
        try:
            os.unlink(tmp.name)
        except OSError:
            pass


async def _mpremote(port: str, *args: str) -> tuple[bool, str]:
    """Run an mpremote subcommand; return (success, stderr-or-stdout)."""
    try:
        proc = await asyncio.create_subprocess_exec(
            "mpremote", "connect", port, *args,
            stdout=asyncio.subprocess.PIPE, stderr=asyncio.subprocess.PIPE,
        )
        out, err = await asyncio.wait_for(proc.communicate(), timeout=30.0)
    except (asyncio.TimeoutError, OSError) as e:
        return False, str(e)
    msg = (err or out).decode(errors="ignore").strip()
    return proc.returncode == 0, msg


async def _reconnect_pico() -> None:
    """Re-open the serial link after an mpremote operation (hardware path)."""
    if _pico is None:
        return
    try:
        await _pico.connect()
        if hasattr(_pico, "start_heartbeat"):
            await _pico.start_heartbeat()
    except Exception as e:  # noqa: BLE001
        logger.error("Failed to reconnect to Pico after reflash: %s", e)


# ---- Health background task lifecycle ----

@app.on_event("startup")
async def _start_health_loop():
    global _health_task

    async def _loop():
        global _latest_health
        while True:
            try:
                _latest_health = await _gather_health()
            except Exception as e:  # noqa: BLE001
                logger.debug("health gather failed: %s", e)
            await asyncio.sleep(1.0)

    _health_task = asyncio.create_task(_loop())


@app.on_event("shutdown")
async def _stop_health_loop():
    if _health_task is not None:
        _health_task.cancel()


# ---- Recorder feed lifecycle (rolling pre-roll + sentry auto-record) ----

@app.on_event("startup")
async def _start_recorder_feed():
    """Pump frames into the recorder and evaluate sentry triggers.

    Idles cheaply when sentry is off and nothing is recording. Uses live camera
    frames on hardware; a synthetic telemetry HUD in simulator mode so the
    feature is demonstrable end-to-end without a camera. All blocking OpenCV
    work (encode/write) is offloaded to a thread.
    """
    global _recorder_task
    if _recorder is None:
        return
    period = 1.0 / max(1.0, _recorder.cfg.fps)

    async def _loop():
        queue = None
        last_eval = 0.0
        last_prune = 0.0
        try:
            while True:
                now = time.monotonic()
                if now - last_prune > 3600.0:          # hourly age-retention sweep
                    last_prune = now
                    try:
                        await asyncio.to_thread(_recorder.prune_old)
                    except Exception:  # noqa: BLE001 — pruning must not kill the feed
                        pass
                if not (_recorder.sentry_enabled or _recorder.recording):
                    if queue is not None and _camera is not None:
                        _camera.unsubscribe(queue)
                        queue = None
                    await asyncio.sleep(0.25)
                    continue

                frame = None
                if _camera is not None:
                    if queue is None:
                        queue = _camera.subscribe()
                    try:
                        sf = await asyncio.wait_for(queue.get(), timeout=period * 3)
                        while not queue.empty():          # skip to the freshest frame
                            sf = queue.get_nowait()
                        frame = sf.left
                    except asyncio.TimeoutError:
                        frame = None
                else:
                    frame = await asyncio.to_thread(_sim_sentry_frame)

                if _recorder.sentry_enabled and (now - last_eval) > 0.33:
                    last_eval = now
                    reasons = _sentry_reasons()
                    if reasons:
                        await asyncio.to_thread(
                            lambda rs=reasons, t=now:
                            [_recorder.note_event(r, now=t) for r in rs])

                if frame is not None:
                    await asyncio.to_thread(_recorder.add_frame, frame, now)
                await asyncio.to_thread(_recorder.tick, now)

                await asyncio.sleep(max(0.0, period - (time.monotonic() - now)))
        except asyncio.CancelledError:
            pass
        except Exception as e:  # noqa: BLE001 — a feed crash must not take down the app
            logger.error("recorder feed stopped: %s", e)
        finally:
            if queue is not None and _camera is not None:
                _camera.unsubscribe(queue)

    _recorder_task = asyncio.create_task(_loop())


@app.on_event("shutdown")
async def _stop_recorder_feed():
    if _recorder_task is not None:
        _recorder_task.cancel()
    if _recorder is not None and _recorder.recording:
        try:
            _recorder.stop()
        except Exception:  # noqa: BLE001
            pass
