ka1e27/dreams/pi5/cv/vision_overlay.py

"""Live detection overlay for the command-center camera feed.

Subscribes to the shared CameraProducer and runs an Ultralytics YOLO model on
the latest frame at a capped rate (inference runs off the event loop in a
thread executor, since it's blocking/CPU-bound). It keeps a latest-boxes list
that the /video MJPEG stream draws onto each frame, plus an inference-FPS
estimate. Detection rate is decoupled from the video stream so inference never
throttles the feed — the dual-thread idea from the D.R.E.A.M.S vision test,
adapted to our async CameraProducer (one camera owner, many subscribers).

The model is configurable via config.yaml ``camera.detection.model``: it
defaults to COCO ``yolov8n.pt`` (detects boat, person, …). Drop in a
maritime-trained ``.pt`` — e.g. one trained on SeaShips / MASTR1325 / the
Singapore Maritime Dataset, or exported from a Roboflow maritime model — to
specialise for vessels and buoys. No code change: ultralytics infers the
format from the path, so an NCNN export dir works too.
"""
from __future__ import annotations

import asyncio
import logging
import os
import time
from dataclasses import dataclass, field
from pathlib import Path
from typing import TYPE_CHECKING

from .buoy_detector import BuoyDetector, BuoyDetectorConfig

if TYPE_CHECKING:
    from .stereo import StereoDepth

logger = logging.getLogger(__name__)

# Auto-preferred maritime model: if this exists and the config still points at
# the COCO default, the overlay uses it (onnxruntime backend) without any config
# edit. Trained + exported by the ml/ pipeline (see ml/README.md).
_MARITIME_ONNX = Path(__file__).parent / "models" / "maritime_yolov8n.onnx"

# BGR colours (OpenCV). Amber for highlighted classes, muted teal for the rest,
# cyan for the locked/tracked target reticle.
_COLOR_HIGHLIGHT = (0, 165, 255)
_COLOR_NORMAL = (200, 200, 120)
_COLOR_TRACK = (255, 208, 0)


@dataclass
class DetectionConfig:
    enabled: bool = True
    model: str = "yolov8n.pt"
    imgsz: int = 416
    conf: float = 0.40
    detect_max_fps: float = 8.0
    target_classes: list[str] = field(default_factory=list)            # empty = keep all
    highlight_classes: list[str] = field(default_factory=lambda: ["boat", "person"])
    track_class: str = ""    # lock the tracker to this one class; "" = auto (any highlight)
    # Per-class confidence floors, e.g. {"person": 0.25}. The model runs at the
    # LOWEST floor present and each box is then filtered by its own class's
    # threshold, so a hard-to-see swimmer can be kept at 0.25 without flooding
    # every other class with low-confidence boxes. Case-insensitive.
    #
    # These are RELATIVE to `conf`: they record how much more (or less) sensitive
    # a class should be than the global threshold, and they move with the CONF
    # slider so it stays a real master control. Before 2026-07-29 they were
    # absolute, which meant dragging CONF changed nothing at all for person /
    # swimmer / surfer / kayak — most of what the boat actually looks for.
    class_conf: dict[str, float] = field(default_factory=dict)
    # Classes whose class_conf floor is ABSOLUTE and does not track the slider,
    # because their score isn't a learned probability and so isn't comparable to
    # one. Case-insensitive.
    # ⚠ Default EMPTY. 'buoy' lived here briefly and it was a mistake: pinning
    # the floor of a class that false-positives heavily makes it the one thing
    # the operator can't filter, which is the complaint the relative floors
    # existed to fix. Reach for `buoy_fallback=False` to silence the classical
    # screen instead of pinning its threshold.
    class_conf_absolute: list[str] = field(default_factory=list)
    # Cores the inference session may use. 0/None = auto (leave headroom for the
    # rest of the stack — see pi5/cv/cpu_budget.py for why 4 is the wrong choice).
    num_threads: int = 0
    # Classical colour/shape buoy screen — supplies the 'buoy' class the COCO
    # model has no weights for. Auto-disables if the loaded model already emits
    # a 'buoy' label (i.e. a real maritime model was dropped in).
    buoy_fallback: bool = True
    buoy_cfg: "BuoyDetectorConfig | None" = None
    # Run the detector on the RIGHT frame too. Off by default: it is a second
    # full forward pass, so it roughly halves detection FPS (~30 ms/frame on this
    # Pi 5 — see cpu_budget.py). The only consumer is the radar tracker, which
    # medians the two cameras' box centres for a less noisy bearing; with this
    # off it falls back to the left camera's centre alone, which is what it has
    # always used. Stereo *distance* does NOT need this — that's a disparity
    # pass, not a detection.
    detect_right: bool = False


class DetectionOverlay:
    """Runs YOLO on the camera producer and exposes boxes + controls."""
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
