ka1e27/dreams/pi5/comms/gps_nmea.py

"""Pi-side NMEA GPS reader — the u-blox M10 on the Pi 5 header UART.

**Why the GPS is on the Pi and not the Boat Pico.** Every other sensor on this
boat hangs off a Pico (see ``docs/pin_map.md``), but the GPS can't: on the
as-built board the Pico's **GP9 is hard-shorted to GND** (one solder blob across
Pico pads 12/13/14, which also kills GP10's status NeoPixel and I²C0), and GP9 is
both J7.3 — the connector the GPS TX lands on — and UART1 RX. The module's TX
drove straight into that short. Rather than rework the board, the GPS moved to the
**Pi 5 40-pin header**, which routes around the fault entirely.

Wiring, measured on the bench 2026-07-29:
    module TX  → Pi **GPIO15** (header pin 10, RXD0)   ← the only wire that matters
    module VCC → Pi 3V3/5V (per the module's rating)
    module GND → Pi GND
    module RX  ← Pi GPIO14 (header pin 8, TXD0)        ← optional, see below

**The UART is not enabled by default.** GPIO14/15 are muxed to *no function* on a
fresh Pi 5, so ``/dev/ttyAMA0`` does not exist until::

    dtoverlay=uart0        # in /boot/firmware/config.txt  (persists)
    sudo dtoverlay uart0   # or at runtime, no reboot needed

✅ Unlike a Pi 4, the **serial console does not conflict** here: ``console=serial0``
resolves to ``ttyAMA10``, the Pi 5's separate 3-pin debug-UART connector. Nothing
needs stopping.

**Baud is 38400, not 9600.** That is the u-blox **M10** factory default (M8 used
9600, which is where ``firmware/boat-pico/gps.py``'s number came from). Measured
directly off the line: 5th-percentile pulse width 24.6 µs ≈ 26.0 µs/bit. The
constellation mix also identifies the part — GP+GA+GB+GQ (GPS/Galileo/BeiDou/QZSS,
**no GLONASS**) is the M10 default set.

⚠ **GPIO14/15 collide with ``pi5/scripts/am32_config.py``**, which flashes AM32 ESCs
over ``/dev/ttyAMA0`` on these same two pins. The GPS must be unplugged to configure
an ESC, and vice versa.

⚠ **The Pi's TX may not be wired.** Five ``UBX-MON-VER`` polls got no reply on the
bench, so GPIO14 probably isn't landing on the module's RX. Harmless — NMEA is
unsolicited, so reading works regardless — but it means the module **cannot be
reconfigured** (baud, update rate, constellations) from the Pi until that wire
exists. This class is read-only by design and never writes to the port.

Everything here is **parse-only and I/O-free** except :class:`NmeaGps`, so the
sentence handling is unit-testable with no serial port and no Pi.
"""
from __future__ import annotations

import asyncio
import logging
import math
import time
from collections.abc import Callable
from dataclasses import dataclass, field
from typing import Any

logger = logging.getLogger(__name__)
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
