ka1e27/dreams/(commit log)

2026-04-08 Add full Pi 5 autonomous boat system
    - Serial protocol spec (Pi 5 <-> Boat Pico over USB)
    - Refactored MicroPython firmware (boat-pico + pod-pico)
    - Pi 5 navigation engine (async serial, navigator, mission manager, simulator)
    - FastAPI dashboard API with WebSocket telemetry and camera streaming
    - React dashboard (Leaflet map, live telemetry, mission planning, sensor charts)
    - Cloud data pipeline (PostGIS, batch ingest, heatmap viewer)
    - Security: API key auth, rate limiting, WebSocket auth, Caddy HTTPS
    - CI/CD: GitHub Actions for Python tests, React builds, cloud API
    - 5 Architecture Decision Records documenting all design choices
    - 50+ pytest test cases for nav math, protocol parsing, missi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
2026-04-09 Add simulator dashboard, pressure sensor, and navigation improvements
    - Add run_sim.py entry point for running the full simulation locally
    - Add dark naval-themed dashboard with Leaflet map, live telemetry,
    compass, depth gauge, waypoint markers, and boat tracking
    - Add pressure depth sensor across full stack (pod firmware → Pi5 → API)
    - Fix differential steering: simulator turning direction now matches
    real catamaran physics (left motor faster → turn right)
    - Add distance-based speed ramp: throttle scales down on approach and
    when heading error is large
    - Add skip-site feature: abort current data waypoint and continue mission
    - Simulate realistic depth-varying sensor data (therm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
2026-05-09 Switch propulsion to VESC, add stereo CV, dual battery, BNO085, M10Q, SBUS, WiFi mode
    Hardware changes:
    - VESC drives over UART0 (master) + CAN forward to slave; replaces hobby PWM
    ESCs. Motor temperature now comes from VESC telemetry, freeing GP27 for a
    second battery monitor.
    - 12S LiPo for propulsion on GP26 (new divider) + 3S Li-ion for electronics
    on GP27 (existing 15/115 divider). Independent low/critical alerts.
    - Winch keeps standard PWM ESC on GP14; spool can be swapped to repurpose
    for fishing (dashboard mode label only, no firmware behavior change).
    - u-blox M10Q GPS (NMEA at 9600 baud, optional UBX-CFG-VALSET burst at init
    to silence GLL/GSA/GSV/VTG).
    - BNO085 IMU on I2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
2026-05-09 Add hardware documentation: system tree, wiring schematic, pin map
    Three reference documents under docs/:
    - system_tree.md: Mermaid flowchart with subgraphs for the three power
    domains (12S propulsion, 6S midpoint tap, 3S Li-ion logic), the sealed
    bay, propulsion cluster, and underwater pod. Connector type + protocol
    on every edge. Future / mode-swap components (fishing-reel spool, pod
    leak sensor, slip ring) drawn dashed.
    - wiring_diagram.html: standalone "engineering blueprint" schematic.
    Dark-navy plotter paper with cyan grid, color-coded power domains
    (red 12S / orange 6S tap / teal 3S / lime signal). Pin-labeled
    chip-style Boat Pico, every wire routed on a strict Manhatta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
2026-06-08 Commit V2 hardware docs, KiCad project, firmware and test additions
    Adds the V2 documentation set (CLAUDE.md, changelog/decisions, hardware
    changes, PCB design notes, session journal), the Boat_PCB KiCad project,
    the status LED firmware module, and new Pi5 loop tests. Removes the old
    wiring_diagram.html (superseded by system_tree.md + pcb docs). Ignores
    KiCad local/temp artifacts.
2026-06-08 Add /command HUD: camera MJPEG, Pi5 health, Pico terminal
    Extends the Pi5 FastAPI server with a self-contained naval-HUD command
    center at /command, plus the endpoints behind it. Reuses the existing
    hardware owners instead of double-opening devices:
    - /video MJPEG subscribes to the shared CameraProducer (no second
    VideoCapture); near-black placeholder when no camera.
    - /ws/pico streams parsed TEL/ENV/ALERT frames off the existing
    PicoSerial and dispatches real protocol commands (no second serial
    reader). Push-to-Pico (/pico/push, /pico/files) reflashes via mpremote
    with a safe port handoff; hardware-only, refuses mid-mission.
    - /health + /ws/health report vcgencmd (async subprocess)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
2026-06-08 Fix /ws/health reconnect-loop when psutil is missing
    _gather_health() did a bare `import psutil`; if psutil wasn't installed
    the ImportError propagated, ws_health exited, and the socket closed on
    connect — so the dashboard auto-reconnected every 2s in an open/close
    loop (and /health returned 500). Now the psutil block degrades to None
    (UI shows N/A), matching the off-Pi vcgencmd contract, and the /ws/health
    loop catches per-tick errors and keeps the socket open. A missing
    optional health source can no longer tear down the connection.
2026-06-08 Add command-center nav buttons, COMMANDS panel, and Pico-monitor scroll fix
    - static/index.html + command_center.html: cross-page nav buttons
    (Dashboard / Command Center / API).
    - command_center.html: new buttons-only COMMANDS panel (SAFETY / MISSION
    / NAV) that POSTs to /api/* and toasts results, with an Upload-Mission
    modal. Reuses existing apiHeaders()/toast().
    - command_center.html: fix Pico monitor scroll — pin the grid row and
    give .term its own overflow so new lines scroll inside the terminal
    instead of pushing the SEND/CLEAR bar down.
    Verified in simulator: both pages serve, command endpoints respond.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
2026-06-08 Add run_hardware.py and expand command-center health metrics
    - run_hardware.py (new): hardware entry point that wires a real
    PicoSerial (USB CDC + heartbeat) and CameraProducer into the app via
    configure(simulator=None, camera=...), so /command shows the live
    camera, real Pico telemetry/commands, and real health on the Pi.
    Loads pi5/config.yaml; degrades gracefully if camera/Pico fail to open.
    - Health panel: added swap, uptime, process count, load average (1/5/15),
    live network throughput (down/up), and SDRAM voltage. Each shows N/A
    when its source is unavailable; net rate tracked via a _net_prev delta.
    Verified in simulator: ruff clean, /health returns new fields, both
    launche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
2026-06-08 Auto-deploy Boat Pico firmware on boot + Pod Pico status light
    - pi5/scripts/deploy_pico.py (new): upload firmware/boat-pico/*.py to the
    Pico via `python -m mpremote` and reset it (batch copy w/ per-file
    fallback; works under systemd PATH). pi5/scripts/__init__.py makes it
    importable.
    - run_hardware.py: on startup deploys firmware + waits for reboot before
    opening the serial link, gated by serial.deploy_on_start (config.yaml,
    default true). Never blocks startup on deploy failure.
    - pi5/services/dreams.service (new): systemd unit to run the stack on boot
    (deploys firmware, then serves). Boot chain: power -> upload -> reset ->
    connect -> serve.
    - Command center: POD link light in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
2026-06-08 Add live detection overlay + adjustable camera/FPS to command center
    Incorporates the vision approach from the D.R.E.A.M.S-Vision-Test repo,
    adapted onto our async CameraProducer (no second VideoCapture):
    - pi5/cv/vision_overlay.py (new): DetectionOverlay subscribes to the
    shared producer and runs YOLO on a rate-capped asyncio task with
    inference off the event loop, so detect FPS is decoupled from stream
    FPS. Draws boxes (highlight classes in amber). Model + classes are
    config-driven (default COCO yolov8n; drop in a maritime .pt to
    specialise) and degrade to None if ultralytics/model is missing.
    - app.py: /video draws boxes on a copy, caps publish rate, uses runtime
    JPEG quality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
2026-06-08 Camera 10->30 fps (MJPG) + view on-Pico code from command center
    FPS: producer captured at 10 fps with no MJPG and the new stream cap was 15.
    - config.yaml: camera.fps 10->30, use_mjpg true, stream_fps 15->30.
    - pi5/cv/camera.py: _open() requests MJPG before resolution (far faster over
    USB, needed for 30 fps; falls back if unsupported), BUFFERSIZE=1, logs the
    negotiated resolution/fps. CameraConfig gains use_mjpg, default fps 30.
    - run_hardware.py: passes use_mjpg through.
    View on-Pico code: operators could not see what is actually on the Pico.
    - app.py: GET /pico/file reads a file via mpremote cat (same brief serial
    handoff as /pico/files; path-traversal guarded).
    - command_center.ht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
2026-06-08 Add cooperative REFLASH command so boot auto-deploy can take the port
    The Boat Pico firmware continuously reads sys.stdin.buffer for its command
    protocol, which swallows mpremote raw-REPL handshake bytes, so mpremote
    could not enter the REPL to copy files while the firmware was running
    (could not enter raw repl).
    - serial_handler.py: REFLASH command + reflash_requested flag (ACK, then
    signal the main loop).
    - main.py: task_serial_rx polls the flag, calls motor_control.estop() and
    raises SystemExit to drop the asyncio loop to the bare REPL, freeing the
    USB CDC for mpremote.
    - deploy_pico.py: _request_repl() sends a REFLASH frame over pyserial and
    waits before the mpremote copy; best-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
2026-06-08 Fix blocking Pico serial read (likely root cause of HB timeout + REFLASH)
    serial_handler.read_usb() used sys.stdin.buffer.read(64), a blocking read
    that waits for 64 bytes. Heartbeats (~10 B) and the REFLASH frame (~12 B)
    never fill 64 B promptly, so they sat unprocessed: HB ACKs arrived too late
    (watchdog ESTOP = the HB-timeout symptom) and REFLASH never registered.
    - serial_handler.py: non-blocking read via select.poll(sys.stdin), reading
    one byte at a time while data is available.
    - main.py: replace asyncio.gather with create_task + a monitor loop that
    waits on reflash_requested, then estops, cancels tasks and returns to the
    REPL (more reliable than raising SystemExit in a gathered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
2026-06-08 Self-heal serial read loop on disconnect; hide Sim Speed on hardware
    PicoSerial read loop caught the disconnect error, slept 0.1s, and retried
    the same dead connection forever without reconnecting (the device-disconnected
    / multiple-access-on-port error loop on push).
    - pico_serial.py: read loop now closes and re-opens the serial streams with a
    0.5 to 5s backoff on any read error, and treats an empty read as a
    disconnect. Added _open_streams and _close_streams; connect uses them. A
    Pico reset, reflash, or transient port contention now recovers cleanly.
    - static/index.html: wrap the Sim Speed control in simSpeedControl and hide it
    when sim speed is null (hardware mode). Other sliders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
2026-06-08 Add radar-bar stepper control (A4988 on Pi 5 GPIO)
    Implements the radar-bar pan mechanism per DREAMS_stepper_instruction(1).md:
    an A4988-driven NEMA-17 stepper run directly off the Pi 5 40-pin header and
    coordinated with the YOLO detection overlay.
    - pi5/cv/stepper.py: StepperMotor via gpiozero/lgpio; falls back to a no-op
    mock when those libs are absent, so run_sim.py + the test suite still work
    off-Pi. Ramped stepping, absolute position tracking, sleep/wake, auto-sleep,
    scan/scan_async, travel clamping (0-180 without a slip ring).
    - pi5/cv/radar_tracker.py: RadarTracker — SCAN/TRACK/HOLD/SLEEP on a single
    daemon thread that is the sole motion authority, so the blocking pulse tra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
2026-06-08 Add dual-SHT41 air temp/humidity firmware (re-pin to as-built board)
    Prior-session firmware work, committed now at the user's request. Replaces the
    single DHT11 (GP16, not present on the fabricated board) with two Sensirion
    SHT41 I2C modules on SoftI2C buses, matching the as-built Boat PCB.
    - firmware/boat-pico/sht41.py (new): bus-agnostic SHT4x driver (addr 0x44,
    cmd 0xFD high-precision, 6-byte read, CRC8 poly 0x31, tick->C/%RH),
    degrade-safe.
    - firmware/boat-pico/sensors.py: drop DHT11; add SHT41 #A (GP12/13, J11) and
    #B (GP14/15, J13) on SoftI2C (HW I2C0 is held by the BNO085 on GP8/9).
    read_all_slow() reads both SHT41s + hull.
    - firmware/boat-pico/main.py: pin-map docstring, boo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
2026-06-08 Drop "No MCP2515 CAN chip or HAT" note from pcb_design_notes
    Remove the stale "What Is NOT on Boat_PCB" bullet at the user's direction.
2026-06-08 Command center: camera L/R switch, object-track viz, boat health, manual 0-360 stepper pan
    - /video gains ?cam=left|right (overlay on left only; right falls back); SOURCE
    toggle in the UI, gated by CameraProducer.has_right / right_present.
    - DetectionOverlay tracks a primary target and draws a lock reticle; surfaced as
    an on-feed TRACKING badge + radar tracked-target readout. RadarTracker.status()
    reports the locked target and a separate auto-scan sweep range.
    - New BOAT HEALTH panel: battery, hull, heading/speed, motor temps, GPS, water/air,
    decoded 6-flag sensor health, last alert; hull leak raises the banner.
    app._gather_health() adds boat/track/stepper_target via _boat_health()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
2026-06-08 Boat health: 3 battery rails (12S/4S/3S), dual air/enclosure T+RH, L/R hull
    - Extend ENV -> v1.1 with backward-compatible appended fields: enclosure SHT41
    (#B) temp/humidity + 3S electronics and 4S winch battery rails. 12S stays in
    TEL as batt_v. Parser reads fields 6-11 only when present (v1.0 firmware works).
    - Firmware: add a 4S winch ADC read on GP28 (PCB BT4 100k/18k divider,
    provisional); send_env appends the 6 new fields; task_env_telemetry passes
    SHT41 #B + elec + winch; pin-map docstring/boot prints updated.
    - pico_serial Environment gains enc_temp/humidity + elec/winch v/pct; _handle_env
    parses the appendix. Simulator emits 3 rails + an enclosure SHT41 (warmer/drier
    tha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
2026-06-08 Add live IMG (inference size) control — the real detect-FPS lever
    detect_max_fps is an upper cap, not a target: the overlay runs YOLO back-to-back
    and only drops frames that arrive faster than the cap, so raising it can't speed
    up inference. ~4 fps is just yolov8n @ imgsz 416 on the Pi 5 CPU. The lever is
    imgsz, which was fixed at startup.
    - vision_overlay.apply_controls() now accepts imgsz (clamp 160-640, snap to /32);
    applies on the next frame, no reload. controls() already exposed it, so
    GET/POST /api/camera carry it with no app.py change.
    - command_center: IMG dropdown (256/320/416/512/640) by DET FPS, wired to
    /api/camera (loads from c.imgsz, posts on change, default 416); ⓘ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
2026-06-08 Add maritime YOLOv8 training pipeline (ml/) + onnxruntime inference backend
    Implements the maritime-ML instruction: a laptop/Colab pipeline that trains a
    6-class maritime YOLOv8n (vessel/kayak/buoy/person/dock/debris), exports ONNX,
    and an onnxruntime inference path on the Pi 5.
    Divergences from the instruction (written against a simpler repo model), flagged:
    - Detection lives in pi5/cv/vision_overlay.py, not camera.py — integrated there;
    camera.py left untouched.
    - "use onnxruntime not ultralytics": added a native onnxruntime backend
    (pi5/cv/onnx_detector.py: letterbox + numpy decode + per-class NMS) for .onnx
    models, keeping the ultralytics path as the .pt fallback (lightweight Pi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
2026-06-08 Command center: move Pico terminal to page bottom + choose CV track target
    Move the PICO TERMINAL panel to the bottom of /command (header → camera/health
    → boat health → radar → commands → terminal); grid rows now
    auto 1fr auto auto auto 1fr so the terminal keeps its bounded, internally-
    scrolling height.
    Add a TRACK class picker that drives both the vision overlay's lock reticle and
    the radar bar. DetectionConfig.track_class ("" = AUTO) locks the primary target
    onto a chosen class (and highlights it); controls() exposes track_class +
    available classes; RadarTracker.set_track_class() filters its best-target to the
    same class; POST /api/camera forwards track_class to the radar trac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
2026-06-09 IMX219 5fps fix (force V4L2) + draw detection boxes on both camera views
    Camera was stuck at ~5 fps because the IMX219 (raw sensor, native 8MP)
    ignored the 640x480/MJPG cap.set() and stayed full-res. Force the V4L2
    backend on Linux so the format switch actually applies; warn on negotiated
    fps/resolution mismatch. Draw the overlay boxes+reticle on the right view
    too (no second inference; left-frame boxes offset by stereo disparity).
2026-06-09 Stepper: honest test verdict + A4988 RESET handling
    stepper_test.py passed every check while the motor never moved: step()
    counts steps in software regardless of whether any pin toggles, so PASS
    proved the math, not motion.
    - stepper_test.py: verdict now distinguishes mock from real. mock on a Pi
    prints the lgpio/gpiozero install fix and exits 2; off-Pi mock stays a
    pass; real GPIO prints a watch-the-bar note + RESET/VMOT/VREF checklist.
    - stepper.py: add optional reset_pin held HIGH while energised (A4988 RESET
    is active-LOW and must be HIGH to step); document the jumper-to-SLEEP
    default and the RESET-must-be-HIGH gotcha.
    - run_hardware.py + config.yaml: plumb/document stepper.rese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
2026-06-09 Camera: offload capture read + JPEG encode off the asyncio event loop
    cap.read() (grab + MJPEG decode) and cv2.imencode() were both blocking the
    single event loop, so capture and the /video encode serialized instead of
    overlapping — at 1080p (~10-25ms each) the published stream sagged below the
    capture rate. Run both via run_in_executor; cv2 releases the GIL in those
    calls so they now parallelize. (YOLO inference was already offloaded.)
    This removes the software ceiling; it does not override a 15-fps camera mode
    (the more likely cause of the IMX219 ~16fps at 1080p — see journal).
2026-06-09 Camera: capture in YUY2/YUYV instead of MJPG (configurable FourCC)
    Replace the use_mjpg bool with a fourcc string (default MJPG); default the
    camera to YUY2. YUY2 and YUYV are the same uncompressed 4:2:2 layout under
    different FourCC labels, but V4L2 only recognizes YUYV — so map YUY2->YUYV on
    Linux. _open() now logs the negotiated FourCC and the low-fps warning is
    format-aware. At 640x480 YUY2 is light and should hit a clean 30fps without
    the MJPG-mode fps cap; uncompressed 1080p30 needs USB 3.0 (flagged in config).
2026-06-09 Camera: auto-reconnect on USB disconnect (reopen same index, no restart)
    The producer used to retry the same dead VideoCapture handle forever. Now a
    camera that stops delivering frames (USB unplug, driver hiccup) is detected
    after _READ_FAIL_LIMIT (5) consecutive failed reads, released, and reopened on
    the same device index — throttled to reconnect_interval_s (config, default 2.0s,
    floored at 0.5s). While down the loop polls every 0.2s so a returning camera is
    picked up promptly (recovery ~0.5s); the /video feed shows NO-SIGNAL meanwhile
    and resumes on its own. Left is always retried; the optional right camera only
    if it was ever present, so a single-camera rig never polls a missing device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
2026-06-10 camera id change
2026-06-10 Camera: fix right_device to capture node (video2, not metadata video1)
    config.yaml had right_device: 1, which is camera B's UVC metadata node — it
    opens but never delivers frames, so only the left camera worked. Each UVC
    camera exposes an even capture node + the next odd metadata node; here the
    capture indices are 0 and 2. The CameraConfig default was already fixed to 2
    in 6bf61d3, but run_hardware.py reads config.yaml, which still overrode it.
2026-07-01 Clean up context bloat: dedupe .claudeignore, exclude PCB zips and graph instructions
    Removed duplicate tool-config stub entry and added Boat_PCB zip/duplicate-folder
    and code-review-graph instruction doc to .claudeignore so they stay on disk
    without being auto-loaded into every session's context.
2026-07-01 Merge dashboard into command center: collapsible/draggable sections, fill layout
    Retire the standalone dashboard (pi5/server/static/index.html) and fold its
    data into the command center, which now serves at / (/command redirects).
    Every section is a collapsible dropdown; a CUSTOMIZE toggle enables
    drag-and-drop reordering with a RESET LAYOUT button, both persisted to
    localStorage. Added a Leaflet map section (boat position/track/waypoints)
    and a Telemetry & Mission dropdown holding the rest of the old dashboard's
    data, wired to the existing /ws/telemetry feed.
    Default layout: camera+health on top, map+telemetry under that,
    commands+boat health under that. Paired sections now stretch to matc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
2026-07-01 Battery: migrate to three-domain Milwaukee M18 architecture
    Replace the old 12S-LiPo / 3S-Li-ion / 4S-winch battery design with three
    fully isolated M18 domains:
    - Drive: 3x M18 in series (54V nom / 63V max), 200k/10k divider (x21.0) -> GP26
    - Electronics: 1x M18 (18V nom / 21V max), 56k/10k divider (x6.6) -> GP27
    - Winch: 1x M18 (dedicated, no midpoint tap), 56k/10k divider (x6.6) -> GP28
    Firmware (sensors.py) dividers/thresholds updated; wire-protocol field names
    (batt_v/elec_v/winch_v) kept, so no protocol break. Pi5 simulator start
    voltages + percent ranges, dashboards (thresholds + labels), and config.yaml
    updated to match. Simulator telemetry verified (5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
2026-07-02 Align-first steering, waypoint planner page, and M18 battery migration
    Replaces proximity-boost turn logic with an align-first controller that
    pivots the boat to face the next waypoint before driving forward, fixing
    orbiting around waypoints. Adds a standalone waypoint planner page with a
    saved-path library, wired into the command center's LOAD PATH picker and
    SET HDG control. Also carries forward the three-domain Milwaukee M18
    battery migration in firmware/docs and the KiCad schematic/PCB rework to
    match the new divider values.
2026-07-02 Live camera left/right assignment with rescan from the command center
    - scan_devices() enumerates connected capture devices (sysfs names on Linux, filters UVC metadata nodes)
    - CameraProducer.set_devices() swaps left/right live inside the capture loop; right nullable for single-camera rigs
    - GET/POST /api/camera/devices endpoints; assignment persisted to camera_devices.json and restored by run_hardware.py
    - Command center camera bar: DEV L/R pickers, SET, RESCAN; CAM-N tag shows real device index
    - Fix run_hardware right_device default mismatch (1 -> 2)
2026-07-02 Stereo depth pipeline: Windows camera fixes, live depth view, per-object distance
    Fixes camera resolution negotiation on Windows (DirectShow FOURCC/size
    ordering), the stereo calibration script (headless-opencv conflict, slow
    corner detection at 1080p), and hides detection boxes on the right camera
    view instead of drawing them at the wrong parallax-shifted position.
    Adds a live disparity/depth colormap view to the command center and wires
    StereoDepth into the detection overlay so each detected object's bounding
    box now shows its distance in metres, using the calibration generated for
    the boat's 320mm stereo baseline.
2026-07-22 Add three-tier survey vision pipeline with threat tracking
    Layers a cheap water-segmentation anomaly screen (Tier 1) in front of
    the existing YOLO overlay (Tier 2, now gated on anomaly), plus a threat
    assessor (Tier 3) that turns detections into distance/approach-vector
    radar tracking and mission alerts. Adds config, tests, and updates the
    command center UI and hardware runner to wire it in. Also captures the
    KiCad schematic/PCB updates from the M18 battery migration and refreshes
    the session journal.
2026-07-22 Add session journal entry for vision-pipeline commit/push session
    Rolled the two oldest live-journal entries (stereo review/Windows camera
    fix, live camera assignment) into the archive to stay within the 5-entry cap.
2026-07-22 Single-hull test-bench firmware: hobby ESCs on PWM, 2x M18 drive rail
    Boat Pico variant for a single-hull bench rig that validates the stack on
    real hardware before the full catamaran. Drops the VESC/CAN-chain for two
    standard hobby ESCs driven as 50 Hz servo PWM, and moves the drive rail
    from 3x to 2x M18 in series.
    Pin plan keeps both SHT41 air-temp sensors on their native as-built pins
    (GP12-15, J11/J13), so propulsion and the winch/SBUS signals relocate to
    free Pico header pins: left ESC GP2, right ESC GP3, winch GP6, SBUS GP7.
    A PCB net-trace confirmed GP12-15 are the SHT41 SoftI2C connectors on the
    as-built board, so this also sidesteps the long-standing dual-hull
    GP12-15 VESC/winch/S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
2026-07-26 Nav LOS+ILOS, avoidance + bug-escape, vision perf, 2xM18 parallel drive, Abyssal Indigo UI, AM32 ESC passthrough
    Navigation
    - Lookahead line-of-sight (LOS) guidance + cross-track error + optional ILOS
    (geo.los_course/cross_track_error); Navigator steers the LOS course when a leg
    start is given; mission legs anchored to the previous waypoint.
    - run_hardware now reads the navigation: config block into NavConfig (was ignored).
    - Per-motor trim (motor_gain_left/right) for mismatched-Kv motors.
    Obstacle avoidance
    - Wired reactive avoidance pipeline->navigator (was dead code). Bug-style
    AvoidanceController commits to a side and passes a blocking obstacle instead of
    orbiting it. Simulator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
2026-07-26 ESC telemetry (temp+current) + AM32 Pi-UART configurator; passthrough safety fixes
    - esc_telem.py (new): PIO UART RX x2 (GP16/GP19) receiving AM32 KISS telemetry;
    escs.py accessors delegate to it; main.py inits it + a 100 Hz drain task + an
    edge-triggered MOTOR_HOT warn. Also fixed "2x M18 series" -> parallel doc rot.
    - TEL frame gains curr_l/curr_r (backward-compatible appendix) end-to-end:
    serial_handler -> pico_serial (parse-if-present) -> server model/status dict ->
    command center + dashboard TelemetryPanel. Simulator emits synthetic temp/current.
    - pi5/scripts/am32_config.py (new): configure AM32 ESCs from the Pi over the GPIO
    UART via the one-wire bootloader protocol (read +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
2026-07-26 Fix firmware safety criticals: S1 UART1 double-drain, S2 blocking-stdout watchdog stall
    - S1 (main.py): remove the racing gps.read() from task_fast_sensors so
    task_uart1_reader is the sole UART1 reader (it already demuxes $GP*/$GN* to
    gps._parse_rmc and $POD to pod_uart). The two readers were stealing bytes from
    each other, intermittently losing GPS fixes AND $POD frames -- including the
    pod leak flag.
    - S2 (serial_handler.py): _send() now writes byte-at-a-time behind a POLLOUT poll
    (_stdout_poll) and drops the rest of a frame under back-pressure. A plain
    sys.stdout.write() busy-loops forever when the Pi stops draining the USB CDC,
    stalling the single asyncio loop so task_watch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
2026-07-26 Current-aware station-keeping, wave detection, NCNN YOLO, ESC/UI redesign
    Autonomy + vision + UI upgrades, verified on the Pi (both cameras + Pico):
    - Nav: water-current estimation (GPS ground track vs a thrust->speed model)
    and active current-aware station-keeping in stay/HOLD mode — the boat noses
    into the current and holds position (holds <=0.4 m against 0.35 m/s in sim)
    instead of drift-then-reacquire. New current_estimator.py, sim current +
    POST /api/sim/current, NavState/API fields. +5 tests.
    - CV: incoming-wave detector (horizon tracking + sparse optical-flow looming,
    ~3 ms/frame) with a bow-into-wave override (yields to obstacle avoidance) +
    HUD + vision.wave telemetry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
2026-07-26 Move ESC telemetry into the Boat Health section
    Per feedback: the per-motor ESC temperature gauges + current bars now live
    inside the BOAT HEALTH panel (as a "Propulsion · ESC" sub-block) instead of a
    separate panel. Dropped the redundant "MOTOR L / R" text stat + its JS; the
    gauge element ids are unchanged so renderBoat()/updateEscGauge() keep working.
2026-07-26 ESC Settings editor: dashboard read/write of AM32 settings
    Finish the interrupted ESC-config UI. The am32_config FIELDS registry
    (read/write_settings, decode_eeprom, mock EEPROM, wiring/setup constants)
    was built to back a dashboard editor, but the endpoints and UI were never
    wired up and the modal was still the old am32.ca passthrough stub.
    - pi5/server/app.py: POST /api/esc/read, POST /api/esc/write,
    GET /api/esc/meta. Hardware read/write runs in a threadpool and refuses
    during a mission; the simulator serves + mutates a persistent mock ESC so
    the editor is fully usable with no hardware.
    - command_center.html: full ESC SETTINGS modal rendered from the field
    registry -- grouped Dri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
2026-07-27 GPS-anchored object memory + stack audit fixes + dashboard redesign
    Object memory (new): boat charts confirmed buoys/landmarks on the GPS
    map and re-verifies them on later sightings instead of re-observing,
    freeing the radar to keep scanning. Permanent marks kept; transient
    movers expire on a TTL.
    - geo.destination_point() forward geodesic (boat fix + bearing + range)
    - cv/object_memory.py ObjectMemory: world-coord matching, N-sighting
    confirm, inverse-dist^2 refinement, transient/candidate aging
    - cv/pipeline.py feeds ranged detections, releases radar from known
    non-critical landmarks; server /api/map/objects (+ clear)
    - sim_obstacles.SimObjectMapper feeds memory from ground truth
    - UI: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
2026-07-27 perf(cv): drop per-frame sqrt in threat matching, trim in place, single-pass stats
    - threat_assessor._match: compare squared centroid distances instead of
    taking a sqrt per candidate every frame (monotonic — nearest unchanged)
    - threat_assessor: trim size_history in place (del h[:-n]) rather than
    rebuilding the list each frame
    - object_memory.stats: one pass over objects instead of four
    Verified findings from a 3-agent audit; rejected the rest on inspection
    (size_history->deque would break the slice reads in _approach_vector;
    the (0,0) GPS guard is deliberate; _enforce_cap already early-returns).
    234 tests green, ruff clean.
2026-07-27 perf(server): offload blocking psutil + camera-devices write off the event loop
    - _gather_health ran psutil probes (disk_usage statvfs, net/mem/pids /proc
    reads) directly on the loop every 1s from the background health task, so a
    loaded/slow-storage Pi added that stall to every concurrent request. Extract
    them into _gather_psutil_stats() and run via asyncio.to_thread. This also
    makes the /ws/health cold-start fallback non-blocking (vcgencmd was already
    offloaded).
    - /api/camera/devices POST persisted the assignment with a synchronous
    write_text/replace on the loop; wrap in asyncio.to_thread.
    Rejected the module-load asyncio.Lock() finding (fine on 3.10+) and the
    TEL/ENV partial-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
2026-07-27 a11y(dashboard): announce alerts to screen readers + label the sliders
    - #banner (critical alert bar) gets role=alert + aria-live=assertive and
    #toast gets role=status + aria-live=polite, so an ESTOP/alert or a command
    ACK is announced instead of being a silent visual-only change.
    - aria-label the 8 unlabeled range sliders (det fps, conf, jpeg quality,
    stream fps, sim speed, cruise throttle, winch up/down) — they had only
    adjacent visual labels, no programmatic name.
    Assessed the existing design objectively first: every text token already
    passes WCAG AA on all four surfaces (muted 5.3-6.4, crit 4.7-5.7, rest
    higher), a global prefers-reduced-motion block disables all animation,
    fo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
2026-07-27 refactor(cv): drop dead is_approaching + add ThreatAssessor match regression tests
    - Remove ThreatAssessor.is_approaching: zero callers anywhere (superseded by
    _approach_vector, which returns the APPROACHING/RECEDING/STATIC string the
    pipeline actually uses). Confirmed genuinely dead, unlike the graph's other
    76 "dead" hits (require_api_key Depends, ASGI middleware dispatch, the
    polymorphic MockPicoSerial interface, argparse cmd_* handlers) which are all
    framework/dynamic-dispatch false positives and were left untouched.
    - Add test_threat_assessor.py: nearest-track association was only covered
    indirectly via the pipeline tests. Locks in the squared-distance _match
    (must fold in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
2026-07-27 feat: camera recording + Tesla-style sentry mode + Recordings dashboard section
    Record the camera to the Pi, auto-capture critical moments with pre-roll,
    and browse/play clips from the dashboard.
    pi5/cv/recorder.py (new, +6 tests): rolling pre-roll ring (JPEG, bounded),
    manual start/stop, debounced note_event() sentry trigger seeded from pre-roll
    and extended while an event persists (hard-capped), tick() auto-stop. Writes
    browser-playable VP8/WebM (fourcc probe -> mp4v fallback) + JSON sidecar,
    retention cap, path-traversal-safe list/serve/delete. Sync OpenCV here; the
    server drives it via asyncio.to_thread.
    server (app.py): always-on background feed subscribes to the camera (or
    synthesise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
2026-07-27 dashboard: fold recording controls into the camera + ESC-style recordings modal
    Per follow-up: drop the standalone RECORDINGS box. Recording now lives on the
    CAMERA panel — a control bar (SENTRY arm toggle, manual REC/STOP) plus a live
    "● REC" overlay on the feed and a RECORDINGS button that opens an
    ESC-settings-style modal (#mRec) to browse clips: player beside a
    severity-coloured clip list, with FULLSCREEN / DOWNLOAD / DELETE actions.
    - Fullscreen via video.requestFullscreen(); download via a client-side
    <a download> (so it doesn't force-download the inline player).
    - Serve endpoint drops filename= so it's inline (content-type video/webm,
    accept-ranges: bytes for seeking) instead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
2026-07-27 fix(recorder): record until the threat clears, not a fixed length
    A sentry clip was cut off at the max_clip_s hard cap (~90s) even while a threat
    was still in frame. Rework the stop logic:
    - A running clip now stays alive while note_event keeps firing and stops only
    retrigger_extend_s (8s) after the LAST sighting — i.e. it records until the
    threat clears, not a fixed duration. The per-event hard-cap min() that ended
    it early is gone.
    - max_clip_s (now 300s) is a per-SEGMENT cap: if the threat is still active when
    a segment hits it, tick() rolls over into a fresh file (carrying reason +
    frame size) instead of stopping, so a persistent threat is never cut off
    mid-event while ind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
2026-07-27 feat(recorder): auto-delete recordings older than 2 weeks
    Add age-based retention alongside the existing count cap. Clips older than
    max_age_days (default 14) are deleted:
    - on every save (_prune runs age sweep then the count cap),
    - at Recorder construction (clears stale clips from prior runs),
    - hourly from the server feed loop via prune_old() (thread-safe), so old
    clips are removed even when nothing new is being recorded.
    Age is taken from the clip metadata's `started` wall time (falls back to file
    mtime); max_age_days=0 keeps clips forever. Configurable via
    recording.max_age_days; wired through run_hardware.py. +2 tests. 245 tests
    green, ruff clean, dashboard build clean.
    Co-Authored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
2026-07-27 feat(recorder): favorite clips to exempt them from auto-deletion
    Add a per-clip "favorite" flag: favorited clips are skipped by both the age
    sweep (max_age_days) and the count cap (max_clips), so they're kept forever.
    They can still be deleted explicitly.
    - recorder: `favorite` bool in metadata (default False); set_favorite() with the
    same path-traversal guard as clip_path; _prune_by_age and _prune skip
    favorites (count cap now applies to non-favorites only). list_clips exposes
    the flag.
    - server: POST /api/recordings/{name}/favorite {"favorite": bool}.
    - dashboard: recordings modal gets a ☆/★ FAVORITE toggle in the footer (acts on
    the selected clip) and favorited rows show a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
2026-07-29 feat(cv): classical buoy screen, per-class conf floors, CPU/power budget
    Buoy detection was dead on hardware. The active detector is a generic COCO
    yolov8n (pi5/cv/models/yolov8n_ncnn_model) with no 'buoy' class, and the
    maritime model is a placeholder (mAP50: 0.0, weights absent) — so nothing ever
    emitted the label threat_assessor grades WARNING and object_memory charts as a
    PERMANENT marker. The whole "confirm a buoy -> drop a GPS marker" feature was
    only ever exercised by the simulator's ground-truth SimObjectMapper; the
    existing tests pass because FakeOverlay injects detections and YOLO never runs.
    - pi5/cv/buoy_detector.py (NEW): one HSV threshold pass + contour filter
    (saturation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
2026-07-29 hardware: audit Boat_PCB V2 netlist, rebuild pin maps, realign leak + ESC telem
    Double-checked all Boat_PCB V2 wiring against the KiCad netlist and updated every
    pin map to match the board. Verified three ways: an S-expression parse of
    Boat_PCB.kicad_pcb, a raw regex extraction of the footprint blocks, and
    `kicad-cli sch export netlist` from the schematic. DRC and ERC run with
    kicad-cli 10.0.5. The 18 commits pulled from origin left Boat_PCB/ untouched, so
    the audit applies to current single-hull-test-bench.
    Firmware pin changes (both to match the board's real connectors):
    - sensors.py: hull leak GP17/GP18 -> GP19/GP20. On V2, GP17/GP18 are the BNO085's
    RST/INT lines on J5, so the old pi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
2026-07-29 fix(hardware): apply pin-map audit — winch GP21, stepper half step, divider ratio
    Applies the three code fixes the Boat_PCB V2 netlist audit (e27ee7f) flagged but
    left open.
    - Winch PWM GP6 -> GP21 (`motor_control.MW_PIN`). The board routes the winch
    signal to J8.1 + J9.1 = GP21, while GP6 is the MCP2515's ~INT, so the old pin
    drove the CAN chip instead of the winch ESC. GP21 was unused by firmware,
    making this the only one of the five CAN-contested pins (GP2/3/4/6/7) that a
    pin move can resolve.
    - Stepper steps_per_rev 3200 -> 400. The A4988 is half step (MS1 high off the
    Pi's 3V3, MS2/MS3 hard-grounded), not 1/16. A commanded 10 deg pan travelled
    80 deg and drove through the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
2026-07-29 fix(stepper): record the gpiozero/lgpio dep, and shout when mock mode is silent
    The radar bar wasn't moving on the bench. Cause was not the A4988, VREF or the
    VMOT pack: gpiozero/lgpio were missing from the project venv (built with
    include-system-site-packages=false), so stepper.py's soft import failed and
    StepperMotor ran in mock mode. Mock still tracks position and still returns
    success from /stepper/status, so the command center reported every pan as
    working while no pulse ever reached the driver.
    - pi5/requirements.txt: declare gpiozero + lgpio (aarch64 markers) with the
    apt/symlink recipe, since `pip install lgpio` needs liblgpio-dev to build.
    These were only ever mentioned in a st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
2026-07-30 diag(gps): GPS TX lands on a hard-shorted Pico pin; add a bench probe
    The GPS was silent. Diagnosed on the live bench Pico, three ways:
    * Nothing transmitting. 18 GPIOs scanned (all but the ESC/winch/NeoPixel
    outputs and the dead GP0/GP1): zero edges each, which rules out any baud.
    * Not on the Pi. No USB serial but the Pico, and GPIO14/15 measure floating
    with function `none`, so nothing is on the header UART either.
    * J7 IS the GPS UART, and the firmware is on the wrong pins. `gps.init` opens
    UART1 on GP4/GP5, which reach no connector; J7.4/J7.3 are GP8/GP9 — the
    RP2040's other UART1 TX/RX pair. `docs/pin_map.md` lists GP8/GP9 as I2C0
    only; they are dual-functi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
2026-07-31 feat(gps): NMEA receiver on the Pi with a four-rung source ladder
    The GPS moved to the Pi's header UART (38400, /dev/ttyAMA0) after the Pico's
    GP9 turned out to be shorted to GND. This adds the receiver itself.
    Parses GSV as well as GGA/RMC, so acquisition is observable: sats_visible /
    sats_tracked / best_snr, kept per talker because each constellation runs its
    own cycle and a flat total would just be whichever spoke last. `on_status`
    fires on every GGA regardless of fix — the counterpart `on_fix` cannot, since
    it only fires on a usable position, which made the entire acquisition phase
    invisible. `linked` (a valid sentence arrived) is distinct from `connected`
    (the port opened), because t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
2026-07-31 feat(cv): absolute radar aiming, per-class conf floors, half-step stepper fix
    Radar tracking: `_bearing_for` returned `stepper.get_position_degrees() +
    offset_deg`, which is the camera-on-the-bar formula. The cameras are fixed
    forward and the bar pans separately, so the pixel offset does not shrink as
    the bar turns and every 0.1 s tick added it again — positive feedback, bar
    walks into an end stop. Flipping DIR would not have fixed it, only pinned the
    other end. Now absolute about `bow_degrees`.
    CONF slider was a no-op on the classes that mattered: `_passes_conf` took the
    per-class floor whenever one existed, and config pins person/swimmer at 0.25
    and surfer/kayak/buoy at 0.30, so draggin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
2026-07-31 feat(server): WASD manual override, per-path rate limits, real NAK reasons
    Three faults, one per layer, all surfacing as "manual override does not work".
    Rate limiter counted every path against one 60 rpm per-IP bucket. Manual
    override repeats /api/manual/drive at 10 Hz (600 rpm), so six seconds after
    arming everything from that IP 429'd — drive frames, telemetry, E-STOP. The
    cap was already below the dashboard's *idle* draw (~70 rpm). Now counted per
    (IP, path class), so ordinary polling can no longer eat the E-STOP budget.
    NAK reason was never read: the frame is NAK,<seq>,<command>,<reason> and
    `_send_command` logged fields[0], the echoed command — hence the tautology
    "SET_THR NAK'd: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
2026-07-31 fix(firmware)!: block throttle until both drive ESCs are confirmed bi-directional
    On the bench the right ESC (BLHeli-32) armed mid-test and kept spinning
    through SET_THR 0,0 *and* through ESTOP. It is in stock normal mode, where
    the 1.5 ms pulse escs.py calls "neutral" is ~50% throttle: it refused to arm
    at power-up (so it looked dead), armed the instant a -100 command produced
    1.000 ms — its throttle zero — then ran on when the sweep returned to 1.5 ms.
    The generalisation is the serious part. Every stop this firmware can express
    is 1.5 ms: neutral, escs.stop(), motor_control.estop(), and the heartbeat
    watchdog. Against a normal-mode ESC the entire safety system commands half
    throttle.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
2026-07-31 docs: ESC safety gate, AM32 conversion plan, pin map and protocol updates
    esc_setup.md gains the bi-directional gate section — why 1.5 ms "neutral" is
    ~50% throttle to a normal-mode ESC, why a mixed pair has no safe pulse at
    all, and how to clear the gate. The first-spin checklist now says to read the
    setting back in the config tool rather than infer it from the motor, and
    warns against "waking" a silent ESC with a low pulse, which is exactly what
    armed it into a runaway.
    esc_am32_conversion.md is new and marked PLANNED, NOT STARTED. Setting 3D
    mode from the Pi turned out to be unreachable: BLHeli_32 is closed source,
    discontinued in 2024, and esc-configurator supports only BLHeli_S / Blu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
2026-08-04 chore(agents): purge dead code-review-graph config, slim CLAUDE.md
    The code-review-graph MCP server is not installed anywhere on this machine:
    the binary is not on PATH, code_review_graph is not importable in the venv,
    its configured interpreter C:\Python314\python.exe is gone, and its configured
    cwd (the old Desktop\Python\COE 2 Autonomous Boat path) no longer exists since
    the repo moved. Despite that, it was the largest theme in the agent config —
    15 files instructing agents to prefer its nonexistent tools *over* Grep/Glob/
    Read, which is actively worse than no instruction at all.
    Removed:
    - .mcp.json, .cursor/, .qoder/, .gemini/, .kiro/, .opencode.json — six copies
    of the same dead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
2026-08-04 docs(v3): add V3 PCB planning files, fenced off from the V2 bench
    Two externally-written planning files for Boat_PCB V3 (Teensy 4.1 carrier +
    XIAO ESP32-S3 pod), stored verbatim with only a scope banner prepended.
    V3 contradicts the bench by design: VESC-over-CAN propulsion vs. the bench's
    mismatched hobby ESCs on direct servo PWM (GP19/GP20) behind the
    escs.BIDIR_CONFIRMED gate, Teensy/C++ vs. the RP2040 MicroPython firmware, and
    a sensor set that does not exist on V2. docs/v3/README.md is the fence: it
    tables those contradictions and sends bench work back to CLAUDE.md,
    docs/pin_map.md and docs/serial-protocol.md. One row in CLAUDE.md's "Where
    truth lives" marks docs/v3/ as authoritative f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
2026-08-05 feat(pcb): V3 carrier schematic - library, full wiring, verification
    Builds the Boat_PCB V3 carrier from an empty 230-byte sheet to a fully wired
    96-component schematic, with a self-contained project library so a fresh clone
    resolves every part with no per-machine setup.
    Library (Boat_PCB_V3/lib, 32 symbols / 26 footprints / 2 STEP models)
    - KiCad 10.0.5 stock covers more than the BOM assumed: TJA1051, TCA9548A,
    INA228 and SHT4x all ship with KiCad. Corrected in the status doc.
    - User-supplied SnapEDA exports for BNO085, BMP390, BH1750, XIAO ESP32-S3.
    - Teensy 4.1 from XenGi (MIT). Pololu D36V50F5 (item 4091) and the Raspberry Pi
    40-pin socket extracted from the built V2 board - neither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
2026-08-05 feat(pcb): 12S drive rail is voltage-only; drop the drive shunt chain
    Drive pack is 12S LiPo (2x 6S in series) = 50.4 V max, not the 63 V that
    V3_PCB_SESSION_CONTEXT.md states and not M18 as README.md says. Corrections
    recorded in docs/v3/v3_review_2026-08-05.md rather than editing the verbatim
    planning files.
    Decision: no current sensing on the 12S rail, just the ADC voltage tap. An
    INA228 with nothing across Vin+/Vin- measures nothing, so the whole chain goes:
    U9, C19, J15, R1, R2, R13, C7, plus the +VDRIVE / DRIVE_SENSE / DRIVE_ADC /
    SH_DRIVE_P / SH_DRIVE_N nets and the off-board 250 uOhm shunt with its 4-wire
    harness. 96 -> 89 components, and Teensy A2 frees up.
    That also settles the J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
2026-09-21 chore(git): ignore KiCad backups, fab exports and DRC reports
    7.6 MB of regenerable artifacts were sitting untracked in Boat_PCB/:
    *.bak / *.prestack rollback copies, the V2 gerber dump and its zips,
    and _evac_drc.rpt. None of it is design data.
    Also picks up Boat_PCB_V1.kicad_pro, which KiCad 10 rewrote on open --
    it expanded the zone defaults and corrected the internal filename field
    from Boat_PCB.kicad_pro. No design intent in it.
2026-09-21 feat(pcb): V3 schematic - audit fixes, pod off-board, 5V fusing, passives
    Schematic work from review-log updates 9-11, previously uncommitted.
    Update 9 - independent five-pass audit, four blockers found and fixed:
    BNO085 was strapped for a crystal that was never fitted; the winch kill
    shared a UART with SBUS, and the shared pin defeated the fail-safe; the
    pod schottky was fitted backwards; the XIAO's 3V3 regulator output was
    tied to the carrier's +3V3. Seven pins had no defined state while the
    Teensy is high-Z.
    Update 10 - the pod becomes a separate board, and every 5 V branch that
    leaves the carrier is fused: F1/F3 0.75 A and F2 1.25 A hold, one PTC per
    external harness, so a flooded pod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
2026-09-21 feat(pcb): V3 layout - 4 layers, floorplan, routing, power-copper fixes
    The layout, previously uncommitted in full. Review-log updates 12-13.
    Update 12 - board setup and floorplan. 132 x 108.4 mm on JLC04161H-7628
    (1 oz outer, 0.5 oz inner, ENIG), In1 = GND plane because F.Cu sits only
    0.21 mm above it, In2 = power. Netclass widths derived from IPC-2221
    rather than guessed. Custom rules live in Boat_PCB_V3.kicad_dru, which
    was never committed at all: the power nets want wider clearances than
    the netclasses can carry, because the 0.5 mm-pitch packages have 0.15 mm
    between their own pads by construction.
    Update 13 - first review of the layout, and the power-copper fixes it
    found. The routing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
2026-09-21 docs(v3): review log updates 9-13; V3 KiCad files are tracked now
    v3_review_2026-08-05.md gains sections 13-18, the running record behind
    the two commits above: the independent audit, the pod going off-board,
    the 5 V fusing, the passive review, the board setup and floorplan, and
    section 18, the first pass over the layout itself.
    Section 18 also records what could not be fixed and why, so it does not
    get rediscovered: WINCH_SW's outer copper needs Q1 rotated (its G-D-S
    pin order forces +VWINCH to cross the Q1->J16 corridor), eight signal
    nets still slot the In1 ground plane and none would relocate to an
    outer layer, the CAN pair is split across layers, decoupling sits
    6-20 mm from the pins i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
2026-09-21 chore: V3 clean slate - hardware and design knowledge only
    A fresh starting point for the V3 boat. The V3 carrier PCB and the
    design knowledge behind it stay; the V2-era application code does not.
    Nothing is lost - every file removed here is still on main.
    Removed (~35,000 lines of code, ~8,500 of V2 documentation):
    pi5/ firmware/ dashboard/ cloud/ ml/ reference/ deploy/
    run_sim.py run_hardware.py .github/workflows/ci.yml
    Boat_PCB/Boat_PCB.kicad_* the V2 bench board
    Boat_PCB/Boat_PCB_V1.* superseded
    Boat_PCB/report.txt stray KiCad import log
    docs/ except v3/, battery_architecture.md, changelog_and_decisions.md
    The CI workflow went with the code it built - e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
2026-09-21 docs(v3): drop the review log and the library status survey
    Both distilled already and both now stale as standing documents:
    v3_review_2026-08-05.md 1366 lines, the 18-section log of the first
    V3 attempt. Its conclusions are in
    V3_DESIGN_BRIEF.md; the blow-by-blow is not
    something the redesign needs in the tree.
    kicad_library_status.md 491 lines, a 2026-08-04 survey of what
    ships with KiCad vs what needed downloading.
    Moot now that the library is built and
    committed under Boat_PCB_V3/lib/.
    docs/v3 goes 1982 -> 425 l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
2026-09-23 chore: finish the V3 clean slate - V2 now lives at tag v2-final
    The first clean-slate pass took the V2 code out but left the repo
    describing a world where V2 was still the live boat on another branch.
    This pass finishes the job, so that main can become the V3 base.
    V2 moves from "on main" to the annotated tag v2-final (56b4d18, the
    last main). Every pointer into V2 now reads `git show v2-final:<path>`:
    README, CLAUDE.md, the design brief, the fence doc, and the two
    planning-record banners.
    Removed (all still at v2-final):
    docs/battery_architecture.md, docs/changelog_and_decisions.md
    V2 documents. The second one lists "locked decisions - do not
    revisit" that V3 contradicts (VE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
2026-09-23 docs(claude): make the kicad-cli commands runnable from the repo root
    kicad-cli is not on PATH on the dev machine, and the commands used bare
    file names that only resolve from inside Boat_PCB/Boat_PCB_V3/. Both are
    now spelled out, and were run verbatim from the root to check: DRC 107,
    0 unconnected, parity 154, ERC 70 - unchanged. The erc.json/drc.json
    they write are caught by .gitignore.
    Also split the ERC tally correctly: 58 unflagged unused pins, 8 pin-type
    conflicts (which include ADXL375, not just the Teensy, buck and BMP390),
    and 4 undriven pins (Teensy PROGRAM, ON_OFF, VBAT; buck EN).
2026-09-29 feat(pcb): carrier rev D and pod board rev A
    Carrier (Boat_PCB/Boat_PCB_V3), against the pre-relayout board at c4b673b:
    - Re-placed and re-routed for a Pi 5 mounted face down on 30 mm
    standoffs, fully inside the outline. The board goes from 132.0 x 108.4
    to 130.6 x 101.5 mm, 7 % less area.
    - Review fixes. The A2 footprint was redrawn from Pololu's drill guide:
    the old one reversed the buck's pinout end for end. XT60 pin 1 is now
    negative, J16 is an XT60-F, J11 is a JST-VH, and the Kelvin sense taps
    have their own nets. Added: TVS D3/D4/D5, gate zener D2, power and winch
    LEDs, the U12 level shifter for the WS2812, the JP1 CAN termination
    option, series resistors on off-board ne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
2026-09-29 feat(pcb): pod board rev B, reviewed and re-placed on a grid
    Pod (Boat_PCB/Pod_PCB_V3), against rev A at 5b3b610. Same 54 footprints,
    outline (48 x 63 mm) and netlist; the schematic is untouched.
    - Review: every net checks out and every part is needed, so nothing was
    removed. The real faults were decoupling distances: the AP2112's caps
    C3/C4 sat 9.3/9.8 mm from its pins (now 2.2/2.7 mm), C5 was 5.0 mm
    from the THVD2410 (now 2.7) and C6 3.2 mm from the ADS1115 (now 2.3).
    - Placement: the right-edge wire-pad groups are on one 8.47 mm pitch and
    the bottom groups on equal 3.4 mm gaps. The twelve upright resistors
    and caps stand in one row on a 3.4 mm pitch; the RX pull-up, DE
    pull-d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
2026-10-02 feat(mechanical): hull, bridge and outdrive design tools, rev C (2026-09-27)
    A snapshot of the mechanical design work as it stood on 2026-09-27, before rev D, so the
    history shows what rev D changed. It was never committed while it was being worked on.
    The design tools are stdlib Python, each with its generated outputs:
    - hull_sizing.py, the design model
    - propulsion.py
    - drawings.py: the 5-sheet PDF, SolidWorks curves and the arch-frame DXF
    - concept_model.py: 3D viewer and renders
    - toroidal_prop.py
    docs/ gets the sizing record and the SolidWorks guide.
    Rev C is the arched-bridge catamaran:
    - electronics and four M18 packs in a sealed IP67 box in the hub
    - 5 PETG print segments per hull,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
2026-10-02 feat(mechanical): rev D: hub garage, packs in the hulls, fixed outdrives drawn for CAD
    Rev D follows the decisions logged in docs/v3/session_journal.md (09-29 to 10-02):
    - Hub garage. The arched bridge stays, and its hub now holds the winch. The pod and a
    2 L horizontal Van Dorn sampler pull up through a 240 x 301 mm opening in the hub
    floor and stow 186 mm above the DWL. The IP67 box is gone.
    - Packs and electronics in the hulls, on aluminium heat plates. The 12S drive pack
    goes in the port hull; the electronics and winch packs and the Pi 5 + carrier go
    in the stbd hull; there is a VESC by each outdrive. Wiring enters the hulls only
    through IP68 connectors in the lids.
    - Hulls in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
2026-10-08 Add D.R.E.A.M.S website
    Static multi-page site for the D.R.E.A.M.S autonomous survey boat: home,
    the boat (survey loop, annotated V3 carrier board, interactive 3D model,
    spec sheet), build log, partners, team and contact, plus the V2
    command-center demo running on simulated data.
2026-10-08 Fix layouts: board beside its key, phone and tablet fixes
    - Boat page: the board sits beside its key and stays in view while the
    key scrolls; the two custom boards get their own row
    - Phones: team-card photos no longer cover the names, partner cards
    stack, roadmap dots removed, spec sheet stacks, build log becomes a
    compact list
    - Tablets: page-head pictures follow the text; narrow video tiles get a
    compact caption
    - Contact FAQ sits beside its heading on desktop
    - Typography: balanced headings; separators, units and part names no
    longer split across lines (tools/typo.py, used by both generators)
2026-10-08 Add the winch weight-test video, new V1 photos and Matthew's headshot
    - Winch weight test plays in place (poster button, video over it) in the
    build log, the V1 card and the home highlights strip
    - Six new V1 build-log entries: Rocky on deck, the sealed hull, the
    workshop in our room, the winch test, V1's stand sketch, demoing V1
    - Team page: the room V1 was built in; contact header: the showcase demo
    - Matthew's studio headshot replaces the cropped action photo
    - build_images.py: rebuild only named slugs, trim and blur-fit helpers
2026-10-08 Build log header: V1 with the plush husky instead of the epoxy shot
    The old header crop was mostly window, hand and clutter. The new one
    shows the winch, sensor pod and deck, with the husky riding in a hull.
2026-10-08 Page headers show the whole photo; caption the display stand
    - The organic blob mask cropped each header photo differently (its shape
    followed the header's text height). Headers now use a rounded frame
    with the photo's own proportions (--ar), so nothing is cut off
    - Stand sketch: the display stand for the Creators' Showcase and the
    class presentation
2026-10-08 Bring back the blob page-head photos, sized so each picture fits
    The blob mask returns (the user preferred it to the rounded frame). Each
    blob now takes its photo's proportions (--ar) instead of stretching to
    the header's text height, so the picture fits inside it; the board
    render is inset so its corners clear the curve.
2026-10-08 Drop the hero winch circle, credit Claude Code for the software, expand Kyle's bio
    - Home hero: remove the red-pen circle and label around the winch
    - No claims that we wrote the code: "the hull to the cloud backend" and
    "every part ourselves" now read "We design, build and test the
    hardware ourselves. The software is written with Claude Code."
    - Kyle's bio: class of 2029, Burlingame, Team DHM combat robotics (4th
    nationally in Plastic Antweight '24, 16 club podiums), other builds and
    the five-axis arm
2026-10-08 Remove mentions of writing the software
    Drop the Claude Code sentence, "our software", Matthew's firmware line,
    role and tag, and the gearbox simulator's "built with AI coding agents".
    What each version does in software (dashboards, the planned V3
    firmware, the cloud link) stays.
2026-10-08 Add Nolan Ting and Caleb Kong to the team
    - Team page: a "New on the team" section with cards for both (initials
    hold the headshot slots; comments mark where photos and bios go), plus
    subnav links, the lead and meta text updated to four students
    - Home: two more member cards; "Built by a team of four."
    - Hero and meta copy no longer say "two" students; contact FAQ and the
    partners lead mention the whole team
2026-10-09 New logo: Kyle's DREAMS hull wordmark
    - tools/make_logo.py redraws the hand-drawn logo as SVG strokes (measured
    from the sketch) and writes img/logo.svg (nav, strokes weighted for
    small sizes), img/logo-light.svg (footer), img/logo-full.svg (the
    drawing's own weight) and img/favicon.svg (the bow and D on a tile)
    - 32 px and 180 px PNG icons for browsers and home screens
    - Nav, footer, the no-JS fallback and every page's favicons use it; the
    old square icon is removed
2026-10-09 Build log: compact cards, first 10 entries until "Show all"
    The full log was eight rows of large cards. Cards are now smaller (five
    across on desktop, shorter photos, two-line descriptions) and only the
    first 10 matching entries show until "Show all N entries"; the filters
    still work, and the button hides when a filter has 10 or fewer matches.
2026-10-09 Build log: the deck figure is Grace, printed the way Rocky made it
2026-10-12 Add weekly updates: UPDATES.md and an Updates page
    - UPDATES.md holds the team's weekly updates (newest week first); the new
    updates.html page renders it live, so posting is just editing the file
    on GitHub
    - "Updates" in the nav, the footer and the build log's subnav
    - CLAUDE.md tells future Claude Code sessions to add their work to the
    current week; README explains how to post from GitHub
2026-10-12 Updates: V3.1 clear under the Pico, pod regulator underneath
2026-10-12 feat(pcb): V3.1 starter carrier rev A (Pi 5 + Pico 2)
    An interim board to get the boat running before the full V3 carrier. The
    Pi 5 and its D36V50F5 stay, and one Raspberry Pi Pico 2 replaces the Teensy.
    One 10S Li-ion pack powers everything. It has CAN for the VESCs (can2040 on
    the PIO), RC, GPS with its compass, an on-board SHT41 module, a Qwiic port
    for the TMP119, hull leak probes, ESC headers, the pod tether (15 V from a
    D36V6F15) and a 2nd-Pico header.
    98 x 67 mm, 2 layers, 75 footprints. The Pi mounts face down on 30 mm
    standoffs. The Pico, both Pololu modules, the 2nd-Pico header, every
    capacitor, the SHT41 module and the SMD parts (21 parts) are on the
    underside, so nothing under t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
2026-10-12 docs: point sessions at the weekly updates; link the website
    CLAUDE.md now tells sessions to add their work to the current week in
    UPDATES.md (ka1e27/dreams, shown at ka1e27.github.io/dreams/updates.html).
    README links the website.
2026-10-12 docs(v3): add the V3 session journal and its archive
    docs/v3/session_journal.md is where each Claude Code session hands off to the next: what changed,
    why, and what is still open. It keeps the 5 newest entries (09-27 to 10-02). Older ones go to
    docs/v3/session_journal_archive.md (09-23 to 09-26).
    The 09-23 to 09-27 entries were written into V2's journal before this clone was synced to V3, and
    they are carried over word for word. V2's own journal stays at
    `git show v2-final:docs/session_journal.md`. The 09-29 to 10-02 entries cover:
    - the V3 sync and the Li-ion pack and arm mass check;
    - the hull decision (rev C's curved hollow hulls, printed in PLA and sealed);
    - CRWA's Muddy River steer;
    -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
2026-10-12 Updates: one short V3.1 bullet for the week of Oct 12
    Four bullets about the same board become one: what V3.1 is, why it was
    designed and its main features.
2026-10-12 Website: a full page for each week, with photos
    Each week on the Updates page now opens week.html?w=<YYYY-MM-DD>, which
    shows the week's short bullets, a write-up from updates/<YYYY-MM-DD>.md
    and its photos. Photos open full size in a viewer (arrow keys, Esc).
    Weeks without a write-up stay as plain cards.
    - updates/: write-ups for the weeks of Sep 28, Oct 5 and Oct 12
    - img/upd-*: V3.1 renders and a home-page screenshot, built by
    tools/build_images.py (new UPDATES list) at 1600 and 900 px
    - UPDATES.md, README.md and both CLAUDE.md files explain the format
    - styles.css and site.js re-stamped in every page
2026-10-12 Website: the V1 assembly photo at full size, on Updates and the Build Log
    The Updates page header now shows V1 being put together outside, from
    Kyle's original photo (converted from HEIC, with no location data). It's
    a tall photo, so the header uses a narrower blob. The Build Log's
    "Wiring and assembly" card uses the same original instead of the 340 px
    copy.
2026-10-12 Website: phone menu button at the top right
    On narrow screens the link list is hidden but still a flex item, so
    space-between put the menu button in the middle of the bar. The button
    now comes last and sits at the right edge, on every page.
2026-10-13 Website: Kyle's bio by version, Omar's role in the thanks
    Kyle's bio now says who did what on each version: V1 (Matthew the hull;
    Kyle the bridge, propulsion system and winch), V2 (Kyle the hull,
    fiberglass and all the electronics) and V3 (more of a design lead, PCBs
    and machining). It adds that he learned design for manufacturing in
    combat robotics, designing titanium, AR500, aluminum and carbon-fiber
    parts for CNC machining and laser cutting. "Machining & DFM" replaces
    the "Systems integration" tag. The thanks section says Omar was the lab
    technician at Northeastern University London.
2026-10-13 Website: the team photo with Omar in the thank-you
    The Team page's "With thanks" section now shows Kyle and Matthew with Omar,
    holding V1, instead of the hull close-up. The photo keeps its 16:9 shape so
    nobody is cropped.
2026-10-14 feat(pcb): V3 carrier rev E: two Pico 2s, Pi link on the header
    Rev E replaces the Teensy 4.1 with two Raspberry Pi Pico 2s, one job each,
    after V3.1 tried one Pico: Pico A (U1) runs control (CAN on can2040, SBUS,
    winch, stepper, LED, leak sensing, 12S ADC) and Pico B (U14) the sensors
    (I2C mux, GPS, pod RS-485), joined by a UART link. Both are socketed under
    the carrier, take VSYS from +5V through D10/D11 and have reset buttons
    SW1/SW2. R36/R62 drop to 4.7k for RP2350 erratum E9.
    The Pi talks to Pico A over its GPIO header instead of USB, so its USB
    ports stay free for cameras and the modem: Pi UART0 (GPIO14/15) runs to
    Pico A GP17/GP16 through 1k series resistors (R66/R67), so neither end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
2026-10-14 docs(claude): keep the file-table row as on main
    The rev E note on the carrier row sat next to the pod row that the pod
    rev B branch edits, so the two PRs conflicted. Rev E is described further
    down (system diagram, pin maps, baseline), so the row goes back to main's
    wording and both PRs now merge in either order.
2026-10-14 chore(pcb): V3.1 order-number marker for PCBWay
    The V3.1 starter carrier is being ordered from PCBWay, so the back-silk
    order-number marker under the Pico changes from JLCPCB's "JLCJLCJLCJLC" to
    PCBWay's "WayWayWay" (same spot, size and angle). Pick "Specify a location"
    for the product number at checkout and PCBWay prints it there. Silkscreen
    only: the back silkscreen gerber is the only one that changes.
    Boat_PCB_V3_1 (rev A): 98.1 x 67.1 mm, 75 footprints, unchanged.
    DRC 0 -> 0, unconnected 0 -> 0, schematic parity 0 -> 0, ERC 0 -> 0.
2026-10-14 Website: project Gmail as the main contact, PCBWay as our sponsor
    - DREAMSboatproject@gmail.com is the project's official address now: first
    in every page's footer and contact band (site.js PROJECT), a full-width
    card on the Contact page, and the address the Partners page's funding,
    mentorship and fabrication buttons write to. Kyle's personal Gmail is off
    the site.
    - PCBWay sponsors our circuit boards: a Sponsors section on the Partners
    page (linking pcbway.com and our PCBWay project page), the first entry in
    the home page's partners list, a README line and this week's update. The
    fabrication need no longer asks for PCBs. No terms are published.
    - Rules (CLAUDE.md, website/CLAU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
2026-10-14 chore(pcb): V3 carrier and pod order-number markers for PCBWay
    Like V3.1, the V3 carrier and the pod will be made by PCBWay, so their
    back-silk order-number markers change from JLCPCB's "JLCJLCJLCJLC" to
    PCBWay's "WayWayWay" (same spot, size and angle). Pick "Specify a
    location" for the product number at checkout. Silkscreen only: the back
    silkscreen gerber is the only one that changes on each board. CLAUDE.md
    gets a short note on ordering.
    Boat_PCB_V3 (rev E): 130.6 x 101.5 mm, 137 footprints, unchanged.
    Pod_PCB_V3 (rev B): 48 x 63 mm, 54 footprints, unchanged.
    Both: DRC 0 -> 0, unconnected 0 -> 0, schematic parity 0 -> 0, ERC 0 -> 0.
    Boat_PCB_V3_1 stays at 0 on all four.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
2026-10-14 chore(pcb): move the shared dreams_v3 library to Boat_PCB/lib
    The library lived inside the carrier project, so the V3.1 and pod
    boards reached into a sibling board through ../Boat_PCB_V3/lib. It
    now sits beside the three boards and each one points at it the same
    way, ${KIPRJMOD}/../lib.
    - git mv Boat_PCB/Boat_PCB_V3/lib -> Boat_PCB/lib (63 files, renames)
    - the 6 fp/sym lib tables now point at ${KIPRJMOD}/../lib
    - 3D model paths: ${KIPRJMOD}/lib/ -> ${KIPRJMOD}/../lib/ in the
    IC_BNO085, Teensy41 and XDCR_BH1750FVI-TR footprints, and in the one
    copy embedded in Boat_PCB_V3.kicad_pcb. These models used to resolve
    only from the carrier project; now they resolve from all three.
    - doc path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
2026-10-14 docs: restructure CLAUDE.md, move board layout notes to Boat_PCB/CLAUDE.md
    The root CLAUDE.md loads in every session but mixed levels: the KiCad
    layout detail (rev E coordinates, locked copper, per-pad edits) sat in
    Tooling, the two Pico pin maps were dot-separated prose, and the rules
    that apply to every commit came last. The website notes kept their own
    copies of the publishing and weekly-update rules.
    - CLAUDE.md: numbered sections with a contents line. Repo map, system
    overview with a terms table, open decisions, rules for every change
    (moved up: public repo, weekly updates, V2 values, commits), carrier
    firmware reference with Pico A / Pico B pin tables, V3.1 reference
    as one ta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
2026-10-14 docs(v3): keep Matthew's rev D mechanical design on main
    docs/v3/V3_MECHANICAL.md carries the decisions, numbers and open questions from
    feature/mechanical-rev-d (PR #4), so they're on main even if that branch never merges:
    - what Matthew decided from 09-26 to 10-02: the arch bridge, 220 mm hollow PLA hulls
    with the packs inside, fixed belt outdrives, Van Dorn samples on the winch, the
    Muddy River as the target, no winter testing this season;
    - rev D's numbers: 34.3 kg, 99 mm draft, SFs >= 3.2, ~94 W for both drives at 1.5 m/s;
    - the building, sampling and sensor notes, and the V2 software lessons;
    - a table of newer decisions that override rev D. The one-piece hull print conflicts
    wit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
2026-10-14 docs(v3): record the 985 mm one-piece hull and what it does to rev D
    Kyle's V3 hull is 985 mm long (to confirm), printed in one piece on the Giga, which
    fits its 1000 mm height on end. Rev D was drawn for 1300 mm.
    New 5.5 runs Matthew's model at 985 mm with the same gear aboard. At 220 mm beam:
    - draft 99 -> 116 mm, 91 -> 74 mm to the lid joint;
    - payload before the 60 mm limit +15 -> +5 kg, so the arm no longer fits;
    - both drives at 1.5 m/s 94 -> 138 W, endurance 4.2 -> 2.9 h.
    250 and 300 mm beams are shown for comparison. Trim, layout and SFs weren't re-run.
    1 and 7 now point to it.
2026-10-14 docs(v3): the drive motor and controller are picked
    Kyle picked them on 2026-10-14, two of each: a Flipsky Battle Hardened 5048 200KV
    1300 W sensored outrunner, on a Flipsky Mini FSESC4.20 50A (VESC 4.12 based).
    V3_MECHANICAL.md 1 records the pick and why it fits: 200 KV is the top of rev D's
    150-200 KV range for 12S, and the controller's 8-60 V covers the 12S and 10S packs
    and talks CAN. The open motor-KV question in 7 becomes the fitting work: raise the
    motor axis ~5 mm, confirm the shaft for the pulley bore, match the VESC settings.
    Adds the week's update bullet.
2026-10-14 docs(v3): V3.1 runs on one 10S Li-ion pack, not rev D's 12S
    Kyle, 2026-10-14: one 10S Li-ion pack (30-42 V) runs the drives, electronics and
    winch on V3.1, and a separate electronics pack may come later. The carrier's
    three-pack setup isn't the plan for now.
    V3_MECHANICAL.md 1 gets a Battery row: redo the mass budget and trim for one pack,
    and size it for the drives plus the electronics, since rev D's endurance assumed a
    drives-only 400 Wh pack. The motor row now gives the 10S numbers: ~7,200 rpm
    unloaded at 36 V, ~6,000 near empty, against ~3,900 rpm at the prop for 3 m/s.
    Rev D's 150-200 KV range for 12S is ~185-245 KV at 10S, so 200 KV sits inside it.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
2026-10-14 docs(v3): 10S 10 Ah packs, and what two of them mean for carrier rev E
    Kyle, 2026-10-14: V3.1 runs on one 10S 10 Ah Li-ion pack (~360 Wh), and full V3 on
    two, maybe with an electronics pack as a backup. The Battery row in
    V3_MECHANICAL.md 1 gives rough run times on the 985 mm hull: V3.1 ~5 h at 1.0 m/s
    and ~1.9 h at 1.5 m/s, full V3 about double.
    New 1.1: carrier rev E only takes 10S on its drive side. Its electronics and winch
    inputs are 15-21 V domains. Their SMBJ24A TVSs (D3, D4) would blow the fuse on a
    30-42 V pack, Q1 is rated -40 V, and the pod is built for 12-21 V. Lists the three
    ways out: keep a 15-21 V pack, add a converter, or revise the carrier.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
2026-10-14 docs(v3): the optional electronics pack is 3S or 4S Li-ion
    Kyle, 2026-10-14. V3_MECHANICAL.md 1.1 now weighs it as the way to feed carrier
    rev E's electronics input (J13), where it's required rather than a backup:
    - 4S (12-16.8 V) fits: it's inside the pod's 12-21 V range and runs the D36V50F5
    and the A4988 (8-35 V), a little under the rail's 15-21 V design range;
    - 3S (9-12.6 V) is under the pod's 12 V minimum the whole discharge and near the
    A4988's 8 V when empty, so check the pod at ~9 V first.
    The winch input (J14) still needs its own feed of 21 V or less.
2026-10-14 feat(pcb): V3 carrier rev F, 10S power
    Kyle, 2026-10-14: the full V3 runs from two 10S 10 Ah Li-ion packs in parallel, one
    bus (30-42 V) for the drives, J13 (electronics) and J14 (winch), with an optional 4S
    backup for the 5 V side. Rev E's electronics and winch inputs were 15-21 V domains.
    Rated for 42 V:
    - D3/D4 SMBJ24A -> SMBJ43A, Q1 IPP120P04P4L-03 -> SUP90P06-09L (-60 V);
    - C1/C2/C26 470 uF 35 V -> 100 uF 63 V, R60 10k -> 22k.
    New parts:
    - U15, a Pololu D36V6F15 on the underside: +15V for the A4988 (it tops out at 35 V)
    and, through F1 and the In2 run along the top edge, the pod tether;
    - D12/D13 (B360B), a diode-OR of the 10S rail and the 4S backup into the 5 V buck A2;
    - J18, the 4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
2026-10-14 Website: the board section shows carrier rev F
    The site still showed the rev D board with its Teensy 4.1. Now it matches rev F:
    - top view, iso and build-log images re-rendered from the rev F board;
    - the 3D viewer's model re-exported from KiCad, with colours linearised and Draco
    compression like the old one (817 KB, was 1.09 MB), and a poster captured from it;
    - callouts: two Pico 2s in place of the Teensy, the Pi header, pod feed and power
    texts updated, a new one for the backup battery input (11 in all);
    - text on the home, boat and build-log pages: two Pico 2s, one 10S bus with a backup
    for the computers, rev F, 141 parts.
2026-10-14 feat(website): the V3 boat in 3D on the Boat page
    A new Boat page section, 02 "Take the boat apart", shows the V3 boat from our SolidWorks
    model (Boat.V2.1.SLDPRT, saved 13 Oct) in 3D:
    - spin it, with 3/4, side, bow, top and below views;
    - pull it apart: hulls, deck plates, bridge and lettering;
    - layer views: a cut that slides bow to stern or port to starboard, with its place in mm and
    a Sweep button, to see inside the hulls and the bridge;
    - show or hide each part, and pick one for its size, why it's built that way and how it
    changed from V1 to V3.
    Matthew confirmed the content on 14 Oct: this model with its bridge shown, the hulls at
    940 mm as modelled, the V-bottom reason, and the b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
2026-10-14 feat(mechanical): rev E: 940 mm hulls, tub and lid each printed in one piece
    Matthew's call on 2026-10-05: print each hull part in one piece, standing on end on the Giga
    (1000 mm build height). The rail flange laps past both ends, so the shell is 940 mm and the
    boat 975 mm over the rails; the lid prints 975 mm tall and the tub 970.
    - hull_sizing.py: loa 0.94. No segments or bulkheads: printed-in ring frames stiffen the tub,
    and the lid ribs are printed flat and bonded in (new rib-bond check). The bridge slides
    185 mm aft for level trim (frames at x 335 / 595, hub at 425). What sits inside the hulls
    moved into Boat, so the mass budget and the drawings agree. foot_bolt_sf() and the max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
2026-10-14 docs: point CLAUDE.md and the V3 docs at mechanical/
    Once this branch merges, the design tools are on main, so the lines saying they're only on
    feature/mechanical-rev-d would be wrong. Pointer fixes only: the decisions and numbers in
    V3_MECHANICAL.md stay as Kyle wrote them.
    - CLAUDE.md: the V3_MECHANICAL row points to mechanical/, which gets its own row.
    - V3_MECHANICAL.md: the intro, the arch-frame DXF and section 8 say where the tools are and
    that they're at rev E; the commands for reading the branch without merging it go.
    - docs/v3/README.md: the same pointer.
2026-10-14 docs(v3): V3_MECHANICAL follows rev E's 940 mm hulls
    Kyle, 2026-10-14: the hulls are 940 mm, as in Matthew's rev E design model and the
    SolidWorks model on the website. The 985 mm figure is gone.
    - 1: the hull row records rev E (940 mm, 975 over the rails, tub and lid each one
    print, bridge 185 mm aft) and what it costs; run times use rev E's drive power.
    - 3: rev E at a glance from mechanical/reports, with rev D beside it: 31.2 kg,
    118 mm draft, 72 mm to the lid joint, +4 kg of payload, every SF >= 4.9, ~144 W
    for both drives at 1.5 m/s, so cruise near 1.3 m/s.
    - 4 and 5: rev E's frame, hub, garage and outdrive numbers, the ring frames and
    bonded lid ribs, and a pointer to docs/hul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
2026-10-15 feat(pcb): carrier rev F without the BMP390, condensed to 130.6 x 95.5 mm
    The BMP390 breakout (U6) came off with its tracks. Its one job, a surface baseline
    for the pod's pressure depth, went when depth moved to the fish-finder sonar. Mux
    CH2 and Pico B GP6 are free.
    With U6's area free, the bottom edge came up 6 mm. J1 (GPS) and J4 (SHT45 external)
    moved into U6's old spot, because the Pi's USB jacks hang over the bottom-right
    corner. The bottom connector row, its resistors and A1 moved up. J18, SW1/SW2 and
    MH3/MH4 moved, and the In2 +5V zone was re-shaped. Everything that touched a moved
    part was re-routed.
    Carrier (Boat_PCB_V3), before -> after:
    - footprints 141 -> 140
    - size 130.6 x 10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
2026-10-15 feat(website): PCBWay logo and the project's Instagram
    PCBWay's logo, supplied by Kyle and trimmed to 720 x 202, appears in three places:
    the Partners page sponsor card (in place of the text heading), the partner logo
    row (grey until hovered) and the README's Sponsors section.
    The new Instagram, @dreams.boat.project, is linked in the footer (site.js
    PROJECT.instagram), on a card on the contact page, in the README and in this
    week's update.
    stamp.py re-versioned site.js and styles.css in every page. boat-explorer.js's
    stamp caught up too.
2026-10-15 feat(website): thank PCBWay on the Partners page
    PCBWay's sponsor card now says what their support means to the project, how their
    team helped with our first application, and what they make. It sticks to what's
    true today: no boards have arrived yet, so it makes no claims about quality, and
    no sponsorship amount is published.
2026-10-16 feat(pcb): carrier 122.1 mm wide, every JST on an edge, A2 on top
    Kyle: the strip right of the Picos held only the reset buttons, J1 (GPS) and
    J4 (SHT45) sat mid-board, and the board had too much free space. Then: close
    the gap where the BMP390 used to be.
    - The Pi block (Pi, J12, both Picos, everything under the Pi, J3/F1/J2/MH2
    above it, SW1/SW2/MH3) moved 8.5 mm left with its own copper. Q1's heatsink
    keep-out is what stops it there.
    - J1 and J4 went into the strip right of Pico B, J18 (4S backup) to the top
    side at the left edge, and J11 along the top edge next to J16 with JP1 beside
    it. J6-J9 were respaced, R7/R8 moved under the Pi, and the IMU and
    light-sensor pull-ups went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
2026-10-16 feat(website): carrier renders and callouts for the 122.1 mm board
    - New top image (now 1800x1408), iso and build-log renders, the 3D model
    (with the module stand-ins) and its poster.
    - Callouts follow the new spots: GPS on the right edge, the backup input on
    the left edge. The power-in text no longer puts the 5 V regulator underneath.
    - Board size updated in the facts, the build log and the boat page's board
    card, which still said rev D, 130.6 x 101.5 mm.
    - UPDATES: the carrier bullet now ends at 122.1 x 95.5 mm, with every cable
    connector on an edge.
2026-10-19 feat(website): Northeastern on the home page; credit the whole team in updates
    - Home hero: "Founded by students at Northeastern University" as plain
    text (no link or logo; Northeastern hasn't funded or endorsed us).
    - UPDATES.md: team news starts with **Team:**, shared work names
    everyone (sizing the drive, sponsor outreach), Kyle got the PCBWay
    sponsorship and Logan made the Instagram; the rule is in the how-to
    comment and CLAUDE.md 4.2. Adds the week ending Oct 23.
2026-10-20 docs(updates): Kyle's first V3 hull CFD results
2026-10-20 docs(mechanical): Kyle's first hull CFD results (5.6)
    Flow Simulation at 1, 2.5 and 3.5 kn: 12-14 N at 2.5 kn and 36 N at
    3.5 kn with 2.5 deg trim, within ~20% of propulsion_report.md; 7.5 deg
    trim doubles the drag at 2.5 kn; the boat squats as it speeds up.
    Lists the follow-up runs.
2026-10-23 docs(updates): prop CFD in the week ending Oct 23, site tidy-up out
    Kyle: drop the website items (Northeastern line, Logan's major, the V1
    wording) from this week's update and add the prop CFD. The paragraph and a
    new bullet cover the three toroidal props (85, 90 and 140 mm): the 90 and
    140 mm props about equally efficient, over a third of the thrust lost spun
    the wrong way, and 35-50% lost to cavitation on the 90 mm prop. A cropped
    Flow Simulation screenshot of a prop's jet is the week's second photo.
2026-10-23 feat(website): latest-update card and PCBWay logo on the home page
    The home page now shows the newest week that's out as a card (its
    paragraph and first photo) that opens that week. It follows the same
    Friday 5 pm Boston release as the Updates page and stays hidden without
    JavaScript. The home page's Partners row shows PCBWay's logo instead of
    its name.
    Quick fixes from an accessibility pass:
    - a darker green, so small green text passes WCAG AA contrast (it
    failed on the build log)
    - the Boat page's parts list is a labelled group, not an aside nested
    in another landmark
    - the partner logos carry their real size, so the page doesn't jump
    as they load
    - sitemap.xml lists the pages
    Co-A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
2026-10-26 docs(updates): prop CFD in the week ending Oct 30
    The week's paragraph and Kyle's bullet: nearly 50 prop CFD runs, mostly
    tuning the 130 mm three-loop toroidal prop one change at a time, which
    took its shaft power at 2.5 knots from about 47 W to about 26 W per prop,
    and thicker roots so it can be printed in tough resin. No photo yet.
2026-10-28 docs(mechanical): hull spacing settled at 500 mm, as in the CAD
    The SolidWorks model has the 940 mm hulls 500 mm apart on centre (733 mm
    overall); rev E's design model and loads used 700 mm. Kyle picked the
    CAD's 500 mm. The model still needs re-running at 500, so section 3's
    numbers stay rev E's 700 mm until then. Also in this week's update.
2026-10-29 docs(mechanical): drive geared 2:1 on a 15 mm belt, 150 KV motor
    Kyle's pick for the F27 prop: a 15 mm HTD 3M belt from a 15T motor
    pulley to a 30T prop pulley, and a custom 150 KV winding of the 5048
    (not ordered yet). It cuts the belt pull at 3.4 kn from ~85 N to ~60 N
    and leaves 1.66x prop-speed headroom on an empty pack. Records what it
    changes (pod, leg, belt length, VESC limits) and adds it to the
    Oct 30 weekly update.
2026-10-30 feat(website): Dr. Eams, the team's unofficial mascot, on the Team page
    Dr. Eams gets a card after Logan's, filling the crew grid's empty spot,
    and a link in the page's section menu. The drawing came as a Procreate
    screenshot on its dark canvas, so it's cut out onto a clear 4:5 card
    (images/team/dr-eams.png, git-ignored like the other sources) and sits
    on the card's light-blue frame like the other new members'.
    build_images.py writes one 400 x 500 size with transparency (PNG and
    WebP, 70 KB together) and no metadata. The week ending Oct 30 gets a Team
    bullet for him and Caleb's photo.
    Claude-Session: https://claude.ai/code/session_01Mm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
2026-11-02 docs(updates): propulsion design, hull work, the data plan and MSI talks in the week ending Oct 30
    The week's email to our CRWA contact covered more than the website did,
    so the site gets the same news: Caleb, Kyle and Nolan started designing
    the propulsion system, the hulls are still being strengthened, the
    plan for our first water-quality data is set (temperature, depth and GPS
    location, from sensors factory-tested on NIST-traceable equipment, lab
    testing until the boat is ready), and talks with the Marine Science
    Institute continue. The week's paragraph gets one sentence so the
    Updates page tells the same story.
    CRWA's wording for the partnership stays off the site until they confirm
    we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
2026-11-02 docs(updates): credit the hull work to the team
    Bullets now credit the team unless we say only certain people did the
    work, so the hull-strengthening bullet reads Team, not one name.
    Claude-Session: https://claude.ai/code/session_01MmpaibT2mUXrL1Wf9oaEZE
2026-11-02 docs(updates): write the weekly updates for the team and for outside readers
    The Updates page is read by sponsors, partners and other people who
    don't have our emails for context, so every week is now written for
    them: no name in front of each bullet, plain words, short sentences, and
    technical terms explained the first time (CFD, toroidal, cavitation,
    NIST-traceable). The long circuit-board bullet is split, a few internal
    details (the KiCad library, the GPIO link) are left to the repo docs,
    and two team-page bullets are folded into one. Every number and fact
    stays the same. Names appear in the sentence only where it matters who
    did it: Caleb, Kyle and Nolan on the propulsion design, Nolan's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
2026-11-04 fix(pcb): Pi 5 mounting holes 2.7 mm, the Pi's own size (M2.5)
    The four non-plated holes in RaspberryPi_5_GPIO_Socket_2x20 were 3.2 mm (M3
    clearance); the Pi 5's are 2.7 mm. The library footprint and both boards'
    copies change together, so neither board shows a library mismatch:
    carrier J12 and V3.1 J2, drill and pad 3.2 -> 2.7 mm (mask opening with it).
    Same positions, 49 x 58 mm apart. Nothing else moves, and the 6 mm
    copper-free circles around the V3.1 holes are unchanged, so no copper gets
    closer to a hole.
    Carrier rev F: 140 footprints, 122.1 x 95.5 mm, unchanged.
    V3.1 rev A: 75 footprints, 98 x 67 mm, unchanged.
    ERC / DRC / unconnected / parity were 0 / 0 / 0 / 0 on both boards. Not
    r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
2026-11-05 fix(pcb): V3 carrier GPS plug on +5V, and fresh pours on both carriers
    The SEQURE M10-25Q GPS is sold as a 5 V module, but the carrier fed J1
    pin 4 from +3V3 (V3.1's J6 already gives it 5 V). J1 pin 4 is now +5V
    in the schematic and on the board: it left the In2 +3V3 plane and has a
    0.5 mm F.Cu run (46 mm, no vias) to U3 pin 3. The GPS UART and I2C stay
    3.3 V logic.
    The pours on both carriers were refilled: today's 2.7 mm Pi holes had
    left them about 0.1-0.3 % behind the board. Only fill polygons changed.
    Carrier (Boat_PCB_V3), before -> after: ERC 0 -> 0, DRC 0 -> 0,
    unconnected 0 -> 0, parity 0 -> 0. V3.1: DRC 0 -> 0, unconnected 0 -> 0,
    parity 0 -> 0. Notes in Boat_PCB/CLAUDE.md and CLA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
